KiCad/kicad-footprints/(list of files, cad)

Other CAD files:
Sources/Inductor_SMD/L_Wuerth_WE-TPC-3816.FCStd
Sources/Package_LGA/Infineon_PG-LLGA-5-1.FCStd
Sources/Package_SON/X2SON-4_1x1mm_P0.65mm.fcstd
Sources/Package_TO_SOT_THT/sod-70.fcstd
Sources/Inductor_SMD/L_Coilcraft_LPS5030.FCStd
Sources/Package_TO_SOT_THT/sod-70_P5.08mm.fcstd
