KiCad/kicad-footprints/(threads)

Thread 14 (2017-11-08):

Who is working on what?

poeschlr, 2017-11-08:
I think we should definitely coordinate our effort to avoid doing work twice.

The next thing i will do is look over the JST scripts to move these connectors over here. (Yes i know i did not create most of them but i want to do one complete repo at a time.)
Before that i will transfer the unchanged contents of the Resistors_THT, Capacitors_THT and Diodes_THT repos.

@SchrodingersGat, @jkriege2, @Shackmeister, @evanshultz

SchrodingersGat, 2017-11-08:
I would like to transfer across the `Housings_xxx` repos. However, did we ever decide on a better name for these?

poeschlr, 2017-11-08:
If i remember correctly this came up on the forum. (But i think only as a side node [here](https://forum.kicad.info/t/non-devs-what-do-you-think-of-the-app-names/5147/40?u=rene_poschl))

So i think we never discussed the naming for these libs. (Time to sacrifice a chicken again.)

What about `IC-Package_xxx`

Shackmeister, 2017-11-08:
Ill be working on updating the 3D scripts (mainly naming)
@poeschlr could it make sense to add the height, pin band and pinthickness as parameters in your 2 lead script? this way the yaml could loaded directly in CQ (with some mods to the script) = easier to maintain

poeschlr, 2017-11-08:
Yes this idea came to my mind as well. (But too late.)
If nobody else does it i would do it once all footprints have been transferred. (I would then also rework my connector generators. I would not be mad if someone else does it before i find time for it.)

evanshultz, 2017-11-08:
The discussion on the terms "housing" versus "package" was, I believe, in the old IR-DirectFET repo. But that has been replaced and the porting changed the terms so that's fine.

poeschlr, 2017-11-09:
I decided i will create a generic jst footprint generator. (after the third script where i copied basically the same stuff from my master script.)
So this script will then also have yaml files that define the part dimensions. (I might make it easy for me and make separate scripts for tht and smd versions.)

terjeio, 2017-11-09:
I am currently working on the pin sockets scripts for the legacy footprints, are the ones here script generated with an updated or a new script? If so should I stop my work on and concentrate on the 3D models?

FYI: the legacy script outputs a lot of overlapping and duplicate lines, my updated script reduces the total size by around 25% and, I believe, is more KLC3 compliant.  Also, I have added single row SMD sockects to footprints and 3D models.

Shackmeister, 2017-11-09:
The pinsockets here has only been renamed, you should adapt the Naming to your script, otherwise please continue on with you awesome work :)

evanshultz, 2017-11-09:
So... is this thread simply where we announce what we want to do next? Is there more organization to it? Do we have a list of repos that need moved so we can track progress to completion?

SchrodingersGat, 2017-11-09:
https://github.com/KiCad/kicad-footprints/blob/master/TODO.md

poeschlr, 2017-11-10:
I rewrote the generation script for jst smd connectors. (One script generating all of these connectors.)
This script is also capable of generating other similar components. (Example molex picoblade)
So i think all connector footprints with one row of smd pads plus two mounting pads will be produced by this one script. (As long as the body shape is not too complex.)

Some of the connectors had "inner" details on fab (JST GH). My script is not yet capable of including this. Do you guys think it would be worth my time to add that feature are these inner details not a good idea in general?

SchrodingersGat, 2017-11-10:
Depends on the level of detail you're interested in. I wouldn't go overboard but it may be useful for example to show pin orientation. As long as it shows outline and orientation, those are definitely required.

poeschlr, 2017-11-10:
So show a small square representing each pin for top entry types? (Most side entry types have the pins hidden when viewed from the top.)

SchrodingersGat, 2017-11-10:
That sounds reasonable, would you agree?

jkriege2, 2017-11-10:
Just as a note: I will rework the terminal blocks withing the next few weeks
JAN

evanshultz, 2017-11-10:
I'll take crystals, oscillators, and potentiometers. I want to address https://github.com/KiCad/Crystals.pretty/issues/23 and https://github.com/KiCad/Potentiometers.pretty/issues/18 and https://github.com/KiCad/Potentiometers.pretty/pull/23 and https://github.com/KiCad/Potentiometers.pretty/issues/20.

@SchrodingersGat I recall a PR by you for potentiometers where I had a number of comments and didn't merge. I think they were horizontal Alpha parts, but I can't find an open or closed PR. Do you recall or can you find it?

@jkriege2 Are you going to make shrouded pin headers, both with and without latches? The kinds seen in all 3 pics at http://www.oupiin.com/product_iii.html?c1=10&c2=54? These are extremely common interconnects, and seemingly generic, but I don't see them in our library.

terjeio, 2017-11-10:
@evanshultz 3D-models for some shrouded pin headers are [here](https://github.com/KiCad/kicad-packages3D/tree/master/Connectors_IDC.3dshapes), footprints were [here](https://github.com/KiCad/kicad-packages3D/tree/master/Connectors_IDC.3dshapes) but are deleted?

Since I am working on an update for the pin socket headers footprints and 3D models, which are similar, I can easily add them.

jkriege2, 2017-11-10:
@evanshultz @terjeio Go ahead ... I didn't intend to do the shrouded headers ... although I could if required (but will takes some time!). I'm now starting to redo all those old screw terminals!

Best,
JAN

poeschlr, 2017-11-19:
Above i mentioned that i would look into diodes, resistor and capacitor tht. I fear the connector stuff takes a lot longer than i expected. So if somebody else is motivated in transferring these 3 libs i will not be mad at them.

poeschlr, 2017-11-27:
My next lib will be the old connectors_hirose

antoniovazquezblanco, 2017-11-27:
Hello guys, `Converters_DCDC_ACDC.pretty` has not yet been moved. I wonder if you have talked about splitting it or leaving it as is. Also there is a PR that improves considerably the state of the lib (https://github.com/KiCad/Converters_DCDC_ACDC.pretty/pull/27).

As I need a footprint from that repo I was thinking in contributing to the switch by opening a PR.

SchrodingersGat, 2017-11-27:
@antoniovazquezblanco I have now merged that PR. If you want to contribute by pulling those across to this repo, that would be greatly appreciated! :) Thanks!

antoniovazquezblanco, 2017-11-28:
Perfect! About naming:
1. Should I split them in ACDC and DCDC or keep them in the same repo?
2. Connector->Conn, then should I rename Converter to Conv?

poeschlr, 2017-11-28:
If there are converters that can work with both AC and DC on the input side then we should keep all converters in one lib. Otherwise it is ok to split them in my mind.
I don't think shortening the name is a good idea here. (I am not even sure any more why we shortened the name for the Conn libs.)

SchrodingersGat, 2017-11-28:
@poeschlr it is the only shortening we do, I'm not sure either. Should we fix all to `Connector_` now, before v5 gets locked in?

antoniovazquezblanco, 2017-11-28:
Converters it is then. Also I will not split the repo yet as it is not that big and also I don't really know if some of the components accepts both AC and DC as input.

SchrodingersGat, 2017-11-28:
\* `Converter_`, singular :)

poeschlr, 2017-11-29:
Next i will transfere the old Samtec and TE-Connectivity repos.

poeschlr, 2017-12-01:
Does anybody know what the stuff in Connectors_Mini-Universal is?

poeschlr, 2017-12-05:
@evanshultz i remember you wrote something about wanting to rework the crystal libs. Does this also include the oscillator lib or is that lib free to be transferred by someone else?

evanshultz, 2017-12-05:
Go ahead. I wanted to fix the issue at https://github.com/KiCad/kicad-footprints/issues/14#issuecomment-343525789, but crystals are already moved. Any change to the fab layers is pretty easy to update later anyway. (The pots had changes to their names which makes it a pain to import and the update later.)

poeschlr, 2017-12-05:
I created an issue to remind us about that particular remaining problem.
https://github.com/KiCad/kicad-footprints/issues/155

poeschlr, 2017-12-06:
I will take care of the Mini-Universal footprints. (They are TE-Connectivity MATE-N-LOK)

SchrodingersGat, 2017-12-06:
Great work! We're almost done :)

Shackmeister, 2017-12-06:
Has most footprint(families) been renamed to match 3.0?

SchrodingersGat, 2017-12-06:
Yes, most. There may still be some that don't match convention requirements but the majority have been renamed.

poeschlr, 2017-12-07:
Next thing i will look at are the remaining footprints in Connectors.pretty
I already transferred the Tag-Connect stuff and am now looking at HE10 (seems to be a locked IDC header, so i will add it to Connector_IDC)

poeschlr, 2017-12-08:
I fear a lot of the footprints in connectors lib are not worth transferring over to the new repo. The only two that might be worth to transfer are the Samtec QMS and TE Future bus. But both would need major rework and checking against the datasheet.
Other then this only the Connector_IEC_DIN and Potentiometer libs remain to be transferred.

evanshultz, 2017-12-08:
Regarding potentiometers, I haven't finished the argparse interface (which seems of dubious value to me anyway...) but all the pot footprints are being generated so I will upload them.

But first, a few questions:
1. Do we want to divide them up in any way? Perhaps into THT (there are ~100) and SMD (~20).
1. I vote for removing the bottom-side ones and providing hole and non-hole versions (the user can flip to the bottom side if they wish). See https://github.com/KiCad/Potentiometers.pretty/issues/18. Objections?

SchrodingersGat, 2017-12-08:
1. Yes, this makes sense to split them at this stage
1. We should not provide duplicates of footprints which are simply "flipped" to the back layer, if that is what you are asking

evanshultz, 2017-12-09:
1. Great.
2. Yes, that is what I was thinking too.

I'll have to make a few script changes to make the second item happen. Probably Mon I can upload.

evanshultz, 2018-01-29:
@poeschlr
Is there anything to coordinate amongst multiple people? Can this be closed now?

poeschlr, 2018-01-29:
I think the din connectors are still not transferred.

Ratfink, 2018-04-01:
I believe the DIN connectors have now been transferred: https://github.com/KiCad/kicad-footprints/pull/409.

Is there anything left to discuss here, or should this issue be closed?

evanshultz, 2018-04-02:
Close it as far as I'm concerned. I took a close look at the TODO docs in both the symbol and footprint repos. Everything we need should be there now.

Closed 2018-04-02.

Thread 46 (2017-11-16):

Testing and travis ideas

antoniovazquezblanco, 2017-11-16:
I had a look to the kicad library utils repo the last weekend. I have some ideas that I am willing to contribute to but I don't know what you think about them.

1. Testing now requires cloning more than one repo (travis clones both this repo and the utils one). I think this could be avoided by moving the testing code to this repo. The reused code between the different testing benches for PCB, SCH and SCHLIB is minimal, thus being a good option. This would reduce check time. Keeping the test code in the same repo would also make easier point number 2.

2. Using relative paths in scripts would ensure that scripts can be run both localy and in travis environment. Currently some scripts can only be used by travis. My proposal is to include a batch and a shell script that the user can click or execute in a terminal that will test the last modified components (I was thinking on testing the whole lib if in the master branch and the modified components if in another branch or something like that).

3. Testing now requires sudo and there seems to be no obvious reason for that. Sudo makes travis testing significantly slower. Dropping sudo needs would improve check times a lot.

4. I was thinking in including a coverage report. A simple script that would tell in which percentage the whole lib complies with KLC and/or another script that would test how many 3D models are present and how many missing footprints looking at the symbol lib.

Please let me know what you think about the previous ideas and if you would like to see them implemented.

Thank you!

SchrodingersGat, 2017-11-16:
1. I don't want to separate out the scripts that are in kicad-library-utils
   a. There is common code that would have to be duplicated
   a. It's a good central place to store the scripts
   a. I think it would clutter the repo which should be reserved for only library files (as far as possible)

2. If you can come up with a scheme that allows this, that's fine, but I don't want to break our current Travis functionality.

3. I didn't know that. That can be dropped from the .travis.yml file I think

4. This is a good idea, I have toyed with this idea before. It would be great to add this output to the https://kicad.github.io website, too! Green indicator for 100% pass, for e.g.

Shackmeister, 2017-11-16:
+1000 for 4.

antoniovazquezblanco, 2017-11-20:
Discarding 1 and 2. Opening issues where it belongs for 3 and 4.

Closed 2017-11-20.

Thread 72 (2017-11-21):

Polarized THT capacitors do not have a pin 1 mark that is visible after assembly

poeschlr, 2017-11-21:
See discussion in https://github.com/KiCad/kicad-footprints/pull/71
This should be fixed within the generator scripts

Scripts are found in: https://github.com/pointhi/kicad-footprint-generator

Shackmeister, 2018-01-08:
fixed in #230

Closed 2018-01-08.

Thread 73 (2017-11-21):

THT capacitors require rework

SchrodingersGat, 2017-11-21:
See notes here - https://github.com/KiCad/kicad-footprints/pull/71

The scripts need to be reworked to place the polarity indicator on the Silkscreen layer outside the footprint, so that it is visible after component is placed.

SchrodingersGat, 2017-11-21:
Closing this, @poeschlr made the same issue :)

Closed 2017-11-21.

Thread 74 (2017-11-21):

Some of the second references (on fab layer) for resistor THT footprints interfere with other graphical elements on fab

poeschlr, 2017-11-21:
Some oft he references need to either be scaled down or moved a bit.
Preferably done with the original generator scripts.
But can also be done by hand. (Only a few components are affected.)

Script can be found here: https://github.com/pointhi/kicad-footprint-generator

grob6000, 2017-12-04:
Looking at this now. Unfortunately http://kicad-pcb.org/libraries/klc/F5.2/ hasn't really considered the axial vertical THT resistor... Plan will be to change the line representing the bent pin to only reach the circumference of the body, and move the R% into the centre of the body. See what it looks like.

grob6000, 2017-12-04:
Having a bit of trouble - keeping this on pause for the moment.
Does anyone (maybe @pointhi, @poeschlr ?) know what the best practice is for the "Fields" in the footprint properties; i.e. "Doc" and "Keywords"? Seeing some differences between what's currently in the footprints and the output of the script and looks like I'm mucking it all up. :)

Closed 2017-12-04.

Thread 76 (2017-11-21):

Inductor THT: Missing 3d model references, second reference (fab) interferes with fab and some silk lines on top of pads.

poeschlr, 2017-11-21:
This is ideally fixed within the generator scripts directly. (Fixing the inductor references would also fix some of the resistor references because they share the same generator scripts.)
So https://github.com/KiCad/kicad-footprints/issues/74 is related in part to this issue.

Script location: https://github.com/pointhi/kicad-footprint-generator

poeschlr, 2017-12-04:
@Shackmeister did you close the wrong issue? The linked pull request does not touch inductor footprints but resistors.

Shackmeister, 2017-12-04:
Yes I closed the wrong issue, sorry

poeschlr, 2018-08-29:
Fix merged

Closed 2018-08-29.

Thread 78 (2017-11-21):

Diodes THT: Polarity marker on silk not ideal for most footprints and second (fab) reference interferes with other fab graphics

poeschlr, 2017-11-21:
This should be fixed with the generator scripts.

poeschlr, 2017-11-21:
Script location:
https://github.com/pointhi/kicad-footprint-generator

jkriege2, 2017-11-21:
Currently the silkscreen looks like this:
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

How do you want to change them?

Best,
JAN

poeschlr, 2017-11-21:
Examples where it does not look that nice:

Your last screenshot is a perfect example. If the view is obstructed by other devices next to the diode then it becomes very hard to see the intended direction of the diode. (The assumption is that the polarity mark is used to easily check the correct insertion of the diode when everything is assembled.)
Just imagine a high connector very near to one side and a large capacitor on the other. (Over voltage protection circuit for a DC input)

Other examples (of slightly different problems)
D_5W_P5.08mm_Vertical_KathodeUp (Interference between diode symbol and part outline)
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
Even worse if D_DO-201_P5.08mm_Vertical_AnodeUp is placed low down it might be very hard to see the polarity. (or if high components are next to the diode and it is impossible to look from the side.)
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

As for the how:
Depends on the exact footprint in question. In your last screenshot maybe elongate The top line to extend beyond the pad? Or you could add a dot, ...
Anything that is visible from directly above.
For others moving the diode symbol might be a good idea. (Where it interferes with other silkline features or is obstructed by the component it self.)

---

On an unrelated note: Do the pads really need that much annular ring? Especially for footprints with small pitch: (might it be a good idea to set a minimum pad to pad clearance within the scripts similar to what i currently do with the connector footprint rework? Would mean if the pitch gets small the pads are not circles but oval.)
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

jkriege2, 2017-11-22:
Hi @poeschlr ,
yes I agree that the silkscreen is not that good (I made it that way, when writing the scripts about a year back, as I didn't find any better way ... I think we should assemble some attempts and then select the best one. One idea would be to douplicate the K (for cathode), that we have on F.Fab to make the orientation of vertical diodes clear, on the silkscreen... I think the dot would more easily get lost... Maybe also the offset diode symbol as shown in DO-15_P2.54mm ... any other ideas?

About the angualr rings: YES ... can do ... that's the problem of scripting ... such things just slip through ;-)

Best,
JAN

jkriege2, 2017-11-22:
PS: We should also rethink the  aming scheme (if required) and/or maybe add the specific attributes (`_AnopeUp', ...) to the KLC-listing in http://kicad-pcb.org/libraries/klc/F2.1/

Best,
JAN

jkriege2, 2017-11-22:
PPS: I'm happy to do the scripting, when we decide on a variant ;-)

jkriege2, 2017-11-24:
PR with a fix: https://github.com/KiCad/kicad-footprints/pull/106

poeschlr, 2017-11-26:
I consider this fixed by the merged pull request.

Closed 2017-11-26.

Thread 91 (2017-11-23):

Incorrect scaling for THT diode models

SchrodingersGat, 2017-11-23:
Many of the THT diodes have a non-unity scaling for 3D models.

x:y:z must be 1:1:1

SchrodingersGat, 2017-11-23:
This is actually quite wide spread:

* Footprints with incorrect scale - 701
* Footprints with incorrect offset - 339
* Footprints with incorrect rotate - 341

I can change these simply but it will break a lot of 3D models!

jkriege2, 2017-11-23:
Do so ... but we were discussing whether these should be reworked as a hole to improve on the polarity marking on SilkS (see https://github.com/KiCad/kicad-footprints/issues/78 ... maybe you can give your five cents there, so we can move forward) ... When we do that I will also change the scaling (and reexport my 3D models accordingly)

JAN

poeschlr, 2017-11-23:
Wrongly scaled 3d models will not be included in the v5 repo. (Yes i know this will mean we do not have 3d models for some parts when v5 comes out.)

Changing the scaling here would only affect the v5 footprints so i think we can fix the scaling here.

jkriege2, 2017-11-23:
Yes, but it would be good to know WHICH fooprints are affected, otherwise we will never know which models to fix!

So I would vote for doing this in batches: I.e. someone takes a repo, fixes tha scaling and at the same time fixes the 3D models, or removes them!

SchrodingersGat, 2017-11-23:
@jkriege2 yes I think this is a good idea. I'll close my "fix" for this :)

poeschlr, 2017-11-23:
@jkriege2 the models that need fixing are simply the models present in the old kicad-library repo that do not have a counterpart in kicad-packages3d. (Sadly for a lot of them there is no easy fix because they have been designed with wings3d.)

SchrodingersGat, 2017-11-23:
@poeschlr in that case, I will re-open my PR to fix this. It is better to fix the files now and add the models as we go, I think. If there are no existing incorrect models, I think that is fine.

Closed 2017-11-24.

Thread 94 (2017-11-23):

Auto-update of fp-lib-table by KiCad?

evanshultz, 2017-11-23:
@SchrodingersGat
Will KiCad v5 auto-update fp-lib-table? If so, then footprint repo changes can be pushed out to users. Otherwise, they'll be unable to add or remove libraries.

The schematic has the same issue.

Discussed somewhere here and at https://bugs.launchpad.net/kicad/+bug/1705291. Here is the root of the question: If we have two files that capture all current libraries, whether they're manually- or automatically-generated, why shouldn't the GitHub plug-in also update those files so the users always has the latest and greatest. For users who don't want to use the GH libraries, that's fine, but those that do can be kept updated between KiCad releases.

I realize this isn't a core library issue. But if there are reasons this can't be done by the library team, or isn't ready to be done, then of course there's no reason to have KiCad do it. But if all the infrastructure in the library is ready, and it's a good idea, then it needs to be raised to the KiCad dev team.

poeschlr, 2017-11-23:
The github plugin will most likely not work in v5. (can't handle one repo for all footprint libs)

The intended way to get new stuff to users is via the new library download webside or they need to clone the 3 repos.

But here also some manual updating might be needed by the user to get the fp-lib-table updated.

SchrodingersGat, 2017-11-23:
@poeschlr I have reminded them many times and will continue to do so as we approach v5 release! We need to quickly finish the footprints (and symbols) transition :)

stambaughw, 2017-11-24:
I would be opposed to this idea.  We should not be overwriting users
library tables.  I for one would not be very happy is the next time I
ran kicad, my library tables were changed.  I'm fine with providing a
tool to check if there are updates available for the default library tables.

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

evanshultz, 2017-11-24:
Clarification needed: I'm only thinking about users that use the GH libraries. It was written into a paragraph above but could have been missed. A user may self-manage their libraries and that's fine. But if a user chooses to use the GH libraries it only makes sense to me that their lib tables and the libraries themselves are updated without excessive (or any?) effort.

So maybe this won't work with the current library structure for v5. I would think that requiring users to manually get and update the libraries is undesirable for every single user. A tool that could check for new libraries and then update both tables and library files would satisfy my request.

@stambaughw
I meant "automatic" in the sense that the user didn't have to manually do everything. I didn't mean "automatic" in the sense that the user had absolutely no control.

myfreescalewebpage, 2019-03-15:
@evanshultz this is an old issue, is it still valid ? Thanks, Joel

evanshultz, 2019-03-15:
Heck yeah, but I guess it's KiCad dev thing and I didn't seem to be able to communicate well with Wayne on launchpad.

If there is a way to use the official library on-demand, like it was on v4, then it would have been nice to make the library tables also update from GH. But that didn't happen. As it is now, KiCad could be more convenient about a situation where the table and files at the path don't match, but that's also something to report to the devs.

Closing now.

Closed 2019-03-15.

Thread 113 (2017-11-26):

LEDs and color

jkriege2, 2017-11-26:
Hi @evanshultz @poeschlr @SchrodingersGat ...

When I recently moved the LED footprints and 3D mdoels to the new repos, I stumbled upon a small problem: All the THT LED 3D models just have any color (most 2-pins red or green, 3/4/...-pin-version are white). That's mostly fine, but there are 3 problems with that:

1. If you want your 3D model to have the correct color, you have to make new 3D models and matching footpritns ... should we provide a list of such? And if so, how do we denote color in the names (e.g. as modifier `_Red`, `_Green`, ...)?
2. We should have clear/white and maybe grey/black variants at least of the 3mm and 5mm, as they are often used for Phototransistors/-diodes and IR-LEDs ... what do you think? Whould I add them and how should I denote the color in the name (see item 1).

Best,
JAN

SchrodingersGat, 2017-11-26:
You should use the color name as a modifier as you suggest. But which colours?

* Red
* Green
* Blue
* Yellow
* White / Clear
* Black / IR
* ... ?

Also, which is the "default" color (without any modifier suffix)? I would suggest perhaps clear?

poeschlr, 2017-11-26:
For reference, @Shackmeister had an issue in the old repo about LED colors for 3d models:
https://github.com/KiCad/LEDs.pretty/issues/44

SchrodingersGat, 2017-11-26:
Yep I remember @Shackmeister  raising the issue. I'm ok with different colors but not with modelling individual anode and cathodes inside the diode ;)

Shackmeister, 2017-12-04:
@SchrodingersGat SMD led script has now been cleaned for internal parts :P

Thread 117 (2017-11-27):

Nets on wing pads of connectors

Shackmeister, 2017-11-27:
Not sure if this belong here or on the forum, let me know if its inappropriate here.

How are people handling connecting the wing pads on connectors to different nets (typically GND)?
usually I just edit the pads and add the net I want, but this is lost when updating the netlist, which usually makes me forget to change some of the 20ish pads. Unless somebody has a good way, we should maybe consider making a standard padnumber for these. This way the user could use a symbol with or without the wings depending on the nescessity.
Thoughts?

poeschlr, 2017-11-27:
I am currently not understanding what you mean with wing pads. Do you mean the mounting pads like the two larger pads of the picoblade connectors?
These do not need to be connected to a net because they are just for mounting purposes.

Connectors that have shielding connected to such pins need a pad number of course.

Shackmeister, 2017-11-27:
Yes the larger pads, I typically connect them to GND to have a stronger mount. Sometimes I connect them to other nets to void splitting planes, easier routing etc.

poeschlr, 2017-11-27:
Adding these pin(s) would at least double the amount of generic symbols needed. (And it will add a further complication to users. They now need to answer the question: does my connector come with mounting pads? Even if they don't plan on connecting them.)

poeschlr, 2017-11-28:
@SchrodingersGat @jkriege2 @evanshultz care to comment?

evanshultz, 2017-11-28:
**Oops! I forgot to submit this comment earlier! Sorry.**

In the existing (old) KiCad libs I recall seeing they were universally pin 0 (zero).

There are several situations where a net connection to the mounting tabs is important:
- Mounting strength (mentioned above)
- Shielding (mentioned above, though this may require a specific symbol anyway)
- Chassis ground connection to circuits
- HV / ESD protection
- Connection to touchable surfaces for safety during plug/unplug events

Adding symbols with a pin 0 for mounting pads is good, but I agree that the overhead in the quantity of symbols and footprints that would be added is substantial.

Another option might be to have only one set of symbols, all with pin 0, and the pad pin can be left floating if desired. A corresponding footprint would need a numbered pad 0 which would be floating or connected depending on the symbol's connection. So we eliminate any duplication of symbols or footprints and it's up to the user to make the connection or not.

jkriege2, 2017-11-28:
At least for D-Sub connectors there are symbols with a specific PAD-pin (optional, i.e. variant). the same is done for crystals!

jkriege2, 2017-11-28:
I think at least for those symbols where the mounting/shield-pad is very common, there should be a symbol with it (e.g. RJ-xx, USB, D-SUB, ...)

poeschlr, 2017-11-28:
@evanshultz wrote:
> In the existing (old) KiCad libs I recall seeing they were universally pin 0 (zero).

neither the old Molex, JST, Hirose or TE lib have it like you describe here. (All of them have footprints with either smd or pth mounting pads. None of them have the number 0. Only Molex FFC had a number assigned but it used max pin number +1)

>Another option might be to have only one set of symbols, all with pin 0, and the pad pin can be left floating if desired. A corresponding footprint would need a numbered pad 0 which would be floating or connected depending on the symbol's connection. So we eliminate any duplication of symbols or footprints and it's up to the user to make the connection or not.

Not quite. There are a lot of connectors that do not have mounting pins. If the symbols all have the mounting pin in there, the wrong footprints will be suggested by the "by pin count" filter.

@jkriege2 the examples you list are not "only" mounting pins. These are pins intended to be connected because these are shielded connectors that use the mounting pins for connecting the shield to ground.
They of course should have a pin number.

With mounting pins i mean explicitly the two pins at the outside of for example picoblade smd version. These are small metal parts on the side of the connector encased in plastic.

poeschlr, 2017-11-30:
I now have a connector with shielding. This should get a pin number. We currently don't have a symbol for it. I would generate one. But what pin number to give?

I might even vote for "SH" to make it really clear what this pin is. (Similar to the use of "EP")

poeschlr, 2017-12-05:
I added the symbols in https://github.com/KiCad/kicad-symbols/pull/26. There is used SH as the pin number.

Shackmeister, 2018-01-30:
if we now have symbols with SH could we possibly use this for all the mounting pins?
I would really love this to get implemented

poeschlr, 2018-01-30:
Mounting pins are not shields!

poeschlr, 2018-01-30:
The only option i see here is to add another set of generic connector footprints that have a mounting pin. And hope that there is never a connector that has mounting pins and shield that is not connected.

If we go this route at least the single row connectors must specify the pin count in their footprint filters. (Maybe they also should do it now, as the shielded connectors might be suggested for non shielded symbols with pin count +1)

Shackmeister, 2018-01-30:
Hmm thats true, so a seperate symbol with MNT perhaps?
and agree the pincount must be specified in the FP filter

poeschlr, 2018-01-30:
We would also need a suffix in the footprint names for either only the mounting pin or for both mounting pin and shield pin. (or we would need a similar syntax for the pin number as we have for exposed pads.)

poeschlr, 2018-01-30:
I started a poll over at the forum to get the opinion of a wider audience: https://forum.kicad.info/t/official-library-poll-should-mounting-pins-for-connectors-have-a-connection-on-the-schematic/9483

poeschlr, 2018-01-31:
@jkriege2 and @evanshultz i would like your input here before i make my final decision.

---

The forum shows there are some who would like the possibility but also some who think the price to pay is too height. (I count my self to the later.)

I might allow it if all the following conditions are met:

- Only one pin in the symbol (all mounting pins get the same pin number)
- The pin number for the mounting pad is not a number. (Example: MP or MTP)
- The symbols are in a separate lib (Connector_Generic_MountingPin)
- **All footprints** are updated. (If a script exist this has to be done in the script)
- Both symbol and footprint changes are done in a timely manner before the version 5 release.
- The mounting pin footprints get a suffix _MountingPin (Or should we add -1MP after the pin count in the footprint name. This might be more flexible if we ever want to allow multiple mounting pins with differing pin numbers)

I will make my decision within the next few days.

jkriege2, 2018-01-31:
Hmmm ... I don't really see the difference between shield and mounting pins (for any practical purpose) ... I would see it that way:
1. If there are mounting-holes/pads that are connected to some kind of metal-coated housing: I would assign them a specific pin-number that allows to use it as a connection for the shield (all D-SUB use pin-number 0!!! USB are a mix of No. 5, 6, S1, HDMI uses 20 ... so it's a real mess) ... for sure we need to define that in KLC ("shield" does not appear there)
2. If they are for mounting only and no shielding can be expected from them (What would that be? A plastic connector with glued-in/molten-in pins???), I don't see the point of connecting anything to them. They are only there for mechanical stability
3. Are there any packages that have both? If so the pins for shields should follow rule 1 and the rest rule 2

Can you give examples?

Anyways: If we come to any conclusion we need to make sure to add it to the KLC and unify the lib to match to that rule!

poeschlr, 2018-01-31:
For now we are talking explicitly about these kind of pins (your option 2)
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

They only have one purpose: Making a mechanical connection between the connector housing and the pcb. There is no shielding effect from them. There is no electrical contact to anything other than the pin it self.

---

I don't talk about shield pins that have a dual purpose. Yes such pins also make a mechanical connection to the pcb. But from a pure electronic point of view their purpose is to connect the shield. (We already have generic connectors for such shield pins. There is the Connector_Generic_Shielded lib)

---

I am sure there are also connectors that might fall into category 3. If we also want to include symbols that offer different connections for their shield and mounting pins, the number of symbols will really start to explode. For now i would definitely not include them. (We don't even have footprints that would fall into that category right now.)

jkriege2, 2018-02-01:
Hmmm ... I still don't see the real reason for connecting them to GND (or some other signal)? Is the idea that if I solder them onto a ground PLANE (i.e. larger peace of copper), the holding-forces are stronger, because any pull is distributed over a larger interface between PCB and copper???

antoniovazquezblanco, 2018-02-01:
Soldering them to a plane gives much more mechanical resistence. Also, when tightly fitting this kind of connectors in the border of a board, those pads can help stich ground planes eliminating the need to create vias.

Shackmeister, 2018-02-01:
stuff like this can typically be reduced quite alot by connecting the mounting pads to a solid plane.
and as mentioned before it can also be useful to avoid splitting planes
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

poeschlr, 2018-02-01:
I doubt a plane will help here. Copper is too weak to add much support. I think the only thing that will help you are vias inside the mounting pad. Not sure if one can add vias without a net though.

Shackmeister, 2018-02-01:
compared to the strength of the bonding for the pad the plane is definitely stronger.
I just tested a few boards, havent been able to break the pad. Solder or connector breaks before the pad.
but yes via's are also a good thing to add for strength

evanshultz, 2018-02-01:
As I mentioned above, there are various reasons for connectors to have these pins. In my opinion, the option to have a zone flow solidly under the connector's mounting pins is reason enough. These are cases where board design rules would require an unbroken zone, especially around a board edge.

I suggest only 2-character names (SH, MT, etc.). That works with 100mil pin length and 50mil text size.

-1MP or something similar is a good name for the footprints for me. It also allows a nice FPfilter.

Causing ERC errors or design rule violations because of the symbol/footprint design seems poor. I'm not sure of the best pin type, but I do not think we should inherently cause user issues due to the symbol or footprint library's design.

I understand the entire discussion is only about generic connector symbols for these types of footprints. Symbols which are for a specific connector should have the appropriate pins, of course, and should match the pin naming convention for consistency. So if any symbol pin is a shield, it will be `SH`. If any pin is only for mounting, it is `MT`. If it is only for ground, then the pin name is `G`. And so on. (I made up those pin names but something like that should be codified in KLC once this is settled.)

poeschlr, 2018-02-01:
@Shackmeister as promised now my decision.

You can go ahead under the requirements i already listed above.
Regarding pin type i fear our only option is to use passive. (Only alternative NC will result in ERC warnings for people who wish to connect them. That ERC warning can not be turned of for that specific pin alone. Whereas users who do not wish to connect a passive pin have the NC flag to tell ERC that this is on purpose.)

Regarding footprint name: I would go with -1MP.
Pin name should be MP.
I don't think there will be a connector with a ground only pin that is not a shield. So i guess there will always only be either MP or SH pins. We will not prepare the lib for connectors that have both MP and SH pins.

As stated in another issue, i would also vote to add -1SH to footprint names for shielded footprints. (But this is a separate issue.)
This change will only make it into v5 if you get it done for all footprints until the tag for RC1 should be created. (I would prefer if we had a bit of time left. Such that we can fix remaining issues beforehand.)

Shackmeister, 2018-03-10:
@poeschlr should all the affected connectors get -1MP added to their name?

- Molex_PicoBlade_53398-0971_1x09_P1.25mm_Vertical-1MP

- Molex_PicoBlade_53398-0971_1x09-1MP_P1.25mm_Vertical

Shackmeister, 2018-04-04:
As these has been merged Im now closing this issue, thanks for all the work

Closed 2018-04-04.

Thread 130 (2017-11-28):

What about manufacturer specific pin headers and socket strips? (Samtec)

poeschlr, 2017-11-28:
Currently the samtec lib holds some pin header footprints. Should we transfer these specialized footprints over here? (They have slightly different drill sizes: 0.95mm compared to 1mm for the generic footprints)
Samtec creates quite a lot of slightly differing pin headers and socket strips. I am not sure it would be a good idea to include specialized footprints for all of them. (But i am also hesitant to simply "delete" contributions.)

evanshultz, 2017-11-28:
IMO, these are generic enough that we can use a "one size fits all" and eliminate vendor-specific footprints where possible. This should result in the least maintenance issues for librarians while still supporting all components a KiCad user would want to use. I share the guilt from removing someone's hard work from the library, but to me it seems the best way to proceed.

terjeio, 2017-11-30:
I have just remade the script for the pin sockets and when I did the research for them I found that dimensions can vary quite a bit between the vendors. My plan is to dig into this issue in more detail to see which variants is not covered by the existing ones and possibly add them. Bottom entry, guide pegs, different land patterns...

3D models is another issue, varying heigths, turned pins...

How much work should be put into this? I guess it depends on the level of accuracy and coverage the librarians are aiming for.
Also, if I am going to do this I will need some input on when a new footprint should be made. Eg. I have a SMD pin socket on my desk that requires a wider land pattern than the current KiCad version provides.

Thread 133 (2017-11-29):

SIP3_11.6x8.5mm is not compatible to RECOM R-78

mistoll, 2017-11-29:
AFAIK the footprint kicad-footprints/Package_SIP.pretty/SIP3_11.6x8.5mm.kicad_mod is the replacement of Converters_DCDC ... RECOM R-78 footprints.
Both, the original footprints in the Converters_DCDC package and the SIP3_11.6x8.5mm are not compatible with the RECOM R-78 parts.

What's wrong:
The courtyard and silk have the large part upwards, while is should be downwards. The datasheet [R-78Bxx-1.5](https://www.recom-power.com/pdf/Innoline/R-78Bxx-1.5_L.pdf) has a recommended footpring graphik on the last page, with pin 1 marked.

poeschlr, 2017-11-29:
Is this really the replacement for only these converters? @evanshultz i think you looked at the sip lib a while ago.

If so the footprint should be moved anyways. (All other converter footprints will be in the Converter lib added by https://github.com/KiCad/kicad-footprints/pull/127)

evanshultz, 2017-12-05:
Thanks for looping me in. I'll take a look tomorrow.

evanshultz, 2017-12-05:
Neither https://github.com/KiCad/Converters_DCDC_ACDC.pretty nor https://github.com/KiCad/kicad-footprints/tree/master/Converter_DCDC.pretty have a R-78Bxx-1.5 footprint. It would appear to have never existed. The new repo does have 6 RecomR-78 footprints, so I think the proper footprint should be created, if desired.

The SIP-3 is totally unrelated to any Recom parts as far as I can see.

@mistoll Why would you think there was a footprint replacement? It would be welcome if you could make the missing footprint.

@poeschlr I think this case can be closed unless some interesting information develops.

jkriege2, 2017-12-05:
Hi!

the original DCDCs from ReCOM are script-generated: https://github.com/pointhi/kicad-footprint-generator/pull/70

ideally, please modify the script to get a consistent style!

Best,
JAN

mistoll, 2017-12-06:
@evanshultz You are right, there's no R-78Bxx-1.5 footprint.

I referenced that datasheet, because the footprint layout graphik is unambigous there. While in other R-78 datasheets the footprint layout doesn't mark pin 1, thus allowing failures.

If the package SIP3_11.6x8.5mm is unrelated the line
https://github.com/KiCad/kicad-footprints/blob/cf6453685279d9cad03ca35fd590b9d91e7af775/Package_SIP.pretty/SIP3_11.6x8.5mm.kicad_mod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 should be removed/changed.

Sorry, I currently have not enough time to fix those footprints, especially because I have no experience in sciprt generating footprints.

Werni2A, 2020-07-29:
@evanshultz I think there is some kind of misunderstanding. `Package_SIP:SIP3_11.6x8.5mm` is meant for [R-78E-0.5](https://www.recom-power.com/pdf/Innoline/R-78Exx-0.5.pdf) and is therefore unrelated to [R-78B-1.5](https://www.recom-power.com/pdf/Innoline/R-78Bxx-1.5_L.pdf) which requires a different footprint.

However the script generated `Converter_DCDC:Converter_DCDC_RECOM_R-78E-0.5_THT` can replace `Package_SIP:SIP3_11.6x8.5mm` as they are the same footprint. I'm not sure how to check that no symbol in the lib uses this footprint and would break if I remove it. Is there some script to verify this? I tried to search for the footprint in the symbol library which returned no results.

If you want I can create a PR to remove `SIP3_11.6x8.5mm`

Thread 144 (2017-11-30):

Button_Switch_SMD.pretty naming convention not continuous

pointhi, 2017-11-30:
We have some mixture of rotary encoder without a prefix, switches without a ```SW_SPST``` prefix and switches with/without manufactur name

Ratfink, 2018-04-01:
Also: a lot of pushbutton switches are currently prefixed with `SW_SPST`.  Should they be renamed to use an `SW_Push` prefix?

Shackmeister, 2018-04-07:
SW_Push doesn't give the electrical configuration of the switch. A pushbutton could also be SPDT, SPDT etc

Ratfink, 2018-04-07:
Good point.  I think it would be best to put both in the name, which would allow for better footprint filters.  Really, our switch naming needs a lot of improvement and standardization, and it should extend to the symbols as well.

poeschlr, 2018-08-29:
We can think about a scheme that is used for new contributions. But existing symbols and footprints should not be changed in a manner that would break existing projects that use them. (Otherwise we are unable to supply users with bugfix updates of the library.)

poeschlr, 2019-01-16:
We have documented a naming convention for new contributions here: https://github.com/KiCad/kicad-symbols/issues/580

Thread 158 (2017-12-05):

What should we do with the wire pads footprint lib?

poeschlr, 2017-12-05:
The test point lib has been transferred in https://github.com/KiCad/kicad-footprints/pull/52
The question about the wire pads lib has been raised in that pull request already.

SchrodingersGat, 2017-12-05:
I think that wire pads are functionally separate from e.g. test points, so we should add a new library e.g. `WirePad`

poeschlr, 2017-12-05:
I found an old discussion where you suggested the name Connector_Wire. (Would make more sense.)
https://github.com/KiCad/Wire_Pads.pretty/issues/5

I think i will for now use that name for it.

---

In that issue the deprecated lib [Wire Connection Bridges](https://github.com/KiCad/Wire_Connections_Bridges.pretty) is mentioned.
From the discussion i would amuse you meant to give it the name Connector_Jumper? (But under jumper i would understand this: https://i.stack.imgur.com/UsiJ3.jpg not https://circuitmaker.com/forum/posts/216769)
I think in that case `Wire_Bridge` would be better. In addition i don't think we currently have any true wire bridge footprints in our lib.
I guess a better idea would be for users to use vias and unused copper layer(s) to document the connections. (This would allow for doing this without needing to add a symbol to the schematic.)

In any case i think that particular discussion can wait until somebody does indeed contribute such a footprint.

SchrodingersGat, 2017-12-05:
The way I see it, `Connector_` implies that some external "thing" will connect to the PCB. I think it also implies that this "thing" is removable, perhaps?

Jumpers do not fit this category IMO. By Jumpers I mean:

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

evanshultz, 2017-12-05:
To me, "wire pad" means a THT (very rarely a SMD) pad to which a wire is soldered. There is no other discrete component, just the wire.

In my vocabulary, here are the names of the items in the pictures above from top to bottom:
- Testpoint or testpad
- Jumper (this does not have a symbol or footprint since it fits on a header)
- Solder short
- Either a soldered jumper/bridge or a high-current, low-impedance sense resistor
- Either another soldered jumper/bridge or a high-current, low-impedance sense resistor

I agree that wire pads are a separate category and different from any of the pictures above. If I see a library named `WirePad` I would expect to see plated THTs named by either mm or AWG for fitting one or more wires.

myfreescalewebpage, 2019-03-15:
@poeschlr @SchrodingersGat @evanshultz WirePad I have seen Connector_Wire has been created following this issue, do you still need to keep it opened ? Else I suggest the topic should be closed. Joel

evanshultz, 2019-03-15:
I'm fine to close this then. However, I notice at least some (I didn't check all) seem to have converted dimensions because the names are "clean" mm sizes but the actual pad sizes have loads of significant digits.

myfreescalewebpage, 2019-03-15:
Great catch, maybe something we can fix with a PR, I know several footprint have this problem... Some improvements of the travis checks for F5.3 (http://kicad-pcb.org/libraries/klc/F5.3/) should be great to check that:

> All courtyard line elements are placed on a 0.01mm grid

Closed 2019-03-15.

Thread 171 (2017-12-08):

Should THT components include a courtyard area on the bottom?

poeschlr, 2017-12-08:
I think kicad now has a DRC check for courtyard violations.
But our THT footprints don't include courtyard on the bottom. So if one would place something too near on the bottom then this check would not notice it.

Shackmeister, 2017-12-08:
Can you provide some image examples?

evanshultz, 2017-12-08:
What is the problem you would want to catch? I've never ran into issues _only_ with placing parts under a THT component.

There can be issues with SMD parts on the bottom placed too close to THT pads, but the exact requirements depend on if the board uses double-reflow or wave for bottom SMT, if the wave has solder jets, if a selective solder pallet is used, etc. This depends greatly on the manufacturing equipment, process, and operator skills. And the actual constraint to be controlled is bottom THT copper pads to bottom SMD copper pads, anyway. Nothing about courtyard I've seen.

A THT on the bottom under a THT on the top could have lead interference. Is that it? If that's the issue you're thinking about, can KiCad discriminate between a THT part and a SMD part on the bottom (SMD wouldn't have leads poking out the top of the board).

poeschlr, 2018-02-02:
It seems the answer is no.

Closed 2018-02-02.

Thread 178 (2017-12-12):

Lower case "d" in Connector_Pin library

poeschlr, 2017-12-12:
KLC defines that diameters are prefixed with upper case "D".
Fixing this will also require fixing the 3d model names.

This has been discovered in https://github.com/KiCad/kicad-packages3D/pull/165

strombom, 2018-02-01:
Made a pull request for this issue:

Footprints: https://github.com/KiCad/kicad-footprints/pull/337
Packages3D: https://github.com/KiCad/kicad-packages3D/pull/252

I could not find any related files in 3D sources and no references in symbols.

Ratfink, 2018-04-01:
All the relevant PRs have been merged, so I believe this issue has been fixed.

Closed 2018-04-01.

Thread 188 (2017-12-21):

Issues with potentiometer footprints

evanshultz, 2017-12-21:
This will be a living list as the footprints are finished up and merged. Some of them will have the script as the root cause and re-writing or extending the script wasn't in scope for v5.

General:
- Pin number ordering (CW/CCW/etc.) cannot be specified. This prevents [Bourns PRS11S](http://www.bourns.com/docs/Product-Datasheets/PRS11S.pdf) from being built to the datasheet.
- Pinxoffset variable controls body placement as well. (Pins, body, and shaft should be independent.) This prevents  from being generated correctly.

SMD:
- SMD pad sizes are all the same. [ACP CA6 VSMD](http://www.acptechnologies.com/wp-content/uploads/2017/06/01-ACP-CA6.pdf has two different sizes, for example.

poeschlr, 2017-12-23:
About pin ordering: We have some footprints in the LGA lib that already add the suffix ClockwisePinNumbering to it. (No suffix = standard counter clockwise)

SchrodingersGat, 2018-01-06:
@evanshultz how are the potentiometers coming along? This is the major remaining item for this repo and we need to be able to tag a library release very soon...

evanshultz, 2018-01-12:
@SchrodingersGat
They were transferred some time ago. See https://github.com/KiCad/kicad-footprints/pull/190. It seems I forgot to update the TODO doc in that PR.

@poeschlr
Clockwise or counterclockwise doesn't apply to the pin order on footprints. I'll write up a new issue to capture the missing link because the schematic symbol and the pin numbers.

@jkriege2
On a personal note, I feel I owe you all an explanation and an apology. About 5 weeks ago I suddenly started feeling very ill and was diagnosed with a brain tumor. It greatly affected my ability to think and function and I'm sorry that I was unable to contribute during this critical time as KiCad approaches v5.

Fortunately, with faith and a great medical team the tumor is removed and I'm feeling better now. I'll be able to start contributing again while I continue to recover.

I apologize again for disappearing. While I have a good excuse, there are so many GH emails it's clear another hand would have been helpful. If you tag me with a request now I should be able to help!

SchrodingersGat, 2018-01-12:
Ok, I've ticked that off the TODO then. Thanks

evanshultz, 2018-02-06:
@poeschlr @jkriege2
When reviewing https://github.com/KiCad/kicad-footprints/pull/349, I noticed that the script doesn't generate a square pad for pin 1 of any pot footprints:
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

KLC requires this, and some (maybe all?) of the footprints are directional and can only be inserted one way so I don't think this is critical to fix immediately, but we use square pin 1 pads on other THT footprints that are directional too. Unless someone tells me different, I'll add this as an issue.

jkriege2, 2018-02-06:
I think pin1-indicator is only required for polarized devices, like diodes or electrolytic caps. We also don't use them on normal resistors or caps ... for pots they are (IMHO) only necessary, if we go through with the CW/CCW-markings ... and even then maybe another scheme of marking makes more sense?

poeschlr, 2018-02-07:
Marking one of the pins might still be helpful for debugging the pcb.

Thread 191 (2017-12-22):

Missing audio connectors

evanshultz, 2017-12-22:
https://github.com/KiCad/kicad-footprints/blob/master/TODO.md doesn't include (or doesn't include many) various professional audio connectors:
- 1/4" / phono
- XLR
- speakON

Some of these footprints exist in the old library but are outdated. I'll update and expand this collection of audio-specific connectors.

poeschlr, 2017-12-22:
Nice catch

terjeio, 2017-12-27:
@evanshultz I want to make 3D-models for Pro-Signal PSG01550 and PSG01551 RCA/phono sockets, I have footprints for them already but most likely not KLC compliant so needs to be updated. Are these in the list of those you want to add or should I keep them on my todo list?

evanshultz, 2018-01-12:
Go ahead. I'm going to be adding only Neutrik and Amphenol pro audio connectors (XLR, speakON, etc.) to start because they're generated considered "standard" or "reference" and most other brands of connectors are compatible. Thanks for the proposed contribution!

evanshultz, 2018-01-18:
@poeschlr @jkriege2
Question on pin numbers for these audio connectors that don't have pin numbers that are sequential integers starting at 1. Here are some examples (see the PDF drawing):
- http://www.neutrik.com/en/speakon/speakon-chassis-connectors/nl8md-v
- http://www.neutrik.com/en/audio/plugs-and-jacks/1/4-vertical-jacks/nj6fd-v
- http://www.neutrik.com/en/audio/plugs-and-jacks/jacks/combo-a-series/ncj6fa-v

Shall we give them normal audio conventions (and have a corresponding symbol) which I'm used to? That would mean the following pin numbers (in order from the list above):
- 1+, 1-, 2+, 2-, etc.
- T, T+N, R, R+N, etc.
- 1, 2, 3, T, R, S

If we use this pin numbering, where should the symbol be centered? Most of them will not have a pin numbered simply `1`. Do we use the closest pin number to 1? Or center the body geometry?

jkriege2, 2018-01-19:
For the (switching) audio-jacks, there exist generic symbols, e.g.
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
So if possible I would make the footprints compatible to that symbol.

For the XLR- there are also generic symbols XLR3-XLR5, so I would make the compatible to thise, e.g.
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

For the combines XLR+audio-jack, I would define a new symbol that is specialized.

One could think about adding a second variety of the symbols with some kind of postfix like `_StandardStereo` or something and then mention in there as text the names of the standard audio-signals, maybe as pin-labels opposite to the pin-number (is there a global standard for those or is it just everybody does it that way to be compatible? In the first case, we should also name the standard).

For the footprint centering: I think here we should for now stick to the THT:pin1=(0,0), SMD:pkg_cntr=(0,0) rules, but maybe discuss whether we modify them for switches and connectors, e.g. like this:
1. vertical switch/connector: (0,0) marks the connector/switch main axis/fronpanel dril-hole-center ...
2. hor. switch/connector: (0,0) is on the switch/connector-axis and maybe on the proposed PCB-edge

I think that would also work for pots ... or generally for everything that can be operated by hand. We would get problems with the check scripts though and I'm not sure about my rule 2 above!

What do you think?

JAN

evanshultz, 2018-01-19:
XLR uses just pin numbers, and that's fine with me.

But switching jacks have pin numbers that aren't standardized, in my experience, so using intelligent pin numbers seems best to me. It's far easier to check a schematic and PCB if the pin numbers are helpful rather than just numbers. For example, the symbol you showed above uses 1, 2, and 3 for S, R, T (normal audio convention would be T, R, and then S). And the 4-6 for the switched outputs. Using T, T+N, R, etc. is much more obvious and I believe would help KiCad users make sure their design is built right.

Since Neutrik is so well-known (and copied!) for audio connectors I put significant weight on using their naming conventions.

But, it would mean non-number pin numbers. We've talked about this a few times (I recall a discussion regarding switches but can't find it now). I'll rework the audio connector symbols (and footprints, if needed), and add new ones, if this is OK with y'all.

jkriege2, 2018-01-19:
What do T,R,S,T+N,... stand for?
Then why not use 1,2,3,.... for the different rings on an audio jack, starting from the tip, numbering towards the mantling and then using S1, S2, S3, ... for the switches where the number indicates the ring they are connected to ... wouldn't that make sense + it allows for extendability of the system to any such connector.

jkriege2, 2018-01-19:
Also I noticed Neutric using RM and RN contacts .... but I'm not so clear what these names stand for ...

evanshultz, 2018-01-19:
@jkriege2
It sounds like you're looking at a combo XLR + 1/4" connector like NCJ10FI-V? The poles of an XLR are numbered 1, 2, and 3, with well-defined connections (1 = ground, 2 = +, 3 = -). Having switched terminals is commonly called "normalling", and thus the nomenclature of "N" terminals. The poles of a 1/4" stereo are also well-defined but use a different terminology (T = tip, R = ring, S = sleeve).

And XLR connector may use 1-3. A stereo 1/4" may use T, R, and S. But a combo connector, as described above, would naturally use both since the terminals are distinct and the signals to/from the connector are implementation-dependent so they cannot be known. (For example, the XLR and 1/4" may go to different circuits. Or they could be wired together. This is only known by the designer.)

Where did you see RM contacts?

speakON connectors (like NL4MD-V) have two poles for each terminal, which could be grounded or not, and adopt 1+, 1-, 2+, etc. markings. Regardless of the electrical connection, one signal (1-) will be the reference for the other (1+) so they go together. Also, this marking indicates polarity/phase through the device (audio input to audio output) which is also extremely important in an audio system.

If we don't adhere to this well-understood terminology in the audio industry for KiCad's audio connectors, then I believe (with relevant experience) our symbols and footprints will be unintuitive.

jkriege2, 2018-01-19:
I found that there: http://www.neutrik.com/zoolu-website/media/download/2804/Jack+Circuits (lower row)

evanshultz, 2018-01-19:
If the jack is normalling (typically passes through, but is broken when a terminal is plugged in), the nomenclature is *N.

I'm honestly not sure about the "sleeve make" and "ring make" versions, but I suspect they're the opposite of a normalling jack in that plugging in a terminal makes a connection instead of breaking it. This might be used for an effects send/return connector. The nomenclature for those signals is *M while the other terminals are normalling with the common nomenclature.

Does that answer it?

evanshultz, 2018-01-22:
@jkriege2 @poeschlr
### 1. Audio connector pin names
Any other feedback on the above?

I have several questions after making a good number of footprints and thinking about this.

### 2. Footprint names
I think http://kicad-pcb.org/libraries/klc/F3.6/ covers these audio connectors in `Manufacturer Specific Connectors` section (many alternates are copies of a well-known vendor and can be linked back to the original vendor). If I read it right, here are some valid examples of correct footprint names that I'd like feedback on:
- [`Neutrik_XLR-AA_NC3FAAV_Vertical`](http://www.neutrik.com/en/xlr/aa-series/nc3faav)
- [`Neutrik_XLR-AA_NC3MAAH_Horizontal`](http://www.neutrik.com/en/xlr/aa-series/nc3maah)
- [`Neutrik_speakON_NL4MD-V_Vertical`](http://www.neutrik.com/en/speakon/speakon-chassis-connectors/nl4md-v)
- [`Neutrik_XLR-6.3mm_NCJ10FI-V_Vertical_Combo`](http://www.neutrik.com/en/audio/plugs-and-jacks/jacks/combo-i-series/ncj10fi-v)
- [`Neutrik_6.3mm_NMJ6HCD2_Horizontal_Stereo_Switched`](http://www.neutrik.com/en/audio/plugs-and-jacks/m-series/nmj6hcd2) (this is TRS stereo, and `Stereo` would be omitted for a mono TS version)

### 3. Existing footprints
I took a look at the existing footprints in :
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

They all need some work:
- `Jack_Horizontal` has a description in French and no identifying info
- All others but the first one appear to have a PN but no datasheet or manufacturer
- `Neutrik` is misspelled on the first one

Proposed fixes:
- I can correct the spelling when I submit my PR.
- But what about the unidentified connectors? Should we remove them if we can't offer a KiCad user what component they need to fit the footprint?

evanshultz, 2018-01-22:
### 4. Fab vs silk drawings
On a part like [`Neutrik_6.3mm_NMJ6HCD2_Horizontal_Stereo_Switched`](http://www.neutrik.com/en/audio/plugs-and-jacks/m-series/nmj6hcd2), which sits flush against the PCB in some areas but also hars "ears" for mounting above the PCB, how do we indicate this? I think we do fab lines everywhere, and silk in both areas. This lets the user see the connector placement against the PCB and also shows the orientation of the connector by putting the ears in silk. Here is an example:
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

I put fab lines everywhere but only silk around the outer extents. I think it's best if I also add silk where the connector touches the PCB. Any thoughts on that?

poeschlr, 2018-01-23:
Do not loose to much time on unidentified connectors. There is a reason we did not transfer all connectors from the old generic connectors lib.
If they are already in the new lib, please remove them.
About silk: looks good to me as you made it.

poeschlr, 2018-01-23:
About footprint name: I think they are not comparable to the manufacturer specific connectors but more like sub-d or usb connectors. This is called connectors for a specific function. (old name: standardized connector interface but manufacturer specific landing patter)

There the naming convention is:
`[Function]_[Standard]_[Size]-[Type]_[MAN]_[MPN]_[Modifiers]_[Orientation]_[Options]`

Example from your list:
`XLR-AA_Neutrik_NC3FAAV_Vertical`

jkriege2, 2018-01-23:
If the connectors are meant to work with some geneirc symbols (like the jack-symbol-series), we should also take into account whether it is possible to have a name-part that allows to filter them auto (at least to some degree of reliability) with the symbol FPFPilters ... I think the StereoJack_3.5mm-prefix is one way to do that.

evanshultz, 2018-02-05:
@poeschlr
What about `XLR_Neutrik_NC3FAAV_Vertical`? The "AA" part is the series of Neutrik connectors, and that's already encoded in the MPN.

And regarding pin numbers, what are we doing? I propose to use Neutrik PNs where `T` is the tip of a 1/4" jack, `TN` is the normalling tip pin, etc. Some of the XLR jacks have a dedicated ground pin, where we've discussed recently calling `SH` or `MP` on other connectors. Take [NC3FAH](http://www.neutrik.com/en/xlr/a-series/nc3fah), [NC3FAH1](http://www.neutrik.com/en/xlr/a-series/nc3fah1), and [NC3FAH2](http://www.neutrik.com/en/xlr/a-series/nc3fah2). They are all XLRs but with different grounding schemes. The first one just has the 3 XLR pins so they would be pin 1-3, the middle one connects one XLR mounting screw (shield of the cable if the cable is shielded) and chassis to pin 1 but still keeps only 3 pins, and the last one has 4 pins by adding a dedicated ground. What should these pins be named? The first one is easy, but what about the last two? Does the middle keep just pins 1-3 and leave it up to the user to realize that this connector also shorts pin 1 to the XLR mounting screw? And what does the last one name the ground pin? I personally don't think `SH` is the best name for the 3rd connector's ground pin because this isn't guaranteed to be a shield, so perhaps `G`?

evanshultz, 2018-02-05:
Here is an example of a company making largely compatible XLRs to Neutrik: http://www.zgele.com/products/XLR-CANNON-COMBO-CONNECTOR-SERIES.html. This includes the pin number of http://www.zgele.com/product/High-quality-Male-Female-XLR-Connector-with-3-4-5-6-or-7-Pins-factory-xlr3-003b.html, which is `1`, `2`, `3`, and `G` for a connector with a discrete ground pin.

evanshultz, 2018-04-20:
@poeschlr @jkriege2 @Ratfink
I would like to finalize pin names before I push my audio connector footprints. Right now the symbols for these footprints look like:
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

Does anybody have any issues with these pin names?

Any response to my comments on Jan 22 or the footprint name question above?

Ratfink, 2018-04-21:
The pin numbering seems fine to me.  As an aside, is it intentional that the switches in AudioJack3_Ground_Switch appear to be closed when the plug is inserted, but the others are opened when the plug is inserted; or is that an error in the symbol?

As for naming, I agree with Rene that they should follow the "Connectors for Specific Functions" convention.  The way you suggested for following that looks reasonable.

As for your other comments on 2018-01-22, the only thing I have to say is that I strongly suggest fixing the existing footprints in a separate PR from adding new footprints.  The PRs shouldn't conflict at all because of the .pretty format's one-footprint-per-file organization.

pushytoxin, 2018-05-05:
Hi @evanshultz
Do you have the footprint for the mono XLR combo jack? If not, I'm going to start working on it.

evanshultz, 2018-05-05:
@pushytoxin
Yes, I've made footprints for all Neutrik XLR combo connectors. I have an open question about footprint names above and then I will start to upload them. I'll try to get on this early next week.

evanshultz, 2018-05-12:
@pushytoxin
I didn't get this done last week and you must want the footprint now. Which Neutrik PN? I can at least save you some effort by giving my current file to you.

pushytoxin, 2018-05-14:
@evanshultz, that is awfully kind of you. If you have the NCJ5FI-H-0, and you uploaded it to your personal branch, I could check it out. Also, if you have the NMJ6HCD2, I'd compare it with my own as well.
But it's really not urgent, I still have some unrelated bugs with this board.

evanshultz, 2018-05-16:
@pushytoxin
Yep! I've actually got all Neutrik XLR and phono jacks. I changed file extensions to TXT to upload.
[NCJ5FI-H.txt](https://github.com/KiCad/kicad-footprints/files/2011142/NCJ5FI-H.txt)
[NMJ6HCD2.txt](https://github.com/KiCad/kicad-footprints/files/2011145/NMJ6HCD2.txt)

Note that I was only working on fab and silk lines so far. Descriptions and 3D models aren't included. Pin names aren't aligned to the new mating symbols. And there's probably some polish that will be needed to get them merged. But it's a nice start that hopefully can hold you over until I get them done.

evanshultz, 2018-06-18:
Can I get any feedback on a couple of footprints? I'd like to make sure I'm not missing anything big before I move forward with updating all the rest of them and starting a PR.

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

A couple notes:
- These are all drawn in a "normal" orientation with XLR pin 3 at towards the bottom.
- I've drawn silk where the part touches the PCB and also where any elements hang above the PCB.
- Pin naming is as described above.
- Footprint naming is slightly modified from above because the series is in the MPN. (I find it a bit odd that we put the manufacturer name first for QFN, for example, but not here when in both cases the repo name is descriptive enough to make the Function/Standard/Type unhelpful and we could just jump straight into the manufacturer name.)
- Are the description and keywords suitable?
- A new repo, `Connector_XLR` would be added.

http://www.neutrik.com/en/xlr/aa-series/nc3faah
```
(module XLR_Neutrik_NC3FAAH_Horizontal (layer F.Cu) (tedit 5B282C41)
  (descr "3 pole female XLR receptacle, grounding: without ground/shell contact, horizontal PCB mount (http://www.neutrik.com/en/xlr/aa-series/nc3faah)")
  (tags "xlr neutrik")
  (fp_text reference REF** (at 3.81 8) (layer F.SilkS)
    (effects (font (size 1 1) (thickness 0.15)))
  )
  (fp_text value XLR_Neutrik_NC3FAAH_Horizontal (at 3.81 -1.7) (layer F.Fab)
    (effects (font (size 1 1) (thickness 0.15)))
  )
  (fp_text user %R (at 3.81 -3.7) (layer F.Fab)
    (effects (font (size 1 1) (thickness 0.15)))
  )
  (fp_line (start -7.19 6.8) (end 14.81 6.8) (layer F.Fab) (width 0.1))
  (fp_line (start 14.81 -15.4) (end 14.81 -12.7) (layer F.Fab) (width 0.1))
  (fp_line (start -7.19 -15.4) (end 14.81 -15.4) (layer F.Fab) (width 0.1))
  (fp_line (start -7.19 -12.7) (end -7.19 -15.4) (layer F.Fab) (width 0.1))
  (fp_line (start -8.69 -8) (end -8.69 -12.7) (layer F.Fab) (width 0.1))
  (fp_line (start 16.31 -8) (end -8.69 -8) (layer F.Fab) (width 0.1))
  (fp_line (start 16.31 -12.7) (end 16.31 -8) (layer F.Fab) (width 0.1))
  (fp_line (start -8.69 -12.7) (end 16.31 -12.7) (layer F.Fab) (width 0.1))
  (fp_line (start 14.81 6.8) (end 14.81 -8) (layer F.Fab) (width 0.1))
  (fp_line (start -7.19 -8) (end -7.19 6.8) (layer F.Fab) (width 0.1))
  (fp_line (start -8.69 -12.7) (end 16.31 -12.7) (layer Dwgs.User) (width 0.1))
  (fp_line (start 16.43 -12.82) (end 16.43 -7.88) (layer F.SilkS) (width 0.12))
  (fp_line (start -8.81 -12.82) (end -8.81 -7.88) (layer F.SilkS) (width 0.12))
  (fp_line (start -7.31 -7.88) (end -7.31 6.92) (layer F.SilkS) (width 0.12))
  (fp_line (start 14.93 -7.88) (end 14.93 6.92) (layer F.SilkS) (width 0.12))
  (fp_line (start -7.31 -7.88) (end -8.81 -7.88) (layer F.SilkS) (width 0.12))
  (fp_line (start 16.43 -7.88) (end 14.93 -7.88) (layer F.SilkS) (width 0.12))
  (fp_line (start -7.31 -12.82) (end -7.31 -15.52) (layer F.SilkS) (width 0.12))
  (fp_line (start 14.93 -12.82) (end 14.93 -15.52) (layer F.SilkS) (width 0.12))
  (fp_line (start 14.93 -12.82) (end 16.43 -12.82) (layer F.SilkS) (width 0.12))
  (fp_line (start -8.81 -12.82) (end -7.31 -12.82) (layer F.SilkS) (width 0.12))
  (fp_line (start -7.31 -15.52) (end 14.93 -15.52) (layer F.SilkS) (width 0.12))
  (fp_line (start 16.81 -15.9) (end 16.81 7.3) (layer F.CrtYd) (width 0.05))
  (fp_line (start -9.19 -15.9) (end -9.19 7.3) (layer F.CrtYd) (width 0.05))
  (fp_line (start -9.19 7.3) (end 16.81 7.3) (layer F.CrtYd) (width 0.05))
  (fp_line (start -9.19 -15.9) (end 16.81 -15.9) (layer F.CrtYd) (width 0.05))
  (fp_line (start -7.31 6.92) (end 14.93 6.92) (layer F.SilkS) (width 0.12))
  (pad 1 thru_hole circle (at 0 0) (size 3.4 3.4) (drill 1.6) (layers *.Cu *.Mask))
  (pad 2 thru_hole circle (at 7.62 0.635) (size 3.4 3.4) (drill 1.6) (layers *.Cu *.Mask))
  (pad 3 thru_hole circle (at 3.81 4.45) (size 3 3) (drill 1.2) (layers *.Cu *.Mask))
  (pad "" np_thru_hole circle (at 0 -8.89) (size 1.6 1.6) (drill 1.6) (layers *.Cu *.Mask))
  (pad "" np_thru_hole circle (at 7.62 -3.81) (size 1.6 1.6) (drill 1.6) (layers *.Cu *.Mask))
  (model ${KISYS3DMOD}/Connector_XLR.3dshapes/XLR_Neutrik_NC3FAAH_Horizontal.wrl
    (at (xyz 0 0 0))
    (scale (xyz 1 1 1))
    (rotate (xyz 0 0 0))
  )
)
```

http://www.neutrik.com/en/xlr/nc3mbv-sw
```
(module XLR_Neutrik_NC3MBV-SW_Switched_Vertical (layer F.Cu) (tedit 5B282ECC)
  (descr "3 pole male XLR receptacle, switching contacts, grounding: separate ground contact to mating connector shell and front panel, vertical PCB mount (http://www.neutrik.com/en/xlr/nc3mbv-sw)")
  (tags "xlr neutrik")
  (fp_text reference REF** (at 3.81 -13.8) (layer F.SilkS)
    (effects (font (size 1 1) (thickness 0.15)))
  )
  (fp_text value XLR_Neutrik_NC3MBV-SW_Switched_Vertical (at 3.81 1) (layer F.Fab)
    (effects (font (size 1 1) (thickness 0.15)))
  )
  (fp_text user %R (at 3.81 -1) (layer F.Fab)
    (effects (font (size 1 1) (thickness 0.15)))
  )
  (fp_line (start -8.69 2.5) (end -7.19 2.5) (layer F.Fab) (width 0.1))
  (fp_line (start -8.69 -2.5) (end -8.69 2.5) (layer F.Fab) (width 0.1))
  (fp_line (start -7.19 -2.5) (end -8.69 -2.5) (layer F.Fab) (width 0.1))
  (fp_line (start -4.69 12.5) (end -4.69 9.16) (layer F.Fab) (width 0.1))
  (fp_line (start -3.09 -12.492) (end 3.81 -12.492) (layer F.Fab) (width 0.1))
  (fp_line (start 14.81 -5.92) (end 14.81 6.21) (layer F.Fab) (width 0.1))
  (fp_line (start -9.39 15) (end -9.39 -13.2) (layer F.CrtYd) (width 0.05))
  (fp_line (start 17.01 15) (end -9.39 15) (layer F.CrtYd) (width 0.05))
  (fp_line (start 17.01 -13.2) (end 17.01 15) (layer F.CrtYd) (width 0.05))
  (fp_line (start -9.39 -13.2) (end 17.01 -13.2) (layer F.CrtYd) (width 0.05))
  (fp_line (start 0.7 12.5) (end 0.7 14.5) (layer F.Fab) (width 0.1))
  (fp_line (start -0.7 14.5) (end 0.7 14.5) (layer F.Fab) (width 0.1))
  (fp_line (start -0.82 12.62) (end -0.82 14.62) (layer F.SilkS) (width 0.12))
  (fp_line (start -0.82 14.62) (end 0.82 14.62) (layer F.SilkS) (width 0.12))
  (fp_line (start 6.92 12.5) (end 6.92 14.5) (layer F.Fab) (width 0.1))
  (fp_line (start -4.69 12.5) (end 13.71 12.5) (layer F.Fab) (width 0.1))
  (fp_line (start 6.8 12.62) (end 6.8 14.62) (layer F.SilkS) (width 0.12))
  (fp_line (start 0.82 12.62) (end 0.82 14.62) (layer F.SilkS) (width 0.12))
  (fp_line (start -4.81 12.62) (end 13.68 12.62) (layer F.SilkS) (width 0.12))
  (fp_line (start -0.7 12.5) (end -0.7 14.5) (layer F.Fab) (width 0.1))
  (fp_line (start 14.93 -5.97) (end 14.93 6.19) (layer F.SilkS) (width 0.12))
  (fp_line (start 6.8 14.62) (end 8.44 14.62) (layer F.SilkS) (width 0.12))
  (fp_line (start 6.92 14.5) (end 8.32 14.5) (layer F.Fab) (width 0.1))
  (fp_line (start 8.32 12.5) (end 8.32 14.5) (layer F.Fab) (width 0.1))
  (fp_line (start 8.44 12.62) (end 8.44 14.62) (layer F.SilkS) (width 0.12))
  (fp_line (start -7.19 5.93) (end -7.19 2.5) (layer F.Fab) (width 0.1))
  (fp_line (start -7.31 -2.62) (end -7.31 -6.19) (layer F.SilkS) (width 0.12))
  (fp_line (start 3.81 -12.492) (end -6.09 -12.499) (layer F.Fab) (width 0.1))
  (fp_line (start 3.81 -12.62) (end -6.06 -12.62) (layer F.SilkS) (width 0.12))
  (fp_line (start -4.81 12.62) (end -4.81 9.21) (layer F.SilkS) (width 0.12))
  (fp_line (start -7.31 5.95) (end -7.31 2.62) (layer F.SilkS) (width 0.12))
  (fp_line (start -7.31 -2.62) (end -8.81 -2.62) (layer F.SilkS) (width 0.12))
  (fp_line (start -7.31 2.62) (end -8.81 2.62) (layer F.SilkS) (width 0.12))
  (fp_line (start -8.81 2.62) (end -8.81 -2.62) (layer F.SilkS) (width 0.12))
  (fp_line (start -7.19 -2.5) (end -7.19 -6.21) (layer F.Fab) (width 0.1))
  (fp_circle (center 3.81 0) (end 14.81 0) (layer F.Fab) (width 0.1))
  (fp_circle (center -6.09 -9.9) (end -6.09 -11) (layer F.Fab) (width 0.1))
  (fp_circle (center 13.71 9.9) (end 13.71 11) (layer F.Fab) (width 0.1))
  (fp_arc (start 3.81 0) (end 3.81 -11) (angle 90) (layer F.Fab) (width 0.1))
  (fp_arc (start 3.81 0) (end -3.39 8.315) (angle 49.11054795) (layer F.Fab) (width 0.1))
  (fp_arc (start 19.01 5.6) (end 15.57 8.085) (angle 27.5) (layer F.Fab) (width 0.1))
  (fp_arc (start 13.71 9.9) (end 15.57 8.085) (angle 134.4) (layer F.Fab) (width 0.1))
  (fp_arc (start 13.71 9.9) (end 15.657 8) (angle 135.2) (layer F.SilkS) (width 0.12))
  (fp_arc (start 19.01 5.6) (end 15.657 8) (angle 27.3) (layer F.SilkS) (width 0.12))
  (fp_arc (start 3.81 0) (end 3.81 -12.492) (angle 61.7) (layer F.Fab) (width 0.1))
  (fp_arc (start 3.81 0) (end 3.81 -12.62) (angle 61.75) (layer F.SilkS) (width 0.12))
  (fp_arc (start 3.81 0) (end -4.81 9.21) (angle 18.7) (layer F.SilkS) (width 0.12))
  (fp_arc (start -6.09 -9.9) (end -7.95 -8.085) (angle 134.4) (layer F.Fab) (width 0.1))
  (fp_arc (start -11.39 -5.6) (end -7.95 -8.085) (angle 27.5) (layer F.Fab) (width 0.1))
  (fp_arc (start -6.09 -9.9) (end -8.037 -8) (angle 135.2) (layer F.SilkS) (width 0.12))
  (fp_arc (start -11.39 -5.6) (end -8.037 -8) (angle 27.3) (layer F.SilkS) (width 0.12))
  (fp_arc (start 3.81 0) (end -4.69 9.16) (angle 18.8) (layer F.Fab) (width 0.1))
  (pad 1 thru_hole circle (at 0 0) (size 3.4 3.4) (drill 1.6) (layers *.Cu *.Mask))
  (pad 2 thru_hole circle (at 7.62 0) (size 3.4 3.4) (drill 1.6) (layers *.Cu *.Mask))
  (pad G thru_hole circle (at 3.81 8.25) (size 3 3) (drill 1.2) (layers *.Cu *.Mask))
  (pad 3 thru_hole circle (at 3.81 3.81) (size 3.4 3.4) (drill 1.6) (layers *.Cu *.Mask))
  (pad NC thru_hole circle (at -3.175 0.635) (size 1.8 1.8) (drill 1.2) (layers *.Cu *.Mask))
  (pad N thru_hole circle (at -5.08 0) (size 1.8 1.8) (drill 1.2) (layers *.Cu *.Mask))
  (pad NO thru_hole circle (at -6.985 -0.635) (size 1.8 1.8) (drill 1.2) (layers *.Cu *.Mask))
  (model ${KISYS3DMOD}/Connector_XLR.3dshapes/XLR_Neutrik_NC3MBV-SW_Switched_Vertical.wrl
    (at (xyz 0 0 0))
    (scale (xyz 1 1 1))
    (rotate (xyz 0 0 0))
  )
)
```

http://www.neutrik.com/en/audio/plugs-and-jacks/jacks/combo-i-series/ncj10fi-v
```
(module XLR-6.35mm_Neutrik_NCJ10FI-V_Vertical (layer F.Cu) (tedit 5B28310E)
  (descr "3 pole XLR female receptacle with 1/4 inch switching stereo jack and switching ground contact, vertical PCB mount (http://www.neutrik.com/en/audio/plugs-and-jacks/jacks/combo-i-series/ncj10fi-v)")
  (tags "xlr neutrik")
  (fp_text reference REF** (at -6.15 -16.1) (layer F.SilkS)
    (effects (font (size 1 1) (thickness 0.15)))
  )
  (fp_text value XLR-6.35mm_Neutrik_NCJ10FI-V_Vertical (at -6.15 1) (layer F.Fab)
    (effects (font (size 1 1) (thickness 0.15)))
  )
  (fp_text user %R (at -6.15 -1) (layer F.Fab)
    (effects (font (size 1 1) (thickness 0.15)))
  )
  (fp_line (start 6.35 9) (end 4.63 7.28) (layer F.Fab) (width 0.1))
  (fp_line (start -18.65 -9) (end -16.93 -7.28) (layer F.Fab) (width 0.1))
  (fp_line (start -13.65 -14) (end -11.64 -11.79) (layer F.Fab) (width 0.1))
  (fp_line (start -20.15 17) (end -20.15 -15.5) (layer F.CrtYd) (width 0.05))
  (fp_line (start 7.85 17) (end -20.15 17) (layer F.CrtYd) (width 0.05))
  (fp_line (start 7.85 -15.5) (end 7.85 17) (layer F.CrtYd) (width 0.05))
  (fp_line (start -20.15 -15.5) (end 7.85 -15.5) (layer F.CrtYd) (width 0.05))
  (fp_line (start -17.15 15) (end 3.35 15) (layer F.Fab) (width 0.1))
  (fp_line (start -17.15 6.93) (end -17.15 15) (layer F.Fab) (width 0.1))
  (fp_line (start -1.1 15) (end -1.1 16.5) (layer F.Fab) (width 0.1))
  (fp_line (start -3.2 15) (end -3.2 16.5) (layer F.Fab) (width 0.1))
  (fp_line (start -3.2 16.5) (end -1.1 16.5) (layer F.Fab) (width 0.1))
  (fp_line (start -3.32 15.12) (end -3.32 16.62) (layer F.SilkS) (width 0.12))
  (fp_line (start -3.32 16.62) (end -0.98 16.62) (layer F.SilkS) (width 0.12))
  (fp_line (start -0.98 15.12) (end -0.98 16.62) (layer F.SilkS) (width 0.12))
  (fp_line (start -17.27 6.98) (end -17.27 15.12) (layer F.SilkS) (width 0.12))
  (fp_line (start -0.98 15.12) (end 3.38 15.12) (layer F.SilkS) (width 0.12))
  (fp_line (start -17.27 15.12) (end -3.32 15.12) (layer F.SilkS) (width 0.12))
  (fp_line (start -13.49 -14) (end -11.61 -11.94) (layer F.SilkS) (width 0.12))
  (fp_line (start 6.51 9) (end 4.78 7.27) (layer F.SilkS) (width 0.12))
  (fp_line (start -18.81 -9) (end -17.085 -7.26) (layer F.SilkS) (width 0.12))
  (fp_circle (center -16.15 -11.5) (end -16.15 -13) (layer F.Fab) (width 0.1))
  (fp_circle (center -6.15 0) (end 5.55 0) (layer F.Fab) (width 0.1))
  (fp_circle (center 3.85 11.5) (end 3.85 13) (layer F.Fab) (width 0.1))
  (fp_circle (center -6.15 0) (end 6.85 0) (layer F.Fab) (width 0.1))
  (fp_arc (start -6.15 0) (end -17.27 6.98) (angle 65.7) (layer F.SilkS) (width 0.12))
  (fp_arc (start -16.15 -11.5) (end -18.65 -9) (angle 180) (layer F.Fab) (width 0.1))
  (fp_arc (start 3.85 11.5) (end 6.35 9) (angle 143) (layer F.Fab) (width 0.1))
  (fp_arc (start -6.15 0) (end -11.61 -11.94) (angle 148.2) (layer F.SilkS) (width 0.12))
  (fp_arc (start -16.15 -11.5) (end -18.81 -9) (angle 180) (layer F.SilkS) (width 0.12))
  (fp_arc (start 3.85 11.5) (end 6.51 9) (angle 140.6) (layer F.SilkS) (width 0.12))
  (fp_circle (center -6.15 0) (end -17.27 6.98) (layer F.SilkS) (width 0.12))
  (pad 1 thru_hole circle (at 0 0) (size 3 3) (drill 1.2) (layers *.Cu *.Mask))
  (pad 2 thru_hole circle (at -12.3 0) (size 3 3) (drill 1.2) (layers *.Cu *.Mask))
  (pad 3 thru_hole circle (at -6.15 6.05) (size 3 3) (drill 1.2) (layers *.Cu *.Mask))
  (pad G thru_hole circle (at -6.15 10.45) (size 3 3) (drill 1.2) (layers *.Cu *.Mask))
  (pad S thru_hole circle (at -11.95 5.8) (size 3 3) (drill 1.2) (layers *.Cu *.Mask))
  (pad T thru_hole circle (at -11.35 -5.2) (size 3 3) (drill 1.2) (layers *.Cu *.Mask))
  (pad R thru_hole circle (at -0.35 5.8) (size 3 3) (drill 1.2) (layers *.Cu *.Mask))
  (pad TN thru_hole circle (at -9.15 -3) (size 3 3) (drill 1.2) (layers *.Cu *.Mask))
  (pad RN thru_hole circle (at -3.15 3) (size 3 3) (drill 1.2) (layers *.Cu *.Mask))
  (pad SN thru_hole circle (at -9.15 3) (size 3 3) (drill 1.2) (layers *.Cu *.Mask))
  (pad GN thru_hole circle (at -9.25 8.25) (size 3 3) (drill 1.2) (layers *.Cu *.Mask))
  (model ${KISYS3DMOD}/Connector_XLR.3dshapes/XLR-6.35mm_Neutrik_NCJ10FI-V_Vertical.wrl
    (at (xyz 0 0 0))
    (scale (xyz 1 1 1))
    (rotate (xyz 0 0 0))
  )
)
```

evanshultz, 2018-06-26:
These could actually go into the existing `Connector_Audio`. Comment above edited.

Any feedback on these footprints?

evanshultz,
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

Thread 209 (2018-01-03):

Most footprints for packages that have Exposed pads to not conform to KLC with regards to paste layer implementation

poeschlr, 2018-01-03:
Violated KLC rule: http://kicad-pcb.org/libraries/klc/F6.3/

This rule states that there should be one large copper pad (paste layer disabled. Mask enabled unless a specific mask size needs to be achieved.)
Overlayed with smaller pads for paste only. (This pads have no copper enabled and no pin number assigned.)

---

Currently a lot of footprints (nearly all of them) have multiple copper pads that have simply a negative paste clearance or solder paste ratio set.

krtkr, 2018-01-04:
Hey,
I can take a look at Package_QFP library on the issue.

poeschlr, 2018-01-31:
This has been fixed in footprints https://github.com/KiCad/kicad-footprints/pull/285 and https://github.com/KiCad/kicad-footprints/pull/329. (There might still be some small number of footprints remaining but the majority should now conform to the KLC.)

Closed 2018-01-31.

Thread 223 (2018-01-04):

CP_Radial_SMD have fixed chamfer of 1mm

Shackmeister, 2018-01-04:
Hi
since the SMD radial capacitors have wrong models, I wanted to make sure the footprints are up to date before making the new models.
first thing I noticed is all the footprints has the same chamfer (polarity, not pin 1) of 1mm for all sizes.
should it be kept like this or wouldnt a percentage chamfer make more sense?
please pitch in some opinions so I can get started :)

poeschlr, 2018-01-04:
From KLC http://kicad-pcb.org/libraries/klc/F5.2/:

> Bevel should be 1mm or 25% of package size (whichever is smaller)

Shackmeister, 2018-01-04:
Ah I only thought it was for the pin 1 indicators.
Ill add the change it to min(width/4,1.0) for the footprints then. (and change the models accordingly)

poeschlr, 2018-01-05:
I had a closer look.
First of all i can't find the footprints you are referencing. (Are currently not in the lib under that name.)
Secondly: If it is not meant as a pin 1 marker but to represent the package outline then the package dimensions determine the size of the chamfer.

Shackmeister, 2018-01-06:
I guess the chamfers are meant as a pin 1 (polarity) indicator, but the are also a part of the packagedrawing.. Tricky part is the chamfer is not specified in the datasheet, so it would be a matter of checking manufacturer 3D models for the measurement.
we could go with the min(1.0,width/4) and call it worst case scenario, but that's not too accurate

poeschlr, 2018-01-06:
Would be good enough for now. If someone is motivated this can be done at a later date. And for generic footprints it will always be hard to find one   definition that fits all possible parts.

Shackmeister, 2018-01-07:
My plan is to grab all the different radial smd caps I have at work and see if they have a pattern (like 1/4 of the width) otherwise it will be 1mm,w/4 and models make accordingly :)

Thread 224 (2018-01-05):

Questions: Which pin is pin1 on a diode bridge rectifier?

jkriege2, 2018-01-05:
Hi!

I'm currently adding several diode bridges to the symbols, footpritns and 3D models. With the typical SIL-packages, I'm a bit stuck, as I'm not sure which pin to designate pin 1:
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
Could you quickly state your preference?

For now I took the left pin, but currently I tend towards using the pin on the right, marked by the package bevel! This would also prevent us from the situation that pin1 is marked on the silkscreen, but the package has a mark at pin 4 ...

Best,
JAN

SchrodingersGat, 2018-01-05:
Can you provide a datasheet for one of these packages? I assume that these are not simply the "standard" SIP package?

jkriege2, 2018-01-05:
e.g. https://diotec.com/tl_files/diotec/files/pdf/datasheets/b40c700040.pdf

jkriege2, 2018-01-05:
or http://www.vishay.com/docs/88657/kbu6.pdf

pointhi, 2018-01-05:
I would also tend to the body bevel on the right, because the datasheet doesn't specify a pin 1, and it's the visual noticable side where people normally assume pin 1 is located.

jkriege2, 2018-01-05:
OK! I think I'm going to rotate all packages as follows:
[2018-01-05 14_08_30-3d viewer](https://user-images.githubusercontent.com/11967523/34610557-fe1fc16e-f221-11e7-8b67-0c8a8f13d778.png)

SchrodingersGat, 2018-01-05:
Agreed. One of the examples had a longer pin ok the right side also. Definitely should be pin 1

jkriege2, 2018-01-06:
OK, so I tagged the marked pin (package bevel or longer pin) as pin 1, but in the footprint put them on the left to fulfil KLC (pin 1 top-left).

I will add some more of  these and post at some point in the  next week I think!

Closed 2018-01-06.

Thread 228 (2018-01-06):

Connector_IEC_DIN

SchrodingersGat, 2018-01-06:
This legacy library has now been archived but the footprints still need to be transferred across to here..

poeschlr, 2018-01-09:
The generator scripts have not yet been merged. They are also not easily changed to fit new requirements. So i would suggest we move them over as they are right now and document remaining KLC problems in an issue. (One of the problems is the naming of the footprints.)

SchrodingersGat, 2018-01-09:
Are you able to take care of the transfer of these, Rene?

MRQ, 2018-01-10:
Are you referring to this generator script?: https://github.com/pointhi/kicad-footprint-generator/pull/101
You might have seen that I changed the naming. My rule is documented in the [generator script](https://github.com/pointhi/kicad-footprint-generator/pull/101/files#diff-090538bdac423c1b360263be38755ab2R14).

poeschlr, 2018-01-10:
Regarding naming, see http://kicad-pcb.org/libraries/klc/F3.6/ section `Connectors with Standardised Shape`

> Many connectors are provided by multiple manufacturers in an industry standard package or physical layout. These connectors should use the accepted industry naming at the beginning of the footprint name:
`[Standard]-[Pins]_[Series modifier]_[MAN]_[Series]_[MPN]_[Pin layout]_P[Pitch]_[Modifiers]_[Orientation]_[Options]`

In your case it should be at least:
`[Standard]-[Pins]_[Pin layout]_P[Pitch]_[Orientation]` (Pin layout only for connectors that have missing pins)

poeschlr, 2018-08-29:
The footprints in question have been merged.

Closed 2018-08-29.

Thread 235 (2018-01-09):

FSDH321L and FSDL321L are missing an 8LSOP package

antoniovazquezblanco, 2018-01-09:
Datasheet: https://www.fairchildsemi.com/datasheets/FS/FSDH321.pdf

Components FSDH321L and FSDL321L available at the symbols repo (Converter_ACDC) are missing a footprint.

antoniovazquezblanco, 2018-01-09:
If at least we can agree on naming for the footprint here I can add it to the symbol in the current PR. Any suggestions @SchrodingersGat?

poeschlr, 2018-01-09:
Regarding naming see: http://kicad-pcb.org/libraries/klc/F3.4/ (Gull wing)

I think these might be possible as generic footprints so no need for a manufacturer prefix.
I assume they will be part of the SOIC lib and named `LSOP-8_ ...`

antoniovazquezblanco, 2018-01-10:
I guess then it would be `LSOP-8_6.4x9.7mm_P2.54mm`.

Thank you very much @poeschlr.

stephf0716, 2018-01-21:
I am working on the footprint.
@antoniovazquezblanco
Shouldn't name be `LSOP-8_6.4x9.2mm_P2.54mm`?
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

antoniovazquezblanco, 2018-01-22:
@stephf0716 you are right! Sorry! I will fix the footprint filter in the component. Thank you very much for your help ;)

stephf0716, 2018-01-22:
@antoniovazquezblanco I will use `Fairchild_8LSOP`

poeschlr, 2018-01-22:
`Fairchild_LSOP-8` would fit the rest of the library better.

Closed 2018-01-23.

Thread 238 (2018-01-10):

Missing fuse holders

u382903, 2018-01-10:
Looks like good footprints for fuse holders were deleted. They were described as "Fuse_Holders_and_Fuses:Fuseholder5x20_horiz_open_universal_Type-III", type II and I (also other footprints with 5x20 and 5x25 in name were good). Please restore them.

poeschlr, 2018-01-10:
If you can link at least one product to each of them, then we can include them.

u382903, 2018-01-10:
Here you have list of many products that were compatible with these footprints - first 8 for example from link below:
https://www.digikey.com/products/en/circuit-protection/fuseholders/140
or here: https://www.tme.eu/gb/katalog/#id_category=100088&page=1&s_field=niski_prog&s_order=ASC
or this: https://www.tme.eu/gb/details/zhl77/pcb-fuseholders/stelvio-kontek/ptf77/
Type III was universal, it was made from type I and II.
So these footprints were good for 'bare' fuse clips, which are used widely.

stephf0716, 2018-01-20:
Please link to a specific product for each footprint. The first two links are not specific, and the suggested land pattern for the third link you provided does not match any of the three footprints you mentioned.

Here are links to fuse clip datasheets from three manufacturers: [littelfuse](http://www.littelfuse.com/data/en/data_sheets/littelfuse_fuse-clips.pdf), [Keystone](http://keyelco.com/userAssets/file/M65-fuse-mountinglayout.pdf), and [Cooper](http://www.cooperindustries.com/content/dam/public/bussmann/Electrical/Resources/product-datasheets-a/Bus_Ele_DS_2131_1AXXXX_Series.pdf)

The recommended footprints for 5x20mm fuse clips do vary from part to part.

u382903, 2018-01-25:
For Type I this would fit: https://www.digikey.com/product-detail/en/littelfuse-inc/01000056Z/F3784-ND/2498892 (in catalog it's described as series 100)
For Type II: https://www.digikey.com/product-detail/en/littelfuse-inc/01110501Z/F4189-ND/2518598 (in catalog it's described as series 111)
And Type III would fit both of those fuse clips series.
Recommended footprints indeed vary from part to part, but I think there should be footprints for 'bare' fuse clips. It will be laborious process to add most of them, but these footprints will be good for beginning.

poeschlr, 2018-01-31:
I am not opposed to adding them as long as order information for at least one part is added to the description field of the footprints. That way users have a chance to find a part for the footprint. (you can add for example: "Generic footprint for fuse holders similar to: xxxxx, yyyyy, ..."

So could you open a pull request that transfers them over and also adds that stuff to the description field?

evanshultz, 2018-10-03:
I'll take this one.

In my experience 5x20mm and 6.3x32mm (1/4" x 1-1/4", 3AG, AGC) are the common cylindrical fuse sizes. Are there others anyone suggests we also include clips for while I'm at it?

I trolled the internet for the vendors above, vendors I knew and vendors at DigiKey to build up a small sampling of fuse clip info. Based on the parts I found (https://docs.google.com/spreadsheets/d/1OSzm-NI75B3XSdkQu7nbU0WIWMq-NZ3z9Eb7iX6Cmqw/edit?usp=sharing), there isn't broad commonality. I grouped rows in each configuration which are close enough to share a footprint using color. I choose "commonality" to mean <=0.5mm dimensional differences with ~1mm for drill diameter as I've seen both hand-built and mass production boards install the fuse in the clips before insertion to the PCB which means a bit of clip floating in oversized holes can be handled during wave solder.

Building off of http://kicad-pcb.org/libraries/klc/F3.7/, I propose the following footprint naming convention: `Fuseholder_Cylinder-[size x]x[size y]mm_Clip_***_[pin position]_Horizontal`. Open items:
1. `***` needs to capture the pin spacing, drill diameter, and potential body XxY size if we will have multiple footprints. However, that doesn't seem too helpful to the user trying to select a footprint. Maybe we instead make a universal footprint with several sets of overlapping holes so a single footprint can accommodate loads of clips?
1. These fuse clips come in `|` and `-` pin locations so `[pin position]` could be based on absolute position (`PinsVertical`, `PinsHorizontal`, `PinsBoth`) or relative to the fuse body (`PinsInline`/`PinsParallel`/`PinsLength`, `PinsNormal`/`PinsPerpendicular`/`PinsWidth`, `PinsBoth`). Since absolute could change if the footprint is rotated, I favor the latter style. Both seem rather unintuitive to me, though. Any better ideas?
1. Can `_Horizontal` be left off? I don't know any clips that are vertical, but I suppose there could be. Or the information is provides to the user is worthwhile.

For reference, here are the footprints that were lost when transferring footprints from the old library (https://github.com/KiCad/Fuse_Holders_and_Fuses.pretty):
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

feichtinger, 2018-12-28:
Is there any progress on this issue? As far as I can tell the footprints for 'clip-type' fuse holders are still missing.

poeschlr, 2018-12-28:
We laid out the requirements for these to be accepted above. Feel free to create a pull request complying with these requirements.

To be honest after reading the stuff even dug up i am more and more in favor of using part specific footprints here instead of going generic. (I know generic is tempting as it gives the impression of having lots of parts covered with a single footprint. However if the naming convention is already that complex then i have to ask the question if any user will then be able to find their correct footprint. There simply is too much variation between different parts. Especially if we take things like 3d models and part outlines into account as well. These will only add further parameters to be covered by a generic footprint naming scheme.)

evanshultz, 2018-12-28:
I already made a number of them and was waiting on more input to the above questions I raised. I'll push the footprints (but not until next week when I'm back at that computer) and then we can decide it if works or to scrap it.

herostrat, 2019-01-17:
I looked over the footprints and your research and firstly: awesome work.

The problem really is the sheer amount of different vendors and options.
I think that a "generic" version would be beneficial, because as far as I can see, versions and naming changes often and gets extended.

To your questions:
 1. imho a superposition of common spacings is a good idea. Because we have a multitude of very similar footprints, this could enable a short list of generic versions.
 2. because there is no "official" naming convention for this stuff, I think we should just refer them to "type-1" and so on. This makes the naming a lot more comprehensible
 3. I would not include horizontal

I see a lot of SMD fuseholder, but I do not know how common they are.
So I would probably indicate in the name if it is TH or SMD

My reasoning for those arguments is:
If we include generic footprints, the user has to verify that his/her fuse holder falls under this category be comparing the bought ones with the footprint of KiCad.
In many cases (if we can make it right) the actual fuse will fall under the generic category.
If not the user has to modify the footprint and if he/she chooses to upstream it, we can think about extending the portfolio.

Another point I want to make:
On many cases the fuseholders get used for other stuff than just fuses (e.g. geiger tubes) or uncommon fuse sizes that are not sensible to include in a standard library (e.g. in my cheap multimeter they use a 5x10mm fuse).

Because most fuse holders are a single component, we could also add a wings as single footprints, enabling uncommon usecases.
Naming could be just Fuseholder_Universal_Type-X

evanshultz, 2019-01-23:
Sorry. It appears I made new fuse holder footprints and attached those above. I should have made a PR for them but had forgotten with the passage of time.

I agree with your points above, including adding "THT" to generic footprints, and thanks for reading and commenting. I do still favor a more intuitive name than "type x" because then on a BOM it would be more clear what type of fuseholder is being referred to (naturally a KiCad user would be able to easily see the footprint), but if everybody else like the "type x" style that's OK with me.

But then again, I only came up with 3 possible generic footprints. An alternative would be to have several exact footprints and then better specify them so the user could look at any datasheet and see if their desired fuseholder fit in our specific footprints. Does that proposal make sense? In this case, perhaps a naming convention something like `Fuseholder_Cylinder-[size x]x[size y]mm_[Man]_[MPN]_[pin position as described above]_P[pin spacing]x[outside spacing]mm_D[drill]mm_[Horizontal|Vertical]` would work?

Thoughts?

evanshultz, 2019-06-25:
@poeschlr
@herostrat
Any more comments on this? I would like to get the naming straightened out and submit a PR for these footprints, but I'd most prefer to settle the naming here so the PR is clean and discussion stays together.

poeschlr, 2019-06-26:
I like your last proposal more than the generic route to be honest. (As i fear that fuseholders are not standardized enough for investing time into a generic footprint. Especially one that would fulfill our standards of not only having the pads at the correct position but also the correct outlines on fab and silk as well as courtyard.)

evanshultz, 2019-07-18:
I submitted a PR, as you can see above, and pushed a number of footprints if anybody wants to take a look.

But I think there is some more good discussion we can have before merging anything.

---

Regarding the "type" of the fuse, I proposed something with intelligence above but realized the old footprints used "inline" and "lateral" already. Those terms are OK with me, so I adopted them. No reason to use two terms in the footprint name when "type 1" was the same as "inline" and the word "inline" also tells you something useful.

20.5 and 20.6mm are common outermost pin spacing for inline clips. The first link Google returned from querying "5x20mm fuse filetype:pdf" was http://www.farnell.com/datasheets/1504744.pdf, and that shows the metal end terminations are 5mm long on each side. So even having fuse clips 1mm offset from ideal (and maybe even more) should mechanically be OK for many fuse clips (some have a retention mechanism that could create interference) and likely has little to no impact on contact resistance and maximum carry current. So I think a generic footprint would be fine and useful.

The footprint naming I went for is `Fuseholder_Clip-[fuse size x]x[fuse size y]mm_[Man]_[MPN]_[Inline|Lateral|Universal]_[]mm_P[pin outermost spacing]x[pin spacing on clip]mm_D[drill x]x[drill y]mm_[Horizontal|Vertical]`. Please comment if you have some thoughts.

Lastly, it was mentioned above or somewhere else that a single footprint has two clips so the BOM doesn't quite match up with a single ref des. Even more than that, there is a fuse (so three total MPNs for one ref des). However, the ref des will be matched to one schematic symbol and there you want the fuse and it's electrical parameters selected. So the clips need to "ride along" as a mechanical part attached to the fuse (the electrical part) ref des. Same if it's a single box or tube-style fuseholder rather than clips. At least that's the way I've successfully handled it in other ECAD tools.

It would be great to have these footprints merged, so I'm happy to see more comments so all open questions can be answered and we can make some fuse clip footprints available. Thanks!

Thread 266 (2018-01-17):

Footprints with complex pad shapes would benefit from the use of polygon pads.

poeschlr, 2018-01-17:
Polygon pads result in better paste and mask handling then overlapping pads.

The downsides are:
- not compatible with version 4. (But we already have ~~some~~ **many** libs that include rounded rectangles. This already results in invalid libs.)
- ~~currently not handled by stepup which makes checking footprint correctness a lot harder.~~

Edit: Adding list:
- [x] SOT-89s https://github.com/KiCad/kicad-footprints/tree/master/Package_TO_SOT_SMD.pretty
- [x] Texas_X2SON-4_1x1mm_P0.65mm.kicad_mod (https://github.com/KiCad/kicad-footprints/pull/521)
- [x] Infineon MLPQs and PQFNs at https://github.com/KiCad/kicad-footprints/tree/master/Package_DFN_QFN.pretty
- [x] Package_DFN_QFN.pretty: QFNs with odd-shape corner pads (https://github.com/KiCad/kicad-footprints/issues/658; implemented in script)
- [x] Jumper.pretty (Fix: #716)
- [x] RF_Shielding.pretty (open PR at https://github.com/KiCad/kicad-footprints/pull/890)
- [x] Coilcraft LPS4018 (https://github.com/KiCad/kicad-footprints/pull/257)

evanshultz, 2018-03-06:
If for no other reason than I would probably forget if I didn't write it down, here are a few footprints (or footprint families) that would benefit:
- SOT-89 at https://github.com/KiCad/kicad-footprints/tree/master/Package_TO_SOT_SMD.pretty
- https://github.com/KiCad/kicad-footprints/blob/master/Package_SON.pretty/TI_X2SON-4_1x1mm_P0.65mm.kicad_mod (this one also needs the prefix changed from TI_ to Texas_)
- Infineon MLPQs and PQFNs at https://github.com/KiCad/kicad-footprints/tree/master/Package_DFN_QFN.pretty

pointhi, 2018-07-01:
Lets start a list of libraries which use the old system and could profit from polygon pads:

* **Jumper.pretty** Fix: https://github.com/KiCad/kicad-footprints/pull/716
* **RF_Shielding.pretty**
* ... (please add other libraries you know)

evanshultz, 2018-07-02:
List started above.

evanshultz, 2018-09-27:
I've fixed all the outstanding items I could find above and DFN/QFN (that aren't scripted) and TO/SOT at https://github.com/KiCad/kicad-footprints/pull/981. Except for the one Wuerth SMD inductor noted in that PR where I haven't figured out how to make the footprint from FreeCAD. And Rene's PR that is modifying the RF shields.

Is there another footprint or topic that this issue should cover, or can this be closed when the aforementioned two PRs (mine + Wuerth inductor and Rene's) are merged?

evanshultz, 2019-12-12:
All of the list above is done, many of the #981 items have been merged (broken apart into separate PRs) and that includes the inductor.

Closed 2019-12-12.

Thread 283 (2018-01-21):

Invalid libraries when adding

Resaj, 2018-01-21:
I've tried to add all the libraries to my project on Kicad, but some of them are declared invalid by Kicad. These are the libraries:
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

I've seen that TODO.md includes:
- "Audio Jacks" inside "Connectors", renamed as "Connector_Audio" outside "Connectors"
- "Barrel Jacks" inside "Connectors", renamed as "Connector_BarrelJack" outside "Connectors"
- "GS (SolderJumper)" inside "Connectors", renamed as "Jumper" outside "Connectors"
- "OptoDevices" renamed as "OptoDevice"
- "TO_SOT_Packages_THT" renamed as "Package_TO_SOT_THT"

I don't know what the problem is. For more information, my SO is Ubuntu 16.04 LTS and my Kicad version is 4.0.2. And this is my PCB library table, with the paths configuration:
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

poeschlr, 2018-01-21:
This repo is intended for kicad version 5 (or the nightly builds.)

For this reason we allow rounded rectangle and polygon pads.
We will make a compatibility release later on that allows (parts of) this libs to be used in kicad version 4.

In the meantime there is a script that details which footprints are to blame and optionally remove them. More details see:
https://forum.kicad.info/t/how-can-i-install-a-specific-version-of-the-footprint-library/9269/2

Resaj, 2018-01-21:
Thanks for your fast reply! I'll keep it in mind.
If you consider it, you can close the issue.

bobc, 2018-01-23:
> This repo is intended for kicad version 5 (or the nightly builds.)

version 5 _ONLY_

That really needs to be in big letters on the front page. Currently, there is no indication anywhere apart from informal comments that the new repos are v5 _only_ and _not_ backward compatible to v4.

People in the know might realise that "for v5" means incompatible changes, but for the average user there is no reason for them to suspect that the "v5" repos are not backward compatible.

poeschlr, 2018-01-24:
I added notes to the readme files, the github.io download pages and to the repo descriptions.

I also made it more clear on the download page via the changes contained in PR https://github.com/KiCad/kicad-website/pull/264

evanshultz, 2018-02-06:
Can this be closed now?

Resaj, 2018-02-06:
I think yes. @poeschlr ?
I'll update Kicad to V5 when it is available for avoiding these problems.

Closed 2018-02-06.

Thread 290 (2018-01-22):

Fix USB_A_Horizontal.kicad_mod

andrewcharnley, 2018-01-22:
Hi,

USB_A is footprint is obviously borked. I corrected it and have attached to this post (I don't have access to git right now to do a pull).

Cheers, Andrew

[](url)
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
[USB_A_Horizontal.kicad_mod.zip](https://github.com/KiCad/kicad-footprints/files/1651479/USB_A_Horizontal.kicad_mod.zip)

poeschlr, 2018-01-22:
Well you complain about the horizontal footprint and link a datasheet for a vertical part.
The [naming convention for connectors](http://kicad-pcb.org/libraries/klc/F3.6/) has a [detailed image explaining this.](http://kicad-pcb.org/img/klc/connector_orientation.png)

There is no generic vertical usb connector in the current lib. To be honest i am not really sure we should even attempt to include generic footprints here. (I think the current generic symbols should include the manufacturer and part number information in their name.)

andrewcharnley, 2018-01-22:
Yes sorry, I've obviously forgot about a bit of work I did there.

So, USB_Vertical has the original issue (you can see the pins aren't spaced correctly). I've then copied this to make a USB_Horizontal at some point and then I'm complaining about the pins in it.

So USB_Horizontal here is correct as per the USB spec (which defines the layout) and can be used to correct USB_Vertical. It does however link to the incorrect 3dshape.

poeschlr, 2018-01-23:
The spacing might be standardized. But what about drill size, length of the oval mounting pad, height of the part (for 3d model), ...

evanshultz, 2018-01-29:
@andrewcharnley
I feel the questions raised above are closed. Can this be closed? Are you able to submit a PR to improve the libraries?

Ratfink, 2018-04-07:
Definitely the right move.  For our future reference in case this topic comes up again, the USB standards specifically say that there is *not* a standard footprint.  From the USB 2.0 standard (emphasis mine):

### 6.9 PCB Reference Drawings
The drawings in Figure 6-12, Figure 6-13, and Figure 6-14 describe typical receptacle PCB interfaces. **These drawings are included for informational purposes only.**

From the USB 3.1 standard (emphasis mine):

### 5.3.1.2 USB 3.1 Standard-A Reference Footprints
**This specification does not define standard footprints.** Any footprint may be used as long as all mechanical and electrical requirements are met. Example footprints are provided for reference only.

From the USB Type-C 1.3 standard (emphasis mine):

### 3.2.1 Interface Definition
[...]
10. **This specification does not define standard footprints.** [...]

Thread 301 (2018-01-24):

Connector_RJ/RJ12_E Problems

openelectron, 2018-01-24:
I cant seem to find a connector to fit Connector_RJ.pretty/RJ12_E.kicad_mod.

To me it looks like the mount pin holes are too small. Also, the pins seem to be in the wrong orientation as the current part could only be fitted to the opposite side of the board to the silkscreen.

Before I do a PR to fix this does anyone know why this part is this way or know a manufacturer part number for it?.

poeschlr, 2018-01-31:
As this connector does not include a datasheet link and is not named after a manufacturer part number it might be hard to find what part this is intended for. My suggestion would be to remove such generic parts and replace them with parts that include ordering information. (Naming should then follow the rule "Connectors for specific Functions" in the [Connector naming convention section of the KLC](http://kicad-pcb.org/libraries/klc/F3.6/))

In this case `RJ12_E_[Manufacturer]_[part number]`

mickaelv, 2018-03-07:
Hi @openelectron , Did you find a part matching with the RJ12e footprint ?
I think that a wrong footprint too. Not the good orientation and fixing hole are not correct.

openelectron, 2018-03-07:
@mickaelv  I never found a part. I added a new connector in #347, however it still needs some work before it can be merged.

Pwuts, 2019-10-23:
@poeschlr The only RJ12 connector in the library is now the one created in #347, but a connector that looks a lot like RJ12_E can be found [all](https://nl.aliexpress.com/item/32767485682.html) [over](https://nl.aliexpress.com/item/32948988244.html) [AliExpress](https://nl.aliexpress.com/item/32826457723.html). It doesn't seem to have a clear brand or type (every reseller gives their own name as brand name) but it is widely available and can easily be found.

What would be your suggestion for a type name in this case? I have made a footprint to its specifications and would like to send in a pull request but I have no idea what to call it.

Thread 317 (2018-01-29):

Connector_card.pretty/SD_TE_2041021.kicad_mod problems

Resaj, 2018-01-29:
I've just actualyzed my repo downloading the original, but when I execute status command, git tells I have modified the file Connector_card.pretty/SD_TE_2041021.kicad_mod problems, although I haven't touch it.

Screenshot of terminal attached. The important information of the terminal is in English.

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

evanshultz, 2018-01-29:
This footprint got merged just a few hours ago. Could you pull the repo and try again just for sanity?

Also, could you clarify what "actualyzed" means in your post? I'm sorry but I don't follow. I suspect it's just tough to translate the concept you want to communicate into English.

Resaj, 2018-01-29:
Sorry for my limited English. Maybe if I write the commands I used you'll understand the problem.

I have done this process 3 times for actualyzed my local repo and my forked repo, and all times the result has been the same:
git fetch upstream                        // Upstream is the original repo of Kicad/kicad-footprint
git checkout master                     // I want to actualyze the branch master
git merge upstream/master         // Branch master is actualyzed
All is right now, I've done this process many times in several repositories.
But... here comes the problem, when I execute this command:
git status
You can see the result in the last image. The file has changed but anybody didn't modify it.
When I execute "diff" command, terminal shows the warning line about CRLF.

I've tried to delete my local repo and clone again, also I downloaded the conflicting file from my remote repo and from the kicad original repo and substitute it in my local repo, but any of this tries hasn't resolve the problem. Always the result is that the file has changed and the line endings are CRLF. So, I think the file has been commited with bad line endings.

poeschlr, 2018-01-30:
The repo does use the gitattribute text=auto ([see git docu](https://git-scm.com/docs/gitattributes#_checking_out_and_checking_in)) which should take care of line endings. But some versions of git have known problems with that on some operating systems.

In addition we also have a travis check to prevent such files from making it into the repo. ([It did complain but because it is only a warning i missed it.](https://travis-ci.org/KiCad/kicad-footprints/builds/334784326?utm_source=github_status&utm_medium=notification))

Fix committed: https://github.com/KiCad/kicad-footprints/pull/320

evanshultz, 2018-01-30:
@Resaj Fix merged. Please check now.

Resaj, 2018-01-30:
Solved! Thanks! 👍

Closed 2018-01-30.

Thread 323 (2018-01-30):

Connector_Harwin.pretty - pin numbering and silk orientation issues

andrewteasdale, 2018-01-30:
The new _Connector_Harwin.pretty_ library does not include some corrections to pin numbering and silkscreen orientation highlighted in a previously accepted pull request (see https://github.com/KiCad/Connectors_Harwin.pretty/pull/8). For example, _LTek-Male_2x04_P2.00mm_Vertical_ is as follows in the new library:

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

Whereas it should have silkscreen and pin numbering as follows:

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

Pin numbering/orientation for this family can be found on page 7 here https://cdn.harwin.com/pdfs/C005XX_M80_and_M83_Datamate_Series_Connectors.pdf.

The same pin numbering issue is also true for the Gecko connectors, as referenced on page 4 of https://cdn.harwin.com/pdfs/C125XX_G125_Gecko_Connectors.pdf.

Assuming there was no particular reason that these corrections were not included in the new library, I'm more than happy to submit another PR to fix this.

Incidentally, we use the Harwin LTek and M80/Mixtek connectors extensively so I'd be happy to take responsibility for extending the range of Harwin connectors available in this library.

poeschlr, 2018-01-30:
The original pull request that transferred them state they where rebuild from scripts https://github.com/KiCad/kicad-footprints/pull/89

The problem is i can't seem to find the scripts in https://github.com/pointhi/kicad-footprint-generator/tree/master/scripts

I think i found them in olivers repo under https://github.com/SchrodingersGat/kicad-footprint-generator/tree/master/scripts/Harwin

oliver also has a branch called harwin-scripts. Not sure which version represents the current state of the footprints.

@SchrodingersGat could you give us a hint here?

SchrodingersGat, 2018-01-31:
The scripts on my repo should be the latest iteration (although I haven't touched them in a while). Feel free to make use of them (and improve as necessary).

Unfortunately I do not have time to help you guys with this. :)

poeschlr, 2018-01-31:
Is the one in your master branch or the one in the harwin branch more recent?

SchrodingersGat, 2018-01-31:
They appear to be the same (both 2 years old)

andrewteasdale, 2018-01-31:
Thanks - I'll get to work on making the required changes

Thread 334 (2018-02-01):

Cleanup of Package_SOIC and Package_SSOP

jkriege2, 2018-02-01:
We have the two libraries
- https://github.com/KiCad/kicad-footprints/tree/master/Package_SOIC.pretty
- https://github.com/KiCad/kicad-footprints/tree/master/Package_SSOP.pretty
that assemble packages that "look" more or less the same. The only real distinguation is (as far as I can see) that the larger pin-pitches (1.27mm/2.54mm) are mostly in SOIC while the smaller ones are in SSOP (which matches the long-name forms "SOP"/"SO"=small outline package and xSSOP=Shrink Small-Outline Package), or they are distinguished by name ("if there is a second S it goes to SSOP"?), but no real rule. Also we have some "SSO"-packages in SOIC and some in SOPs in SSOP ...

Since this seems to be a real mess, I would like to clean that up. Only I'm not yet clear on how ... Proposals would be:
1. combine them both into "Package_SO_SOP_SSOP" (or something)
2. Find a clear rule, e.g. pin-pitch >=1.27 -> SOIC, pin-pitch <1.27 -> SSOP

What do you all think? @evanshultz @poeschlr

poeschlr, 2018-02-01:
I agree the current splitting is arbitrary and confusing. One question we must ask is: "Do we have time till the v5 release to fix this?"

The name Package_SO_SOP_SSOP is quiet unwieldy. And it does not contain mention of SOIC so it might confuse users.

If we combine them i would go for something like Package_SO, Package_SO_alike, Package_xSOxx, ...
Or maybe Package_GullWing (Might combine too many different footprints)

strombom, 2018-02-01:
When is the v5 release?

Can I do anything to help?

poeschlr, 2018-02-01:
Reviewing submissions by others always helps.

Helping with fixing issues is also a good way to help.

jkriege2, 2018-02-01:
I think I can do that transition this, or next week. Basically it should be simple: We simply combine all footprints into one Directory (I like Package_SO or maybe Package_SOIC_SSOP and run a search&replace on the symbols.

Which name should we choose?

poeschlr, 2018-02-01:
Package_SOIC_SSOP has the benefit of connecting with the past. But long therm Package_SO might be better. For that reason i have a slight preference to Package_SO.

Add the change to the replace.json file. (So both Housing_SOIC and Housing_SSOP should point to the same lib.)
This is not to help your current search and replace but to have that file up to date.

strombom, 2018-02-01:
I made a pull request for the change.
https://github.com/KiCad/kicad-footprints/pull/335
https://github.com/KiCad/kicad-symbols/pull/269

Delete my pull request if you want to do it instead to ensure quality.

jkriege2, 2018-02-01:
Hi!

looks good so far. Four things are still missing (would be great if you could change those too):
1. As I noted in the footprint-PR: you need to update fp-lib-table
1. All the 3D model-pathes need to be corrected too
1. Finally we need the same PRs for the two 3D-model repos: https://github.com/KiCad/kicad-packages3D and https://github.com/KiCad/kicad-packages3D-source (3&4 combined ;-)

Best,
JAN

PS: Thanks for the effort!!!!!

strombom, 2018-02-01:
1. Updated: https://github.com/KiCad/kicad-footprints/pull/335/commits/8252156e2bb5e313670f268863a66833ed298985
2. Updated: https://github.com/KiCad/kicad-footprints/pull/335/commits/6dd463a1dfb9716647d20290250be8aae8c19ad7
3. Updated: https://github.com/KiCad/kicad-packages3D/pull/251

There were no SSOP or SOIC folders in 3D source, I assume they are all script generated?

jkriege2, 2018-02-01:
PRs look good to me ... @poeschlr @evanshultz Could you have a second look, then I (or you) can merge this ...

poeschlr, 2018-02-01:
I can look at it tomorrow. (If it has not been done until then.)

evanshultz, 2018-02-01:
@jkriege2 @poeschlr
Yeah, these look OK to me too but I'll leave them to merge by one of you so I don't cut you off from any reviewing you may want to do:
- https://github.com/KiCad/kicad-symbols/pull/269
- https://github.com/KiCad/kicad-footprints/pull/335
- https://github.com/KiCad/kicad-packages3D/pull/251

jkriege2, 2018-02-02:
@poeschlr I'll wait for you to have a look, then I will merge these this evening ... or you can immediately merge them if you're happy!

OK?
JAN

Shackmeister, 2018-07-05:
@jkriege2 @evanshultz
Is this issue finished?

Ratfink, 2018-07-05:
All the PRs referenced here are merged, and there are no libraries called Package_SOIC or Package_SSOP anymore.  I'm confident enough that this is done that I'll go ahead and close it.

Closed 2018-07-05.

Thread 336 (2018-02-01):

LFCSP-8-1EP_2x3mm_P0.5mm wrong name

jcyrax, 2018-02-01:
I think it should be names LFCSP-8-1EP_3x2mm_P0.5mm, but maybe I don't quite understand.

Are the body dimensions x/y always from orientation with pin 1 in upper left?

This is how it looks now:
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

poeschlr, 2018-02-02:
If this footprint has indeed that name in the current head than it is wrong.

Not only are the body dimensions wrong but the name should also include the size of the exposed pad.

Ratfink, 2018-03-18:
Fixed by #354.

Closed 2018-03-18.

Thread 360 (2018-02-10):

Connectors contain non-metric drill holes

eldarkg, 2018-02-10:
Like
0.65mm
0.81mm
1.016mm
1.99898mm
Should be 0.6 (or 0.7) mm, 0.8mm and 1mm and etc.
Affected libs (not full list):
Connector-IDC
Connector-Wire

poeschlr, 2018-02-10:
The only one that seems fishy is 1.99898
All others might be that way as suggested in the datasheet.

Also 0.65 is totally ok as normally fab houses have drills with differences of 0.05mm (or even finer)

eldarkg, 2018-02-10:
@poeschlr I don't think that such drill holes it is necessary in almost common cases.
This creates more drills in a board (like 1.016, 1.032, 1.042 and etc - shoud be one 1.1) - increase board cost.

My fab houses requires:
0.3, 0.4, 0.5, 0.6, 0.7, 0.8, 0.9, 1.0, 1.1, 1.2, 1.3, 1.4, 1.5, 1.6, 1.7, 1.8, 2.0, 2.1, 2.2, 2.3, 2.4, 2.5, 2.6, 2.7, 2.8, 3.0 and additional from 3.1 to 4.5 with step 0.1, and 0.25, 0.35, 0.85 и 0.95 (mm).
And up to 7-9 different drills in one board.

eldarkg, 2018-02-10:
@poeschlr Why next??? The next should be the same.

Lib Name | FP Name | Pad Size | Drill Size
--- | -------- | ------------ | -----------
Connector_IDC | IDC-Header_2x10_P2.54mm_Vertical | 1.7272 | 1.016
Connector_PinHeader_2.54mm | PinHeader_2x10_P2.54mm_Vertical | 1.7 | 1.0

eldarkg, 2018-02-10:
The KLC should reference to applicable drills set.

poeschlr, 2018-02-10:
Every user can change the footprints as they desire. The official lib will follow the datasheets.
And 0.05mm step between drill sizes is quite standard in most modern fabs. Most fabs will even round to the nearest available drill. (And now think about the pain for guys in the us. Nearly non of our drill sizes fit them.)

eldarkg, 2018-02-10:
@poeschlr I understand you.
Are any other opinions?

poeschlr, 2018-02-10:
from your previous post:
> 1.016, 1.032, 1.042 and etc - shoud be one 1.1

Here i strongly disagree. We can not state that without looking at each part separatly. It might be that the current drill is already a bit large which could mean 1mm might be a better choice. Or 1.05 maybe even 0.95. (Will all depend on the specific part)

eldarkg, 2018-02-10:
@poeschlr I'm exaggerating. But in almost common cases this is true

evanshultz, 2018-02-10:
@eldarkg
If you would be willing to compare datasheets against the footprints then we will perhaps find corrections to be made to the KiCad footprints. Otherwise, this case is speculation and subjective.

Our official library should match the datasheets exactly, unless there are extenuating circumstances. Consider the reverse: the official library deviates from the datasheet (and manufacturer recommendation) and there is a problem. That would obviously not be acceptable.

eldarkg, 2018-02-10:
@evanshultz In accordance [IDC Header datasheet](https://b2b.harting.com/files/download/PRD/PDF_TS/09185XXX324_100154466DRW008A.pdf)
Should be 1mm instead 1.016mm.

eldarkg, 2018-02-10:
@evanshultz In accordance [IDC Header with lock datasheet](https://b2b.harting.com/files/download/PRD/PDF_TS/09185XXX914_100154464DRW023A.pdf) should be 1mm instead 0.91mm.

eldarkg, 2018-02-10:
@evanshultz In accordance [IDC Header with lock horizontal](https://b2b.harting.com/files/download/PRD/PDF_TS/09185XXX903_100154464DRW016A.pdf) datasheet should be 1mm instead 0.81mm.

eldarkg, 2018-02-10:
@evanshultz SolderWirePad_3x_2mmDrill: What datasheet say you to use 1.99898mm for wire pads?!

eldarkg, 2018-02-10:
@evanshultz In accordance [PinHeader 1.27mm](https://www.mouser.com/ds/2/181/M50-353-1100851.pdf) should be 0.6mm instead 0.65mm.

poeschlr, 2018-02-10:
The solder wire says 2mm in the name. I would guess the 1.99898 is some sort of rounding error from back when the file was converted to the new mm based file format.

@Shackmeister i think you made the pin header footprints. Do you remember where you got the drill size from? (There is no datasheet in the description field)

Shackmeister, 2018-02-11:
Pretty sure I used the ones already in the script. Ill check up on it tomorrow, when im at my desk

Thread 363 (2018-02-10):

Resistor metric names

strombom, 2018-02-10:
The 2512 resistor footprint is called R_2512_6332Metric

Shouldn't the metric part be 6432?

poeschlr, 2018-02-10:
The metric names are sometimes hard to determine.
The 2512 is part of the table found in http://kicad-pcb.org/libraries/klc/F3.1/ This table is copied from wikipedia.

strombom, 2018-02-10:
Maybe wikipedia is wrong?

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

poeschlr, 2018-02-10:
I did not question this list but i looked at many other sizes and found there seem to be different conventions used. If you think this one should be 6432 then you can change it. (As other imperial codes with 25 in them use 64 as the metric equivalent, this might really be the case.)

The footprint generator is found in https://github.com/pointhi/kicad-footprint-generator/tree/master/scripts/SMD_chip_package_rlc-etc.
But you will also need to change the table on the website and the 3d models.

strombom, 2018-02-10:
Ok, looking at the script, they are referencing an IPC document that actually say that the metric name is 6332. So I guess it's Digikey, Rohm, Panasonic and Yageo that are wrong, a little bit frustrating :)

KarlZeilhofer, 2020-07-16:
I stumbled on this issue too now.

Farnell finds 9000 parts with 6432 and zero parts with 6332.
It makes more sense, due to the 2:1 apsect ratio.

Please reopen this issue.

Closed 2018-02-21.

Thread 374 (2018-02-15):

Missing footprints for STM32 microcontrollers

Ratfink, 2018-02-15:
Now that https://github.com/KiCad/kicad-symbols/pull/305 and https://github.com/KiCad/kicad-library-utils/pull/212 have been merged, there are quite a few missing footprints needed for the STM32 microcontroller family.  Below is a list of the needed footprints, with links to datasheets that contain package/footprint drawings.  Naming for WLCSP footprints follows the suggestion [here](https://github.com/KiCad/Housings_CSP.pretty/issues/8#issuecomment-325613650), but without the ball pitch because the packages are already uniquely identified without it.

- [x] Package_BGA:LFBGA-100_10x10mm_Layout10x10_P0.8mm: http://www.st.com/st-web-ui/static/active/en/resource/technical/document/datasheet/CD00161566.pdf
- [x] Package_BGA:LFBGA-144_10x10mm_Layout12x12_P0.8mm: http://www.st.com/st-web-ui/static/active/en/resource/technical/document/datasheet/CD00191185.pdf
- [x] Package_BGA:TFBGA-64_5x5mm_Layout8x8_P0.5mm: http://www.st.com/st-web-ui/static/active/en/resource/technical/document/datasheet/CD00251732.pdf
- [x] Package_BGA:TFBGA-100_8x8mm_Layout10x10_P0.8mm: http://www.st.com/st-web-ui/static/active/en/resource/technical/document/datasheet/DM00166116.pdf
- [x] ~~Package_BGA:TFBGA-216_16x16mm_Layout15x15_P0.8mm~~ Package_BGA:TFBGA-216_13x13mm_Layout15x15_P0.8mm http://www.st.com/st-web-ui/static/active/en/resource/technical/document/datasheet/DM00071990.pdf
- [x] Package_BGA:TFBGA-265_14x14mm_Layout17x17_P0.8mm: http://www.st.com/st-web-ui/static/active/en/resource/technical/document/datasheet/DM00387108.pdf
- [x] Package_BGA:UFBGA-64_5x5mm_Layout8x8_P0.5mm: http://www.st.com/st-web-ui/static/active/en/resource/technical/document/datasheet/DM00039193.pdf
- [x] Package_BGA:UFBGA-100_7x7mm_Layout12x12_P0.5mm: http://www.st.com/st-web-ui/static/active/en/resource/technical/document/datasheet/DM00098745.pdf
- [x] Package_BGA:UFBGA-132_7x7mm_Layout12x12_P0.5mm (exists, but should be renamed with Layout): http://www.st.com/st-web-ui/static/active/en/resource/technical/document/datasheet/DM00111457.pdf
- [x] Package_BGA:UFBGA-144_7x7mm_Layout12x12_P0.5mm: http://www.st.com/st-web-ui/static/active/en/resource/technical/document/datasheet/DM00141306.pdf
- [x] Package_BGA:UFBGA-144_10x10mm_Layout12x12_P0.8mm: http://www.st.com/st-web-ui/static/active/en/resource/technical/document/datasheet/DM00213872.pdf
- [x] Package_BGA:UFBGA-169_7x7mm_Layout13x13_P0.5mm: http://www.st.com/st-web-ui/static/active/en/resource/technical/document/datasheet/DM00071990.pdf
- [x] Package_BGA:UFBGA-201_10x10mm_Layout15x15_P0.65mm: http://www.st.com/st-web-ui/static/active/en/resource/technical/document/datasheet/CD00237391.pdf
- [x] Package_DFN_QFN:QFN-28_4x4mm_P0.5mm: http://www.st.com/st-web-ui/static/active/en/resource/technical/document/datasheet/DM00104043.pdf
- [x] Package_DFN_QFN:QFN-48-1EP_7x7mm_P0.5mm_EP5.6x5.6mm: http://www.st.com/st-web-ui/static/active/en/resource/technical/document/datasheet/DM00105814.pdf
- [x] Package_DFN_QFN:QFN-36-1EP_6x6mm_P0.5mm_EP4.1x4.1mm: http://www.st.com/st-web-ui/static/active/en/resource/technical/document/datasheet/CD00210837.pdf
- [x] Package_CSP:ST_WLCSP-25_Die425: http://www.st.com/st-web-ui/static/active/en/resource/technical/document/datasheet/DM00140359.pdf
- [x] Package_CSP:ST_WLCSP-25_Die444: http://www.st.com/st-web-ui/static/active/en/resource/technical/document/datasheet/DM00104043.pdf
- [x] Package_CSP:ST_WLCSP-25_Die457: http://www.st.com/st-web-ui/static/active/en/resource/technical/document/datasheet/DM00206508.pdf
- [x] Package_CSP:ST_WLCSP-36_Die417: http://www.st.com/st-web-ui/static/active/en/resource/technical/document/datasheet/DM00108217.pdf
- [x] Package_CSP:ST_WLCSP-36_Die440: http://www.st.com/st-web-ui/static/active/en/resource/technical/document/datasheet/DM00039193.pdf
- [x] Package_CSP:ST_WLCSP-36_Die445: http://www.st.com/st-web-ui/static/active/en/resource/technical/document/datasheet/DM00105814.pdf
- [x] Package_CSP:ST_WLCSP-36_Die458: http://www.st.com/st-web-ui/static/active/en/resource/technical/document/datasheet/DM00214043.pdf
- [x] Package_CSP:ST_WLCSP-49_Die423: http://www.st.com/st-web-ui/static/active/en/resource/technical/document/datasheet/DM00086815.pdf
- [x] Package_CSP:ST_WLCSP-49_Die431: http://www.st.com/st-web-ui/static/active/en/resource/technical/document/datasheet/DM00115249.pdf
- [x] Package_CSP:ST_WLCSP-49_Die433: http://www.st.com/st-web-ui/static/active/en/resource/technical/document/datasheet/DM00102166.pdf
- [x] Package_CSP:ST_WLCSP-49_Die435: http://www.st.com/st-web-ui/static/active/en/resource/technical/document/datasheet/DM00257211.pdf
- [x] Package_CSP:ST_WLCSP-49_Die438: http://www.st.com/st-web-ui/static/active/en/resource/technical/document/datasheet/DM00092070.pdf
- [x] Package_CSP:ST_WLCSP-49_Die439: http://www.st.com/st-web-ui/static/active/en/resource/technical/document/datasheet/DM00093332.pdf
- [x] Package_CSP:ST_WLCSP-49_Die447: http://www.st.com/st-web-ui/static/active/en/resource/technical/document/datasheet/DM00141133.pdf
- [x] Package_CSP:ST_WLCSP-49_Die448: http://www.st.com/st-web-ui/static/active/en/resource/technical/document/datasheet/DM00098745.pdf
- [x] Package_CSP:ST_WLCSP-63_Die427: http://www.st.com/st-web-ui/static/active/en/resource/technical/document/datasheet/DM00048356.pdf
- [x] Package_CSP:ST_WLCSP-64_Die414: http://www.st.com/st-web-ui/static/active/en/resource/technical/document/datasheet/CD00191185.pdf
- [x] Package_CSP:ST_WLCSP-64_Die427: http://www.st.com/resource/en/datasheet/stm32l152zc.pdf
- [x] Package_CSP:ST_WLCSP-64_Die435: http://www.st.com/st-web-ui/static/active/en/resource/technical/document/datasheet/DM00257211.pdf
- [x] Package_CSP:ST_WLCSP-64_Die436: http://www.st.com/st-web-ui/static/active/en/resource/technical/document/datasheet/DM00034689.pdf
- [x] Package_CSP:ST_WLCSP-64_Die441: http://www.st.com/st-web-ui/static/active/en/resource/technical/document/datasheet/DM00213872.pdf
- [x] Package_CSP:ST_WLCSP-64_Die442: http://www.st.com/st-web-ui/static/active/en/resource/technical/document/datasheet/DM00115237.pdf
- [x] Package_CSP:ST_WLCSP-64_Die462: http://www.st.com/st-web-ui/static/active/en/resource/technical/document/datasheet/DM00340475.pdf
- [x] Package_CSP:ST_WLCSP-66_Die411: http://www.st.com/st-web-ui/static/active/en/resource/technical/document/datasheet/CD00237391.pdf
- [x] Package_CSP:ST_WLCSP-66_Die432: http://www.st.com/st-web-ui/static/active/en/resource/technical/document/datasheet/DM00101621.pdf
- [x] Package_CSP:ST_WLCSP-72_Die415: http://www.st.com/st-web-ui/static/active/en/resource/technical/document/datasheet/DM00108832.pdf
- [x] Package_CSP:ST_WLCSP-81_Die415: http://www.st.com/st-web-ui/static/active/en/resource/technical/document/datasheet/DM00108832.pdf
- [x] Package_CSP:ST_WLCSP-81_Die421: http://www.st.com/st-web-ui/static/active/en/resource/technical/document/datasheet/DM00141306.pdf
- [x] Package_CSP:ST_WLCSP-81_Die463: http://www.st.com/st-web-ui/static/active/en/resource/technical/document/datasheet/DM00282249.pdf
- [x] Package_CSP:ST_WLCSP-90_Die413: http://www.st.com/st-web-ui/static/active/en/resource/technical/document/datasheet/DM00037051.pdf
- [x] Package_CSP:ST_WLCSP-100_Die422: http://www.st.com/st-web-ui/static/active/en/resource/technical/document/datasheet/DM00094064.pdf
- [x] Package_CSP:ST_WLCSP-100_Die446: http://www.st.com/st-web-ui/static/active/en/resource/technical/document/datasheet/DM00118585.pdf
- [x] Package_CSP:ST_WLCSP-100_Die452: http://www.st.com/st-web-ui/static/active/en/resource/technical/document/datasheet/DM00330506.pdf
- [x] Package_CSP:ST_WLCSP-100_Die461: http://www.st.com/st-web-ui/static/active/en/resource/technical/document/datasheet/DM00284211.pdf
- [x] Package_CSP:ST_WLCSP-104_Die437: http://www.st.com/resource/en/datasheet/stm32l152ze.pdf
- [x] Package_CSP:ST_WLCSP-143_Die419: http://www.st.com/st-web-ui/static/active/en/resource/technical/document/datasheet/DM00071990.pdf
- [x] Package_CSP:ST_WLCSP-143_Die449: http://www.st.com/st-web-ui/static/active/en/resource/technical/document/datasheet/DM00166116.pdf
- [x] Package_CSP:ST_WLCSP-144_Die470: http://www.st.com/st-web-ui/static/active/en/resource/technical/document/datasheet/DM00366448.pdf
- [x] Package_CSP:ST_WLCSP-168_Die434: http://www.st.com/st-web-ui/static/active/en/resource/technical/document/datasheet/DM00219980.pdf
- [x] Package_CSP:ST_WLCSP-180_Die451: http://www.st.com/st-web-ui/static/active/en/resource/technical/document/datasheet/DM00273119.pdf

poeschlr, 2018-04-25:
I assume the TFBGA-216_16x16mm_Layout15x15_P0.8mm: should be 13x13mm. If so you can tick it off. otherwise the 16x16mm version is still missing

Ratfink, 2018-04-25:
I just checked all the relevant datasheets, and yes, that is indeed an error.  Thanks for catching it!  I'll make a PR to fix the symbols momentarily.

poeschlr, 2018-04-26:
So looks like we got all of them. Which libs in https://github.com/KiCad/kicad-symbols/issues/520 should now be fixed (if any)?

Ratfink, 2018-04-26:
With this done, all the MCU_ST_STM32* libraries have correct footprint associations.  Thanks for reviewing all of the footprints!

Closed 2018-04-26.

Thread 377 (2018-02-15):

Asymmetric varistor footprints

aimylios, 2018-02-15:
All of the varistor footprints have been converted to be "polarized" (i.e. Pin 1 has a rectangular instead of a circular pad) as part of PR #48 (see commit 2e41670).

I do not understand why this change was made. Although [KLC F7.3](http://kicad-pcb.org/libraries/klc/F7.3/) states that "Through hole components should set the shape of Pin 1 to Rectangular" it also includes an exception: "Non polarized parts (such as THT resistors) should not set the shape of Pin 1 to Rectangular. For these (non polarized) footprints, all pad shapes should be consistent."

Varistors are non-polarized devices, and their package is (usually) fully symmetric. Unless there is a valid reason to have asymmetric footprints I would request to revert commit 2e41670. If the maintainers agree I can also submit a pull request to do this.

Ratfink, 2018-03-05:
I agree, varistors are not polarized devices, so making pin 1 rectangular doesn't make sense.  I'm in favor of reverting the commit in question.

evanshultz, 2018-03-05:
The existing footprints were moved from the old repo to the new one in the PR above, among other things. Changing to a rect pin 1 was not the only thing done in that commit, and the commit should not be reverted (because the commit was NOT only changing pin 1's shape).

@aimylios
Thanks for catching this! You are correct that varistors are not polarized and I'd welcome a new PR that corrects the footprints to have all circular pads. Are you willing to do that?

Ratfink, 2018-03-05:
How do you mean, it wasn't only changing pin 1's shape?  I looked through the diff for commit  2e41670373493a62d1f8f3876b11526354db669e, and I see nothing other than changing "circle" to "rect" for pad 1 of every footprint in Varistor.pretty.  PR #48 as a whole did a lot more than that, but we're only talking about undoing one commit, not the whole PR. 🙂

evanshultz, 2018-03-05:
Oh. Yes. My mistake. I'll blame it on reviewing too many PRs lately.

@Ratfink You want to revert with your newfound powers?

Ratfink, 2018-03-05:
Well, git can't figure out how to revert the commit, so I've done it slightly less automatically and submitted it as #411.

aimylios, 2018-03-05:
Thanks for all of your comments! I didn't expect so much activity after more than two weeks of silence.
And thank you @Ratfink for taking care of this. PR #411 looks good, please merge!

Closed 2018-03-05.

Thread 393 (2018-02-23):

Some THT resistor footprints have wrongly placed fab drawings.

poeschlr, 2018-02-23:
I noticed that some tht resistor footprints have their fab outline on the wrong position.
Some examples:
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

There are also some where the courtyard does not quite fit. (For these it seems that not only the fab outline is placed wrong but also the silk outline.)
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

jkriege2, 2018-02-23:
fix available here: https://github.com/KiCad/kicad-footprints/pull/394

Closed 2018-03-01.

Thread 396 (2018-02-26):

5.0.0-rc1 repository unusable on Linux

calebns, 2018-02-26:
After cloning the fresh repo, the git sees that the file WDFN-8-2x2mm is not staged for commit.
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

It seems that it contains invalid line endings which makes the Linux git to interpret the file as being changed. What suprises me, the git-2.7.4 gets crazy at this point and refuses to either check out anything or to unstage/revert changes to that file.
The following patch fixes the issue by removing 0xD character from line endings, i.e. makes the line endings compatible with the one found in other files.

[0001-test.log](https://github.com/KiCad/kicad-footprints/files/1760029/0001-test.log)

jkriege2, 2018-02-26:
could you please open  a PR for the fix you proposed?

Thanks,
JAN

poeschlr, 2018-02-27:
Fix merged

Closed 2018-02-27.

Thread 417 (2018-03-08):

Add missing footprints for Atmel MCUs

fauxpark, 2018-03-08:
Follows KiCad/kicad-symbols#340.

There are a number of missing QFN footprints for some Atmel MCUs. These should be based on [Atmel Appnote 8826](http://ww1.microchip.com/downloads/en/AppNotes/Atmel-8826-SEEPROM-PCB-Mounting-Guidelines-Surface-Mount-Packages-ApplicationNote.pdf).

- [ ] Package_DFN_QFN:DFN-10-1EP_3x3mm_P0.5mm_EP1.75x2.7mm (1)
- [ ] Package_DFN_QFN:QFN-20-1EP_3x3mm_P0.45mm_EP1.6x1.6mm (4)
- [ ] Package_DFN_QFN:QFN-20-1EP_4x4mm_P0.5mm_EP2.25x2.25mm (9)
- [ ] Package_DFN_QFN:QFN-28-1EP_4x4mm_P0.45mm_EP2.25x2.25mm (2)
- [ ] Package_DFN_QFN:QFN-32-1EP_4x4mm_P0.4mm_EP2.9x2.9mm (1)
- [ ] Package_DFN_QFN:QFN-32-1EP_5x5mm_P0.5mm_EP3.8x3.8mm (13)
- [ ] Package_DFN_QFN:QFN-32-1EP_7x7mm_P0.65mm_EP4.65x4.65mm (2)
- [ ] Package_DFN_QFN:QFN-44-1EP_7x7mm_P0.5mm_EP5.2x5.2mm (13)
- [ ] Package_DFN_QFN:QFN-44-1EP_7x7mm_P0.5mm_EP5.4x5.4mm (2)
- [ ] Package_DFN_QFN:QFN-64-1EP_9x9mm_P0.5mm_EP7.25x7.25mm (22)

evanshultz, 2018-03-26:
Footprint submitted at https://github.com/KiCad/kicad-footprints/pull/434.

Closed 2018-03-26.

Thread 436 (2018-03-17):

How to name footprints missing a single pin?

evanshultz, 2018-03-17:
@poeschlr @jkriege2 @Ratfink @Misca1234
Started from a conversation at https://github.com/KiCad/kicad-symbols/pull/322.

Some parts are missing a pin. In some cases the footprint for the part will be manufacturer-specific. But in other cases it's not, or it doesn't make sense to do that because it would result in multiple footprints which are otherwise identical.

Let me take the common DIP8 package as an example and show some datasheets with a missing pin:
- http://www.onsemi.com/pub/Collateral/NCP1076A-D.PDF: either pin 3 or pin 6
- https://ac-dc.power.com/system/files_force/product-docs/tinyswitch-iii_family_datasheet.pdf: pin 3
- https://www.mouser.com/ds/2/328/lnk520-5820.pdf: pin 6
- http://www.st.com/content/ccc/resource/technical/document/datasheet/cd/d4/93/15/03/e1/40/81/CD00279018.pdf/files/CD00279018.pdf/_jcr_content/translations/en.CD002790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: pin 6
- https://www.infineon.com/dgdl/Infineon-ICE3AR0680VJZ-DS-v02_01-en.pdf?fileId=db3a304341e0aed00141ffe31ad53057 pin 6
- http://www.onsemi.com/pub/Collateral/NCP1216-D.PDF: pin 7
- http://rohmfs.rohm.com/en/products/databook/datasheet/ic/power/isolated_converter/bm2pxx2-e.pdf pin 6
- http://www.onsemi.com/pub/Collateral/NCP1337-D.PDF: pin 7
- https://www.diodes.com/assets/Datasheets/AP3983BCD.pdf: pin 7
- https://www.dialog-semiconductor.com/sites/default/files/iw1818_product_summary.pdf: pin 6
- https://www.diodes.com/assets/Datasheets/AP3983BCD.pdf: pin 7

We would need at least three, and possibly up to six, footprints for the parts above. Three with pin numbers up to 8 but missing pin 3, or 6, or 7, and another three with pin numbers up to 7 and missing the same three pins.

For packages with hidden or deleted pads according to IPC 7351, footprint names would be `DIP-8-7_W7.62mm` or `DIP-7-8_W7.62mm`. We would then need a way to capture the missing pins as there is no way to differentiate which pin is missing.

I see two ways this could be done, using one example:
1.  `DIP-8-7_W7.62mm_N7` where `N7` is the nomenclature for pin 7 being removed
2.  `DIP-8-7-N7_W7.62mm`

Does anyone have a preference? I think they're both equally easy to parse in a footprint filter. I like option 2 better because the pin information stays together, but I could be swayed.

Also, I notice at https://github.com/KiCad/kicad-footprints/tree/master/Package_DIP.pretty there are DIP6 footprints with pin 5 missing. Once this settles, they may not conform and may need to be renamed (and perhaps fixes to the symbol using those footprints).

Ratfink, 2018-03-17:
Option 2 looks like the most reasonable choice to me.  I see a bit of inconsistency with current KLC naming though, I'd think it should be `DIP-7-8-N7-W7.62mm` to minimize the change.

evanshultz, 2018-03-17:
See the sections for hidden pins and deleted pins in IPC 7351 Land Pattern Naming Conventions, as mentioned above. I don't know why Oliver only put one of them in KLC but it's a omission. This is the nomenclature that will account for having the highest pin number be 7 or 8.

Though if the highest pin number is 7 there isn't a pin that can be removed.

Now that I read IPC7351 carefully again it's actually saying `DIP-8_7N_xxxx`, with an underscore and a `N`. It still doesn't specify which pin is missing, and adding `N7` or `N6` in there looks even more ugly. Of course we don't have to strictly follow IPC.

evanshultz, 2018-03-17:
https://github.com/KiCad/kicad-footprints/pull/405 is a footprint where we used a subset of the pin numbers to make it work. In this case we went manufacturer-specific, but it's just another example.

poeschlr, 2018-03-17:
Option 3 looks good enough for me. (I am sure there will be some strange case that we can not represent with it but we can look into that once we are that far.)

Option 2 would also work but it seems to have redundant information and it looks quite strange. (But it would be more compatible with what we currently have.)

Ratfink, 2018-03-17:
You're right, option 3 does contain all the necessary information, and is the most concise.  It may require changing some footprint filters though.  As long as we have a way to find all the symbols that would need updating for the new naming convention, I'd be happy with option 3.

evanshultz, 2018-03-19:
OK. I'm fine with that for a symbol/footprint that uses up to pin number 8 in the example above. I think IPC would actually want to name it `DIP-7-8N_W7.62mm`, but that doesn't catch the exact pin that's missing. Option 3 is more concise and intelligent.

But what do we do for symbols/footprints that skip the missing pin so the highest pin number used in the datasheet is 7? Perhaps we force them to use the convention above, as I believe there's only a few and can be handled on a case-by-case basis? Any better ideas?

evanshultz, 2018-05-31:
See http://www.analog.com/media/en/technical-documentation/data-sheets/3638fa.pdf submitted at https://github.com/KiCad/kicad-symbols/pull/637. There's an example where multiple pins are missing and we didn't settle on a scheme above. Any thoughts?

I don't find the package drawing by itself online (I could have missed it) but the full-pin version is at http://www.analog.com/media/en/package-pcb-resources/package/pkg_pdf/ltc-legacy-msop/05081667_F_MSE16.pdf.

Perhaps in that case we go manufacturer-specific can use `Analog_MSE16-12` or something (since ADI bought LT, or else stick with `Linear_*`)?

Misca1234, 2018-06-10:
By making these stray foot prints manufacture specific (as stated above) there will be no problem by the naming convention.

Another way would be to keep the naming convention and just prefix or suffix to indicate something is different with it.
Like this
DIP_VX-8-7-W7.62mm
DIP-8-7-W7.62mm_VX

Where X can be a leap number for each of the foot prints that have various missing pins

Thread 439 (2018-03-19):

KLC: Silkscreen-to-pad clearance?

evanshultz, 2018-03-19:
https://github.com/KiCad/kicad-footprints/pull/354 fixed a footprint by pushing silk lines farther from the pads.

[KLC F5.1.2](http://kicad-pcb.org/libraries/klc/F5.1/) requires at least 0.2mm clearance. IPC 7351C is [recommending the silk line width](http://www.ocipcdc.org/archive/What_is_New_in_IPC-7351C_03_11_2015.pdf) clearance from pads, which would be a minimum of 0.12mm (KLC allows some deviation but I believe almost all footprints are 0.12mm silk line width).

Should KLC be updated? Move the minimum from 0.2mm to 0.12mm in accordance with IPC 7351C?

Ratfink, 2018-03-19:
The main thing that PR was fixing was the reversed X and Y dimensions in the footprint name.  But you're right, it also moved the silkscreen lines, as they were very close to the pads.  They would have been too close by the rule you're suggesting as well; the current rule just made them need a bit extra clearance.

Here's the discussion from the old kicad-library repository that resulted in this KLC rule in the first place: https://github.com/KiCad/kicad-library/issues/1422

I notice that you mentioned the same thing in the old discussion also, but that was mostly ignored after 0.2 mm was suggested.  I'm certainly not opposed to revising the rule to allow the reduced clearance recommended by IPC, just so long as it's done in a backwards-compatible way.

poeschlr, 2018-03-22:
The current silk-pad clearance did not come from IPC recommendations. We choose 0.2mm as we could then use a "feature" of kicad 4.x to easily check it. (Kicad 4.x and at least older nightlies shows the mask clearance in the opengl canvas of footprint editor as 0.2mm by default.) And because this is compatible with the fab i use.

If we want to update the KLC i would suggest to (for now) add either a range or document that old footprints used 0.2mm.
If we go with the allowed range we could specify some relation between part size and clearance. As for larger parts i think it is possible to have a larger clearance while still having well defined silk without resulting in a much larger covered area.

Thread 444 (2018-03-20):

Footprint not linked with last packages3D version

hildogjr, 2018-03-20:
Recently the packages3D folder has been restructured. The most part of the footprint not load the 3D visualization because of error in the '3D Shape Name' file.

poeschlr, 2018-03-20:
Could you give at least one example?

As far as i know most 3d models in the [packages3d repo](https://github.com/KiCad/kicad-packages3D) should be correct. The old kicad-library repo is not indented to work with the new footprint organization as it is used to keep the kicad 4 legacy state unchanged.

hildogjr, 2018-03-20:
Yes.
I am using the (last) nightly version of KiCad. If I add a 0805 capacitor, the 3D Shape file is `Capacitors_SMD.3dshapes/C_0805.wrl`, but the correct had to be `${KISYS3DMOD}/Capacitor_SMD.3dshapes/C_0805_2012Metric.step`.
The same is happening with resistors.
This started when the 3D package started to be distributed as a `kicad-package` on Ubuntu, separated from `kicad-footprint`.
Do I have to force update some package?

jkriege2, 2018-03-20:
seems like you need to update your footprint lib. The SMD-C/R/L fotprints have been renamed to contain the metric sice too!

hildogjr, 2018-03-20:
I `apt purge kicad`, manually delete the `usr\share\kicad\` (with all libraries) and re-install, but appear the same.
There is some procedure that I miss?

jkriege2, 2018-03-20:
simply clone the GitHub repo to your local computer and use that. Then you should have the correct footprint files.

hildogjr, 2018-03-20:
I did, delete the `\usr\share\kicad\library'`, `modules` and `modules\packges3D`. But the error still.
On my "PCB Library Tables", each one is configured a `${KIGITHUB}/*.pretty`, with the variable `KIGITHUB`as `https://github.com/KiCad`. This is a tip that help?

hildogjr, 2018-03-20:
I try update `fp-lib-table` using [this in Git](https://github.com/KiCad/kicad-library/edit/master/template/fp-lib-table.for-pretty) but, this file are using `Capacitors_SMD.pretty` instead `Capacitor_SMD.pretty` and other  issues.

jkriege2, 2018-03-20:
You can simply clone the three required repositories
- optional for you: https://github.com/kicad/kicad-symbols
- https://github.com/kicad/kicad-footprints
- https://github.com/KiCad/kicad-packages3D

to the locations that the environment variables KICAD_SYMBOL_DIR, KISYSMOD and KISYS3DMOD point to. Then, if your project has a fp-lib-table (and if you updated the symbols a sym-lib-table) you should update those with the ones supplied in GIT. Then it should work with a current nightly build.

Did that help?
JAN

hildogjr, 2018-03-20:
Yes, I did this, had have this message when start Pcbnew:

    [3D File Resolver] No such path; ensure the environment var is defined
    /usr/share/kicad/modules/packages3d/Capacitor_SMD.3dshapes/C_0805_2012Metric.wrl

But now, I found the problem. The default defined folder for `${KISYS3DMOD}` in KiCad is

   /usr/share/kicad/modules/packages3d/

And the correct is

    /usr/share/kicad/modules/packages3D

The why:
1) Linux is case sensitive;
2) I don't know why had the final `/`, but cause a problem when use `${KISYS3DMOD}/...`.

poeschlr, 2018-03-22:
A bit late but here an explanation why you have had problems:

nightlies (for ubuntu at least) already use the correct files (from the version 5 repos) and should put them into the correct place in your file system. But they do not update the fp-lib-table.

This was a conscious decision. KiCad can not know if you have personal libs in the fp-lib-table or if you deleted libs on purpose from it. It is expected that nightly users know how kicad works and follow the mailing list/bug tracker. (Everything you had problems with had been announced there.)

The final / in the path normally should not make problems. (At least not in ubuntu nightlies)

hildogjr, 2018-03-22:
Yes.
Because this, I deleted the `*-li-table` of my $HOME and start KiCad as the first time. So it ask me to create the default table file. This problem was, maybe, residual from last installations that `apt-get` could not update.
The only "issue" really was that the folder here in the Git is `packages3D` and the default configuration on KiCad is `packages3d\`. So, removing `\` and changing to uppercase `D` worked fine.

Closed 2018-03-20.

Thread 449 (2018-03-21):

Why not use IPC footprint names in v5?

mkschreder, 2018-03-21:
I can not understand why kicad has to go against the guidelines for footprint naming convention that have been well defined for years and name all footprints using semi-arbitrary custom names.

What I mean is for example the IPC-7351B standard footprint naming convention for SMT parts: http://cxem.net/comp/files/comp149_Footprint-Naming-Convention_-Surface-Mount-Components.pdf

These nming conventions have standard identifiers for virtually all standard parts along with recommendations for naming custom parts.

So why are we not using them for all new footprints?

mkschreder, 2018-03-21:
For example footprints for qfn would then have following standard convention: https://www.pcb-3d.com/?s=qfn&post_types=models

mkschreder, 2018-03-21:
Here is a very detailed document: https://www.pcb-3d.com/wordpress/wp-content/uploads/ipc-sm-782a_amendment_1_and_2.pdf

I'm going to look into generating all of these automatically. That would be really cool. Imagine just typing an ipc name and getting a footprint without any libraries.

jkriege2, 2018-03-21:
I think there are/were several reasons for choosing the naming scheme:
1. main argument was: our naming scheme is more verbose (e.g. it contains units, it names the numbers that are given (with few exceptions only, many parts are easily human-readable even without looking up, what e.g. "P" stands for ... maybe pitch? or pin?)
1. It's possibly easier for newbies (not electronics experts) to learn/understand
1. It make construction of FPFilters easier (which are an important feature right now in KiCAD)

I'm sure there were more arguments and a discussion can be dug out somewhere ...

Best,
JAN

mkschreder, 2018-03-22:
Jan, I believe IPC allows you to add extra text after the main footprint name without violating the standard. So I don't see why we can not have both. The standard name is just there to allow scripted creation of the whole footprint from just the name data.

I think a better solution however would be to make filters work on documentation files that can contain more information. Alternatively extra footprint fields that describe the footprint. I have done a few initial tests on parsing and generating footprints from ipc names and my current solution for resistors basically parses the size out of the ipc name and then generates several footprints based on density (L M or N) requirements. The input is just a list of IPC footprints as CSV.

I think the ideal scenario would be that all standard footprints would be generated from a single csv file that contains ipc names and possibly minimal extra information about the footprint such as stuff that goes into the doc string. Adding new footprints would then be just a matter of adding a single line to the csv file. We could also offer an ipc footprint creation wizard further down the line that would allow one to generate standard footprints with a graphical interface. But I think the most basic first step would be to have support for generating all ipc footprints just from the IPC string.

poeschlr, 2018-03-22:
There will be no further changes possible before the v5 release (not enough time) The discussion about footprint naming was in the summer you could have chimed in back then.

---

We have the same data in the footprint names as IPC also has. (Formatted a bit differently to make it more human readable. Human readability is one of the core ideologies of kicad.)

---

As we (the maintainers) do not have official access to ipc standards we really can not know if any of the footprints are complaint with a particular density level. So even if a contributor states that a particular footprint complies with some IPC standard we can not check if this is true.

For this reason it would be unwise to give the impression that the lib is complaint to IPC. (We try to align our rules to it as far as we can.)

Ratfink, 2018-05-04:
Closing, because the original question was answered by the library admin and there has been no further discussion for over a month.  If we wish to re-consider this topic for the KiCad 6 development cycle, we can open a new issue then.

Closed 2018-05-04.

Thread 462 (2018-03-31):

KLC: Silk under SMT part bodies

evanshultz, 2018-03-31:
@poeschlr @jkriege2 @Ratfink @Misca1234 @Shackmeister
From  https://github.com/KiCad/kicad-footprints/pull/442.

I think KLC needs a bit of clarification about silk going under pads. Perhaps it can be allowed if the package body does not touch the PCB. If the purpose is to prevent silk affecting coplanarity, this does not apply if the part body does not touch the PCB surface where the silk is.

If we still don't want silk under the body, even if the body doesn't touch the PCB, that's OK. But would you also look at the silk pin 1 mark for BGAs and see if there's a standard style we want to adopt? Please take a look at the IPC doc I linked in the PR above.

Ratfink, 2018-03-31:
I agree that it shouldn't be a problem to have silkscreen under a surface mount device where the body doesn't touch the board.  This could also allow silkscreen lines under gull-wing leads in some footprints.  Frankly, I thought this rule was a bit too strict ever since KLC 1.0.

With regards to BGA ball A1 style, I'd prefer the suggestion of removing the silk lines on both sides at the corner, but I wouldn't object to putting a chamfer under the corner if others prefer.

evanshultz, 2018-03-31:
For ease of reference, here is the IPC doc: http://www.ocipcdc.org/archive/What_is_New_in_IPC-7351C_03_11_2015.pdf#page=17 (pages 17, 19, 22).

I like removing both sides in the pin A1 corner too. If the other librarians agree I'll volunteer to make the changes to those footprints.

And KLC should also be updated for both items: silk can be under a SMT body if the body doesn't touch the PCB surface, and also provide an example of our preferred BGA pin 1 silk mark. @poeschlr how do you want to handle KLC updates? Oliver would usually make the updates himself, sometimes after soliciting feedback for proposed wording. I feel there are quite a number of KLC updates discussed here and there but few updates have been made recently. What method do you prefer to make KLC updates?

poeschlr, 2018-04-02:
I am not really sure i understand the proposed silk marker for bgas. could one of you post a screenshot that shows the newly proposed look?

Ratfink, 2018-04-02:
@poeschlr I'm at the wrong computer right now to make an example footprint, but it would be like this image, except both silkscreen lines would be cut back at the top left corner instead of just the one.

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

poeschlr, 2018-04-02:
Why would this need a KLC change about allowing silk below the part? Or is this a different unrelated topic?

Ratfink, 2018-04-02:
It's a semi-related topic, because another alternative BGA pin-1 mark on page 17 of [this PDF](http://www.ocipcdc.org/archive/What_is_New_in_IPC-7351C_03_11_2015.pdf#page=17) shows a silkscreen line going under the BGA at the corner.  That shouldn't actually cause any problems because the BGA doesn't sit directly on the board.  Making this KLC change would also allow for more solid silkscreen outlines for e.g. DPAK footprints and the switch footprint in #438.

poeschlr, 2018-04-02:
My main concern is that it will require more work by us maintainers. With the previous rule we simply checked for all smt parts if there is silk below the part. Now we need to look at the datasheet and check if the part is touching the surface of the pcb.

I am reluctant to go along with this unless somebody can show a footprint that would really benefit from it. (A screenshot would be best)

We then need an easy to communicate rule. In detail what does "touching" the surface mean in detail. (what is the minimum distance between the body and the pcb.)

evanshultz, 2018-04-02:
KLC says no silk under SMT parts. So if that was allowed, KLC would need to be changed. But I don't think it's incredibly important to do that, just asking since IPC is showing it in 7351C.

However, my original suggestion was to standardize the BGA pin 1 silk mark by cutting back both corners near pin A1. IPC 7351C does recommended cutting back silk so this is still in line with their recommendations. In the current library there are many styles for silk pin 1 mark on BGAs. Currently, KLC does not show a BGA in section [F5.1](http://kicad-pcb.org/libraries/klc/F5.1/) and if we decide what to do then an example could be added.

fauxpark, 2018-04-03:
@Ratfink
> That shouldn't actually cause any problems because the BGA doesn't sit directly on the board.

If the silk follows the fab chamfer then depending on the spacing between the edge of the package and the balls, it may actually intersect or at least get too close to one:
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
(VFBGA-49_5.0x5.0mm_Layout7x7_P0.65mm)

Personally I like the idea of cutting back only the left silk as shown above. It is similar to how the QFN footprints are drawn.

Thread 463 (2018-04-02):

Current sense transformers: Manufacturer-specific or not?

evanshultz, 2018-04-02:
We have a footprint I added at https://github.com/KiCad/kicad-footprints/blob/master/Transformer_SMD.pretty/Transformer_CurrentSense_8.4x7.2mm.kicad_mod. This footprint fits several different parts.

The PR to submit this footprint was at https://github.com/KiCad/Choke_SMD.pretty/pull/7 and https://github.com/KiCad/TO_SOT_Packages_SMD.pretty/pull/30.

I have a couple questions:
1. Is this footprint name correct? There are a number of different vendors which make compatible parts. How is the best way to name a footprint to fit them? Do we make one manufacturer-specific and assume the user can figure it out (footprint filters should guide them)? Do we use a general footprint with dimensions, like this one, to abstract away the specific vendor info?
2. If we use a generalized footprint, how do we include vendor information? Put multiple datasheets and/or MPNs in the description? Does this info go in the symbol (and then, in both places or only symbol) instead of the footprint?

Small transformers like this are notoriously easy to knock off. All the raw materials are available on the market so if one company builds a desirable part then other competitors can do the same. So a generalized approach seems best to me. But better to ask first as I'd like to add https://www.coilcraft.com/pdfs/cst2010.pdf.

FYI, a discussion about related symbols is at https://github.com/KiCad/kicad-library/pull/837.

poeschlr, 2018-04-02:
I would use generic footprints where possible. But include all parameters required for identifying the correct 3d model (Even if different trafos share a common landing pattern their height might be different.)

> If we use a generalized footprint, how do we include vendor information?

In the symbol. (Like we do with all other generic footprints that are used by many different symbols.)

The footprint will still include one reference document. This is intended for sharing the source document for the footprint. (The design specification.) It should help users to find out why a specific footprint looks like it does. (And also us librarians if we ever need to touch the fp again.)

Closed 2018-09-19.

Thread 464 (2018-04-02):

PCB antenna

sdalu, 2018-04-02:
It would be a nice addition if footprints for common PCB antenna could be provided: Bluetooth, Lora, Wifi

Found some Texas Instrument application note for 868MHz/915MHz:
* http://www.ti.com/lit/an/swra416/swra416.pdf
* http://www.ti.com/lit/an/swra227e/swra227e.pdf
* http://www.ti.com/lit/an/swra228c/swra228c.pdf

Ratfink, 2018-04-07:
There already are some 2.4 GHz PCB antennas provided in RF_Antenna.pretty (Texas_SWRA117D_2.4GHz_Left.kicad_mod and Texas_SWRA117D_2.4GHz_Right.kicad_mod).  We would welcome more contributions, of course!

Harvie, 2019-07-23:
Any news on this?

evanshultz, 2019-07-23:
@Harvie
There are too many things for librarians to do to take requests, which is why this was closed.

If you or anyone else wants to contribute an antenna footprint that would be great.

Harvie, 2019-07-23:
What about this? [KiCAD_PCB_Antenna_Lib.zip](https://github.com/KiCad/kicad-footprints/files/3423427/KiCAD_PCB_Antenna_Lib.zip)

Source:
https://forum.kicad.info/t/kicad-pcb-antenna-footprints/4765/12
https://drive.google.com/file/d/0B38qWbX1O5CzR2Q4XzljY1NlcTg/view

evanshultz, 2019-07-23:
If you have antenna footprints you'd like to submit, please create a PR so they can be reviewed. If you have a specific question about an antenna footprint or how to implement it in the library, then an issue would be a good place to discuss the question.

sdalu, 2019-07-23:
In fact it was closed, because I gave up on the idea of any contribution to this project. As instead of trying to build on every contributing effort, it is generally expected too much from wanabe contributors for which kicad is an occasional tool and electronic not their main discipline. Guess it should be put as a warning to avoid wasting time for everyone.

Closed 2018-05-19.

Thread 466 (2018-04-04):

Resistor 2512 footprint dimensions

Palmitoxico, 2018-04-04:
I've previously discussed this problem in the kicad-devel mailing list, but it is more appropriate to post it here.

I've verified that the current footprint for the 2512 SMD resistor (imperial) doesn't follow the recommended IPC dimensions.

I'm reading the IPC-SM-782 standard section 8.1 subsection 5.0 and here is a table for comparison:

Dim(mm) | IPC | Kicad
------------ | ------------- | ----------
Z | 7.4 | 7.5
G | 3.8 | 4.8
X | 3.2 | 3.4

The G dimension is too large. I can barely solder the resistors in my board (I should have checked it before sending the gerbers).

Thanks,
Augusto Fraga Giachero.

sethhillbrand, 2018-04-04:
Just a quick note that it looks like more than just the 2512 are off IPC specs.

Palmitoxico, 2018-04-04:
Yes, I just spoted this after trying to solder the resistors by hand. Not a very pleasant surprise : (

I couldn't find where the scripts for generating the footprints are located in this repository. Any hints?

evanshultz, 2018-04-04:
The SMD chip generator scripts are at https://github.com/pointhi/kicad-footprint-generator/tree/master/scripts/SMD_chip_package_rlc-etc.

poeschlr, 2018-04-04:
The footprints in this repo use the formulas of IPC-7315. (Which is newer then IPC-SM-782)
As far as i can tell the IPC-7315 reduced the pad sizes for all devices.

By the way your measurements are wrong. (or you measured the wrong footprint) The current footprint has G=4.84, Z=7.18, X=3.4

I might have made some mistake for parts where i had the spacing between the contacts given. There i used the maximum spacing instead of using the one where the Root mean square of the different tolerances is used. With the later it would result in G=4.33

sethhillbrand, 2018-04-04:
@poeschlr it looks like the heel/toe/side data were copied from table 3-4 for J-leads instead of table 3-5 larger chips (and used row order rather than labels).

Palmitoxico, 2018-04-04:
@poeschlr I forgot to mention that I measured the handsoldering variant, that's why the Z dimension is higher.

evanshultz, 2018-04-04:
For posterity, IPC 7315 above is really IPC 7351.

Palmitoxico, 2018-04-04:
@evanshultz I was about to post it after spending some time searching for this standard.

By the way, I found the IPC-7351 much more harder to understand than the IPC-SM-782.

evanshultz, 2018-04-04:
@Palmitoxico
Me too!

poeschlr, 2018-04-04:
Hm i don't know how i got 4.33 for Gmin. Now i always get something about 4.53. I seem to be too tired right now. Will look into it again tomorrow.

And yes i  wrote the wrong standard. I even noticed it while researching something but forgot to fix it.
I did not find the mathematical models behind the old standard. So i can't quite tell if that model was easier. (All i found was a document that had a few dimensions for some common landing patterns in it. No mention of how to derive other landing patterns.)

poeschlr, 2018-04-04:
I think i might have fixed it in the script. https://github.com/pointhi/kicad-footprint-generator/pull/119

I will check it again tomorrow before i create the pull request for the resulting footprints.

poeschlr, 2018-04-05:
The fixed footprints are found in PR https://github.com/KiCad/kicad-footprints/pull/469

evanshultz, 2018-06-07:
As I noticed at https://github.com/KiCad/kicad-footprints/pull/639#issuecomment-395523169, I looked at 0603 and this is what I found (using Level B):
- The equations and processes in our scripts appear to be to be correct
- Zmax = 2.42913mm
- Gmin = 0.785029mm
- Zmax and Gmin should be rounded to 0.01mm. I don't see any guidance about how they should be rounded (floor, ceiling, etc.) but I assume floor for "max" calcs and ceiling for "min" calcs.
- Zmax is obvious at 2.43mm.
- For Gmin I chose 0.79mm the "min" in Gmin means minimum so we shouldn't go below (see above).
- Our pads at Gmin=0.78mm are less than the calculation with 6 significant digits above.
- That then would require pads at +/-0.805mm where ours are +/-0.8mm.

Does anybody find anything wrong with my calcs or rounding understanding?

Thread 474 (2018-04-06):

Footprint Naming for Metallized Film Capacitors

Ratfink, 2018-04-06:
[KLC]: http://kicad-pcb.org/libraries/klc/ "KiCad Library Convention"
[G1.1]: http://kicad-pcb.org/libraries/klc/G1.1/ "Only standard characters are used for naming libraries and components"
[G1.2]: http://kicad-pcb.org/libraries/klc/G1.2/ "Each library is limited to 250 items"
[G1.3]: http://kicad-pcb.org/libraries/klc/G1.3/ "Libraries are organized by functionality"
[G1.4]: http://kicad-pcb.org/libraries/klc/G1.4/ "English language should be used throughout libraries"
[G1.5]: http://kicad-pcb.org/libraries/klc/G1.5/ "Plural naming is to be avoided"
[G1.6]: http://kicad-pcb.org/libraries/klc/G1.6/ "Capitalization conventions"
[G1.7]: http://kicad-pcb.org/libraries/klc/G1.7/ "Library files use Unix style line endings"
[G1.8]: http://kicad-pcb.org/libraries/klc/G1.8/ "Components can only contain features supported in latest stable release"
[G1.9]: http://kicad-pcb.org/libraries/klc/G1.9/ "Dimensional units"
[G2.1]: http://kicad-pcb.org/libraries/klc/G2.1/ "Defining generic and atomic parts"
[S1.1]: http://kicad-pcb.org/libraries/klc/S1.1/ "Symbol libraries should be categorized by function"
[S2.1]: http://kicad-pcb.org/libraries/klc/S2.1/ "General symbol naming guidelines"
[S2.2]: http://kicad-pcb.org/libraries/klc/S2.2/ "Non-functional variations in part number should be replaced with wildcard"
[S2.3]: http://kicad-pcb.org/libraries/klc/S2.3/ "Where atomic parts are available in multiple footprint options, a separate symbol must be drawn for each footprint"
[S3.1]: http://kicad-pcb.org/libraries/klc/S3.1/ "Origin is centered on the middle of the symbol"
[S3.2]: http://kicad-pcb.org/libraries/klc/S3.2/ "Text fields should use a common text size of 50mils"
[S3.3]: http://kicad-pcb.org/libraries/klc/S3.3/ "Symbol outline and fill requirements"
[S3.4]: http://kicad-pcb.org/libraries/klc/S3.4/ "Symbols with complex functionality may incorporate simple functional diagrams"
[S3.5]: http://kicad-pcb.org/libraries/klc/S3.5/ "Pin connection points must be placed outside of the symbol"
[S3.6]: http://kicad-pcb.org/libraries/klc/S3.6/ "Pin name position offset"
[S3.7]: http://kicad-pcb.org/libraries/klc/S3.7/ "Pin numbering for exposed pads"
[S3.8]: http://kicad-pcb.org/libraries/klc/S3.8/ "Multi unit symbols"
[S4.1]: http://kicad-pcb.org/libraries/klc/S4.1/ "General pin requirements"
[S4.2]: http://kicad-pcb.org/libraries/klc/S4.2/ "Pins should be grouped by function"
[S4.3]: http://kicad-pcb.org/libraries/klc/S4.3/ "Rules for pin stacking"
[S4.4]: http://kicad-pcb.org/libraries/klc/S4.4/ "Pin electrical type"
[S4.5]: http://kicad-pcb.org/libraries/klc/S4.5/ "Pins not connected on the footprint may be omitted from the symbol"
[S4.6]: http://kicad-pcb.org/libraries/klc/S4.6/ "Hidden pins"
[S4.7]: http://kicad-pcb.org/libraries/klc/S4.7/ "Active low pins should be designated using a bar above the symbol name"
[S5.1]: http://kicad-pcb.org/libraries/klc/S5.1/ "Symbols with a default footprint link to a valid footprint file"
[S5.2]: http://kicad-pcb.org/libraries/klc/S5.2/ "Footprint filters should match all appropriate footprints"
[S6.1]: http://kicad-pcb.org/libraries/klc/S6.1/ "Component Reference Designator (RefDes)"
[S6.2]: http://kicad-pcb.org/libraries/klc/S6.2/ "Component fields must be filled appropriately"
[S6.3]: http://kicad-pcb.org/libraries/klc/S6.3/ "Component metadata is added to symbol (and all aliases)"
[S7.1]: http://kicad-pcb.org/libraries/klc/S7.1/ "Power flag symbols"
[S7.2]: http://kicad-pcb.org/libraries/klc/S7.2/ "Graphical symbols"
[F1.1]: http://kicad-pcb.org/libraries/klc/F1.1/ "Footprint libraries are categorized by function"
[F1.2]: http://kicad-pcb.org/libraries/klc/F1.2/ "Connector footprint libraries"
[F2.1]: http://kicad-pcb.org/libraries/klc/F2.1/ "General footprint naming conventions"
[F2.2]: http://kicad-pcb.org/libraries/klc/F2.2/ "Footprint naming field prefixes"
[F2.3]: http://kicad-pcb.org/libraries/klc/F2.3/ "Manufacturer specific version of generic footprints"
[F2.4]: http://kicad-pcb.org/libraries/klc/F2.4/ "Footprint naming for non-standard pin numbering"
[F2.5]: http://kicad-pcb.org/libraries/klc/F2.5/ "Footprint naming conventions for specific components"
[F3.1]: http://kicad-pcb.org/libraries/klc/F3.1/ "SMD chip package naming conventions"
[F3.2]: http://kicad-pcb.org/libraries/klc/F3.2/ "Resistor naming conventions"
[F3.3]: http://kicad-pcb.org/libraries/klc/F3.3/ "Capacitor naming conventions"
[F3.4]: http://kicad-pcb.org/libraries/klc/F3.4/ "SMD IC package naming conventions"
[F3.5]: http://kicad-pcb.org/libraries/klc/F3.5/ "THT IC package naming conventions"
[F3.6]: http://kicad-pcb.org/libraries/klc/F3.6/ "Connector naming conventions"
[F3.7]: http://kicad-pcb.org/libraries/klc/F3.7/ "Fuse naming conventions"
[F4.1]: http://kicad-pcb.org/libraries/klc/F4.1/ "Datasheet recommendations take priority"
[F4.2]: http://kicad-pcb.org/libraries/klc/F4.2/ "Pin 1 should be located at the top left"
[F4.3]: http://kicad-pcb.org/libraries/klc/F4.3/ "Connected copper elements have the same pad number"
[F4.4]: http://kicad-pcb.org/libraries/klc/F4.4/ "Thermal pads"
[F4.5]: http://kicad-pcb.org/libraries/klc/F4.5/ "Specifying footprint keepout areas"
[F4.6]: http://kicad-pcb.org/libraries/klc/F4.6/ "Local clearance and settings should be set to zero"
[F5.1]: http://kicad-pcb.org/libraries/klc/F5.1/ "Silkscreen layer requirements"
[F5.2]: http://kicad-pcb.org/libraries/klc/F5.2/ "Fabrication layer requirements"
[F5.3]: http://kicad-pcb.org/libraries/klc/F5.3/ "Courtyard layer requirements"
[F6.1]: http://kicad-pcb.org/libraries/klc/F6.1/ "Footprint placement type must be set to surface mount"
[F6.2]: http://kicad-pcb.org/libraries/klc/F6.2/ "Footprint anchor should be placed in the middle of the component body"
[F6.3]: http://kicad-pcb.org/libraries/klc/F6.3/ "Pad requirements for SMD footprints"
[F7.1]: http://kicad-pcb.org/libraries/klc/F7.1/ "Footprint placement type must be set to Through Hole"
[F7.2]: http://kicad-pcb.org/libraries/klc/F7.2/ "Footprint anchor should placed at the location of Pin-1"
[F7.3]: http://kicad-pcb.org/libraries/klc/F7.3/ "Pin 1 should be rectangular, and other pads circular or oval"
[F7.4]: http://kicad-pcb.org/libraries/klc/F7.4/ "Pad requirements for THT footprints"
[F7.5]: http://kicad-pcb.org/libraries/klc/F7.5/ "Minimum annular ring width"
[F7.6]: http://kicad-pcb.org/libraries/klc/F7.6/ "Minimum hole diameter"
[F8.1]: http://kicad-pcb.org/libraries/klc/F8.1/ "Virtual components"
[F9.1]: http://kicad-pcb.org/libraries/klc/F9.1/ "Footprint meta-data is filled in as appropriate"
[F9.2]: http://kicad-pcb.org/libraries/klc/F9.2/ "Footprint properties are as default values unless otherwise required in datasheet"
[F9.3]: http://kicad-pcb.org/libraries/klc/F9.3/ "Footprint 3D model requirements"
[M1.1]: http://kicad-pcb.org/libraries/klc/M1.1/ "Models should be created by contributor"
[M1.2]: http://kicad-pcb.org/libraries/klc/M1.2/ "Manufacturer models should not be duplicated"
[M1.3]: http://kicad-pcb.org/libraries/klc/M1.3/ "Source files for 3D models should be supplied"
[M2.1]: http://kicad-pcb.org/libraries/klc/M2.1/ "Permitted 3D model file types"
[M2.2]: http://kicad-pcb.org/libraries/klc/M2.2/ "Model alignment and scaling"

I found at least one THT capacitor footprint that needs to be added, and I realized that I don't know what to call it.  It's for an [ECWF(L) metallized film capacitor](https://industrial.panasonic.com/cdbs/www-data/pdf/RDI0000/ABD0000C245.pdf), and their shape doesn't seem to match any of the THT capacitor shapes described in [F3.3].  I could fudge it and call them rectangular, but that's not right for mechanical integration.  Then again, our existing capacitor footprints don't seem to be designed for excellent mechanical integration, so maybe that's okay in this case.

@evanshultz @poeschlr @jkriege2 @Shackmeister @Misca1234 Any suggestions on this?

Ratfink, 2018-04-06:
*THT Capacitor* from F3.3 would fit, but there's no specific name for this body style.  That's really what I'm asking about: should we make a new style for these or just pretend they're Rect-style?

I agree that it might make sense to have footprints for these separately from the Rect footprints for the 3D models, but previous discussions (e.g. KiCad/Capacitors_THT.pretty#14) have concluded that our capacitor 3D models don't have to get every detail right because it would make the library too big.  Maybe this body style shouldn't fall under that line of thought, or maybe it should; I'm not sure.

As for naming if we decide to make a new style for these, Dipped sounds okay to me.

evanshultz, 2018-05-04:
I say call them "dipped" so that the 3D model can match the actual component.

If the user picks either footprint but allows both dipped and rect caps in that location, I think we're still good. In other words, I don't see anything that breaks and since these are scripted there isn't much overhead.

poeschlr, 2018-06-06:
We are also missing dipped tantal caps. So we might need to take them into account when we make a final naming convention.

Thread 497 (2018-04-17):

HandSoldering vs HandSolder suffix

poeschlr, 2018-04-17:
Currently the KLC mentions both these options.

We have 204 hand solder(ing) footprints in total.
114 of them use the HandSoldering suffix, which leaves 90 with the HandSolder suffix.

Which of the two should we use?

---

Some of them do not include the pad size modifier in their name.
Example of the later is the recently merged PR https://github.com/KiCad/kicad-footprints/pull/488

Ratfink, 2018-04-17:
If footprint names are case-sensitive (I assume they are, but KLC doesn't say one way or the other.  Then again, because footprint names are filenames, on Windows they might not be.), we actually have three suffixes in use.  By a count I just did from `master`:

Suffix | Count
-----:|-----
`_HandSolder` | 90
`_HandSoldering` | 83
`_Handsoldering` | 32
**Total** | **205**

We should definitely stick with one suffix for these.  `_HandSolder` does win for brevity, so if we want the path of least resistance, I'd suggest just changing everything (including KLC!) to that.  But I agree with Evan's points above about the ambiguity/subjectivity of the whole thing.  Here's a thought: if we list pad sizes explicitly for all these modified footprints, why would we even need a suffix like `_HandSolder` in the name?

Interestingly, of the 88 of these footprints that list pad sizes, all of which use the `_HandSolder` suffix.  We'd only be adding pad sizes to 117 footprints, which is still a lot, but at least it's better than 205.

stambaughw, 2018-04-17:
What about just "Hand"?  When there were "Reflow" and "Wave" variants of
the SMT resistors and capacitors, we didn't use "ReflowSolder" and
"WaveSolder".  For the sake of consistency, we should pick one style.
My preference is just "Hand" as some of our file names are rather
lengthy.  I could live with "HandSolder" as well.  "HandSoldering" isn't
any more descriptive than "HandSolder".

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

poeschlr, 2018-04-17:
Adding the pad size is a requirement with the new naming convention. (And yes i know this will be a lot of work.)

---

The HandSolder (or whatever) suffix is there to give the user a reasoning as to why this particular footprint has a differently sized pad to the default footprint. (This suffix clarification is mainly aimed at beginners i think so it should be easily understandable.)

If footprints with the HandSolder suffix really already have the correct name in other regards, keeping this suffix might generate the least amount of work. So my vote would be for this suffix. (To be fair i am a bit biased as a lot of these footprints are generated by my scripts.)

Thread 500 (2018-04-19):

Molex MiniFit Vertical PTH connectors have incorrect pin positions

Scottapotamas, 2018-04-19:
I'm referring to the Molex 5566 vertical connectors. This issue applies to those with, and without, the mechanical mounting pegs.

These connectors are 4.2mm pitch in both x and y as per the datasheet (and the ones in front of me).

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

The footprints for the 2x01 through to 2x12 vertical all have the correct 4.2mm pitch in the x-axis, but y-axis pitch is incorrectly set to 5.5mm (same as the RA PTH variants of these connectors.)

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

This is pretty visible with the markings on the fab layer, and can be validated by attempting to align a step model against the footprint.

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

poeschlr, 2018-04-19:
These are the datasheets for the parts that are compatible to these footprints:

https://www.molex.com/pdm_docs/sd/039281043_sd.pdf
https://www.molex.com/pdm_docs/sd/039289068_sd.pdf

What datasheet is your screenshot from?

poeschlr, 2018-04-19:
I just checked [all 02x02 parts on the official molex website](https://www.molex.com/molex/products/listview.jsp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) from the 5566 series. Non of them seem to have any other y pitch then 5.5mm. Is it possible you have a knockoff?

Scottapotamas, 2018-04-19:
Its possible families were confused, but when doing the [parametric search on the Molex site ](https://www.molex.com/molex/products/listview.jsp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) starting from the Mini-fit JR page, then defining vertical and 2-rows it points down to these connectors, I'm not finding any that have a rectangular pattern.

https://www.molex.com/pdm_docs/sd/462071004_sd.pdf is the example which I pulled the screencap off.

The reason I tied this to the 5566 family footprints, is the way Mouser/et al reference the series as 5566, but use manf# such as 39-28-1043 which also have the 4.2x4.2 pattern.

poeschlr, 2018-04-19:
Your datasheet is for the molex minifit jr power **(46207)** series.
Which is not in our library. If you are interested you can adapt the [footprint generator script](https://github.com/pointhi/kicad-footprint-generator/blob/master/scripts/Connector/Connector_Molex/conn_molex_mini-fit_Jr_tht_top_dual-row.py) to generate these as well.

As missing footprints are not an issue worth reporting i will close this. (KiCad does not claim that the library contains every conceivable part.)

Closed 2018-04-19.

Thread 525 (2018-04-26):

LGA packages can have different pin layouts. (naming convention)

poeschlr, 2018-04-26:
LGA packages seem to be very flexible with the placement of pins.

I discovered this when i wanted to add my new `LGA-16_3x3mm_P0.5mm` footprint for http://www.st.com/resource/en/datasheet/lis331hh.pdf
There is already a footprint with the same name for http://www.memsic.com/userfiles/files/DataSheets/Magnetic-Sensors-Datasheets/MMC5883MA-RevC.pdf

So my suggestion would be to add a layout specifier similar to what we did with bga footprints.
So something like `_Layout[num pads x rows]x[num pads y rows]`
This would result in the two footprints being named:
- `LGA-16_3x3mm_P0.5mm_Layout4x4`
- `LGA-16_3x3mm_P0.5mm_Layout3x5`

or we make it more clear and use `_Layout[num pads x rows]x[num pads y rows]y`

The pull requests https://github.com/KiCad/kicad-footprints/pull/524 and https://github.com/KiCad/kicad-symbols/pull/546 are affected by this outcome.

After this is done i will also update the old footprints in the lib (plus the symbols that use them)

Ratfink, 2018-04-26:
LGAs seem very non-standard to me, so I wonder if the right approach might be to use manufacturer prefixes.

poeschlr, 2018-04-26:
Well it seems we even found an example for when the same manufacturer uses slightly different footprints. See https://github.com/KiCad/kicad-symbols/pull/545

Ratfink, 2018-04-26:
The problem there is that one package is bigger than the other, so it's not a problem that the current naming can't handle.

poeschlr, 2018-04-27:
Update: i think the layout stuff only makes sense for parts that have pins on all 4 sides. (otherwise the pin count fully specifies the pin layout already)

I just checked the [IPC suggestions](http://ohm.bu.edu/~pbohn/__Engineering_Reference/pcb_layout/pcbmatrix/IPC-7x51%20&%20PCBM%20Land%20Pattern%20Naming%20Convention.pdf)

they suggest to simply include [pin count column]x[pin count row].

---

They also include a pad shape specifier (C = circular pad, R = rectangular, S = square pad) so it seems LGAs at least in theory can have circular and square pads as well.

---

So my updated suggestion would be to use `_Layout[pin x]x[pin y]y` if the pins are arranged similar to a QFN and `_Layout[num colums]x[num rows]` if they are arranged similar to BGA. No suffix for when they are arranged similar to DFN.

For extremely specialized packages we might want to use atomic symbol/footprint connection and naming (both include the part number). At least some pictures on google look like there are LGA packages out there that would be best included that way. (otherwise the naming convention would be extremely complex to include these as well.)

The pin shape can be included as another suffix. I would define rectangular pins as the default and only add a suffix if the leads are circular. (Not sure if we should even include a separate suffix for square leads)

Ratfink, 2018-04-27:
The problem I see with your suggestion is that, for example, the following two footprints could exist:

* `LGA-16_4x4mm_P0.65mm_Layout4x4y`
* `LGA-16_4x4mm_P0.65mm_Layout4x4`

The footprint filter for the latter would match the former.  It would be good to come up with a nomenclature that prevents this.

poeschlr, 2018-04-27:
Argh #$@&%*!
Why is LGA that varied? The qfn like packages don't even have their pins on a single grid most of the time. The array of LGA does not make sense at all for them.

Well enough complaining for today. What do you think about this as a solution?
- `LGA-16_4x4mm_P0.65mm_LayoutBorder4x4y`
- `LGA-16_4x4mm_P0.65mm_LayoutArray4x4` (or grid instead of array)

Or a bit shorter but harder to read (and travis would complain about the footprint filter):
- `LGA-16_4x4mm_P0.65mm_Layout-4x-4y`
- `LGA-16_4x4mm_P0.65mm_Layout4x4`

evanshultz, 2018-04-30:
I like single words and think `Grid` and `Edge` are nice choices.

poeschlr, 2018-05-04:
My LGAs have already been merged. They used the convention LayoutBorder.

So i would in this case codify LayoutBorder and LayoutGrid
Keeping layout to be similar to BGA, border instead of edge. I chose border because, well i can't really remember anymore.

---

To be sure that the "border decision" was not completely wrong,  i just looked up what google says when searching for border vs edge (i am not a native speaker. So i could have been totally wrong here.)
It seems the edge is the outer outline of somthing whereas the border can be defined as the area around the edge. (As the LGA pads are not really on the edge but only near it i think this might be really the better term.

one definition of border from: https://wikidiff.com/edge/border
> A decorative strip around the edge of something.

If you guys really object we can still change it as my footprints are scripted anyways.

Ratfink, 2018-05-04:
I don't object to the word "Border" instead of "Edge".  I can justify either:

* The pads are laid out as a border of the footprint.
* The pads are laid out around the edge of the footprint.

I really only favored "Edge" because it was shorter.

Thread 529 (2018-04-27):

Problem regarding paste and mask only pads. Project clearance interferes with them.

poeschlr, 2018-04-27:
I just noticed that our defined workflow for defining paste and mask areas does not really work as soon as the user sets some clearance in the project.
If a pad has it's clearance set to 0, the project setting is applied.

I asked the developers what the minimum clearance value is. We will need to use this as a workaround.
https://lists.launchpad.net/kicad-developers/msg35609.html

---

At least in kicad 5 it seems the smallest value possible is 1e-06 (0.000001)

poeschlr, 2018-04-27:
The developers confirmed that 1nm (=1e-06 = 0.000001) is the minimum value not changed back to 0.

poeschlr, 2018-04-27:
We should also include this in the KLC and also in the travis check scripts.

poeschlr, 2018-04-28:
I choose 1e-06% for the paste ratio as well (results in 1e-08 in the file)
That way it looks uniform in the GUI.

poeschlr, 2018-05-01:
Detailed explanation https://github.com/KiCad/kicad-footprints/pull/447#issuecomment-385584621

poeschlr, 2018-05-04:
Fix has been committed to the software side: https://github.com/KiCad/kicad-source-mirror/commit/93c7f65d96130c7165d412945668293f571cf2e9

No need to fix anything on the library side.

Closed 2018-05-04.

Thread 540 (2018-04-30):

Missing footprints for MCU Texas

poeschlr, 2018-04-30:
Footprints missing for https://github.com/KiCad/kicad-symbols/pull/560

 - [ ] 'MSP430F1101AIDGV': http://www.ti.com/lit/ds/symlink/msp430f1101a.pdf
Package_SO:TVSOP-20_4.4x5mm_P0.4mm
 - [ ] 'MSP430G2444IDA38': http://www.ti.com/lit/ds/symlink/msp430g2444.pdf
Package_SO:TSSOP-38_6.1x12.5mm_P0.65mm
 - [x] 'MSP430F1101AIRGE': http://www.ti.com/lit/ds/symlink/msp430f1101a.pdf
Package_DFN_QFN:VQFN-24-1EP_4x4mm_P0.5mm_EP2.6x2.6mm
 - [x] 'MSP430G2001IRSA16': http://www.ti.com/lit/ds/symlink/msp430g2001.pdf
Package_DFN_QFN:Texas_S-PVQFN-N16_EP2.7x2.7mm
 - [x] 'MSP430FR5720IRGE': http://www.ti.com/lit/ds/symlink/msp430fr5720.pdf
Package_DFN_QFN:Texas_S-PVQFN-N24_EP2.25x2.25mm
 - [x] 'MSP430F1122IRHB': http://www.ti.com/lit/ds/symlink/msp430f1122.pdf
Package_DFN_QFN:Texas_S-PVQFN-N32_EP3.55x3.55mm
 - [x] 'MSP430F5232IRGZ': http://www.ti.com/lit/ds/symlink/msp430f5232.pdf
Package_DFN_QFN:Texas_S-PVQFN-N48_EP5.2x5.2mm
 - [x] 'MSP430F5217IRGC': http://www.ti.com/lit/ds/symlink/msp430f5217.pdf
Package_DFN_QFN:Texas_S-PVQFN-N64_EP4.4x4.4mm
 - [ ] 'MSP430F2232IYFF': http://www.ti.com/lit/ds/symlink/msp430f2232.pdf
Package_BGA:Texas_RXBGA-49_3.33x3.488mm_Layout7x7_P0.4mm
 - [ ] 'MSP430F5217IYFF': http://www.ti.com/lit/ds/symlink/msp430f5217.pdf
Package_BGA:Texas_RXBGA-64_3.415x3.535mm_Layout8x8_P0.4mm
 - [ ] 'MSP430F5333IZQW': http://www.ti.com/lit/ds/symlink/msp430f5333.pdf
Package_BGA:Texas_MicroStar_Junior_BGA-113_7.0x7.0mm_Layout12x12_P0.5mm

evanshultz, 2018-07-03:
All of the above will be addressed with https://github.com/KiCad/kicad-footprints/pull/718.

Ratfink, 2018-07-14:
The MCU_Texas_MSP430 library now passes the kicad-library-utils S5.1 check without any errors or warnings, so this issue is resolved.

Closed 2018-07-14.

Thread 545 (2018-05-03):

Murata footprints incorrectly named "muRata"

Ratfink, 2018-05-03:
We have a variety of footprints for parts made by [Murata](https://www.murata.com/).  Some include the company's name in the footprint name.  Of these, we have some that capitalize it as `muRata`, and others that capitalize it as `Murata`.  We should reconcile these before the 5.0 freeze begins.

In the company's logo, it's capitalized `muRata`.  However, in ordinary text, they seem to be quite consistent with `Murata`, so I suggest we use the latter.

poeschlr, 2018-05-03:
Acourding to the "about murata" text on the official website the correct writing is "Murata" (muRata is only the logo)

https://www.murata.com/en-us/about?intcid5=com_xxx_xxx_cmn_nv_xxx

Ratfink, 2018-05-04:
The fix for this will involve symbol, footprint, and 3D model changes.  I know for sure it would conflict with https://github.com/KiCad/kicad-packages3D/pull/294, so we should wait for that to be merged before working on this.

Misca1234, 2018-05-06:
The person who undertakes this task should in parallel fix the scripts in
https://github.com/easyw/kicad-3d-models-in-freecad/pull/161
otherwise that person will get some unneeded workload to guess afterwards which footprint was associated with which 3D model.

Not to mentioned if murata footprints is moved from Converter_DCDC.lib to Regulator_Switching.lib as it should with symbol CRE1S0505S3C

Shackmeister, 2018-06-03:
The 3D model fixes has now been fixed

poeschlr, 2018-08-29:
Has this been done? If not we might want to keep this in mind for new contributions. Existing footprints should really only be renamed if there is a danger of confusion (While we are in the stable release cycle)

JacobEFO, 2019-07-09:
I suppose this issue still needs to be resolved.

I'll be making a PR in a jiffy (both here and on 3d-packages).

antoniovazquezblanco, 2019-07-09:
Thank you @JacobEFO !

antoniovazquezblanco, 2019-07-11:
> Existing footprints should really only be renamed if there is a danger of confusion (While we are in the stable release cycle)

AFAIK there should be no problems if a footprint gets renamed during a stable release although this should not be that necessary.

antoniovazquezblanco, 2019-07-11:
@JacobEFO Is there any symbol that will need footprint or fpfilter updating?

Thanks!

JacobEFO, 2019-07-11:
@antoniovazquezblanco  Can you elaborate this? I don't understand what you mean with "footprint or fpfilter updating".

The changed footprints should be here in this PR.

antoniovazquezblanco, 2019-07-11:
Symbols have fields that point to footprints and footprint filters in order to help the user choose the correct footprint. If you change footprint names, those fields should be updated in the symbols. I did not find any PR updating symbols related to this issue. Should there be one?

Thanks!

evanshultz, 2019-07-11:
This one seems a bit touchy to me to do at this point. Can we at least wait for Rene to return so he can weigh in before merging anything?

antoniovazquezblanco, 2019-07-16:
> This one seems a bit touchy to me to do at this point. Can we at least wait for Rene to return so he can weigh in before merging anything?

No hurry in merging in my side.

@JacobEFO here you can find a list of footprints associations and footprint filters that contain the keyworkd "Murata" in any possible capitalization combination. Some of theese require updating:
```
$ cat *.lib | grep F2 | grep -i murata
F2 "Converter_DCDC:Converter_DCDC_Murata_MGJ3" 0 -450 50 H I C CIN
F2 "Converter_DCDC:Converter_DCDC_Murata_NCS1SxxxxSC_THT" 0 -400 50 H I C CNN
F2 "Converter_DCDC:Converter_DCDC_muRata_OKI-78SR_Vertical" 50 -250 50 H I L CIN
F2 "Converter_DCDC:Converter_DCDC_muRata_OKI-78SR_Horizontal" 50 -250 50 H I L CIN
F2 "Filter:Filter_Murata_BNX025" 0 -200 50 H I C CNN
F2 "Converter_DCDC:Converter_DCDC_muRata_CRE1xxxxxxDC_THT" 0 -350 50 H I C CNN
F2 "Converter_DCDC:Converter_DCDC_muRata_CRE1xxxxxx3C_THT" 0 -400 50 H I C CNN
F2 "Converter_DCDC:Converter_DCDC_muRata_CRE1xxxxxxSC_THT" 0 -400 50 H I C CNN
F2 "Converter_DCDC:Converter_DCDC_muRata_NMAxxxxDC_THT" 0 -350 50 H I C CIN
F2 "Converter_DCDC:Converter_DCDC_muRata_NMAxxxxSC_THT" 0 -350 50 H I C CIN
F2 "Converter_DCDC:Converter_DCDC_muRata_NXE2SxxxxMC_THT" 0 -350 50 H I C CNN
```
```
$ cat *.lib | grep "^ " | grep -i murata
 Converter*DCDC*Murata*MGJ3*
 Converter*DCDC*Murata*NCS1SxxxxSC*
 Converter*DCDC*muRata*OKI*78SR*Vertical*
 Converter*DCDC*muRata*OKI*78SR*Horizontal*
 Filter*Murata*BNX025*
 Converter*DCDC*muRata*CRE1xxxxxxDC*
 Converter*DCDC*muRata*CRE1xxxxxx3C*
 Converter*DCDC*muRata*CRE1xxxxxxSC*
 Converter*DCDC*muRata*NMAxxxxDC*
 Converter*DCDC*muRata*NMAxxxxSC*
 Converter*DCDC*muRata*NXE2SxxxxMC*
```

poeschlr, 2019-09-24:
I would have preferred this to be done after v6 started but as there is already work done i will allow it if everything is done in one go. (including symbol side of things)

cp-aquila, 2020-04-30:
I have something else that we could add here: All parts in `Converter_DCDC`  are also prefixed with `Converter_DCDC`. I suspect that is a leftover from a v4->v5 cleanup.
I suggest to drop all the prefixes. Perhaps this can be fixed en passant with this issue.

Closed 2020-09-28.

Thread 568 (2018-05-06):

Package_DFN_QFN.pretty inconsistent

cederom, 2018-05-06:
Hey there, looks like DFN_QFN library is inconsistent, detects as INVALID on open, does not want to save because of:

```
IO_ERROR: PARSE_ERROR: Expecting 'circle, rectangle, oval, or trapezoid' in input/source
'/Users/cederom/(...)/library/kicad/kicad-footprints.git/Package_DFN_QFN.pretty/WQFN-24-1EP_4x4mm_P0.5mm_EP2.7x2.7mm.kicad_mod'
line 31
offset 15
from dsnlexer.cpp : Expecting() : line 369

PARSE_ERROR: Expecting 'circle, rectangle, oval, or trapezoid' in input/source
'/Users/cederom/(...)/library/kicad/kicad-footprints.git/Package_DFN_QFN.pretty/WQFN-24-1EP_4x4mm_P0.5mm_EP2.7x2.7mm_ThermalVias.kicad_mod'
line 40
offset 15
from dsnlexer.cpp : Expecting() : line 369

PARSE_ERROR: Expecting 'circle, rectangle, oval, or trapezoid' in input/source
'/Users/cederom/(...)/library/kicad/kicad-footprints.git/Package_DFN_QFN.pretty/QFN-28_4x4mm_P0.5mm.kicad_mod'
line 50
offset 14
from dsnlexer.cpp : Expecting() : line 369
from kicad_plugin.cpp : Load() : line 327
```

I am using KiCAD 4.0.7 on macOS :-)

poeschlr, 2018-05-06:
This lib is for kicad nightly (will become kicad 5)

This is noted in the readme, the repo description on the kicad website and even in the FAQ over at the forum. There is no other place i can think of to add this information.

cederom, 2018-05-06:
Maybe nightly but "old stable" `kicad-library` repo is marked as `Archived`.. and still there is no KiCAD5 available.. so it looks this is the "current" footprints library right?

How would exaclty transition from KiCAD 4 -> 5 and libraries would look like?

What library should I use for my current projects made with KiCAD4? Work on a separate `pretty` repo?

poeschlr, 2018-05-06:
Read https://forum.kicad.info/t/how-can-i-install-a-specific-version-of-the-footprint-library/9269/

poeschlr, 2018-05-06:
Or read http://kicad-pcb.org/libraries/download/

cederom, 2018-05-06:
Okay, maybe I did not specify my problem exactly enough, sorry..

I know those documents. I know how to download and use both old and new versions of the libraries. All these information is **user centric**. I want to **contribute** to Symbols and Footprints libraries and those information seems to be missing or outdated.

I noticed a problem with `Package_DFN_QFN.pretty` inside https://github.com/KiCad/kicad-footprints that prevents me from adding my own components..

The question is how can I contribute components at this point in time where library transitions take place?

I know I cannot use old `kicad-library` repo because it is `archived`. Should I contribute to `kicad-footprints` or separate `Package_DFN_QFN.pretty` repository that is later every some time compiled into `kicad-footprints`?

One simple sentence in the docs on **where** should I **contribute** my components would be really helpful and save some time to newcomers :-)

Ratfink, 2018-05-07:
The footprint libraries are now all in the single https://github.com/KiCad/kicad-footprints/ repository.  All contributions go there.  The old structure with one repository for each footprint library was unmaintainable, so we don't do that anymore.

All contributions should be made with recent development builds of KiCad 5.  That you are using KiCad 4 is most likely the source of the problem you encountered.

There is no `Package_DFN_QFN.pretty` repository, how would contributions go in a repository that doesn't exist? 🙂

I agree that listing the currently used repositories in the [library contribution guide](http://kicad-pcb.org/libraries/contribute/) would be a good idea.  GitHub makes the archived repositories fairly prominent in the [KiCad organization](https://github.com/KiCad) page, so for lack of explicit documentation about this, I find your confusion understandable.

cederom, 2018-05-07:
Thank you @Ratfink :-)

Yea, lots of `*.pretty` repos is not that really pretty :-)

I also could not find a separate repo for `Package_DFN_QFN.pretty` nor `Package_SO.pretty`, as you have noticed, which are most interesting to me at this point thus my further confusion.. the old libraries are not contributeable.. the new does not work with stable release.. thus my questions..

I am working on a project with deadlines. I have decided to use KiCAD instead of new Eagle which I was previously using with a license..

What are my options?

Create my components with stable KiCAD4 and store them in a separate libraries that could be at later point imported into KiCAD5?

Why libraries are not compatible between KiCAD 4 and 5? That seems like a huge danger to compatibility/portability..? Is this really self-compatibility issue or simply a commit bug of some sort?

Is KiCAD5 stable enough to work in a short term timescale without loosing results and not tripling my work?

I cannot see KiCAD in MacPorts.. and right now I really need to focus on my design.. but I would be glad to help you out with KiCAD5 testing in future.. and I would like to contribute components starting today :-)

Ratfink, 2018-05-07:
> Create my components with stable KiCAD4 and store them in a separate libraries that could be at later point imported into KiCAD5?

Yes, that's what you should probably do, if you plan to stick with the stable release of KiCad.

> Why libraries are not compatible between KiCAD 4 and 5?

KiCad 4 libraries work in KiCad 5, but not the other way around.  KiCad 5 has new features, e.g. custom pad shapes, that aren't present in KiCad 4, which is why some footprints from this library don't work in the old version.  There are also non-breaking differences that just annoy us librarians (the new version writes files with a different but compatible line order, so going back and forth would create a lot of noise in Git).

> Is KiCAD5 stable enough to work in a short term timescale without loosing results and not tripling my work?

I wouldn't count on it for anything critical at this point.  I use it for some of my own projects, but it's still getting a lot of changes and will continue to do so at least until the 5.0.0-rc2 release.

cederom, 2018-05-07:
Thank you @Ratfink now all seems clear to me!! Have a nice day!! :-)

Closed 2018-05-06.

Thread 569 (2018-05-06):

TH Test points with non-plated holes?

thomasonw, 2018-05-06:
I have just noticed the TH Test points mostly use NPTH holes vs. normal plated one.  Example:

TestPoint:  TestPoint_THTPad_1.5x1.5mm_Drill0.7mm

Is this right?  The test points place copper on both sides, but does not connected them.  If indeed it is intended to use NPTH for drilling, why not only have a copper pad on one side?  But more so, I was expected the Through-Hole test points to use plated holes.

Can someone help me understand this?

Ratfink, 2018-05-06:
Seems like a bug to me.  It looks like these appeared in https://github.com/KiCad/Connectors_TestPoints.pretty/pull/2, and there's no explanation of why they're NPTH there.

Closed 2018-05-07.

Thread 590 (2018-05-17):

Module: Arduino mounting holes too small?

matthijskooijman, 2018-05-17:
Some of the Arduino footprints in the Module library have mounting holes. These holes use a 1.78mm drill size, which seems rather small. For example: https://github.com/KiCad/kicad-footprints/blob/bb3185e1b563b7b3890cd754baaa7d6a8ac32410/Module.pretty/Arduino_UNO_R3_WithMountingHoles.kicad_mod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

 Looking at an actual Arduino Uno r3, these have drill holes of around ⌀3mm. Previous (third-party) footprints I've been using also use around 3mm, the [huzza footprint](https://github.com/KiCad/kicad-footprints/blob/master/Module.pretty/Adafruit_HUZZAH_ESP8266_breakout_WithMountingHoles.kicad_mod) has 2.9mm.

@jkriege2, you originally submitted these footprints. Did you intentionally use such small mounting holes?

jkriege2, 2018-05-18:
sounds more like a mistake ... just post a correcting PR!

matthijskooijman, 2018-07-09:
@Ratfink, @Shackmeister, thanks!

Closed 2018-07-08.

Thread 595 (2018-05-22):

Minimum annular ring for "big" pads

evanshultz, 2018-05-22:
@poeschlr @jkriege2 @Ratfink @Shackmeister
We specify the minimum annular ring for vias in KLC, but this doesn't apply for big pads. For example, mounting holes or large pins on components.

See https://github.com/KiCad/kicad-footprints/pull/578 and the part datasheet. For many connectors, only drill hole sizes are given and the annular ring isn't. We currently don't have and standard guidance for contributors.

Using IPC-2221 Level A, and thus being conservative for this type of hole, would require a 0.7mm annular ring width. As this user chose 1mm I think it's fine, but I also think KLC should give a recommendation. Would 1mm be a reasonable minimum annular ring to require for this type of hole?

poeschlr, 2018-05-23:
I took a quick look at IPC-2221 (http://www.sphere.bc.ca/class/downloads/ipc_2221a-pcb%20standards.pdf)

I am a bit confused. Section 9.1.2 (table 9-2) defines the annular rings. The largest one is 0.15mm. (This is the one set in the KLC)
1mm annular ring seems a bit excessive to me. Do you mean 1mm final pad size? If the drill is 0.7mm +2*0.15mm would be 1mm final size.
1mm annular ring would result in 2.7mm pad size for a 0.7mm drill. So if the 0.7mm drill has a pin pitch smaller than 2.7mm + pad to pad clearance, you can not achieve such a large annular ring. (Annular ring is defined as the smallest copper width anywhere around the pad.)

evanshultz, 2018-05-25:
Table 9-2 applies to vias, not pads where a component lead sits, and that is 0.15mm. Since we can't control pad size on a per-layer basis, and IPC says "All lands and annular rings shall be maximized wherever feasible" on page 73, I believe that means we need to use the external unsupported size on all layers. That is noted in KLC as you mentioned and is the minimum annular ring for any padstack.

But I'm talking about pads for a component lead which also need to consider Table 9-1. After re-reading I think it may mean diameter so using the equation on page 73, and assuming Level A, we get 2 * 0.15mm + 0.4mm = 0.7mm over the drill diameter for the minimum pad diameter.

1mm over the drill size, as I mentioned above, is a bit generous but not overly so. We could use 0.7mm over the drill for a "big" pad and it should be OK per IPC. So... use 0.7mm oversize for pads like this in lieu of any specific pad size given from the part vendor?

And, of course, users can shrink or change the pads in their library or on the board if they like.

poeschlr, 2018-05-27:
Could you make a dimensioned sketch of what you exactly mean? I think that would reduce the chances of misunderstandings.

evanshultz, 2018-05-29:
Sure!

The dimensioning tool in KiCad isn't all that pleasant, but here is what I could quickly make that shows the drill and annular ring dimensions (for some reason I cannot edit the text size of dimensions on the right of the measurement location...):
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

The via on the left has a 0.15mm annular ring as the pad diameter is 0.3mm over the drill size. I believe this is all Table 9-2 covers.

The THT hole on the right has a pad diameter 0.7mm over the drill hole. Both Table 9-2 and also Table 9-1 need to be considered. 0.7mm comes from 2 * 0.15mm (minimum annular ring) + 0.4mm (minimum Level A fabrication allowance) as I mentioned above. So going 1mm over the drill size as I originally mentioned would be a bit generous as IPC only says we should go drill diameter + 0.7mm if we want to be conservative (using Level A) and accommodate the largest possible number of PCB suppliers and/or receive the lowest PCB price.

Does that clarify my understanding of the document?

poeschlr, 2018-06-10:
I would not choose level a to be honest. Level b is given as standard and we use the standard (or nominal) dimensions everywhere else.

Remember: too much copper makes soldering harder. It also reduces pad to pad clearances which does reduce the voltage rating of your circuit. It is not simply make copper larger and allow for more alignment tolerances. It is a tradeoff.

---

So for level b we can define the following:
Here L is the maximum lead diameter, a is the drill size given in the pad properties. D is the pad size given in the pad properties. (This would be the absolute minimum. It can be increased all around. There is also the option to make the pads elongated = Oval to get better solder ability for hand soldering. The oval pads would allow to keep the voltage rating high while still making it easier to solder.)

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

---

And furthermore ipc-2221a is superseded by ipc-2221b. Sadly i could not find the later standard anywhere. (Ok i could buy it for ~200€ but that is a bit much to invest in a voluntary position.)

Ratfink, 2018-06-10:
Is your calculation 1+2*0.15+0.25=1.5mm an error, or rounding?  Un-rounded, that should be 1.55mm.

poeschlr, 2018-06-11:
@Ratfink
I guess it is just a typo. (Fixed)

It seems ipc-7351c will do away with the fixed annular ring definition and move over to a definition that depends on the hole diameter.

This document also holds a summary of ipc-7351b recommendations
http://www.ocipcdc.org/archive/What_is_New_in_IPC-7351C_03_11_2015.pdf

evanshultz, 2018-06-18:
I don't have 2221B either.

With mounting holes for large leads which do not have a pad size given, like the connector I linked above, using Level A will give these parts extra strength which is generally what is required. The increase in copper won't be an issue for hand soldering or wave soldering. That is why I suggested Level A and so the arguments for using Level B above don't apply to this stated narrow usage.

In general, Level B is good and I suggest using it by default. But carving out the use of Level A in KLC for mounting pads (especially when no padstack info is provided) seems like a nice allowance to me.

It's not clear to me how 2221B and 7351C (when it's released) will coexist. 7351C is targeted for SMT applications but this section regards THTs. 2221B is quite recent and specifically includes this section for THT pads. I suppose when 7351C is released there will be more information to help guide which standard to use for annular rings.

Thread 608 (2018-05-26):

Missing DirectFET footprints

Ratfink, 2018-05-26:
To fix https://github.com/KiCad/kicad-symbols/issues/520 for Transistor_FET.lib, we need to create several DirectFET footprints.  All DirectFET footprints are outlined in [International Rectifier Application Note AN-1035](https://www.infineon.com/dgdl/an-1035.pdf?fileId=5546d462533600a40153559159020f76).  The missing packages are listed below to track the progress.

- [x] Package_DirectFET:DirectFET_S3C (https://github.com/KiCad/kicad-footprints/pull/1807)
- [x] Package_DirectFET:DirectFET_SA (https://github.com/KiCad/kicad-footprints/pull/1806)
- [x] Package_DirectFET:DirectFET_SB (https://github.com/KiCad/kicad-footprints/pull/1808)
- [x] Package_DirectFET:DirectFET_MC (https://github.com/KiCad/kicad-footprints/pull/1809)
- [x] Package_DirectFET:DirectFET_MD (https://github.com/KiCad/kicad-footprints/pull/1810)
- [x] Package_DirectFET:DirectFET_MF (https://github.com/KiCad/kicad-footprints/pull/1803)
- [x] Package_DirectFET:DirectFET_L6 (https://github.com/KiCad/kicad-footprints/pull/1805)

evanshultz, 2018-05-26:
https://github.com/KiCad/kicad-symbols/pull/297

I intended to make a footprint generator that shares input data with the 3D model generator, but it didn't happen yet.

evanshultz, 2018-09-24:
@Shackmeister
I know somewhere we talked about the location of the script for the DirectFET footprints merged at https://github.com/KiCad/kicad-packages3D/pull/143. You mentioned perhaps the input parameters (YAML file?) could be shared between the footprints and the 3D models. I'm ready to make the footprints now so I wanted to find this conversation.

Alas, I can't find it no matter how hard I look. I also don't find anything in the 3D source or at https://github.com/pointhi/kicad-footprint-generator/tree/master/scripts. Argh! Can you point me to the location of the scripts for these 3D models?

Shackmeister, 2018-09-24:
Hi Evan I made the footprints manually and scripted the 3D models.
https://github.com/easyw/kicad-3d-models-in-freecad/tree/master/cadquery/FCAD_script_generator/Directfet_SMD

evanshultz, 2019-09-11:
All footprints have been merged and the PR noted in the first comment.

Closed 2019-09-13.

Thread 617 (2018-05-29):

Missing SO-DIMM footprints

herostrat, 2018-05-29:
Hello guys,

I wanted to ask if there is a reason why the socket library, and more precisely the SO-DIMMsockets are not planned to migrated to this repo (sockets and te-con is marked as done in the TODO.md)?

evanshultz, 2018-05-29:
It's probably just an oversight.

I don't get any hits for "dimm" or "simm" in the new footprint libraries. Can you point out what footprints didn't get migrated? It would be more helpful if you were clear about exactly what was missing, where it was, and where you looked.

I see some memory socket footprints at https://github.com/KiCad/Sockets.pretty that I don't see in the new libraries.

IC sockets are now at https://github.com/KiCad/kicad-footprints/tree/master/Socket.pretty.

TE footprints which don't fall into another category are at https://github.com/KiCad/kicad-footprints/tree/master/Connector_TE-Connectivity.pretty. There are more TE footprints at https://github.com/KiCad/kicad-footprints/tree/master/Connector_FFC-FPC.pretty, for example.

poeschlr, 2018-05-29:
The footprints in that lib are extremely bad and need extensive rework. But they should still be transferred over. They should probably go into other libs though. (Example the plcc sockets should go into the lcc lib with footprint name prefixed by Socket.)

For reference the original library: https://github.com/KiCad/Sockets.pretty

fauxpark, 2018-05-29:
There is an open PR for one of the SODIMMs at #375 and the PLCC sockets appear to be already migrated over. As for the rest, it was probably a combination of them taking too long/too much effort to fix them up according to KLC in order to migrate them over (when most of the action was happening), and a lot of them could be moved to more specific libraries anyway.

herostrat, 2018-05-30:
Somehow the pull-request https://github.com/KiCad/kicad-footprints/pull/375 did not pop up when I was searching for it.

It is exactly the footprint I was talking about.

It is good to know that it is most likely just an oversight, than I can make pull-requests here in the future for them.

Thanks a lot for the answers!

btply, 2019-07-28:
Still not showing any SODIMM sockets in a fresh install

evanshultz, 2019-07-29:
@btply
One only needs to follow the trail to see that https://github.com/KiCad/kicad-footprints/pull/1187 is still open and I made comments about it which have yet to be implemented. I would think it's best to close the issue only after at least one suitable footprint had been merged, though.

Closed 2018-05-30.

Thread 618 (2018-05-29):

Does the courtyard extend from NPTHs?

evanshultz, 2018-05-29:
See https://github.com/KiCad/kicad-footprints/pull/592.

The courtyard is there to capture the extents of the component and the associated land pattern. This is from IPC 7351 (see page 18 of http://www.ipc.org/committee/drafts/1-13_d_7251WD1.pdf). That makes me think the courtyard clearance should be measured from the outer extents of NPTH.

`Display_7Segment:AD-121F2` is a footprint where a mounting pin is not inside the courtyard, but maybe this is an accident or an old footprint so I want to confirm.
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

Ratfink, 2018-05-30:
I can't imagine any good reason to not include NPTH holes in the courtyard.  I can certainly imagine some bad things that could happen if they aren't included in the courtyard though.  I'd say any footprint with this situation should get a larger courtyard.  In the case of the AD-121F2 you posted a screenshot of, a contoured courtyard would probably be best.

poeschlr, 2018-05-30:
Yes NPTHs should be included in the courtyard area.
(Especially as in most cases there will be something inside this NPTH hole that is part of the component body.)

Ratfink, 2018-07-06:
[KLC]: http://kicad-pcb.org/libraries/klc/ "KiCad Library Convention"
[G1.1]: http://kicad-pcb.org/libraries/klc/G1.1/ "Only standard characters are used for naming libraries and components"
[G1.2]: http://kicad-pcb.org/libraries/klc/G1.2/ "Each library is limited to 250 items"
[G1.3]: http://kicad-pcb.org/libraries/klc/G1.3/ "Libraries are organized by functionality"
[G1.4]: http://kicad-pcb.org/libraries/klc/G1.4/ "English language should be used throughout libraries"
[G1.5]: http://kicad-pcb.org/libraries/klc/G1.5/ "Plural naming is to be avoided"
[G1.6]: http://kicad-pcb.org/libraries/klc/G1.6/ "Capitalization conventions"
[G1.7]: http://kicad-pcb.org/libraries/klc/G1.7/ "Library files use Unix style line endings"
[G1.8]: http://kicad-pcb.org/libraries/klc/G1.8/ "Components can only contain features supported in latest stable release"
[G1.9]: http://kicad-pcb.org/libraries/klc/G1.9/ "Dimensional units"
[G2.1]: http://kicad-pcb.org/libraries/klc/G2.1/ "Defining generic and atomic parts"
[S1.1]: http://kicad-pcb.org/libraries/klc/S1.1/ "Symbol libraries should be categorized by function"
[S2.1]: http://kicad-pcb.org/libraries/klc/S2.1/ "General symbol naming guidelines"
[S2.2]: http://kicad-pcb.org/libraries/klc/S2.2/ "Non-functional variations in part number should be replaced with wildcard"
[S2.3]: http://kicad-pcb.org/libraries/klc/S2.3/ "Where atomic parts are available in multiple footprint options, a separate symbol must be drawn for each footprint"
[S3.1]: http://kicad-pcb.org/libraries/klc/S3.1/ "Origin is centered on the middle of the symbol"
[S3.2]: http://kicad-pcb.org/libraries/klc/S3.2/ "Text fields should use a common text size of 50mils"
[S3.3]: http://kicad-pcb.org/libraries/klc/S3.3/ "Symbol outline and fill requirements"
[S3.4]: http://kicad-pcb.org/libraries/klc/S3.4/ "Symbols with complex functionality may incorporate simple functional diagrams"
[S3.5]: http://kicad-pcb.org/libraries/klc/S3.5/ "Pin connection points must be placed outside of the symbol"
[S3.6]: http://kicad-pcb.org/libraries/klc/S3.6/ "Pin name position offset"
[S3.7]: http://kicad-pcb.org/libraries/klc/S3.7/ "Pin numbering for exposed pads"
[S3.8]: http://kicad-pcb.org/libraries/klc/S3.8/ "Multi unit symbols"
[S4.1]: http://kicad-pcb.org/libraries/klc/S4.1/ "General pin requirements"
[S4.2]: http://kicad-pcb.org/libraries/klc/S4.2/ "Pins should be grouped by function"
[S4.3]: http://kicad-pcb.org/libraries/klc/S4.3/ "Rules for pin stacking"
[S4.4]: http://kicad-pcb.org/libraries/klc/S4.4/ "Pin electrical type"
[S4.5]: http://kicad-pcb.org/libraries/klc/S4.5/ "Pins not connected on the footprint may be omitted from the symbol"
[S4.6]: http://kicad-pcb.org/libraries/klc/S4.6/ "Hidden pins"
[S4.7]: http://kicad-pcb.org/libraries/klc/S4.7/ "Active low pins should be designated using a bar above the symbol name"
[S5.1]: http://kicad-pcb.org/libraries/klc/S5.1/ "Symbols with a default footprint link to a valid footprint file"
[S5.2]: http://kicad-pcb.org/libraries/klc/S5.2/ "Footprint filters should match all appropriate footprints"
[S6.1]: http://kicad-pcb.org/libraries/klc/S6.1/ "Component Reference Designator (RefDes)"
[S6.2]: http://kicad-pcb.org/libraries/klc/S6.2/ "Component fields must be filled appropriately"
[S6.3]: http://kicad-pcb.org/libraries/klc/S6.3/ "Component metadata is added to symbol (and all aliases)"
[S7.1]: http://kicad-pcb.org/libraries/klc/S7.1/ "Power flag symbols"
[S7.2]: http://kicad-pcb.org/libraries/klc/S7.2/ "Graphical symbols"
[F1.1]: http://kicad-pcb.org/libraries/klc/F1.1/ "Footprint libraries are categorized by function"
[F1.2]: http://kicad-pcb.org/libraries/klc/F1.2/ "Connector footprint libraries"
[F2.1]: http://kicad-pcb.org/libraries/klc/F2.1/ "General footprint naming conventions"
[F2.2]: http://kicad-pcb.org/libraries/klc/F2.2/ "Footprint naming field prefixes"
[F2.3]: http://kicad-pcb.org/libraries/klc/F2.3/ "Manufacturer specific version of generic footprints"
[F2.4]: http://kicad-pcb.org/libraries/klc/F2.4/ "Footprint naming for non-standard pin numbering"
[F2.5]: http://kicad-pcb.org/libraries/klc/F2.5/ "Footprint naming conventions for specific components"
[F3.1]: http://kicad-pcb.org/libraries/klc/F3.1/ "SMD chip package naming conventions"
[F3.2]: http://kicad-pcb.org/libraries/klc/F3.2/ "Resistor naming conventions"
[F3.3]: http://kicad-pcb.org/libraries/klc/F3.3/ "Capacitor naming conventions"
[F3.4]: http://kicad-pcb.org/libraries/klc/F3.4/ "SMD IC package naming conventions"
[F3.5]: http://kicad-pcb.org/libraries/klc/F3.5/ "THT IC package naming conventions"
[F3.6]: http://kicad-pcb.org/libraries/klc/F3.6/ "Connector naming conventions"
[F3.7]: http://kicad-pcb.org/libraries/klc/F3.7/ "Fuse naming conventions"
[F4.1]: http://kicad-pcb.org/libraries/klc/F4.1/ "Datasheet recommendations take priority"
[F4.2]: http://kicad-pcb.org/libraries/klc/F4.2/ "Pin 1 should be located at the top left"
[F4.3]: http://kicad-pcb.org/libraries/klc/F4.3/ "Connected copper elements have the same pad number"
[F4.4]: http://kicad-pcb.org/libraries/klc/F4.4/ "Thermal pads"
[F4.5]: http://kicad-pcb.org/libraries/klc/F4.5/ "Specifying footprint keepout areas"
[F4.6]: http://kicad-pcb.org/libraries/klc/F4.6/ "Local clearance and settings should be set to zero"
[F5.1]: http://kicad-pcb.org/libraries/klc/F5.1/ "Silkscreen layer requirements"
[F5.2]: http://kicad-pcb.org/libraries/klc/F5.2/ "Fabrication layer requirements"
[F5.3]: http://kicad-pcb.org/libraries/klc/F5.3/ "Courtyard layer requirements"
[F6.1]: http://kicad-pcb.org/libraries/klc/F6.1/ "Footprint placement type must be set to surface mount"
[F6.2]: http://kicad-pcb.org/libraries/klc/F6.2/ "Footprint anchor should be placed in the middle of the component body"
[F6.3]: http://kicad-pcb.org/libraries/klc/F6.3/ "Pad requirements for SMD footprints"
[F7.1]: http://kicad-pcb.org/libraries/klc/F7.1/ "Footprint placement type must be set to Through Hole"
[F7.2]: http://kicad-pcb.org/libraries/klc/F7.2/ "Footprint anchor should placed at the location of Pin-1"
[F7.3]: http://kicad-pcb.org/libraries/klc/F7.3/ "Pin 1 should be rectangular, and other pads circular or oval"
[F7.4]: http://kicad-pcb.org/libraries/klc/F7.4/ "Pad requirements for THT footprints"
[F7.5]: http://kicad-pcb.org/libraries/klc/F7.5/ "Minimum annular ring width"
[F7.6]: http://kicad-pcb.org/libraries/klc/F7.6/ "Minimum hole diameter"
[F8.1]: http://kicad-pcb.org/libraries/klc/F8.1/ "Virtual components"
[F9.1]: http://kicad-pcb.org/libraries/klc/F9.1/ "Footprint meta-data is filled in as appropriate"
[F9.2]: http://kicad-pcb.org/libraries/klc/F9.2/ "Footprint properties are as default values unless otherwise required in datasheet"
[F9.3]: http://kicad-pcb.org/libraries/klc/F9.3/ "Footprint 3D model requirements"
[M1.1]: http://kicad-pcb.org/libraries/klc/M1.1/ "Models should be created by contributor"
[M1.2]: http://kicad-pcb.org/libraries/klc/M1.2/ "Manufacturer models should not be duplicated"
[M1.3]: http://kicad-pcb.org/libraries/klc/M1.3/ "Source files for 3D models should be supplied"
[M2.1]: http://kicad-pcb.org/libraries/klc/M2.1/ "Permitted 3D model file types"
[M2.2]: http://kicad-pcb.org/libraries/klc/M2.2/ "Model alignment and scaling"

Looking closely at [F5.3], I believe it already says this in the first paragraph:

> The component courtyard is defined as the smallest rectangular area that provides a minimum electrical and mechanical clearance around the combined component body and land pattern boundaries. It is allowed to create a contoured courtyard area using a polygon instead of a simple rectangle. (IPC-7351C)

NPTHs are part of the land pattern, so they need a mechanical clearance.  Being that there isn't any KLC change needed here, I'll close this issue.

Closed 2018-07-06.

Thread 631 (2018-06-05):

Missing SSOP-18 footprint

acolomb, 2018-06-05:
Looking for a matching footprint for a Toshiba 62083A 8-channel DMOS transistor array, I noticed that there is no SSOP-18 footprint in the library.

The SSOP-20 footprint at https://github.com/KiCad/kicad-footprints/blob/master/Package_SO.pretty/SSOP-20_4.4x6.5mm_P0.65mm.kicad_mod comes very close judging by the outline, but has two extra pins.

I kindly ask that whoever generated the fantastic SSOP footprints and matching 3D models, please extend the series by this SSOP-18 variant.

A description of the geometry can be found in Toshiba's data sheet, page 9 top half:
https://toshiba.semicon-storage.com/info/docget.jsp?did=29893

Thank you very much in advance!

poeschlr, 2018-06-05:
The footprints are hand made. (By some contributor. Probably years ago.)

We sadly can not take requests for making footprints (or symbols).
The only reason to accept such a request would be if the footprint was in one of the old libraries but got removed by mistake. Or at least if a symbol that would use that footprint is already in the library.

---

Creating footprints/symbols is a vital skill for every electronics designer. If you want to contribute both the footprint and symbol for this part you are welcome to do so. Just make sure you follow the library convention: http://kicad-pcb.org/libraries/klc/

acolomb, 2018-06-05:
I have already adapted the SSOP-20 footprint for my own use. Just not sure about the 3D model stuff, what would I use to edit that?

Please reopen this issue, I will file a pull request to contribute my footprint file. That will fix it properly.

acolomb, 2018-06-08:
Pending PR review at https://github.com/KiCad/kicad-footprints/pull/632

Closed 2018-06-05.

Thread 655 (2018-06-12):

Silkscreen for small footprints eg. 0805, 0603

dawid-solitech, 2018-06-12:
In previous version of footprints library, components like resistors 0805, 0603 have got silkscreen outline. Now in the latest version there is no silkscreen. Why do you often change names, apperance on a pcb? I can't find any EDA where is no silkscreen for these components.

Ratfink, 2018-06-12:
This change occurred in https://github.com/KiCad/kicad-footprints/pull/469, when we fixed the dimensions of these footprints.  The script that generates them (located [here](https://github.com/pointhi/kicad-footprint-generator/tree/master/scripts/SMD_chip_package_rlc-etc)) is overly conservative with silkscreen.  I pointed this out, but merge them anyway because automated assembly would benefit from the correct pad sizes, and removing the silkscreen would only hurt manual assembly, which represents a small fraction of boards produced.  A patch to the script that adds silkscreen back to these footprints would be welcome!

poeschlr, 2018-06-12:
I will look into that. I fear it will need to violate KLC though.

poeschlr, 2018-06-13:
The 0805 size is a bit of a trouble maker. The tolerance range for the lead to lead clearance is extremely large. (First i thought IPC is just very conservative with their size definitions. But i looked at some random resistors on farnell. After just a few i had resistors within the full range of the IPC tolerance definition.)

poeschlr, 2018-06-13:
Fix for this is included in https://github.com/KiCad/kicad-footprints/pull/653

poeschlr, 2018-06-17:
fix has been merged

Closed 2018-06-17.

Thread 658 (2018-06-13):

RFC: Rounded rectangle pads

poeschlr, 2018-06-13:
As IPC suggests to use rounded rectangle pads i looked into what type of footprints are viable to convert.
In future we might also want to codify it in the KLC.

One good example are the two terminal smd footprints (resistor, capacitor, ...) For these it helps with allowing more footprints to have silk screen in addition to the original benefits of having rounded rectangle pads.

Other easily convertible footprints are the scripted smd connector footprints.

I hit a roadblock however with the qfn footprints. Especially with the ones that would require the corner pads to be chamfered. As these chamfered pads are in reality polygon pads it means that they can not have  rounded corners. (at least not with the current implementation of custom pads.) Now the question arises what to do with the remaining pads. Does it make sense to round them of anyways?

Another example where i am unsure are the exposed pads. I would assume they should be rounded as well. (But then again i am unsure as the paste stencil which is the main reason for rounding them is managed by separate pads anyways.)

evanshultz, 2018-06-18:
You must be talking about the unreleased IPC 7351C, right?

I assume the QFN with chamfered pads you're talking about is like `QFN-28_4x4mm_P0.5mm`, right?
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

In this case the benefits of rounded corners on all other pads would seem to be worthwhile to me and we should go ahead and do that. It will look a little odd, but get us as close to optimal as we can for the time being.

Has anyone reported this limitation to the devs? I don't see an issue when searching at https://bugs.launchpad.net/kicad. If not, I can report it.

From https://www.pcblibraries.com/Forum/rounded-rectangle-radius-is-different-in-altium_topic1581.html it appears the center thermal pad should have rounded corners. Also see the 3rd post at https://www.pcblibraries.com/Forum/rounded-rectangle-pad-shape_topic1462.html for some semi-official recommendations on radius parameters.

poeschlr, 2018-06-18:
Ok then we agree here. In future we will update the KLC to request rounded rectangle instead of normal rectangle pads.
With the size parameters as suggested by IPC (25% and max radius 0.25mm)

poeschlr, 2018-06-18:
I don't think there is as of yet a bug report for that. So we could request it for version 6.

evanshultz, 2018-06-18:
Submitted at https://bugs.launchpad.net/kicad/+bug/1777516.

Closed 2018-08-29.

Thread 660 (2018-06-14):

Current 0402 footprint is wrong!

jcyrax, 2018-06-14:
After https://github.com/KiCad/kicad-footprints/pull/642 new 0402 is obviously wrong with spacing of 0.08mm between pads. I found that there is error in size definition file in https://github.com/pointhi/kicad-footprint-generator/blob/master/scripts/SMD_chip_package_rlc-etc/size_definitions/size_default_chip_devices_smaller_0603.yaml terminator_spacing_min: 0.1 is wrong, there needs to be 0.4mm, if you look in linked document.
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
Obviously mistake copying values and T value used instead of S. It looks like its been like this for some time now, just recent changes made it obvious.

poeschlr, 2018-06-14:
fix is part of https://github.com/KiCad/kicad-footprints/pull/653

poeschlr, 2018-06-14:
and this pr https://github.com/KiCad/kicad-footprints/pull/656 fixes it for the v4 backport

evanshultz, 2018-06-16:
@jcyrax
Both PRs above are merged. Can you please confirm this issue is fixed?

jcyrax, 2018-06-18:
Can confirm, this is fixed now.

Closed 2018-06-18.

Thread 661 (2018-06-16):

SOT-363_SC-70-6

Misca1234, 2018-06-16:
Foot print
Package_TO_SOT_SMD:SOT-363_SC-70-6

pin 1,3,4 and 6 are larger in the data sheet for both

https://assets.nexperia.com/documents/data-sheet/BC846BPN.pdf
https://assets.nexperia.com/documents/data-sheet/BAV756S_BAW56_SER.pdf

https://assets.nexperia.com/documents/outline-drawing/SOT363.pdf

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

Should we remake the foot print

poeschlr, 2018-06-16:
I noticed that nxp uses SC-88 as the name for these packages not SC-70.

---

Using IPC-7351b calculation on the first nxp datasheet i would get the following parameters for the pads:

position y = 0.8375mm, pad size x = 1.275mm,  y = 0.4mm

Misca1234, 2018-06-16:
> I noticed that nxp uses SC-88 as the name for these packages not SC-70.

Yes, but I guess people have reused the foot print because it is so similar, I have not search for which original component the foot print was made for, the foot print does not have a data sheet link

Misca1234, 2018-06-16:
In either case we should add "SOT-363_SC-88-6"

Take
https://assets.nexperia.com/documents/data-sheet/BAV756S_BAW56_SER.pdf
and BAW56W, it "wants" SOT-363_SC-70-6, which is 3 pins

evanshultz, 2018-06-27:
I would not pick a single vendor's document for our reference footprint. See https://github.com/KiCad/TO_SOT_Packages_SMD.pretty/pull/26.

IPC is the way to go, but unfortunately IPC-SM-782 doesn't have reference dimensions for SOT363 and the superseding 7351 doesn't have package drawings. I found a doc (I think it was in Japanese) that had tons of JEDEC outlines, but naturally I didn't save it and I can't find it now.

Once we have industry-standard reference drawings for a package, I favor splitting up the footprints instead of doing combo ones. After v5 is released and we've settled down, of course.

poeschlr, 2018-08-29:
Even if we finally add specialized footprints we should keep the combo ones for backwards compatibility till v6 development is started.

Thread 668 (2018-06-18):

Missing 3D model for Crystal.pretty/Crystal_SMD_3225-4Pin_3.2x2.5mm.kicad_mod ?

sheffieldnick, 2018-06-18:
This footprint references:
`(model ${KISYS3DMOD}/Crystal.3dshapes/Crystal_SMD_3225-4Pin_3.2x2.5mm.wrl`

but that file doesn't exist in kicad-packages3D (github master).

In 4.x releases I was using ${KISYS3DMOD}/Crystals.3dshapes/Crystal_SMD_SeikoEpson_TSX3225-4pin_3.2x2.5mm.wrl but I can't find an equivalent in the 5.x repository?

Thanks

poeschlr, 2018-06-18:
Some of the old 3d models where of too low of a quality to be included in kicad 5.

The deciding point was if a model has a step model and is scaled and positioned such that the scaling in the footprint can be set to 1 and offset/rotation to 0.

---

The models for seiko epson parts are designed in the old wings way not in the new freecad way.
So they are scaled wrong and there is no way of getting a valid step model for them. (They need to be recreated in a proper MCAD tool.)

Some of the other crystal models could be easily transferred as they exist as a freecad file. (meaning they simply need to be re exported using kicad-stepup)

poeschlr, 2018-08-29:
Pointer to this issue made in the package 3d repo

Closed 2018-08-29.

Thread 672 (2018-06-19):

MPT Phoenix Terminal block generates assert on 3d viewer

FabianInostroza, 2018-06-19:
When viewing the following footprints
TerminalBlock_Phoenix_MPT-0,5-2-2.54_1x02_P2.54mm_Horizontal.kicad_mod
TerminalBlock_Phoenix_MPT-0,5-3-2.54_1x03_P2.54mm_Horizontal.kicad_mod

in the 3d viewer there are some asserts that fail.
The reason is that these footprints contain NPTH with zero size

poeschlr, 2018-06-19:
The script for these is build kind of wrong. (uses size 0 do indicate NPTH instead of using the drill size for that.)

poeschlr, 2018-06-19:
I discovered another problem with the script. It adds pin numbers to NPTH drills.

FabianInostroza, 2018-07-05:
Seems you already fixed this, thanks @poeschlr

Closed 2018-07-05.

Thread 678 (2018-06-20):

I think my advice for EP sizes was wrong

poeschlr, 2018-06-20:
As you guys might know, i advised using either IPC standards or at least the maximum tolerance for the ep size.
Most datasheets that give a suggested footprint select the nominal size as the size for the pad on the pcb.
I asked over at the forum for advice: https://forum.kicad.info/t/size-of-exposed-pads/11209

A user there found this [TI document](http://www.ti.com/lit/an/slua271a/slua271a.pdf) that explicitly states that the ep size should be the same size as the "slug" (Which i would interpret as "use the nominal size") Sadly that document does not give a reasoning behind this statement. (The user suggested that it could have to do with improving self alignment.)

---

So i guess my interpretation of the IPC standard in this regard was wrong. (Meaning some of the later added footprints with exposed pads might not be ideal. I doubt they will be so wrong as to merit immediate response but i think in future we can go back to using nominal sizes for the EP.)

poeschlr, 2018-06-26:
Yes i am convinced that IPC-7351 only applies to the lead pads.
The only thing mentioned about exposed pads is that for qfn the clearance between it and the other pads should be at least 0.2mm and that to achieve that it is advisable to reduce the heel fillet.

poeschlr, 2018-06-26:
[Microchip seems to suggest EP sizes all over the place.](http://ww1.microchip.com/downloads/en/PackagingSpec/00000049BQ.pdf) (Sometimes the maximum slug size, but also the minimum and also values in between including nominal.) So i would guess it is not that critical.

poeschlr, 2018-06-26:
Yes i would say so. (There will of course be exceptions if there is a good reason given.)

evanshultz, 2018-06-28:
Just one general question: I have seen bridging between metal elements on a package and traces running under the package. Rivets on snap caps, exposed slugs, formed metal "wings", etc. Is using the nominal value the best choice since we only have an unattributed TI doc saying to do it and other docs giving different guidance?

I got a response from TI and they said basically that this doc is intended to be general and is only pointing out to maintain clearance to other pads. The datasheet supersedes this doc.

I'm fine with using the nominal value, but I just wish we had a more authoritative source of info on this...

poeschlr, 2018-06-28:
Using nominal size is only the advice for exposed pads for parts similar to qfn.

Everything else needs to be examined separately. (And as i hinted above even for qfn there will be exceptions. So if a datasheet suggests a different value and the footprint is specialized enough then this datasheet trumps that. For generic footprints one should then look at suggestions by different manufacturers to get a good conclusion. To be honest really good footprints would also require knowledge of the manufacturing process. But that is something users need to do for them selfes as we can not know how our stuff is used.)

evanshultz, 2018-06-29:
After thinking about this, here are a few pathological questions that might come up. Both of these are driven by thinking about how and why Microchip has such huge ranges for some of their parts. This could happen if there are two different packages (or package vendors) used for some parts so the min and max range are actually roughly the nominal sizes that could be seen on the actual parts but instead of being a tolerance range where any value between min and max can happen, there are only two groupings within that large range.
1. What if nominal slug size isn't given?
-- Use the max size? This would account for the question I pondered above.
-- Calculate nominal from min and max? (Assume min and max values are given.) This would not.
2. What if the max is notably bigger than nominal? (Assume nominal and max are given.) If max is, say, 20% bigger than nominal should the max be used? Otherwise we could have a notably overhanging slug.

evanshultz, 2018-06-29:
In general, when the new footprints with nominal sizes are added, should the older footprints be removed? It shouldn't hurt to keep them, but it will inflate our library a bit with unused footprints. And with your script, it's so easy to make new footprints that re-generating any ones we need later is probably better than having footprints built to no standard rotting in the repo.

poeschlr, 2018-06-29:
I thought i removed them in all of my PRs if i forgot to do it in some of them then it is a mistake

Thread 694 (2018-06-25):

Library for LEM LV 25-P

evanshultz, 2018-06-25:
At https://github.com/KiCad/kicad-footprints/pull/620#issuecomment-399798831 I said:

> One other question: Should we have a new library called `Sensor_Voltage` since `LEM_LV25-P` is voltage transducer and not for current measurement? Not in this PR, but as I was looking at this it seems like the correct way to go.

Isn't that correct?

Datasheet: https://www.lem.com/sites/default/files/products_datasheets/lv_25-p.pdf

poeschlr, 2018-06-25:
Well the first thing that i can read in the datasheet is that this is indeed a voltage transducer. So yes it should be in the lib named Sensor_Voltage. (Adding libs is allowed even after the v5 release.)

evanshultz, 2018-06-26:
Right, but then `Sensor_Voltage` would include only one footprint. OK?

Relatedly, we have this library for symbols and it contains only the matching symbol. Just FYI.

poeschlr, 2018-06-26:
I would guess there will come more in future.

evanshultz, 2018-07-01:
Symbol and footprint PRs made and linked above. Closing this now.

Closed 2018-07-01.

Thread 696 (2018-06-25):

PCB fabrication tolerance question

jcyrax, 2018-06-25:
I noticed that footprint generation scripts formulas use F (printed board fabrication tolerances) value of 0.1mm. This is same as IPC-7351B and even previous version from ~2005.

Page 15 in IPC-7351B says that you can set this to 0 if manufacturer has accounted for this by "swelling" features.

Should it be set to 0?

poeschlr, 2018-06-25:
I think we should be a bit conservative here. As we do not know what our users will do with the footprints. So i personally vote for 0.1mm.

Closed 2018-07-17.

Thread 711 (2018-06-28):

0805 rounded rectangle pad change

stambaughw, 2018-06-28:
The recent change to rounded rectangular pads for the SMT caps and resistors made the gap between the pads on the 0805 footprints less than the 0603 footprint.  I check a bunch of datasheets and other resources and in none of them can I find where the recommended gap between pads of the 0805 footprint is less than the 0603 footprint.  The attached image shows an 0603, 0805, and 1206 resistor (left) and capacitor (right) footprints for comparison purposes.  If this is correct, would someone please attach the document that was used to generate these footprints so I can understand why this occurs.
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

poeschlr, 2018-06-28:
I looked into it a bit more. It is even easier to understand than what i wrote above.
For both 0805 and 0603 the terminal to terminal distance is listed in IPC-SM-782. (As written in my previous response i checked these against 20 random resistors and capacitors available from farnell.)

Smin is 0.55 fro 0805 and 0.7 for 0603. If we ignore PCB manufacturing tolerances the pad to pad clearance (Gmin) calculates directly from Smin. (In IPC-7351B the heel fillet is given as 0 meaning Gmin will be the same as Smin.)

If we respect manufacturing tolerances (0.1 fabrication tolerance and 0.05 placement as suggested in IPC-7351B) we get the exact result as the current footprints have.

stambaughw, 2018-06-28:
On 6/28/2018 12:26 PM, Rene Pöschl wrote:
> I already answered to this over on the mailing list
> <https://lists.launchpad.net/kicad-lib-committers/msg00549.html>.
I guess I should subscribe to the library committers mailing list before
I post a message to it ;)

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

Thanks for the info.  I found some manufactures who indeed have poor
enough tolerances that Smin (IPC-SM-782 Figure 2) is 0.55mm.  The worst
one I found was 0.6mm (Stackpole Electronics).  The resistor
manufacturers is use are around 1.0mm (at least the ones I use) so I may
have to create my own SMT footprints.  I don't know if it's wise to have
that much extra pad when reflow soldering.

Sorry about the noise.

Cheers,

Wayne

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

evanshultz, 2018-06-28:
But it is a good point. This has come up a few times because it seems unintuitive. Would it be best to have a few 0805 options in the official lib: one covering all 0805s and one for parts with a tighter dimensional tolerance?

stambaughw, 2018-06-28:
This is probably true for most of the small SMT resistor and capacitor
footprints.  In my case, I primarily use Panasonic and Vishay resistors
for which Smin is 1.06mm and 1.08mm respectively.  This is almost double
the 0.55mm specified in ipc-sm-782b.  Getting the footprint correct for
small SMT devices like an 0805 resistor is important to prevent
manufacturing defects such as tombstoning and billboarding during
reflow.  My fear is users who are not aware of the potential
manufacturing issues will blindly use these footprints because some ipc
standard said so.  Having pads that are too large can cause just as many
problems as pads that are too small.

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

poeschlr, 2018-06-29:
I now also checked the 0603. The average over the selected examples is remarkably close to the IPC-SM-785 values.

stambaughw, 2018-06-29:
Thank you Rene for taking a closer look at this.

Wayne

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

evanshultz, 2018-06-29:
Minor note: Typo of "Length" twice in the first column of each sheet.

poeschlr, 2018-06-30:
For 0805 i created a pull request to get the footprint nearer to real parts. See: https://github.com/KiCad/kicad-footprints/pull/712

poeschlr, 2018-06-30:
I fixed the typos. If i find time while i am in london i will add a few more parts to my research. Maybe i can find some clear clusters that allow us to make a few more targeted footprints. But until then the best option will be the average that i used right now.

evanshultz, 2018-09-19:
Closing since this is resolved. For reference, here are the current 0603, 0805, and 1206:
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

Closed 2018-09-19.

Thread 741 (2018-07-10):

SO-DIMM

herostrat, 2018-07-10:
Hey guys,

before I start working on a PR for the connector, extending https://github.com/KiCad/kicad-footprints/pull/375, I have a few questions:

The name: it seems that a number of different sockets have the same dimensions.
TE and Amphenol are the only producers I can find at the usual market places.

Here the naming schema for DDR2 SO DIMM and DDR1 SO DIMM are given for TE:
http://www.te.com/commerce/DocumentDelivery/DDEController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

So I think we have this groupings for SMT:
 - Standart (Boss, RightAngle - RightSide)
   - 1473005
   - 1717254
   - 1473149
 - Reverse (Boss, RightAngle - LeftSide)
   - 1473150
   - 1565918
 - Bossless (Bossless, RightAngle - RightSide)
   - 1-1473005

Does anybody have a idea for a sensible naming schema for us?

I think the CtrYd should also not extend over the whole area between the arms.
Two reasons: One can place components under the pcb in the socket and the size of the pcb in the socket is not standardized. Therefore I would like to just outline the socket and not expand over the wole area.
The CtrYd and silk for the arms should be the size as they are in the bobc PR in order to account for the different versions imho.

poeschlr, 2018-08-27:
Sorry for the late answer. (I totally missed this issue)

I doubt we will be able to come up with a naming scheme that will work for all possible parts. We can try what you suggest above and see where it takes us.

Regarding courtyard: I agree that we can not know how large the module is that is inserted into this socket. That part of the area would need to be included in a separate (virtual) footprint that is under the responsibility of the user. Maybe place a text on the comments layer to remind the user that there will be something in this area.

herostrat, 2018-12-11:
I decided to use a non generic naming scheme after reviewing (a lot) of different sockets.
The difference in the different versions is mostly the position of the mounting pads under the wings.

If one wants to use a different version of the available sockets it is easy to modify the submitted one in https://github.com/KiCad/kicad-footprints/pull/1158 so that it fits you need.

Closed 2018-12-11.

Thread 764 (2018-07-20):

TO-220 footprint pitch is wrong?

evanshultz, 2018-07-20:
@poeschlr
At https://github.com/KiCad/kicad-footprints/pull/574 you updated the TO-220 footprint names with staggered pins to the new convention. I have concerns if the naming was done right. Or perhaps I'm confused.

Let's take `TO-220-4_P5.08x2.54mm_StaggerEven_Lead5.84mm_TabDown`:
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

`P5.08x2.54mm` is, I believe, the distance from pins 1-3 horizontally and then from pins 1-2 vertically. The first dimension is correct, but the second should then be 3.8mm instead of 2.54mm.

The `Lead5.84mm` is the distance vertically from the bottom of the body to the farthest lead, I think. That is 2.05mm + 3.8mm which is nearly 5.84mm.

Many of the footprints deviate in only one dimension and a few match all 3 of the assertions above, so I think this is correct. I read the conversation linked from the PR above but it's not clear to me exactly what is being proposed so I want to check. http://kicad-pcb.org/libraries/klc/F3.5/ contains some information, but it doesn't say the `P<x>x<y>` section is required with staggered leads and `Lead<distance>mm` isn't shown at all. And the fact that the footprint naming is inconsistent made me want to be sure.

I'm going to add a footprint, and the script was never updated for this new convention, so if someone can confirm the above (updating KLC would be nice!) I can address this.

poeschlr, 2018-07-20:
The lead distance is always from body to pin 1. (No matter if it is the farthest or nearest. See note in the picture of the KLC rule you linked.)

It is possible that the pitch measurement is indeed wrong. (I calculated the measurements by hand when i renamed the parts.)

---

It seems the simplifications made by oliver form my original naming convention did mess that up a bit. (My original intent is documented here: https://github.com/KiCad/kicad-library/issues/1447#issuecomment-323785988)

evanshultz, 2018-07-20:
Thanks for the info! So KLC could use an update and/or clarification?

Fixed footprints and a missing one needed for https://github.com/KiCad/kicad-symbols/pull/765 submitted at https://github.com/KiCad/kicad-footprints/pull/765.

jkriege2, 2018-07-21:
Hmmm ... I'm not very happy with the x-pitch ... because we measure it differently depending on whether the pins are staggered, or not ... which does not make too much sense (I think). Therefore I would propose:
- measure x-pitch always as the distance between the pad-centers of neightboring pin-pairs (on the package)
- the staggeredEven/Odd as a MODIFIER then tells whether there is a y-pitch between the pins and if so, how they are staggered. If the pins are staggered, add the y-pitch,  otherwise the x-pitch is enough.

Best,
JAN

evanshultz, 2018-07-21:
@poeschlr
See above. I believe I copied the scheme used in the existing footprints, so please advise. Even your original proposal doesn't cover every field used when you re-named these footprints.

poeschlr, 2018-07-22:
Ok i looked at your PR and i fear i did not follow my own rules when i originally renamed the footprints. It seems i indeed used the pin furthest from the body not pin 1 as the reference. (My bad. So my advice above is totally wrong and you had it right the first time. Sorry about the confusion.)

I do not have any strong feelings either way.
We would either need to update the KLC. Which we need to do anyways. Or we need to make massive changes to the footprint names. I kind of tend towards the former as this will create fewer problems for us when we want to get the changes into 5.0.1.
(If we keep the naming convention as stable as possible it will be possible to continuously roll out library releases and still call it a stable release cycle.)

Thread 769 (2018-07-22):

QFN with pull back "leads". Naming convention?

poeschlr, 2018-07-22:
At least one qfn footprint is designed for pull back leads (leads that to not come out to the body edge as one would normally expect for such packages)
This means that the footprint does not allow for a toe fillet and is therefore incompatible with normal types of qfn footprints.

The question is how should we indicate that for the users.

The one footprint i found so far is: QFN-44-1EP_9x9mm_P0.65mm_EP7.5x7.5mm with datasheet https://www.parallax.com/sites/default/files/downloads/P8X32A-Propeller-Datasheet-v1.4.0_0.pdf (page 35)

Ratfink, 2018-07-22:
According to [this IPC land pattern naming convention document](http://ohm.bu.edu/~pbohn/__Engineering_Reference/pcb_layout/pcbmatrix/IPC-7x51%20&%20PCBM%20Land%20Pattern%20Naming%20Convention.pdf), IPC calls these "Pull-back Quad Flat No-lead", or PQFN for short.  We could do the same.

It's worth pointing out as well that many (most?) of our LGA footprints are actually in this category.

evanshultz, 2018-07-23:
Hmmm... a quick search online shows that some vendors have varying meanings for "PQFN" that often expose some or all of the leads to the package edge:
- https://www.infineon.com/dgdl/an-1136.pdf?fileId=5546d462533600a401535599f0ef10c7
- https://www.nxp.com/docs/en/application-note/AN2467.pdf
- https://www.fairchildsemi.co.jp/Assets/zSystem/documents/collateral/onlineSeminars/Board-Level-Evaluation-of-Power-Quad-Flat-No-Lead-(PQFN)-Packages-PPT.pdf
- https://www.fairchildsemi.com/technical-articles/Board-Level-Evaluation-of-Power-Quad-Flat-No-Lead-PQFN-Packages.pdf
- https://www.fairchildsemi.com/application-notes/AN/AN-4187.pdf
- http://www.onsemi.com/pub/Collateral/TND6224-D.PDF
- http://www.irf.com/product-info/fact_sheet/mosfets-pqfn.pdf
- https://cdn.macom.com/applicationnotes/S2083.pdf

Some of them are vendor-specific, so they'd still be OK, but some are more general packages which would get confusing. Sigh.

poeschlr, 2018-07-23:
How about we add a suffix _PullBackLeads or something similar? This would allow us to keep the manufacturer prefix (in that case QFN) but still communicate this fact to the user. (This can be in addition to using PQFN)

---

Regarding LGA: Yes i know that they are not really LGAs. But it seems the common usage of LGA has changed to include such packages. (My guess is that they are produced in the same manner as the original LGA packages. This is why the sales guys of packaging companies chose to use LGA as the name for them. That name then makes its way into the user documentation ie datasheet.)

---

I also found another name for QFN/DFN: MLF (micro lead frame) This is for example used in atmel documentations (but they list the alias qfn as well. So we should definitely be ok with using qfn here)

evanshultz, 2018-07-23:
I'm fine with that suffix, but even better if it can be shorter (like `_PullBack`).

MLF is a technology from Amkor. See https://amkor.com/packaging/leadframe/microleadframe/. Vendors choose this package but could call it anything they want.

evanshultz, 2018-09-19:
Seems we decided what to do and have committed some footprints using this terminology already.

Closed 2018-09-19.

Thread 784 (2018-07-24):

Pad position resolution

therman89, 2018-07-24:
The new footprint libraries use a resolution of 0.0005mm, which is not
supported by pcbnew's grid list, nor does it make sense. It makes
distancing very difficult. Please update footprint libraries, so that
they use a resolution, that actually makes sense. E.g. 0.05mm, as in
previous versions.
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

poeschlr, 2018-07-24:
PCB_New does not rely on the grid to create traces. (The trace snaps to the center anyways.) So this should not matter at all.

The reason for these positions is that some footprints are created in accordance with IPC which specifies a rounding resolution of 0.05mm for the spacing between pads (Dimension S) which means the position of the pad will then be on 0.05/4 = 0.0125mm grid.

Closed 2018-08-29.

Thread 796 (2018-07-29):

SW_MEC_5GTH9 incorrect pad spacing

c-born, 2018-07-29:
SW_MEC_5GTH9 pad spacing should be  400 x 300mil  (10.16 x 7.62mm) as per the spec sheet, current footprint in the Buttons library is 450 x 300mil.

I should have paid more attention when the pads didn't fit the 3D model pins (which are correct), but it was my first attempt at using KiCad and I scaled the model! Switches don't fit the holes in my PCB now, a good lesson!
Local fix was easy enough, I'm starting to like the tool-set. I'm not up to pushing a library fix as yet though.

Edit: Added data sheet
[MEC_5G.pdf](https://github.com/KiCad/kicad-footprints/files/2239588/MEC_5G.pdf)

Closed 2018-09-05.

Thread 816 (2018-08-09):

Missing PinHeader & PinSocket Horizontal SMD footprint

herostrat, 2018-08-09:
I just saw that there are no script generated footprints for them.

See for example:
https://eu.mouser.com/datasheet/2/181/M20-792R-1273521.pdf

Is it ok to add them and can somebody with knowledge in the scripting help me out?

evanshultz, 2018-08-09:
There are single-row male headers in the lib already:
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

But that's not exactly what you're looking for. We don't take requests here so I'll close this item after a couple days.

Our footprint scripts are at https://github.com/pointhi/kicad-footprint-generator, and we usually get the footprints merged before the script, so if you grab some related script and then work with it you can submit footprints and get help. Being able to write scripts to generate footprints is a powerful tool so it would be great to add your contributions to the repository. There are lots of Python tutorials and information online so start by running an existing script and then figuring out how it works; you'll quickly be able to modify it to fit your needs! :)

herostrat, 2018-08-10:
This issue was not meant to be a feature request.

I wanted to make sure that it is ok to implement it, before I do the work.
It could be a good first starting point to make myself familiar with the footprint scripts.

Would it be ok for you @evanshultz to look over this again https://github.com/KiCad/kicad-footprints/pull/616 and merge it if its ok for you, because I forgot to use branches at this time which means I cannot add additional PRs with an up to date repo

poeschlr, 2018-08-16:
You can still open new pull requests even if your local master branch is tied up somewhere else.

I assume your local repo has this repo (the official kicad repo) added as a separate remote. I call this remote upstream. If you named it differently in your setup simply replace upstream with whatever name you chose.
To get a new branch that follows the Head of the master branch simply use the following commands:
```
git fetch upstream
git checkout upstream/master
git checkout -b new_branch_name
git push --set-upstream origin new_branch_name
```

If you have not yet added the offical repo as a separate remote location run the following command:
`git remote add upstream git@github.com:KiCad/kicad-footprints.git` (or `git remote add upstream https://github.com/KiCad/kicad-footprints.git` if you prefer to use https instead of ssh.)

Closed 2019-01-23.

Thread 851 (2018-08-20):

QFN with pullback leads

evanshultz, 2018-08-20:
@poeschlr
How to generate the TQFN-24 footprint for AS1115 at https://ams.com/documents/20143/36005/AS1115_DS000206_1-00.pdf/3d3e6d35-b184-1329-adf9-2d769eb2404f (page 24)? The current QFN generator doesn't seem to support pullback leads, so should I use the LGA generator?

So far I have the following in `qfn-other.yaml` using the QFN generator, but the script fails (besides not supporting pullback leads) and I haven't looked into it yet. If it's better to start with the LGA generator then I'll just move there instead of pursuing this further.
```
TQFN-24-1EP_4x4mm_Pitch0.5mm_EP52.8x2.8mm_ThermalVias:
  device_type: 'TQFN'
  #manufacturer: 'man'
  #part_number: 'mpn'
  size_source: 'https://ams.com/documents/20143/36005/AS1115_DS000206_1-00.pdf/3d3e6d35-b184-1329-adf9-2d769eb2404f'
  ipc_class: 'qfn_pull_back'
  #ipc_density: 'least' #overwrite global value for this device.
  # custom_name_format:
  #body_size_x_min: 9.9
  body_size_x: 4.0
  #body_size_x_max: 10.1
  #body_size_y_min: 9.9
  body_size_y: 4.0
  #body_size_y_max: 10.1
  lead_width_min: 0.18
  lead_width_max: 0.35
  lead_len_min: 0.3
  lead_len_max: 0.4

  EP_size_x_min: 2.7
  EP_size_x: 2.8
  EP_size_x_max: 2.9
  EP_size_y_min: 2.7
  EP_size_y: 2.8
  EP_size_y_max: 2.9
  # EP_paste_coverage: 0.65
  EP_num_paste_pads: [2, 2]
  #heel_reduction: 0.1 #for relatively large EP pads (increase clearance)

  thermal_vias:
    count: [3, 3]
    drill: 0.3
    # min_annular_ring: 0.15
    paste_via_clearance: 0.1
    # EP_num_paste_pads: [2, 2]
    #paste_between_vias: 1
    #paste_rings_outside: 1
    EP_paste_coverage: 0.65
    #grid: [1, 1]
    # bottom_pad_size:
    # paste_avoid_via: False

  pitch: 0.5
  num_pins_x: 6
  num_pins_y: 6
  #chamfer_edge_pins: 0.25
  #pin_count_grid:
  #pad_length_addition: 0.5
  #suffix: '_Pad{pad_x:.2f}x{pad_y:.2f}mm_HandSolder'
  #include_suffix_in_3dpath: 'False'
```

poeschlr, 2018-08-20:
The problem is with the avoid paste over via stuff. If you set paste_avoid_via to false the footprint is generated. The pull back setting works. you can even include a `lead_to_edge` parameter if the "lead" is not directly on the edge.

The generated footprint will look like this if you set paste_avoid_via to False:
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

poeschlr, 2018-08-20:
This would be the parameter set:

``` yaml
TQFN-24-1EP_4x4mm_Pitch0.5mm_EP52.8x2.8mm_ThermalVias:
  device_type: 'TQFN'
  #manufacturer: 'man'
  #part_number: 'mpn'
  size_source: 'https://ams.com/documents/20143/36005/AS1115_DS000206_1-00.pdf/3d3e6d35-b184-1329-adf9-2d769eb2404f'
  ipc_class: 'qfn_pull_back'
  #ipc_density: 'least' #overwrite global value for this device.
  # custom_name_format:
  #body_size_x_min: 9.9
  body_size_x: 4.0
  #body_size_x_max: 10.1
  #body_size_y_min: 9.9
  body_size_y: 4.0
  #body_size_y_max: 10.1
  lead_to_edge:
    minimum: 0
    maximum: 0.15
  lead_width_min: 0.18
  lead_width_max: 0.35
  lead_len_min: 0.3
  lead_len_max: 0.4

  EP_size_x_min: 2.7
  EP_size_x: 2.8
  EP_size_x_max: 2.9
  EP_size_y_min: 2.7
  EP_size_y: 2.8
  EP_size_y_max: 2.9
  # EP_paste_coverage: 0.65
  EP_num_paste_pads: [2, 2]
  #heel_reduction: 0.1 #for relatively large EP pads (increase clearance)

  thermal_vias:
    count: [3, 3]
    drill: 0.3
    # min_annular_ring: 0.15
    paste_via_clearance: 0.1
    # EP_num_paste_pads: [2, 2]
    #paste_between_vias: 1
    #paste_rings_outside: 1
    EP_paste_coverage: 0.65
    #grid: [1, 1]
    # bottom_pad_size:
    paste_avoid_via: False

  pitch: 0.5
  num_pins_x: 6
  num_pins_y: 6
  #chamfer_edge_pins: 0.25
  #pin_count_grid:
  #pad_length_addition: 0.5
  #suffix: '_Pad{pad_x:.2f}x{pad_y:.2f}mm_HandSolder'
  #include_suffix_in_3dpath: 'False'

```

poeschlr, 2018-08-20:
I should also add that i used the generator as it is in my pull request https://github.com/pointhi/kicad-footprint-generator/pull/149

I think i added some functionality to it and made some bug fixes. So check out my branch if you want to generate your footprint.

poeschlr, 2018-08-20:
I have now implemented support for the way this part is dimensioned in the datasheet. (Commit https://github.com/pointhi/kicad-footprint-generator/pull/149/commits/3dfa62dc5b100055fc1800884677b61a23acb247 includes this feature) The new parameter set would be:

```yaml
TQFN-24-1EP_4x4mm_Pitch0.5mm_EP52.8x2.8mm_ThermalVias:
  device_type: 'TQFN'
  #manufacturer: 'man'
  #part_number: 'mpn'
  size_source: 'https://ams.com/documents/20143/36005/AS1115_DS000206_1-00.pdf/3d3e6d35-b184-1329-adf9-2d769eb2404f'
  ipc_class: 'qfn_pull_back'
  #ipc_density: 'least' #overwrite global value for this device.
  # custom_name_format:
  #body_size_x_min: 9.9
  body_size_x: 4.0
  #body_size_x_max: 10.1
  #body_size_y_min: 9.9
  body_size_y: 4.0
  #body_size_y_max: 10.1
  lead_to_edge:
    minimum: 0
    maximum: 0.15
  lead_width_min: 0.18
  lead_width_max: 0.35
  body_to_inside_lead_edge:
    minimum: 0.3
    maximum: 0.4

  EP_size_x_min: 2.7
  EP_size_x: 2.8
  EP_size_x_max: 2.9
  EP_size_y_min: 2.7
  EP_size_y: 2.8
  EP_size_y_max: 2.9
  # EP_paste_coverage: 0.65
  EP_num_paste_pads: [2, 2]
  #heel_reduction: 0.1 #for relatively large EP pads (increase clearance)

  thermal_vias:
    count: [3, 3]
    drill: 0.3
    # min_annular_ring: 0.15
    paste_via_clearance: 0.1
    # EP_num_paste_pads: [2, 2]
    #paste_between_vias: 1
    #paste_rings_outside: 1
    EP_paste_coverage: 0.65
    #grid: [1, 1]
    # bottom_pad_size:
    paste_avoid_via: False

  pitch: 0.5
  num_pins_x: 6
  num_pins_y: 6
  #chamfer_edge_pins: 0.25
  #pin_count_grid:
  #pad_length_addition: 0.5
  #suffix: '_Pad{pad_x:.2f}x{pad_y:.2f}mm_HandSolder'
  #include_suffix_in_3dpath: 'False'
```

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

evanshultz, 2018-08-21:
Thanks! PR submitted at https://github.com/KiCad/kicad-footprints/pull/853.

Closed 2018-08-21.

Thread 857 (2018-08-23):

Automatic Footprint Libraries?

sarf2k4, 2018-08-23:
Hi,

I am still new in using kicad, been using kicad v4 for months with slow paced learning speed. Just when I wanted to find a Jumper solder bridge, stumbled across kicad v5. I successfully installed kicad v5, I noticed that the wizard is only for 3d models, not for footprints anymore as for kicad v4 previously.

I checked the global libraries, there seems to be just the same with previous kicad v4, but browsing to the directory manually using windows explorer, there are additions related/packaged alongside with kicad v5. I am sure that there are more than 5 new footprints/packages included since kicad v4.

My question is, is there a tool that will append a folder of library/packages automatically without the need of adding every single package over and over again?

evanshultz, 2018-08-23:
Questions about how to use KiCad can be posted at https://forum.kicad.info/, and there is a section for scripts which may be able to help in Pcbnew once the Python API is happy again. This repo is specifically to cover only the official KiCad footprint library.

As I understand it you want to place every footprint (or symbol) in a library onto a PCB (or schematic canvas) automatically instead of dropping them down manually. This is not built-in AFAIK.

poeschlr, 2018-08-24:
The wizard is no longer necessary as the github plugin is no longer supported for the official library.

For managing local libs use the library manager.
More details here: https://forum.kicad.info/t/how-can-i-install-a-specific-version-of-the-footprint-library/9269

Closed 2018-08-23.

Thread 864 (2018-08-25):

why arduino footprints is mirror-like in the module.pretty.

shizi599, 2018-08-25:

bobc, 2018-09-30:
It's true, the footprints are mirrored.

An arduino looks like this \:

https://store-cdn.arduino.cc/usa/catalog/product/cache/1/image/520x330/604a3538c15e081937dbfbd20aa60aad/a/0/a000066_featured_4.jpg

The footprint looks like this \:

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

It is quite obviously mirrored about the X axis. I guess the idea is that if you are creating a shield, you would flip the arduino footprint so that the connectors are on the bottom of the shield.

The KiCad footprints are weird and no one else does it like this, personally I use my own versions.

jkriege2, 2018-09-30:
When I designed these footprint the decision for this "mirroring" was done consciuously: The idea is to see the Arduino as a component like all other components. Then the component should reside on top of the PCB (that's how we make the KiCAD library and if you want it on the bootom ... you just flip, as with all other components/footprints). Therefore it appears "mirrored", because you would have pinheaders on the PCB that you plug the Arduino into.

If you want to create a Shield, the Arduino is usually on the bottom. In that case you can use the footprint+flip, or youcreate a shield template, which simply contains the connectors on the bottom in the right positions

bobc, 2018-09-30:
I assumed it was deliberate.
> The idea is to see the Arduino as a component like all other components

The problem is literally no one actually does that. People design a shield which has the same orientation as the Arduino. If you flip the footprint, the silkscreen is then on the wrong side.

Was omitting the SPI connector deliberate too?

It's a shame, because the official KiCad Arduino footprints are basically useless. I really don't understand why we have to do it a different way to everyone else, based on one person's whim.

herostrat, 2018-10-01:
If you want to design a shield, why would you not use the arduino templates?

I think the argumentation makes sense:
Footprint is something you want to attach to your PCB. Because the arduino uno comes with female pinheader you have to do it that way

Templates give you the ability to design your own shield which attach to the arduino.

Those are different usecases.
And I really do not think that they are useless. Even if you would have to mirror them.

herostrat, 2019-01-17:
Is this issue settled?

I think important steps and notes from this things are:
 - Verify the differences and usecases of "footprints" vs "templates", define rules with the maintainers
 - Update the documentation accordingly
 - Recheck if all templates and footprints are correctly designed in such a manner
 - Monitor and push the template functionality

I will create a new issue that tracks these points, as I am currently working on templates myself.

---

@shizi599 do you have anything to add or do you disagree with my previous assessment?
If not, feel welcome to close this issue :)

Thread 904 (2018-09-01):

Bourns_PTV09A-1 questions

robkam, 2018-09-01:
I'm beginning to draw some potentiometer footprints, while following the KLC and looked at the [Bourns_PTV09A-1](https://github.com/KiCad/kicad-footprints/blob/master/Potentiometer_THT.pretty/Potentiometer_Bourns_PTV09A-1_Single_Vertical.kicad_mod) as an example, there are some aspects I don't understand.

Aren't pins 1 & 3 mirrored to what's on the data sheet?
KLC F4.2 - Pin 1 should be located at the top left? I suppose it's as close as it can be.
On one of the sides there's no clearance between F.CrtYd and F.Silk?

Also in general, wouldn't plated through be better for the mounting hole, e.g. less chance of pads coming loose during repairs?

evanshultz, 2018-09-03:
Since you reference the datasheet, it would be helpful to link to it. https://www.bourns.com/docs/Product-Datasheets/PTV09.pdf

Pin numbering:
Yes, but it doesn't matter. What matters is know the relationship between rotating the shaft and the wiper position. This is undefined in KLC now but I wrote up https://github.com/KiCad/kicad-symbols/issues/165 to capture the need to figure this out.

Pin 1 position:
The pot footprint generator script missed this requirement and I recall it being mentioned in a PR or issue I can't find now.

Silk/courtyard clearance:
This doesn't matter and isn't specified anywhere in KLC.

Plated mounting holes:
Yes, I agree they should be plated. They're not really mounting holes if they're unplated.

robkam, 2018-09-03:
Thanks.

Closed 2018-09-03.

Thread 932 (2018-09-10):

DF12C(3.0)-50DS-0.5V(81)

jneiva08, 2018-09-10:
Hi,

I'm making footprint for [DF12C(3.0)-50DS-0.5V(81)](https://www.hirose.com/product/en/download_file/key_name/DF12C%283.0%29%2D50DS%2D0.5V%2881%29/category/Drawing%20(2D)/doc_file_id/38626/),  the strange thing is it didn't mention mention how should numbering the pad's (or i can't see it).
Can you give me your opinion?

thanks

evanshultz, 2018-09-10:
I don't see it either, including looking at the DF12 catalog page from Hirose's website. So weird. I can't recall not seeing pin 1 called out or showing the pin 1 mark in the plastic of the part.

It appears all the conductors are evenly spaced from the component center, though, so the numbering could be similar to the existing Hirose BM24 headers. (That being said, those two footprints aren't really consistent even amongst themselves...)

Perhaps in this case the user selects the numbering scheme. I personally like having rows of even and odd, for what that's worth.

jneiva08, 2018-09-12:
@evanshultz
I did make all connectors of DF12C by script.
But if i give its original mame ex. DF12C(3.0)-50DS-0.5V(81) the kicad don't recognize because of "(" ")"
Can you advise the best option for the name?

Full name: Hirose_DF12_DF12C(3.0)-50DS-0.5V(81)_2x50_P0.50mm_Vertical.kicad_mod

Thanks

evanshultz, 2018-09-12:
I found https://www.hirose.com/product/en/products/part_no_conf/series_id/23/:
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

This character limitation is driven by KiCad itself and shown at http://kicad-pcb.org/libraries/klc/G1.1/. Parentheses are not allowed in footprint names even if you didn't run into this problem.

So, what to do?
1. I don't think readability is harmed if the first set of parentheses are removed, since there's a letter on one side and a hyphen after to separate the numbers.
2. And you can leave off the `(81)` at the end since that's the part packaging which we don't include in KiCad symbol or footprint names.

That would result in `DF12C3.0-50DS-0.5V`. Are you good with that? Do you feel that is clear enough?

jneiva08, 2018-09-12:
It makes sense.
I will modify the script to change the name and remove 80 because is discontinued. Then will open an PR

Thanks for the help.

Closed 2018-09-12.

Thread 955 (2018-09-18):

How to name top-side slug footprints?

evanshultz, 2018-09-18:
@poeschlr @jkriege2 @Ratfink @Misca1234 @antoniovazquezblanco
See https://github.com/KiCad/kicad-footprints/pull/947.

Check out the package from http://www.ti.com/lit/ds/symlink/tpa3126d2.pdf:
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

At https://github.com/KiCad/kicad-footprints/tree/master/Package_SO.pretty we have 4 slug up parts. two are manufacturer-specific footprint names and don't capture this. The other two include "EP" in the footprint name which doesn't quite seem right to me as the package has a slug but the footprint doesn't have an exposed pad. I think we should do better.

Do you guys have ideas on footprint naming if there's a top-side slug?

I suggest `HTSSOP-32_6.1x11.0mm_P0.65mm_SlugUp3.71x3.81mm` and just add the nominal slug size after `SlugUp` and omit the common `-1EP` which we can use only if the slug is on the bottom. Alternatively, we could do something like `EPUp3.71x3.81mm` or something by adding `Up` but that doesn't seem as clear to me.

LJJS, 2018-09-18:
My suggestion would be `HTSSOP-32-1EP_6.1x11.0mm_P0.65mm_EPUp3.71x3.81mm`.
The `-1EP` at the beginning is helpful to identify that the footprint has an exposed pad, and at the end of the name its defined which kind of EP is used.

Misca1234, 2018-09-19:
What does the 1 in '1EP' stands for ?

Another suggestion could be 'TopEP'

poeschlr, 2018-09-20:
I would name the footprints as if there is no EP and add a suffix. (After all the footprint does not come with an exposed pad)
The only reason for the suffix is such that we can have a separate 3d model for them. There is no difference on the footprint side to a package without such a pad. So add a suffix like `TopThermalPad[size x]x[size y]mm` (I know it is long but TopEP or TopPad might be confusing to users. It is also not really the same as the SlugUp thing we use elsewhere. That is for parts that are normally intended to be soldered to the pcb but are mounted the wrong way round. The slug is another name for the large "lead" of TO packages.)

DanSGiesbrecht, 2018-09-29:
@poeschlr @evanshultz @Misca1234 @Ratfink , revisiting this discussion with the hopes of finishing @LJJS 's PR's:
- https://github.com/KiCad/kicad-symbols/pull/889
- https://github.com/KiCad/kicad-footprints/pull/947

Personally, my thinking is that if a mechanical engineer is evaluating heatsink/case requirements, they won't rely on the KiCad-provided 3D model anyways, and would instead reference the datasheet for top-side exposed thermal pad dimensions. So, I would be content if the part didn't use a unique footprint.

That being said, I see the validity in creating a separate, unique 3D model. It does provide a reminder that there is an exposed area on the top of the part that needs to be taken into account.

I agree with a different name than "SlugUp" if that one's already being used.

Possible candidates that I can think of:
- TopThermalPad (as suggested by @poeschlr )
- TopHeatsink
- ThermalPkg

Maybe once we decide on a name here, I can open a KLC issue to clearly outline the use of "SlugUp" vs this use-case. Let me know what you all think!

evanshultz, 2018-10-01:
IMHO the options above are quite long. I suggested `SlugUp` for brevity but I understand having a small exposed thermal pad versus a top slug could differentiate an otherwise identical package.

Perhaps `TopPad[X dim]x[Y dim]mm`? It ties with the shortest suggestion above and don't imply a slug.

If you want to bring the mechanical engineer into it, and suggest they'll use different models, then I think we do need a unique footprint. How else will the mechanical engineer know a pair of SSOP-24 packages don't use the same model? By having a unique footprint we can embed that info into the design. And the footprint is associated with one and only one 3D model anyway.

Updating KLC would be good. It seems we've gotten rather lazy lately and let that doc being to rot.

DanSGiesbrecht, 2018-10-01:
I agree that shortness of the name is valuable. @poeschlr , you mentioned that `TopPad` or `TopEP` could be confusing, but if it's correctly documented in the KLC, I see no direct issue with that name.

antoniovazquezblanco, 2019-07-02:
This seems to have stalled. There are PRs depending on this. What would be the final veredict?

evanshultz, 2019-07-15:
I personally like `TopEP` and dimensions. I don't know why it would be confusing to anybody if they can already grapple with `EP` in the footprints names already, but if that's true then `TopPad` as I mentioned above.

Slugs are not only for TO-type packages. See every use of the "slug" at https://www.analog.com/media/en/training-seminars/tutorials/MT-093.pdf and https://www.st.com/content/ccc/resource/technical/document/technical_note/group0/89/b8/8f/9b/ed/7b/41/56/DM00454055/files/DM00454055.pdf/jcr:content/translations/en.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. It can mean the big TO lead, but that's not the exclusive use of the term.

evanshultz, 2019-07-22:
@poeschlr
Can you please weigh in again? I would like to think we're almost finished with this.

I want to submit a footprint for http://www.ti.com/lit/ds/symlink/tpa3251.pdf, and there are other PRs dependent on this as Antonio mentioned above.

evanshultz, 2019-08-07:
@poeschlr ? Or anyone else? I would like to close this issue.

poeschlr, 2019-08-08:
First of all i do not quite get why names should be short. The 256 character limitation is long gone so why should we use shorthand here. I personally prefer human readable without need to check any outside source. (Otherwise we could just use the IPC naming convention.)

TopEP does not work in my opinion as it is not an exposed pad (exposed pad is a strange name anyways but well the industry chose this term.) Similarly with TopPad (pad describes something that is meant to be interfaced with. In the context of pcb design something that is soldered.)

To be honest from the suggestions made so far i would use TopHeatsink as it is the only thing that describes the function of that thing without additional knowledge requirements. And a metal thing on the top of a package can only have the purpose of being a heatsink. (It is not ideal but no other suggestion is quite as clear and i personally do not have a better alternative either.)

evanshultz, 2019-08-30:
If I have two valid choices and one is shorter, I'm inclined to use the shorter one. Nothing about shorthand, only choosing a shorter word or adopting abbreviations already in use in the library.

I need to clarify, so let me step through the above:
- You note the word "pad" indicates something to be interfaced with, such as the exposed copper on a PCB which solders to a pad.
- Footprints have pads while packages don't. So using "pad" (or a variant like EP) is referring to the footprint and not the package.
- But the word "pad" is very commonly used in the industry for exposed metal on a package, such as "thermal pad". That is also an interface which is soldered, but in this case there is a pad on the board and a pad on the package. I believe this is what you're saying above.
- `TopEP` or `TopPad` indicates a pad but this type of package doesn't have a pad for the central thermal interface on the top of the package, it has some kind of lead.
- As the footprint and 3D model are related it may be reasonable to include either footprint-specific or package-specific info in the footprint name.
- `TopHeatsink` doesn't describe the package. Nor the footprint. And the heatsink itself, which is optional, wouldn't be included in the footprint or 3D model.

I can't reconcile that suggestion. Maybe I misunderstood.

If the name of the footprint should include the footprint uniqueness and the 3D model uniqueness, then any of them seem to work because it would differentiate from a footprint/model without any metal on the top of the package.

While the package doesn't have a pad as I understand you defined it above, the industry uses the term term "pad" for a large non-outer lead. And "EP" is already uses to indicate a footprint with a large non-outer pad in the library so there's already a common understanding of the term in the library. And the footprint and 3D model need to be a unique combination. So I simply can't see why "TopEP" isn't reasonable. It builds on the terms used in the library, sticks with terms already used in the industry, meets the requirements for uniquely-defining a footprint:model combination, and is brief. That seems like a workable suggestion, though I'm open to something else that meets all the requirements (which I may have misunderstood or missed). On the contrary, "TopHeatsink" fails on many of those counts.

evanshultz, 2019-09-25:
@poeschlr
Ping!

cpresser, 2019-10-12:
How about a `_ThermallyEnhanced` suffix?
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

chschlue, 2019-10-12:
I think _ThermallyEnhanced is misleading, HTSSOP is always thermally enhanced, just usually by having a bottom EP.

Two questions:
1. Top EP footprints are vanilla TSSOP, bottom EP ones are HTSSOP. Should these be called TSSOP or HTSSOP then? JEDEC MO-153 says HTSSOP has a thermal pad on the bottom while TI also calls these here HTSSOP, so following TI's naming would mean having loads of duplicate TSSOP footprints.
2. Should top EPs be present in symbols? If yes, how?

evanshultz, 2019-11-06:
Agreed. A lot of package types are 'thermally enhanced', and that isn't specific enough IMO.

1. The footprints for all are unique if we're to have unique 3D models. I don't think we can stick with a vendor's naming since it's specific to only one vendor. Does JEDEC have a package specification with a thermal pad on the top (I don't recall seeing one)?
2. I don't think so. If it attaches to a heatsink then the heatsink might have a pin on the schematic.

@poeschlr ?

chschlue, 2019-11-07:
1. I don't think so. The current lib is already quite messy when it comes to FPs with bottom EPs, so how about naming all standard packages without any exposed pad as usual, the ones with bottom EPs H<package>-1EP (as it is mostly the case currently) and regarding all the ones with top EPs as vendor specific until a standard comes up?
2. So they are completely ignored symbol- and footprint-wise if I understand you correctly? While this is an easy way to avoid FP filtering issues and such, I think it would be nice to be able to reflect that the top slug is connected to something via the heatsink in schematics somehow.

evanshultz, 2019-11-07:
1. I didn't even look at the TI datasheet, but it references JEDEC MO-153. I only see bottom-pad packages mentioned in that doc, though. From the footprint perspective, I'm fine with either nomenclature. Adding the leading `H` does clearly indicate they're 'thermally enhanced' which might be nice for filtering. As long as we have some way to differentiate standard, bottom pad, and top pad versions I'm good so we can have unique 3D models. And I still feel `_TopEP` works well.
2. That's my thought. I've added a heatsink symbol near the device that needs it and the heatsink symbol has the pin(s) required. I've also seen that in other schematics. If the top thermal pad has a pin it would get an electrical connection; is there a reason that net needs to be in the netlist?

chschlue, 2019-11-07:
1. MO-153 isn't really explicit about the thermal pad necessarily being on the bottom as far as I can see, it's just indicated by a bottom view showing a non-dashed pad. I assume that standardizing top EPs at least wasn't on anybody's mind there.
2. I guess you're right.

evanshultz, 2020-09-14:
@chschlue
It's been a while and this is blocking at least one symbol PR. You're also in a different position now. Do you mind revisiting this conversation and seeing if there can be a decision to move forward?

chschlue, 2020-09-14:
I favor `_TopEPXxY` for brevity.

Tangent: we should push for better 3D model association options for v7. It's a pity we have to add redundant footprints again.

Closed 2020-09-22.

Thread 973 (2018-09-26):

ErrType(19) - Pad near Pad issue with Resistor_SMD:R_Array_Convex_4x0402

leoheck, 2018-09-26:
I am using `Resistor_SMD:R_Array_Convex_4x0402` and I always receive this `Pad near Pad` issue on PCBNew

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

I tried to reduce the track width to fix it. But nothing has happened. Now, it is 0.05 mm (1.97 mil) and I still have the Pad near Pad issue.

Any idea on how to fix it?

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

Shackmeister, 2018-09-26:
That is a matter of board/DRC setup.
Since its pad to pad and not track to pad, the tracks has nothing to do with it

evanshultz, 2018-09-26:
This repo is for discussing the libraries. One good place to post "using KiCad" questions is on the forum: https://forum.kicad.info/.

The constraint being violated is pad-pad spacing, so of course changing the track parameters won't help. This is controlled by the Clearance parameter in the Design Rules.

leoheck, 2018-09-26:
Thanks @evanshultz

Closed 2018-09-26.

Thread 1000 (2018-10-08):

Thermally-enhanced SO-8 footprint design (PowerPAK SO-8, LFPAK56, PQFN 5x6, etc.)

evanshultz, 2018-10-08:
See https://github.com/KiCad/kicad-symbols/pull/924#issuecomment-427667192 which surfaced a good question about footprint naming. I hadn't looked into it closely until this valid question made me do some Googling and then propose the below.

https://www.nxp.com/docs/en/product-selector-guide/75017590.pdf mentions many variations of a thermally-enhanced SOIC-8 package. There is no standard package which may be the reason for the proliferation of similar packages. NXP has come up with a single footprint that allows broad compatibility with package from many vendors.

http://www.onsemi.com/pub/Collateral/AND9137-D.PDF takes the above work and slightly modifies the stencil openings to give less voiding after reflow soldering.

Making a footprint combining the above seems like a nice addition to our library since we have several symbols that could use the footprint.

However, we already have a few footprints available and so this is my proposal to clean things up:
1. Remove `Package_SO:Vishay_PowerPAK_SO-8`.
1. Any Vishay symbols using that footprint use the other PowerPAK footprint. If the final, optional item below is done that symbol update could be done here too.
1. Add the new universal footprint. I don't have a good footprint name for it; any suggestions?
1. Any non-Vishay symbols using the PowerPAK footprints get updated to use the new universal footprint.
1. [Optional] Add a `Vishay_` prefix to the existing PowerPAK footprints. Since PowerPAK is a Vishay-specific name (both docs above show that and I don't find that term in other vendors' datasheets) it's already a manufacturer-specific name without adding "Vishay", but KLC indicates using the vendor name so this would do that. This would require a further footprint and footprint filter update to Vishay symbols.

At the PR mentioned above I gave instructions to move ahead. We won't be losing anything and I'll do any clean up required if the above is accepted or we come up with a different path. I'll also create the new footprint and do any symbol linking required.

evanshultz, 2018-10-22:
Anybody read this and support it?

herostrat, 2018-12-11:
I really like the idea and the PDF on onsemi was a very interesting read.

I guess because every vendor seems to use a different name the problem would be to find the correct one if one adds a new symbol for a project.

Alias would be nice, but are not supported until v6 afaik, so for overview and versatility I think the naming you propose is ok.

We could open another issue that has the goal to correct the lack of alias or at least track it.

flaviut, 2019-08-12:
Has anyone created the AND9137 footprint? If not, I'd be happy to contribute it.

Thread 1003 (2018-10-09):

Relay Sanyou SRD Form C - swapped pins

LubosD, 2018-10-09:
Hi,

the schematic symbol for the Sanyou SRD Form C relay has pins 1 and 3 indicated as connected in off state. The footprint, however, has pins 1 and 4 connected.

The footprint is correct.

So either the drawing for the schematic symbol needs to be changed or the pins 3 and 4 must be swapped there.

See the pictures:
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

LubosD, 2018-10-09:
Here: http://www.sanyourelay.ca/public/products/pdf/SRD.pdf
And there's a Chinese compatible clone here: https://voron.ua/files/pdf/relay/JQC-3F(T73).pdf

Both have the same wiring diagram.

I have the Chinese clone in front of me and pin 1 is connected to the right pin (when viewed from the top - like in the footprint screenshot) in off state.

poeschlr, 2018-10-09:
Your observation is correct. I would suggest to change the symbol as the footprint now has the pads numbered in counter clockwise direction. (The numbering scheme would be strange if we would change the pad numbers instead of the symbol.)

evanshultz, 2018-10-12:
@LubosD
Will you be submitting a PR to fix this? I don't want to leave an error in the library now that you've caught it.

Soldering-Stan, 2019-02-12:
Hi I've just encountered this problem too :-(  Unfortunately the board has come back from the fab house and I've had to remove a component and solder it elsewhere to fix the problem.
I downloaded the latest version of the library and found it still contains the bug.
It looks as if LubosD has not noticed your offer of a fix.
What's a PR and can I submit one if it will help get the footprint corrected ?

S

LubosD, 2019-02-12:
I wanted to submit a PR, but then I updated KiCad and pins suddenly seemed to be OK, which left me unsure if the bug is fixed or not or if I messed something in my install.

Soldering-Stan, 2019-02-13:
Maybe you were lucky :-)
I cloned this repo and md5 checksummed kicad-footprints/Relay_THT.pretty/Relay_SPDT_SANYOU_SRD_Series_Form_C.kicad_mod
and also the installed Relay_SPDT_SANYOU_SRD_Series_Form_C.kicad_mod and got 2b49a2c945763bc859f3b4d67337a0b4.  I also had an old library and got a different checksum.  When I did a diff on the old and new libraries, it does appear that pins 3 and four have been swapped.
47,48c47,48
<   (pad 4 thru_hole circle (at 14.15 6.05 90) (size 3 3) (drill 1.3) (layers *.Cu *.Mask))
<   (pad 3 thru_hole circle (at 14.2 -6 90) (size 3 3) (drill 1.3) (layers *.Cu *.Mask))
---
>   (pad 3 thru_hole circle (at 14.15 6.05 90) (size 3 3) (drill 1.3) (layers *.Cu *.Mask))
>   (pad 4 thru_hole circle (at 14.2 -6 90) (size 3 3) (drill 1.3) (layers *.Cu *.Mask))
(that's Old, New above).
I'll do some more digging and see if I can work out which library is correct.  It's all a bit confusing - I tried swapping the files and editing footprints in the application but they both looked wrong.  It's as if the footprints are cached and I'm picking up the wrong version.
Cetainly the footprint I used is wrong.  I just don't know if it's the footprint from this version of the library or from the previous version.

Soldering-Stan, 2019-02-13:
Hmm - something got confused - I didn't type that in like that - and I used no formatting characters :-)

poeschlr, 2019-02-13:
githubs formating is strange sometimes. I think i fixed it for you.)

Soldering-Stan, 2019-02-13:
Thanks :-)

poeschlr, 2019-02-13:
Oh and by the way footprints are cached in the pcb file. So if you change something in the lib (like updating it) you will only see the changes after telling kicad to update the footprints already placed. (This is on purpose to allow you to share your project or look at old archived pcbs without danger to the file no matter how much the library evolved in the meantime)

And you could still have the version 4 library if you updated to version 5 without taking care of it: https://forum.kicad.info/t/i-had-kicad-4-installed-previosly-now-i-updated-to-v5-now-i-have-some-problems-with-the-library-setup/11932

poeschlr, 2019-02-13:
I just checked this again. The issue still exists. So you might not really have a problem with the cache or the library setup.

I will open a pull request with the fix shortly.

Soldering-Stan, 2019-02-13:
Many thanks.  I'm an end user of Kicad and haven't dug into the inner workings so wasn't sure where the problem was.  I was going to create a couple of projects to try both versions of the library but you have saved me that - thanks :-)

poeschlr, 2019-02-13:
Fix is found in https://github.com/KiCad/kicad-symbols/pull/1527

Soldering-Stan, 2019-02-14:
Many thanks.  I'm an end user of Kicad and haven't dug into the inner workings so wasn't sure where the problem was.  I was going to create a couple of projects to try both versions of the library but you have saved me that - thanks :-)

I have checked the symbols page and commented.  It does look correct now.
The relays I have are made by SONGLE in case somebody is searching for a footprint for a SONGLE relay.

Closed 2019-02-14.

Thread 1009 (2018-10-10):

PCB edge connector footprint datasheets

evanshultz, 2018-10-10:
As noted at https://github.com/KiCad/kicad-footprints/pull/996#issuecomment-428649751, none of our footprints have a datasheet attributing their design to a standard. That needs to be added and any dimensional changes to adhere to that standard made.

herostrat, 2018-12-11:
In addition to this I think it would be worthwhile to define how edge connector should be defined or if there are rules regarding them.

If you look into the PCIexpress one:
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

Imho the silkscreen is wrong on the button side and should be the same as in the others because it should not produce a silkscreen on the cuts on the final pcb
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

Also, is there a reason the pads are not rounded in that case?

I plan on doing the m.2 board connectors.
Before I start I wanted to define how they should be done.

herostrat, 2018-12-11:
I agree, the edge cuts should be defined properly in the footprint.
But isn't this not possible until probably v6? I thought 5.1 would not include this option.

Otherwise I also think making templates for standard boardsizes is also very useful and sufficient for most cases (https://bugs.launchpad.net/kicad/+bug/1808011)

dlharmon, 2018-12-13:
Here's what I've been using since the 4.x days, seems to work fine with 4.05:

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

These are generated with this:
https://github.com/dlharmon/footgen/blob/master/examples/pcie.py

[pciex1fingers.zip](https://github.com/KiCad/kicad-footprints/files/2677846/pciex1fingers.zip)

poeschlr, 2018-12-13:
It is possible to define edge cuts. It however requires a bit of blasphemy (in other words a text editor)

In v4 it was even worse as opening a footprint with edge cuts lines meant they where automatically moved to the silk layer. Now they should at least stay on the edge cuts layer. (Maybe we can get the devs to allow a better workaround for 5.1 than using a text editor. Just help me out on this bug report: https://bugs.launchpad.net/kicad/+bug/1251393)

Thread 1012 (2018-10-11):

audio jack symbols use letters; footprints use digits

ppelleti, 2018-10-11:
The footprints in `Connector_Audio.pretty` have numeric pin numbers, while the corresponding library symbols have alphabetic pin numbers.  This means they don't work together.

I first noticed this when I filed #979, but it also recently came up [on the forum](https://forum.kicad.info/t/connector-audio-stereojack-3-5mm-odd-pin-numbering/13038).

evanshultz, 2018-10-11:
Thanks for bringing this up.

You are correct in the forum that using letters was most consistent across all manufacturers, provides some intelligence about the pin's use, and also differentiates between the connector pins that go to different jacks (the jacks connected to the cable and inserted into the connector) with combo connectors.

See https://github.com/KiCad/kicad-footprints/issues/191. I have made, I think, new footprints that will match the symbols and will also update any existing ones when I push them. I've been (slowly) gathering feedback and consensus before submitting that PR. It was a mistake to leave this hanging in the v5 libraries and cause this user issue. Apparently I should prioritize getting the footprints wrapped up.

Closed 2018-12-03.

Thread 1020 (2018-10-16):

Right angle LED PTH footprints are backwards. Probably the SMT ones also.

cb88, 2018-10-16:
The cathode and anode are swapped on all the right angle LEDs relative to standard off the shelf LEDs.

Just open up any datasheet for a right angle through hole LED on digikey and you'll see with the LED facing you pin 1 (cathode) is on the right and 2 on the left. But all the footprints have this backwards.

This isn't as big a deal if you are using manually inserted right angle LED holder but if you buy a premade right angle LED.. it won't work.

The non right angle LED's look fine though.

evanshultz, 2018-10-16:
Thanks for reporting this potential issue.

Could you please provide at least one link to a datasheet? The parts you reference might not be the one I find. Do you find any datasheets where our footprints do work?

Then please confirm the footprints you refer to. Do you mean any one with `Horizontal` in the footprint name? For example `LED_D1.8mm_W1.8mm_H2.4mm_Horizontal_O1.27mm_Z8.2mm`, `LED_D3.0mm_Horizontal_O3.81mm_Z2.0mm`, and `LED_Rectangular_W5.0mm_H2.0mm_Horizontal_O3.81mm_Z5.0mm`?
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

cb88, 2018-10-18:
I'll provide at least 2 examples of each below (only these 2 of this type have any digikey stock anyway):
https://www.digikey.com/product-detail/en/vishay-semiconductor-opto-division/TLPR5600/TLPR5600-ND/4074661
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

https://www.digikey.com/product-detail/en/sunled/XSMG92D/1497-1359-ND/6615740
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

2nd Type:
https://www.digikey.com/product-detail/en/visual-communications-company-vcc/5300H5/L20015-ND/59969
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

https://www.digikey.com/product-detail/en/lumex-opto-components-inc/SSF-LXH104ID/67-1039-ND/270837
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

Not sure if type 3 exists? there are several similar designs but they all have board locks and varying pin arrangements.

jkriege2, 2018-10-20:
The footprints mentioned by @evanshultz are not meant for the types of LEDs you mentioned above. If you look at the 3D models this gets clear for case 3:
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

Maybe the closest to LEDs like your first two are side-emitters like this (there's only this one and some special ones in the Opto-Lib):
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
This footprint is for LEDs like this one http://cdn-reichelt.de/documents/datenblatt/A500/LED15MMGE_LED15MMGN%23KIN.pdf

For the horizontal LEDs in a plastic holder (cyour case 3; there are whole series of these e.g. from Mentor), there are no footprints at the moment ... if you have thime, you could add them? They would also be a good candidate for scripted footprints!

cb88, 2018-10-20:
Hand bent LEDs are irrelevant, you can orient them however you like... however the footprints are useless for the vast majority of available LEDs. From what I have seem 99% of available LEDs follow what I have said however if there are some that are in use that go the other way, perhaps the footprints should come in in either orientation, perhaps with a footprint name like LED_A1K2 LED_A2K1 etc... so it;s easy to tell. This really only matters for LEDs  that are at some angle or offset from the pins.

jkriege2, 2018-10-20:
Hand-bent might be irrelevant to you, but maybe not for others ... but that's not the point. The footprints are not MEANT for your case 3-LEDS ... footprints for these are simply missing! Even if they were oriented the other way, the silkscreen and F.Fab would not match your LEDs (also the pad to LED-distance might no correspond to the LEDs in datasheet case 3. Also the 3D model does not match you LEDs (e.g. because the black plastic is missing)

Therefore NAW/ADDITIONAL footprints & 3D models are required for the bent LEDs as in case 3. The same is true for the non-standard LED-packages in case 1&2. Fo all these mnufacturer-specific footprints would be best (the situation is comparable to e.g. all the screw terminals that we have in the lib, as they might differ slightly between manufacturers).

Would you be willing/able to contribute such footprints/3D models?

jkriege2, 2018-10-20:
PS: Most of the LED footprints are currently not manufacturer-specific, ... but they are also designed for the standard-LED-forms that are available from most manufacturers (3mm, 5mm, ...) If you have a look at the SMD LEDs, there are (in addition to the standard package 0805, 1205, ..., some PLCCs, ...) several manufacturer-specific footprints for LEDs with non-standard/manufacturer-specific shapes

jkriege2, 2018-10-20:
BTW: I tried to find some prebent LEDs (without the plastic), that would match the footprints we currently have ... but didn't find any that had a datasheet (only two from chinese shops without specifications&dimensions) ... are you aware of any?

evanshultz, 2018-10-23:
@cb88
As @jkriege2 said, we don't have footprints for the parts to which you're referring. The best solution would be to add footprints for them and then I think all will be well. Since it seems like you're interested in these parts, are you up for adding the footprints?

evanshultz, 2019-04-09:
@cb88
I gather the issue is that footprints don't exist for the parts you want to use. If correct footprints were submitted, then all would be well.

Can this be closed?

Thread 1024 (2018-10-16):

PowerPAK

jneiva08, 2018-10-16:
The PowerPAK package is exclusive to Vishay.

When search PowerPAK in footprint editor get this results:

* PowerPAK_SO-8_Dual
* PowerPAK_SO-8_Single
* Vishay_PowerPAK_SO-8

It appear Vishay_PowerPAK_SO-8 is the same of PowerPAK_SO-8_Single.
Should be removed one of single?

evanshultz, 2018-10-16:
With any apologies needed, I'm closing this. I already filed a similar issue with a proposal to resolve at https://github.com/KiCad/kicad-footprints/issues/1000. No response, yet, though. :(

Closed 2018-10-16.

Thread 1026 (2018-10-17):

Please make smaller KiCad-Logo2 footprints!

ElectricRCAircraftGuy, 2018-10-17:
For really small boards, 6mm tall KiCad logos are still way too big! Currently the smallest "Designed with KiCad" logo is 6mm tall: KiCad-Logo2_6mm_SilkScreen.kicad_mod.

Please make 5, 4, and 3mm tall versions as well. Given the simplicity of the logo, these versions would still be easily readable, yet not too big for tiny boards that are only 1" x 1" or so. Thanks!

evanshultz, 2018-10-17:
Great idea. Please submit a PR to this repo.

evanshultz, 2018-10-17:
KiCad includes an image importer.

I do not know the origin of the logos used, but @SchrodingersGat may. Since they're being scaled so much a logo from the KiCad website may suffice. Please provide attribution of the image source in the PR when you submit it, unless somebody else chimes in with an answer first.

ElectricRCAircraftGuy, 2018-10-17:
`git log --diff-filter=A -- KiCad-Logo2_6mm_SilkScreen.kicad_mod` reveals the commit number and author. Here's the commit #: cf680ed33f6dcd0f8dc9180501ca4c08470fab68. https://github.com/search?q=cf680ed33f6dcd0f8dc9180501ca4c08470fab68&type=Commits. @SchrodingersGat appears to be the one who committed it, but I don't know if he made it or not.

ElectricRCAircraftGuy, 2018-10-17:
Here's the PR: https://github.com/KiCad/kicad-footprints/pull/50

diegoherranz, 2018-10-26:
Actually because the footprint repos were merged into a single one some time ago, the original commit for it was on the Symbols.pretty repo:

https://github.com/KiCad/Symbols.pretty/commit/71f14541191605f13fa68c5ea9db9434b092aeb9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

There's a SVG link there.

herostrat, 2018-12-17:
https://github.com/KiCad/Symbols.pretty/commit/8f0c7423e40a22e9ffcae8913042583b99deaa16

codemonkeyrawks, 2019-01-02:
If we can I would like to see a 1mm logo, 2mm logo, 3mm logo, 4mm logo, 5mm logo being narrow. The board's I work with are typically 20mm at most and would look great if such logo could be added.

pointhi, 2019-01-04:
Please note the logo should be readable after manufacturing too :)

evanshultz, 2019-01-05:
Again, I believe the information is above to create new logos at other sizes. Then you may submit them to the library.

pointhi, 2019-01-07:
The "Designed with KiCad" was written inside PcbNew, exported as svg, added below the graphic and then imported as bitmap.

The easiest way to scale them down would be to write a script which applies a transformation matrix to every point of the polygon.

codemonkeyrawks, 2019-01-07:
@pointhi : can do. I will make a merge request when I am ready to have them be pushed in. I don't mind doing my own work as it's something I need to know how to do later on.

Thanks!

codemonkeyrawks, 2019-01-10:
@pointhi : thanks for the help: I have successfully updated a pull request here: https://github.com/KiCad/kicad-footprints/pull/1287. I am not sure yet if I will make a 4mm logo however 5 mm looks ok to use.

myfreescalewebpage, 2019-03-18:
@codemonkeyrawks I have just seen this issues, seems to be fixed with https://github.com/KiCad/kicad-footprints/pull/1287 and https://github.com/KiCad/kicad-footprints/pull/1312, right ? In this case I suggest we can close this issue. Joel

ElectricRCAircraftGuy, 2019-03-18:
I'm on my phone not a PC right now but it looks like that merge does not add 4 or 3 mm logos, does it? If it does not, then this issue is still open.

codemonkeyrawks, 2019-03-18:
@myfreescalewebpage : @ElectricRCAircraftGuy : I only created logo's that use: 5mm, 6mm, 8mm, 12mm, 20mm, 30mm, 40mm: (https://github.com/KiCad/kicad-footprints/tree/master/Symbol.pretty). As @pointhi suggested that anything real small may be more non-readable.

I did not fix: 4mm or 3mm logos in the accepted patch however 5mm is there.

ElectricRCAircraftGuy, 2019-03-18:
Thanks.
> As @pointhi suggested that anything real small may be more non-readable.
This issue is still open then, as there are tons of tiny boards people could really use the 4mm and 3mm logos on. Many boards are < 25x25mm in size, and the 3mm and 4mm logos would be perfect.

ElectricRCAircraftGuy, 2019-03-18:
@codemonkeyrawks , if you're willing to make the logos in 4mm and 3mm sizes too I'd be very appreciative, and so would many others. As far as readability is concerned, based on my experience with boards, **I have zero doubt that the main "KiCad" part would be very legible.** The readability of the "Designed With" part of the logo is certainly in question, but perhaps you could enlargen those words on the 4mm and 3mm logos to maximize readability of those 2 words.

myfreescalewebpage, 2019-03-18:
@ElectricRCAircraftGuy I have read above that 3 and 4mm logos will be very small to be readable and I agree with this. I suggest you should submit a PR with theses logos to check.

I'm not sure of the interest for logos on <25x25mm boards (where do you add the components if you put the logo ?)

Joel

ElectricRCAircraftGuy, 2019-03-19:
> I have read above that 3 and 4mm logos will be very small to be readable and I agree with this

Labels and other silkscreen text on PCBs is regularly as small as 32 mil, or 0.8mm. See JLCPCB's capabilities, for instance, here:

> Min. Character Height | ≥32mil | Characters height less than 32mil will be unidentifiable.

I have personally printed characters as small as 0.7mm and had the boards manufactured through JLCPCB, and the text was still readable.

I really can't understand where you are coming from. To claim that text that is 3mm tall is too small to read is rather mind-boggling to me, considering I have boards with readable text that is 0.7mm tall. Unless you are suggesting that all text on a PCB be constrained to 3mm tall or larger, I think that 3mm and 4mm logos are not only perfectly readable, but extremely easy to read.

To further explain: font size 8.5 point on a PC is approximately 3mm tall. (8.5 point font x [~0.35mm/point](http://www.unitarium.com/font) = 2.975mm)

I'm really not understanding how you think 3mm is too small, or what evidence your argument is standing on. Small print at the bottom of banking documents is frequently as small as 5 or 6 point font, and again, any PCB designer regularly uses fonts down to 1mm or so.

codemonkeyrawks, 2019-03-19:
@ElectricRCAircraftGuy : I personally never said I was opposed to smaller logo changes nor am I a full member of KiCad - I  only help out where I can while I can. There is a great tutorial you can look at if your even wanting to try and tackle this. (https://www.youtube.com/watch?v=vaCVh2SAZY4) - PCB Series for KiCad.

I will try and look to see if I can create both 3mm and 4mm logo sets and will submit a PR request soon (this may take time - at least 3 weeks or so) depending on resizing and fixing up. I have Boise Code Camp this week first I must get some code up on.

myfreescalewebpage, 2019-03-19:
@ElectricRCAircraftGuy don't be so aggressive please, I'm just a member of Kicad who has review let says about 300 or 350 pull requests in the past 4 months, so I'm not a major contributor ;-)

My initial intention was to check if this issue is still valid because we have an important backlog and I regularly try to check at open issues to get news, and ask if closing is possible when they are terminated.

The last messages before my message above is the 10th of January and the pull request of @codemonkeyrawks has been merged in January too, so the issue start to be a little bit old without any news. You should simply respond as many other people do, "the original question is still open I would like to keep the issue opened", and if you explain the last status of the issue, what is missing or should be improved, with a simple comment and ideally a screenshot, it's a must to have.

Cheers,
Joel

codemonkeyrawks, 2019-07-01:
@electricRCaircraftguy sorry for no merge on the smaller logos yet. I have been busy with other things at the moment to really get onto fixing this item. I will submit a merge soon you just might have to wait some time for now.

codemonkeyrawks, 2020-09-28:
@ElectricRCAircraftGuy can you remind me again here what we discussed on what might need to change still. I have some time now I might be able to submit the changes as appropriate here.

Thank you.

myfreescalewebpage, 2020-09-28:
@diegoherranz all the messages above are just some unuseful comments, just refer to the first one of this thread: https://github.com/KiCad/kicad-footprints/issues/1026#issue-370925806

codemonkeyrawks, 2020-09-28:
I found looking thought the comments what was discussed and created (https://github.com/KiCad/kicad-footprints/issues/2499) for such issue. I don't see any point in keeping an old bug open if we addressed this PR.

myfreescalewebpage, 2020-09-28:
Why opening a new issue for something which is already discussed ? This just break the history of the exchange. Closing the new issue. If you want to submit a PR, link it with this issue please.

ElectricRCAircraftGuy, 2020-09-28:
> @ElectricRCAircraftGuy can you remind me again here what we discussed on what might need to change still. I have some time now I might be able to submit the changes as appropriate here.

Thanks, @codemonkeyrawks, I just checked the footprints in the repo again to be sure (https://github.com/KiCad/kicad-footprints/tree/master/Symbol.pretty), and the smallest "KiCad-Logo2" footprints are 5mm:

1. KiCad-Logo2_5mm_Copper.kicad_mod
1. KiCad-Logo2_5mm_SilkScreen.kicad_mod

In this ticket I am still requesting 4mm and 3mm versions of that logo. See [my first post](https://github.com/KiCad/kicad-footprints/issues/1026#issue-370925806), and the title of this ticket itself: "Please make smaller KiCad-Logo2 footprints! (5, 4, 3mm tall)". I'd like to leave this issue open until 4mm and 3mm versions are created at a bare minimum (update: 2mm too). _However, I think 2mm versions should be created too_, so I'm going to amend the title to state that.

We should probably also make it standard practice to make logos down to 2mm height in general, and we should make a more simple logo which doesn't have multi-sized font in it, to go down to 1mm height, but both of these ideas should be new issues.

And sorry I haven't had time to contribute these logos myself. I'd like to get back to contributing to KiCad when able.

ElectricRCAircraftGuy, 2020-09-28:
@myfreescalewebpage, I think we should, as a general practice, include the .svg files in the PR, as part of the library package, whenever we create logos or footprints with them too. Ex: this svg file should be committed, as well as all other image files we use to produce KiCad footprints: http://www2.futureware.at/~nickoe/kicad_logo_for_patch_monochrome.svg. How would you suggest we do this?

Sample options:

1. For a KiCad footprint called `KiCad-Logo2_5mm_Copper.kicad_mod`, include the svg file as `KiCad-Logo2_5mm_Copper.svg`. Or, if a single svg covers many footprint files (I'm not sure on the mecanics of how to make a footprint from an svg yet), call it simply `KiCad-Logo2.svg`.
1. Make a new folder right at the repo root (https://github.com/KiCad/kicad-footprints) called `0_Graphics`. The 0 is just to force it to the top of the list to make it stand out. Inside this folder, you duplicate the folder structure of the footprints the graphic corresponds to. So, You'd put it here: `0_Graphics/Symbol.pretty/KiCad-Logo2.svg`.

I'm a fan of option 1 above to keep everything together in one place. We really need the graphics included whenever a footprint is made from them.

myfreescalewebpage, 2020-09-29:
Option 1 is my favorite too and you can submit like that if you make the new footprints. Do you have the original svg file to make the small footprint required ?

Thread 1045 (2018-10-23):

Fiducial inclusion in .POS file

thomasonw, 2018-10-23:
After  migrating to KiCAD v5, the board houses have been noting that Fiducials are not included in the .POS file.  I am able to point them to the .RPT file for the details, but is there a reason why they are not included in the .POS file as well?

I have noted that by manually editing the footprints and selecting 'Surface Mount' vs. 'Virtual' as the Placement Type will force the including of Fiducials in the .POS file.  Should be the default in the fiducial footprints?

(Perhaps also related --  [https://github.com/KiCad/kicad-symbols/pull/653](https://github.com/KiCad/kicad-symbols/pull/653) )

evanshultz, 2018-10-23:
So the behavior changed between v4 and v5? If so, that may not be a library issue. (A library change may be the solution, but perhaps not the source of the issue.)

I suggest you post at https://forum.kicad.info/ and/or https://launchpad.net/kicad for "how to" and possible bugs. This repo is only about the library, and we don't know your issue involves the library.

thomasonw, 2018-10-23:
Actually, I do not know.  I skipped over v4

I do know V3 (2013-07-07) did indeed include added fiducials in the .POS files.

thomasonw, 2018-10-23:
@evanshultz  -- OK, comment back from launchpad:  _"I believe this is a library issue these are made as virtual footprints, but should be SMD if they should show up in the pos file."_

[https://bugs.launchpad.net/kicad/+bug/1799601](https://bugs.launchpad.net/kicad/+bug/1799601)

antoniovazquezblanco, 2018-11-22:
I made it work by editing every fiducial to be locked (in order to be able to update my board without them dissapearing) and surface mount (to make them available at the pos file) in my PCB.

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

evanshultz, 2018-11-22:
OK. So you didn't find another solution but to change their type to SM.

antoniovazquezblanco, 2018-11-22:
Yes, that is it.

antoniovazquezblanco, 2018-11-22:
Should we change this in the library?

evanshultz, 2018-11-22:
Yes, otherwise users will run into this issue again and again. I created https://github.com/KiCad/kicad-footprints/pull/1104 and would like to see it merged for 5.0.2.

Closed 2018-11-29.

Thread 1064 (2018-11-02):

Raspberry Pi Footprint

jneiva08, 2018-11-02:
Where can find raspberry pi / shield footprint?
If don't exist in witch library should be made?

evanshultz, 2018-11-02:
I think you're looking for https://github.com/KiCad/kicad-templates. These templates should be installed with KiCad by default and available when creating a new project from a template.

If that's not what you wanted please let me know.

jneiva08, 2018-11-03:
not quite.
The idea was to have footprint where can easily can change F.Fab to Edge.Cut to be easy make a shield or simply have idea the size.
Since kicad do not support Edge.Cut on footprints.

I have done the following footprint:
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

Where should be placed?

evanshultz, 2018-11-05:
So you want to make a shield or hat for a Raspberry Pi Zero and this is to capture the board outline so you can add the circuitry for your shield/hat? I feel like I'm not understanding you so sorry that I'm slow.

myfreescalewebpage, 2018-12-04:
@evanshultz : @jneiva08 wants to have a symbol + footprint to easily create RPi HATs. Meaning with the PCB dimensions included in the footprint itself to avoid future issues when creating the board.

I have exactly the same need on Mini-PCIe I have pull requested few days ago : https://github.com/KiCad/kicad-footprints/pull/1124.

I have created the Edge.Cuts lines with a text editor, not with the footprint editor, so when inserting the symbol in my schematic, then going to PCB editor, I get the correct dimensions of the board immediately and there is no possible mistake since the footprint is validated. That's really help.

There is no KLC about this subject (Edge.Cuts in the footprint) and it would be nice to unlock it in the footprint editor. To be discussed but probably all developers working with Arduino, RPi etc etc will be happy with that !

Cheers,
Joel

evanshultz, 2018-12-04:
I'm still not sure why a template won't work. As I mentioned above, I feel like I'm just not getting something and it's probably my issue. But I still am not sure where a template is falling short. Here is the interface for selecting a RPi Hat which does include a base schematic, board with outline, and circuitry pushed from the schematic. On top of this base, more parts can be added to the schematic to make all different kinds of Hats:
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

You will need to contact the devs about allowing Edge.Cuts layer on footprints. They are available at https://bugs.launchpad.net/kicad. There was discussion a while ago about it so perhaps you will have momentum on your side?

Module.pretty is for footprints of purchased modules. I understand this request to be for a canvas on which a project can be designed.

poeschlr, 2018-12-04:
Edge cuts in footprints are partially allowed in version 5 already (they are no longer moved to the silk layer when opening a board)

The edge cuts layer will always stay partly unsupported to communicate the fact that this is a dangerous layer to be used in footprints. (It will be grayed out but one will be able to move drawings to it using the properties menu.)

More details see:
https://bugs.launchpad.net/kicad/+bug/1251393

myfreescalewebpage, 2018-12-04:
> Edge cuts in footprints are partially allowed in version 5 already (they are no longer moved to the silk layer when opening a footprint.)

No, it is still modified on opening.

poeschlr, 2018-12-04:
Not in current nightly. But don't open the properties dialog for such an element. It will crash the footprint editor.

evanshultz, 2019-01-21:
@jneiva08
I may be rather daft, but could you please help to elaborate on my questions at https://github.com/KiCad/kicad-footprints/issues/1064#issuecomment-444156117. I may be missing something but I'm not sure I understand and therefore could help to answer your question.

bobc, 2019-06-15:
> Module.pretty is for footprints of purchased modules.

The Raspbery Pi Zero is a module which can be purchased.

myfreescalewebpage, 2019-06-17:
There is a work in progress about this subject on the symbols, issue is at https://github.com/KiCad/kicad-symbols/issues/1772. Several PR has been submitted by @jstjst and I expect that he will be able to provide footprints too, but of course anyone can help on the subject!
Joel

jstjst, 2019-06-20:
I hope I will be able to get the remaining symbols pushed in near future. If someone would like to help with the footprints, I would appreciate it, so feel free.
Jonas

jstjst, 2019-12-22:
I (finally) started to work on the footprints. See issue #2016

Thread 1067 (2018-11-05):

Wrong SMD footprint for MeanWell IRM-02-XX

omogenot, 2018-11-05:
Hi,

There is a mistake in the footprint ACDC-Conv_SMMeanWell-IRM-02-XX. Looking at the data sheet (and the physical unit), there are only 2 x 7 pins (numbered up to 24) whereas the footprint in the library has 2 x 8 numbered up to 26.

evanshultz, 2018-11-05:
Thanks for posting this potential issue.

Including the datasheet and a screenshot would be helpful so someone can quickly verify.

The datasheet (https://www.meanwell.com/Upload/PDF/IRM-02/IRM-02-SPEC.PDF) shows:
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

Here is the footprint:
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

Yep, sure looks seriously messed up to me. And the IRM-03 SMD version appears to be equally hosed.

For completeness, here is the schematic symbol for the SMD version:
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

Fortunately, the schematic symbols looks good.

So it looks like pin 1 wasn't put in the right place, and the direction of pin increment was wrong, and the skipped pins were wrong, which all lead to only pin 13 being in the right place (and that just accidentally worked out). So this converter is totally unusable now. How very sad.

In addition to fixing the pin numbering, the fab and silk lines will need to be modified to correctly note pin 1's location.

It does not appear that these footprints are scripted, so I suppose they were handmade. Are you willing to submit fixed footprints?

Note: How did https://github.com/KiCad/kicad-footprints/issues/749 and https://github.com/KiCad/kicad-footprints/pull/750 get reviewed and merged but this serious bug remained??

omogenot, 2018-11-05:
Hi.
We're not looking for who made a mistake, I am the only one never making any :-) Don't worry.
I made the foot print mod, are you interested in it?

[ACDC-Conv_SMMeanWell-IRM-02-XX.kicad_mod.zip](https://github.com/KiCad/kicad-footprints/files/2550320/ACDC-Conv_SMMeanWell-IRM-02-XX.kicad_mod.zip)

antoniovazquezblanco, 2018-11-06:
Thanks, as soon as @evanshultz posts a PR I will take a look and merge it. Thanks!

evanshultz, 2018-11-06:
@antoniovazquezblanco
I was assigning myself to the issue and didn't realize I was on the hook to make the PR. :) Hang on and I'll submit it in a few minutes.

@omogenot
Thanks again for bringing up this issue and clarifying the datasheet's view.

evanshultz, 2018-11-07:
The fix is merged. Thanks again for reporting this issue!

Closed 2018-11-07.

Thread 1070 (2018-11-06):

Capacitor footprint names

evanshultz, 2018-11-06:
http://kicad-pcb.org/libraries/klc/F3.3/ specifies something different than the existing footprints names for both our THT and SMD caps.

THT:
THT caps don't have height in the footprint name even though height is known (the 3D model has a height) so our footprints are really missing information right now. Putting the footprint selection in CvPcb for a generic part like this means the user doesn't have to choose the height until the schematic is finished. It is a bit of a burden, but otherwise aren't we making decisions (picking capacitor height) on behalf of the user which is worse? I think height and pitch should be required attributes for radial caps. Perhaps in trying to combine the different body styles this section of KLC isn't clear enough and it should be separated by body style?

SMD:
The footprints include the X and Y dimensions at the PCB (most often these are the same) and optionally the height. Our existing footprints use the cylindrical body diameter and height. Since these packages are normally named like our existing footprints and lead pitch doesn't vary much or at all, I think a KLC update is best. Also, KLC doesn't consider these caps can be nonpolar. Perhaps something like `C[P]_Elec_[Manufacturer]_[Diameter]x[Height]_[X]x[y]_[Modifiers]_[Options]` with `Manufacturer`, `X`, `Y`, `Modifiers`, and `Options` being optional?

Relevant PRs:
- https://github.com/KiCad/kicad-footprints/pull/1019
- https://github.com/KiCad/kicad-footprints/pull/1030
- https://github.com/KiCad/kicad-footprints/pull/1032

seppestas, 2019-08-28:
I also find it pretty disturbing the library and KLC do not match on this. The KLC can also be seen as a form of documentation for the library, meaning right now the documentation does not match what is there, potentially causing a lot of confusion and mistakes.

IMHO it is better to have no documentation / KLC than having incorrect documentation.

poeschlr, 2019-08-28:
I would not use [diameter]x[height] as this could be confused with our normal [x]x[y] syntax. The proper fix would be to use D[diameter]mm_H[height]mm.

We could document the old style in the KLC. But with a note that no new contributions are allowed to be made using it and that it will be declared obsolete with v6 (could be a "can not release v6 till fixed" thing).

Might however be best to have a separate section that handles such known violations as i suspect there will be more.

--

Yes the KLC would ideally document how everything is right now. But in reallity it defines how new contributions must look like. (Some legacy stuff simply was forgotten to fix. The electrolytic caps seem to be such a legacy thingy.)

lorem-ipsum, 2019-10-11:
I wanted to add some more SMD caps to the library (from (Panasonic)[https://industrial.panasonic.com/cdbs/www-data/pdf/RDE0000/ABA0000C1181.pdf]), but stumbled into this issue along the way. Mainly I am not sure whether/how manufacturers should be added.

Current case are slight differences in the lead shapes of Nichicon and Panasonic, e.g. for 6.3x5.8 packages. I could add the manufacturer name in these cases, but I think it would be more consistent to have them on every footprint (similar to the `Capacitor_Tantalum_SMD` library). If all have them it might be better to have them towards the end, so that they are still sorted by size first.

I also realised that the definition list in the footprint generator are often based on the pad sizes of the manufacturers instead of IPC calculations. I would be up to update that list and change the generator to produce "correct" names to update all existing CP_Elecs for v6.

poeschlr, 2019-10-11:
The tantal case code was left in for legacy reasons. In reality the EIA code fully specifies the capacitor.

poeschlr, 2019-10-11:
Here therefore my suggestion
`C[P]_Elec_[Manufacturer]_[part number]_D[Diameter]mm_H[Height]mm_[Modifiers]_[Options]`

Manufacturer and part number belong together and are both optional (there to have a way to represent strange highly specialized manufacturer specific parts.)

lorem-ipsum, 2019-10-11:
This sounds good, but could generate issues as the lead sizes are not captured at all (they rarely are) and the size of the ground pad is not captured. Might be that this is not an issue.

I will try to find definitions for all existing footprints, update them in the generator with tolerances and see if any issues show up.

evanshultz, 2019-10-11:
> I also realised that the definition list in the footprint generator are often based on the pad sizes of the manufacturers instead of IPC calculations.

I re-wrote the generator to support IPC rules but left the existing footprints alone if all pad info is provided instead of lead info. The non-polarized footprints use IPC rules.

@poeschlr
Does you proposal for footprint name above take into account SMD and THT parts? SMD e-caps are not usually named this way. I have found the diameter and base X being common, sometimes also including the base Y dimension as well.

lorem-ipsum, 2019-10-11:
> I re-wrote the generator to support IPC rules but left the existing footprints alone if all pad info is provided instead of lead info. The non-polarized footprints use IPC rules.
I've seen that and used it for those I wanted to add. I am currently motivated to change the existing ones to the new generator as well to have a consistent base for the future. But I just found out that for some manufacturers it is difficult to specify the dimensions correctly as they only state maxima in some dimensions (e.g. outside lead length for [these](https://www.vishay.com/docs/28395/150crz.pdf)). Not quite sure how to handle this correctly.

poeschlr, 2019-10-12:
If the base size is needed as well then maybe (not sure if diameter should be before the bounding box size or after it)
`C[P]_Elec_[Manufacturer]_[part number]_[size x]x[size y]x[Height]mm_D[Diameter]mm_[Modifiers]_[Options]`

or (not really KLC compliant)
`C[P]_Elec_[Manufacturer]_[part number]_[size x]x[size y]mm_D[Diameter]mm_H[Height]mm_[Modifiers]_[Options]`

lorem-ipsum, 2019-10-14:
> The base size and diameter are typically the same size so i wonder if this is not redundant information.

This is not true. It depends on the manufacturer, e.g. Panasonic usually has slightly larger bases ([example](https://industrial.panasonic.com/cdbs/www-data/pdf/RDE0000/ABA0000C718.pdf)).

In general I would be in favour of using manufacturer specific namings, as they have slight differences in lead dimensions. While this is not always the case it is sometimes. Having manufacturer specific naming for everything would make it consistent for all (using the package/size code as `part number`). Otherwise there will be one "standard" footprint for one size which was the first to show up and all others will be manufacturer specific. The only alternative I see is to use the maximum dimensions and hoping that they do not contradict anywhere.

I also think there should be a consistent naming (as `Modifier`) for vibration-proof mounts. Currently there are already some (e.g. `CP_Elec_18x17.5` from [150 CRZ of Vishay](https://www.vishay.com/docs/28395/150crz.pdf)). I am not quite sure how to name them. There are two variants I encountered so far. The dominant variant are supportive terminals next to the standard leads. The second are two extra pads on the side (both show up in the 150 CRZ series, the first in the Panasonic series linked above). For the former some manufacturers use one large rectangle (e.g. Vishay), while others use smaller pads for the supports (e.g. Panasonic). I was thinking of something like `_SupportiveTerminals` and `_SideTerminals` as suffix.

poeschlr, 2019-10-14:
Well i would say we provide generic footprints that fit most applications and let the user handle creating footprints for their specific part if they have higher standards. Similar to how we do it for the normal chip packages (0805 for example is made to fit even the worst tolerances. This is why the clearance between the pads is surprisingly small for it)

Otherwise we will end up with way more than 10000 footprints just for electrolytics and i guess an order of magnitude more for standard passives.

lorem-ipsum, 2019-10-15:
Ok. I will just add more components and see how it is going. Currently I think one can get rid of the base size as the maximum value seems to be the same most of the time, just the nominal value and tolerances fluctuate a bit.

Another question (maybe not so much about the naming): Currently the manufacturer and series are included in the description of the cap. Should we stick to it?

antoniovazquezblanco, 2019-10-15:
Hello @lorem-ipsum

Beware of https://github.com/pointhi/kicad-footprint-generator/pull/396

I was trying to regenerate all the caps under the new name standard but you seem to be doing a more thorough job. Please, feel free to use my changes or request changes in that PR as I am willing to implement them ;)

Thanks!

poeschlr, 2019-10-15:
All dimensions in the footprint name should be nominal sizes. Sometimes manufacturers do not give nominal (especially for the height) so one is forced to use maximum.

Thread 1087 (2018-11-13):

TerminalBlock_Phoenix without mounting pad names

tolot27, 2018-11-13:
According to [KLC F2.1](http://kicad-pcb.org/libraries/klc/F2.1), connectors with mounting pads should be named `[count]MP`. The mounting pad of many connectors in `TerminalBlock_Phoenix.pretty`, especially, the PTSM SMD series, are not named at all.

The link in the `README.md` to https://github.com/pointhi/kicad-footprint-generator/scripts/TerminalBlock_Phoenix is also outdated.

antoniovazquezblanco, 2018-11-14:
Naming scheme has probably changed since the addition of that components. It would be awesome if you could submit a PR that fixes this.

Thank you very much @tolot27

tolot27, 2018-11-23:
Maybe, someone can comment on the linked issue. I'd like to continue

tolot27, 2018-11-30:
I'm about to create a PR but first I have to verify one thing. Currently, only connector symbols with one mounting pin such as `Conn_01x05_MountingPin` are available. The Phoenic-Conntact PTSM SMD series has two mounting pins.

If I use the `Conn_01x05_MountingPin` with a fixed connector (TerminalBlock with both mounting pads named `MP`) I get no warning after update of netplan. Then the two mounting pins are connected, which is not necessary.

Shall I create connector symbols with two mounting pins first?

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

tolot27, 2018-12-01:
Why do we need symbols with mounting pads at all? For ground pads it is obvious to me, but not for mounting pads.

Shackmeister, 2018-12-01:
See discussion here https://github.com/KiCad/kicad-footprints/is

tolot27, 2018-12-02:
Maybe, check scripts could be improved somehow to test for mounting pads. However, that would require a specification for validation.

tolot27, 2018-12-02:
What I still do not understand is that according to [KLC F2.1](http://kicad-pcb.org/libraries/klc/F2.1) the naming of mounting pads should be `[count]MP`. But most if not all connectors changed with #422 do not have numbered mounting pads. Are there any footprints with numbered mounting pads or is the KLC outdated?

tolot27, 2018-12-05:
Ah, sorry, I mixed things up. I thought the name of the pads should be prefixed with a unique number. Now I understand that the package name was meant.

Closed 2018-12-05.

Thread 1088 (2018-11-16):

Stencil configuration

jneiva08, 2018-11-16:
On RF_Module:ublox_SAM-M8Q, in the pads for stencil have Copper:F.CU and F.Past selected.
In Texas_VQFN-RHL-20 have pads for stencil are Cooper:None and F.Paste selected.

Witch are correct?

evanshultz, 2018-11-16:
The uBlox one is wrong. Paste pads should not have copper turned on.

In reality it won't matter here since the paste pads are totally inside the copper pads (and I think that should always be the case), but it's still against our paradigm. The check scripts are weak in helping to catch paste pads and so it's unfortunately easy to miss this during a review.

jneiva08, 2018-11-16:
I'm doing a new footprint for ublox 4G modem.
I never remember how need to make F.Paste, and was comparing the footprints and found it.
Later I will fix it.

jneiva08, 2018-11-16:
Have changed in the following PR [#1093](https://github.com/KiCad/kicad-footprints/pull/1093)

evanshultz, 2018-11-16:
That PR is merged. Thanks again! If this issue is answered, please close it.

jneiva08, 2018-11-16:
thanks

Closed 2018-11-16.

Thread 1095 (2018-11-18):

KLC vague on dimensions to use w.r.t tolerances

johnbeard, 2018-11-18:
The KLC documentations is vague on which dimensions to use. As I understand it, the implicit rules are:

* F.Fab: the shape is the *nominal* body outline of the part from the datasheet
* F.SilkS: The silk is just outside the *nominal* shape (so outset from the F.Fab by half the line width plus, presumably, "a bit"). The "bit" is also not well-defined, if the pads are not the outermost elements.
* F.CrtYard: 0.25mm (or more for certain types) from the outermost of the pads or body.

This could cause issues when a part has wide tolerances of the body. For example, imagine a (THT, so no pads outside the body) part that is 10x10mm +/- 1mm. If you draw the silk just outside the nominal, and a courtyard 10.5mm wide, if you get a part that is in-spec at 10.9x10.9mm, you will find it not only covers the silk but also spills out of the courtyard and might not fit when assembled.

I think the KLC should spell out in detail which dimensions one should use for each of Fab, Silk and CrtYd layers, and whether or not to account for tolerances specified in the datasheet.

evanshultz, 2018-11-19:
You are correct that KLC could use some improvement here. Some of these have been discussed already but I'm too lazy to dig up the relevant conversations.

The only comment to make is that the standard offset of silk lines from fab lines used in most of the librarian-developed (or -inspired) scripts use 0.11mm. This means the edges of the fab and silk lines touch. KLC specifies that silk should not be under SMT parts (and your comments about excessive tolerance may also have an issue with that) and 0.11mm offset is the minimum value that meets this rule.

Do you have a part in mind with dimensions and tolerance as described above, or are you only hypothetically postulating issues and pointing out good areas where KLC can be improved?

johnbeard, 2018-11-20:
A little bit of both.

I was looking at several parts like this:

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

The case only as a maximum size defined, and the position of that case WRT pin 1 is defined only in terms of maximum and minimum offsets from pin 1. Thus, in the x-axis only:

* The case edge on the left:
** Leftmost is position is as far left as possible: -2.62mm
** Rightmost is position is as far left as possible: -1.92mm
* On the right:
** Rightmost: when the case is at maximum and as far right as possible: -1.92 + 21.87 = 19.95mm
** Leftmost: not defined, as the case dimension doesn't have a specified "nominal" or "minimum" size, but in theory it would be -2.62 + case_x_min.

There is no explicit "nominal" for the position of the case, but you could average max and min and synthesise one. In this case, you get the left edge at -2.27. So the courtyard is at -2.27 - 0.25 = 2.52, and the silk line is centred on -2.27 - 0.11 = -2.38. If the case were at the leftmost position (-2.62), it's outside the defined courtyard by 0.1mm and covering the silk completely.

If you place two of these side-by-side courtyard-to-courtyard, and one was offset left and one right, you *could* get an overlap of 0.2mm of the physical parts. So the courtyard has failed its job, as you really wanted *at least* 0.5mm space, you got -0.2mm and you can't even get the parts into the PCB.

The KLC doesn't say the silk for THT *must* be visible (as you can reasonably put silk under a part), but IMO, an *outline* like this should be. Otherwise when assembling, it would look like something is wrongly placed.

Using the synthetic average placement size and the given case size max sizes for the Fab layer seems fine to me, it's a plausible graphic representation of the part.

To ensure this:

* Fab box from -2.27 to -2.27 to  21.87 = 19.60
* Silk from -2.62 - 0.11 = -2.73 to -1.92 + 21.87 + 0.11 = 20.06
* Courtyard from -2.62 - 0.25 = -2.87 to -1.92 + 21.87 + 0.25 = 20.20

But you would certainly get "empty" spaces inside the silk and courtyard when assembled, but you are guaranteed that the part will never cover the outline silk or go into the 0.25mm courtyard DMZ.

evanshultz, 2018-11-20:
I see. Thanks for the info.

Yeah, this drawing is under-constrained compared with most drawing I can recall. In this case, since MAX is the parameter they specify, I'd also be inclined to go generous and try and accommodate all possible individual parts that could be placed on a PCB. I'm not sure if there's any other way to do it, and with the official KiCad library being generalized I think having unused space on a board is vastly preferable to parts crashing.

IMO, this is a unique case and it may not be worth documenting in detail. The first few paragraphs at http://kicad-pcb.org/libraries/klc/ try to catch weird cases that only human intervention on a case-by-case basis can handle, and adding endless clauses for rare cases clutters up KLC for 99% of the common cases.

That all being said, you bring up many good points about valuable updates to KLC. I've added a few notes to my list of KLC updates which I'll include in a PR once I wrap up a couple other things. When the time comes I'll look into this more but I don't have any specific to contribute now. If you want to add or edit the existing KLC, certainly you're welcome. We can discuss more here or you can go right to a PR.

johnbeard, 2018-11-20:
I understand the KLC can't exhaustively go through corner cases.

I was thinking perhaps adding some fairly general guidelines, based on desired outcome. E.g.

* Fab layer outline are generally based on the nominal body size.
    * in this case there is no specified nominal, but a synthetic one from the average will do.
* Silk outlines should be visible for any variation of the part geometry that is within specified limits.
    * Perhaps a note of the de facto 0.11mm outset thing, even just as a note, rather than a rule?
* Courtyard outlines should maintain the relevant clearance (usually 0.25mm) regardless of part variation.

johnbeard, 2018-11-21:
I've made a provisional PR at kicad-website, but I am totally fine with having it closed and addressed differently if that's preferred.

https://github.com/KiCad/kicad-website/pull/355

poeschlr, 2018-12-04:
The requirement for nominal dimensions comes from industry standards. The reason for this is that maximum tolerances are normally never really reached (very low probability)
It is also hard to determine what maximum means. Especially for long chains of dependent dimensions.

johnbeard, 2018-12-12:
@poeschlr I'm OK with it being nominal dimensions, too, as long as it's documented. I suppose the risk of collision is pretty low for normal population density anyway.

Whatever is used, I'd still like to see these norms spelled out in the KLC for each of Fab, Silk and Courtyard.

poeschlr, 2018-12-12:
Just to be clear: If only max is given then we can only use max. But if we have the choice then nominal should be used.

johnbeard, 2018-12-13:
@poeschlr, so, in the "normal" case:

* Fab is lines centred on nominal
* Silk is nominal, outset by a small amount - so that silk and fab lines just touch. This is generally therefore 0.11mm.
* Courtyard is nominal, outset by 0.25mm (or more for certain parts)

"Nominal" means that first of:

* The nominal size if given in the datasheet (eg 42mm +0.2mm - 0.3mm --> 42mm)
* Else the average if just the max and min are given (40mm to 41mm --> 40.5mm)
* Else the max if that's all there is

poeschlr, 2018-12-13:
About right. For silk we really do not have strict rules other than the must be outside the nominal part and have a clearance to pads (0.2mm for large parts. line with for smaller ones.)

The courtyard has a nominal clearance depending on device class. For most devices it is 0.25mm. (Details see KLC)
Ideally you would make a "temporary" polygon around the body outline and every pad with that clearance applied. Then union all these "temporary" polygons to get the correct outline. It is allowed to simplify this. Even down to having a single rectangle that only takes the bounding rectangle of the footprint as its basis. (The more detailed the courtyard is the fewer false positives will occur in the DRC check. The tradeoff is the increased work required to design and check it. In addition the calculation effort for DRC will also increase with very complex courtyard outlines.)

Thread 1102 (2018-11-21):

Push Button 12 mm has very thin holes

leoheck, 2018-11-21:
My 12mm push button can't fit on top of  `Button_Switch_THT:SW_PUSH-12mm` footprint.

The holes should be increased a litle bit.
It can be increased at least with the holes size used in `Button_Switch_THT:SW_PUSH_6mm`.
Which means changing the hole diameter from `0.8128` to `1.1`.

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

poeschlr, 2018-12-04:
You are right the hole sizes are too small. The datasheet linked to this footprint would require a hole size of 1.3mm. Right now it has 0.8128.

It looks awfully like the pad sizes and hole sizes have been convered from imperial measurements. So this fp might have been unchanged in the lib for quite some time. I would assume it is that way since before v4.

leoheck, 2018-12-04:
I discovered that one day after to place my PCBs order. I just replaced the small push button with the bigger one then I placed the order. I didn't have time to verify it at that time.

Its ok, the workaround should not be complicated.

I will be glad to see this fixed on the next library update.

leoheck, 2018-12-30:
@poeschlr do you know if there is any way to verify the whole footprint library looking for issues like this?

crazyquark, 2019-06-28:
I was hit by this too(sadly discovered after making the PCB).

leoheck, 2019-06-28:
OMG, does this still have problems?

Who responds for this repo? Should we fix it and send a PR? How it works to
accelerate the bug fixes?

On Fri, Jun 28, 2019, 7:04 AM Cristian Sandu <notifications@github.com>
wrote:

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

evanshultz, 2019-06-28:
@leoheck
How would you verify the library for this kind of issue? The datasheet, and in some cases the physical part, are required. Do you have a proposal for how this could be automated?

Unfortunately, some parts of the library are crufty and this was a bad footprint. Or perhaps it worked for somebody but not for your switch. It's not well-specified.

New contributions are more rigorously reviewed and checked but reviewing and updating all old parts is done slowly if at all. It's sad when we find problems like this, but it's great you had the initiative to mention it here. Following up with a PR is the best way to make it happen. This is a community library with a few volunteer librarians and your support for new contributions and fixes are very important. Someone has to make a personal investment in time actually make the fix, not just mention it, to get the fix in the library.

@crazyquark
Thanks for making the PR to correct this. Sorry about the bad boards. :(

leoheck, 2019-06-29:
@evanshultz thanks for answering.

I was not talking about automation, I was impressed that it wasn't fixed since ` Nov 21, 2018` when I reported it. I agree we don't have a way to check things like this automatically without human intervention. But it was an issue report. The fix is easy, and a bigger hole, in this case, is better than a small hole.

But, it is ok lets move on and @crazyquark thank you too for the PR.

> Following up with a PR is the best way to make it happen.

Cool, next time, I will make the PR and the issue report at the same time, so we can work together.

evanshultz, 2019-06-30:
Merged https://github.com/KiCad/kicad-footprints/pull/1667.

Closed 2019-06-30.

Thread 1103 (2018-11-22):

Naming convention of the valve foot prints

Misca1234, 2018-11-22:
I am scripting the valve foot prints, the ambition is to replace the existing foot prints with new ones

My intention is to fix the foot prints then the 3D models and then update the symbols

But I want some consensus about the names of the foot prints
Valve_Magnoval_B9D-9_D30.00mm_P17.45mm_A36_RP.kicad_mod

where
Valve is the function
Magnoval_B9D is the "serie"
9 is the number of pins
D30.00mm says it is 30 mm
P17.45mm defines the diameter of the circle where the pins are placed
A36 Says that the angle between the pins is 36 degree
RP points to round pins (there is oval pins as well)

The foot print will always assume that there will be possible to place the tube directly onto the pcb or via  socket and in those cases where the tube have a spigot, it will be mounted in a socket.

The sockets I have currently chosen are
Magnoval_B9D
Noval_B9A
Miniature_B7G
Loctal_B9G
Loctal_B8G
Decar_B10G
Octal_K8A

Or should we just name them as
Valve_Magnoval_B9D_RP.kicad_mod

https://en.wikipedia.org/wiki/Tube_socket

They , kinda look like this now

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

Misca1234, 2018-11-23:
If no one objects I will name them like this

Foot prints
Valve_ZZZZZZZ-XX-YYYYY

3D models of sockets
Valve_Socket_ZZZZZZZ-XX-YYYYY_AAAA

3D model of tubes
Valve_Tube_ZZZZZZZ-XX

ZZ is an arbitary string such as  'Magnoval' or 'BELTRON_VTPCX_9'
XX will be real identifier used in the foot print filter, such as 'K9A, 'M10G'

AAAA will be a string like this "D13.00mm_TTT'
Where D13.00 describe the diameter of the circle on which the holes are placed
TTT Can be 'Pin', 'Ear' 'Pigs'
to distinguish the type of pin, like these
http://belton.co.kr/inc/downfile.php?seq=58&file=pdf

So the standard B9G will be named
FP:    Valve_Loctal-B9G-D21.00mm_Pin.kicad_mod
3D model of socket:    Valve_Socket_Loctal-B9G-D21.00mm_Pin.kicad_mod
3D model of tube:    Valve_Tube_Loctal-B9G-D21.00mm_Pin.kicad_mod

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

Misca1234, 2018-11-25:
Closing, see push
https://github.com/KiCad/kicad-footprints/pull/1111

Misca1234, 2018-11-25:
Closing, see push
https://github.com/KiCad/kicad-footprints/pull/1111

evanshultz, 2018-11-26:
I like the simplified naming scheme since, if the manufacturer and tube type define the pin layout, other information is superfluous.

Three things to note:
1. I believe you should put underscores between sections, so `BELTRON_VTPCX_9` should be `BELTRON-VTPCX-9`.
1. The footprint filter should probably start with `Valve` for best matching.
1. Why would the footprint and (valve) model not have the same name? They match and the valve could be soldered directly to the PCB. Adding `_Socket` to the end could indicate the socket's 3D model and would also match all the preceding footprint filter so picking socket or not-socket in CvPcb is easier.

Misca1234, 2018-11-26:
The XX uniquely identify the foot print (and therefore the socket), that is, in the foot print name
Valve_Loctal-B9G-D21.00mm_Pin.kicad_mod

Valve_Loctal D21.00mm_Pin is really not needed, so the foot print filter will be `*B9G*` or `Valve*B9G*`
The diameter is needed to distinguish different sockets form each other unless the manufacture series identify it.

> Why would the footprint and (valve) model not have the same name? They match and the valve could be soldered directly to the PCB.

> Why would the footprint and (valve) model not have the same name?

The valve is only extra candy, the "important" thing is the socket

I was thinking of this but I do not believe that anyone will solder vacuum tubes directly to the PCB because they break down more often than, say a transistor, however the foot prints I made is for sockets that is 1:1 to the valve or soldering the tube directly to the pcb.
Currently the The 3D models is jsut to show more graphics, it is only the belton one that is a "true" socket

Currently the end is pin or tap to distinguish between
http://www.belton.co.kr/upload/photo/photo_1476681172.JPG
http://www.belton.co.kr/upload/photo/photo_1476085686.JPG

and even perhaps 'ear' for
https://i.ebayimg.com/images/g/TWIAAOSwygJXggyN/s-l300.jpg

Misca1234, 2018-11-26:
Btw
When point have meged my foot print script I will update it with some extra fetures so we can make sockets like this

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

Misca1234, 2018-11-29:
Let try this, Belton do one socket of the B9A type, it's name is VT9-PT
http://www.belton.co.kr/inc/downfile.php?seq=58&file=pdf

If we name the naked foot print to
Valve_Noval-B9A_BELTON-VT9-PT.kicad_mod

The foot print with 3D models
Valve_Noval-B9A_BELTON-VT9-PT_Socket.kicad_mod

The 3D model of the tube can be named
Valve_Tube_Noval-B9A-D11.89mm_Pin

Then the FP filter can be
Valve_Noval-B9A*
Which catch both the "naked" foot print and those with 3D models but not the 3D model of the tube

evanshultz, 2018-11-30:
I think we should settle on "tube" vs "valve". You're using both terms above but the official library now has a library named Valve. So the usage of "tube" above is not intentional, right?

I'm a bit confused by the above and I think it may just be typos. Let me re-write it and please let me know if the below is correct.

If we name the naked foot print to
Valve_Noval-B9A`(_BELTON-VT9-PT)`.kicad_mod

The foot print with `(3D models) socket`
Valve_Noval-B9A_Belton-VT9-PT_Socket.kicad_mod

The 3D model of the socket can be named
Valve`(_Tube)`_`Belton`-B9A_Socket.wrl

The 3D model of the tube can be named
Valve`(_Tube)`_Noval-B9A.wrl

Then the FP filter can be
Valve`*`Noval`*`B9A*

A few things I think about reading through this:
1. The combined 3D model of the socket and the valve is not above. I assume there should be one so th user can see that. It will be a single model name like the second item above, right?
1. Would a nice naming format be `Valve_<valve manufacturer>_<valve MPN>_Socket_<socket manufacturer>_<socket MPN>`. This is essentially moving the work `Socket` up so it's like a divider between the valve info and socket info.
1. We want a generic valve symbol that doesn't care about the socket. A footprint in 5.1 can support multiple 3D models all together, so the same valve footprint could be reused and combined with various sockets (each socket + valve combination would need a unique footprint). That would require the valve Z offset to not be zero which, if we go that route, requires a KLC adjustment.
1. The official library is not going to capture every single socket. If the bare tube is provided, at least that's a starting point for users. If there are a few socket options for each valve then we probably have good coverage and hopefully more PRs fill in the gaps later. How do you decide what sockets to include?

Misca1234, 2018-11-30:
> I assume there should be one so th user can see that. It will be a single model name like the second item above, right?

The idea was to combine two different 3D models, not make one 3D model that includes both a socket and a valve.

> Valve_<valve manufacturer>_<valve MPN>_Socket_<socket manufacturer>_<socket MPN>.

I think that would be a bad idea

> The 3D model of the socket can be named
> Valve(_Tube)_Belton-B9A_Socket.wrl

A specific socket, such as Noval-B9A is not for a specific tube, many tubes fits that socket.

> The official library is not going to capture every single socket.
> How do you decide what sockets to include?

It is a mix of the existing ones, what is said on https://en.wikipedia.org/wiki/Tube_socket about which ones that are still in use and I tries to get some feedback from the users at https://www.radiomuseum.org

It is difficult to find any manufactures of the ordinary valve socket, such as
https://www.conrad.com/ce/en/product/130552/Vacuum-Tube-Valve-Holder-Base-Magnoval-Fitting-type-details-PCB-Description-Ceramic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

Belton is essential the only one I found. When I asked http://audionote.co.uk they said that the manufacture of the socket they sold was no longer producing them. I have not got a response from https://www.conrad.com/ce/ yet, who makes the socket they sell.

I think it would be enough to name the sockets as
Valve_<valve MPN>_<valve manufacturer>_Socket.kicad_mod
Valve_<valve MPN>_<valve manufacturer>_<valve MPN>_Socket.wrl/.step
an example
Valve_Noval-B9A_Belton-VT9-PT-C_Socket.kicad_mod
These foot prints will have a dummy 3D model of a tube on top of them

and the symbol
<valve MPN>

There is really no point to have specific 3D models of a specific tube, no one solder them directly to the PCB

Misca1234, 2018-12-01:
After been corresponding on radiomuseum wit ha guy
https://www.radiomuseum.org/forum/seeking_help_with_foot_prints_in_kicad.html?thread_id=500265

It essential boils down to this.

1. Having footprint's for soldering tubes directly to PCB is near pointless due to the heat that the valve produce, it will affect the pcb to much and sucks to replace.

2. Having PCB sockets is a somewhat bad idea due to heat produced by the valves and the force needed to insert the tubes into the sockets (breaking copper lines on the PCB etc.), the guy in the thread already encountered this problem during the 1960's.

3. There is really no standard around the sockets anyway, so the designer of the PCB is left to use sockets that is highly manufacture specific and might be available over a longer time.

4. Overall recommendation is to use panel mount sockets and then connect the valve via wires to an ordinary contact to the PCB.

5. It is way more important to have the symbols in order and then leave the decision up to the designer on how to connect the valve (from the panel socket) to the PCB.

I will make some manufacture specific foot prints just so KiCad have some and then spend time on the symbols. The issue of how to name the foot prints etc. is a minor issue because it will never "take off".

Closed 2018-12-27.

Thread 1105 (2018-11-23):

outer pads of SMD resistor arrays are not placed correctly

tolot27, 2018-11-23:
If you look at #973,
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
as well as [cra04p.pdf](http://www.vishay.com/docs/31048/cra04p.pdf), you can see that the outer pads are not placed correctly.

tolot27, 2018-11-23:
I cannot create a PR until I know what happened there: https://github.com/pointhi/kicad-footprint-generator/issues/220#issuecomment-441329659

evanshultz, 2018-11-24:
I'm not sure why the linked question above, about Phoenix terminal blocks, has any relevance here...

Also, a misunderstanding of the design rules does not mean the pad placement is wrong...

There's no enough information above to chase down a potential issue. If the footprint above is not meant for the CRA04P part, then it may not match. Perhaps the 3D model is wrong? Here is what would be helpful: To what footprint(s) are you referring? It appears to be one of the `R_Array_Convex_4x` ones (though not the 1206 version) but there's no way for anyone but you to know. And none of those footprints reference the CRA04P datasheet.

tolot27, 2018-11-25:
> Also, a misunderstanding of the design rules does not mean the pad placement is wrong...
So I misunderstood something?

Sorry for the inconvenience. Likely, it was to late to create the ticket because it does not fulfill my own requirements.

I have used the Resistor_SMD:R_Array_Convex_4x0402 footprint which referes to [mnr_g.pdf](http://rohmfs.rohm.com/en/products/databook/datasheet/passive/resistor/chip_resistor_network/mnr_g.pdf) and not cra04.pdf. I'll check further, what is wrong.

evanshultz, 2018-11-26:
The footprint looks like it's correct for MNR04 to me, so the 3D model may not be built to the same document.

Here are a few from our current library (convex 4x0402, convex 2x0402, convex 4x0603, concave 4x0402):
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

Thanks for digging up any more information.

Looking online, it appears that there are actual a number of different packages for "0402", isolated, quad, convex, resistor arrays. Perhaps our footprints names should be more specific since not all parts that would seem to fit a `R_Array_Convex_4x0402` footprint are actually compatible.

poeschlr, 2018-12-05:
You are correct about the fact that we do not yet have a script for these type of parts.

Thread 1113 (2018-11-26):

Footprint 12BH611-GR: wrong pins

frarees, 2018-11-26:
I used 12BH611-GR as a footprint for a Device/Battery.

12BH611-GR, from a top view, having the snap on the right side:

- Pin 1 is used for the negative side (upper)
- Pin 2 is used for the positive side (lower)

But in order to work with Device/Battery, it should be:

- Pin 1: positive side (lower)
- Pin 2: negative side (upper)

I went ahead and changed it in my local copy, and verified that everything worked the way it should after swapping the pin numbers.

evanshultz, 2018-11-26:
Thanks for reporting this potential issue. I see this is your first post here, and I'm sorry it's because of a problem but thanks for taking the time to let us know!

The datasheet is always helpful so we can all understand the problem. I found https://www.mouser.com/datasheet/2/209/EPD-200766-1274481.pdf and it shows this:
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

Here is the footprint in our current library:
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

Both have the snap on the left side and the pinout matches with negative on the top.

Also note that pin 1 is negative.

And here the schematic symbol that would go with this footprint you mentioned above (Device:Battery_Cell is the same pinout):
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

Pin 1 is positive. So that's the issue. The pin numbers of the pins on this footprint need to be swapped.

I checked all other footprints with a "+" marked in them (I didn't check unmarked ones) and pin 1 is positive elsewhere, so this is the only broken footprint I found.

Sorry that you ran into this issue but thanks again for reporting it. Are you willing to make a PR to fix this?

frarees, 2018-11-26:
Hey @evanshultz, thanks for reaching out. Really appreciate your time and your response.

I will send a PR later today including the pin swapping.

Closed 2018-11-27.

Thread 1120 (2018-11-29):

Fiducial questions

antoniovazquezblanco, 2018-11-29:
Some of those fiducials in the lib are really massive. Should they still exist? What are they used for? Do they conform to any standard?

Could you please explain to me why there are fiducials in bottom layers with silk refdes in the top ones? Shouldn't bottom layers use mirrored top layer fiducials? Why do those exist?

poeschlr, 2018-12-04:
These might simply be there for legacy reasons. I would suspect that they where unchanged in the lib for a very long time. So if you have the time to update them to better standards go ahead.

As far as i am aware it is kind of untypical in todays environment to include them at all. At least on the user side. The fabs might add them outside of the board area. (They will however use their own tools and specialized "footprints" for this.)

herostrat, 2018-12-11:
I just want to chime in on the use of fiducials:
I am currently in the process of getting a board of mine fitted in a fab.

Most fabs I spoke to and that sent me their guidelines prefer and often demand fiducials.

Also look into projects like: https://github.com/openpnp/openpnp
Optical recognition and recalibration is an important step and fiducials are used.

herostrat, 2018-12-11:
Yeah no problem, would love to help out.
I was a quite busy the last months with my masters so my contributions were not as much as I hoped.
Currently there is a bit of downtime to help out.

One important addition for me was already added from someone else (https://github.com/KiCad/kicad-symbols/pull/1131). With it you don't need to fix the footprint in order to get a correct POS file as you all correctly found out in https://github.com/KiCad/kicad-footprints/issues/1045.

I will accumulate the data and see what makes sense (and what I am allowed to publish for reference)

herostrat, 2018-12-17:
I just called two fabs.

The unanimous assertion is that for nearly all cases they prefer and want round fiducials in the dimension of which I wrote/the forum post produced.

Silkscreen marks are not recommended at all and should not be used.

There are a view cases in which the soldermask opening can and should be different (in most cases quadratic) if otherwise the orientation of the board is not discernible because of symmetry.

I do not think bottom layer fiducials are needed at all.

---

I propose to delete _all_ fiducials except:

 - Fiducial_0.5mm_Dia_1mm_Outer
 - Fiducial_0.75mm_Dia_1.5mm_Outer
 - Fiducial_1mm_Dia_2mm_Outer

I do not know how you guys handle backwards compatibility?
No symbol has an atomic footprint to any fiducials associated to it.

If it is ok for, I will create a PR removing the other fiducials.

evanshultz, 2018-12-17:
@herostrat
This is great research! Thanks for pulling this all together.

Note that Figure 3-13 of IPC-SM-782 shows some other fiducial styles and their sizes. I've never seen it used and am OK removing them, though.

I've typically used a 1mm fiducial everywhere but have been asked by some CMs to use a 1.5mm fiducial (and it's referenced in several of the documents/sites above), so I'd also include that pad size.

Also, should we include the 3R mask diameter instead of just 2R? My own experience is that using the smaller size is probably the most common by far, and if it's requested we could add it later.

Lastly, I think the naming could even be simplified a bit. How about this (adding the one I suggested):
- `Fiducial_0.5mm_Mask1mm`
- `Fiducial_0.75mm_Mask1.5mm`
- `Fiducial_1mm_Mask2mm`
- `Fiducial_1.5mm_Mask3mm`

With regards to deleting them, I would think perhaps they get moved to an obsolete folder (it doesn't yet exist for footprints) for 5.1 (unless we decide to push that back to v6). That gives us a chance to get feedback from users that are impacted and tweak our process.

poeschlr, 2018-12-17:
moving them to obsolete might indeed be the best option. This allows users who want them to easily get them (getting them from git might be a bit too much for some of our userbase)

herostrat, 2018-12-18:
I like the idea of also including the 3R variants. I personally prefer them if there is enough space.

That would give us:
 - Fiducial_0.5mm_Mask1mm
 - Fiducial_0.5mm_Mask1.5mm
 - Fiducial_0.75mm_Mask1.5mm
 - Fiducial_0.75mm_Mask2.25mm
 - Fiducial_1mm_Mask2mm
 - Fiducial_1mm_Mask3mm
 - Fiducial_1.5mm_Mask3mm
 - Fiducial_1.5mm_Mask4.5mm

The description would be something like this:
Circular Fiducial, %f bare copper, %f soldermask opening; (additional note)

With additional note beeing for:
 - Fiducial_0.5mm_Mask1mm: Level C
 - Fiducial_0.75mm_Mask1.5mm: Level B
 - Fiducial_1mm_Mask2mm: Level A
 - Fiducial_1mm_Mask3mm: Recommended

herostrat, 2018-12-18:
The updated fiducials are now merged.

Thanks for the fast responses!

antoniovazquezblanco, 2018-12-19:
Thank you!

Closed 2018-12-18.

Thread 1131 (2018-12-03):

Capacitor_THT: C_Rect_* have wrong descriptions

antoniovazquezblanco, 2018-12-03:
Example:
https://github.com/KiCad/kicad-footprints/blob/ccb39e2c536404e47239b91ad5bd3abc4e689980/Capacitor_THT.pretty/C_Rect_L7.5mm_W6.5mm_P5.00mm.kicad_mod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

Radial should not be in the description.

I think those are scripted. I believe it is a good idea to also include that in the description.

evanshultz, 2018-12-03:
Yes, they are scripted. See https://github.com/pointhi/kicad-footprint-generator/blob/master/scripts/tools/footprint_scripts_resistorlike.py and https://github.com/pointhi/kicad-footprint-generator/blob/master/scripts/Capacitors_THT/make_Capacitors_THT.py.

I made a few changes to the script at https://github.com/pointhi/kicad-footprint-generator/pull/200, but it didn't affect these footprints. It was clear the script isn't very flexible so more clauses could be added to write out the descriptions better for various part types.

Perhaps related, I submitted the footprints at https://github.com/KiCad/kicad-footprints/pull/1019 and noted that KLC specifies a different format (including height) which are current library does not capture (even though height is known and fixed). Perhaps some renaming was in order anyway??

Thread 1141 (2018-12-05):

Manufacturer-specific connectors with double series name

evanshultz, 2018-12-05:
Pulled from https://github.com/pointhi/kicad-footprint-generator/pull/224#issuecomment-442506843, which was spawned from https://github.com/KiCad/kicad-footprints/pull/1107.

@SchrodingersGat @poeschlr
Some footprints fall into the "Manufacturer Specific Connectors" section of http://kicad-pcb.org/libraries/klc/F3.6/, I believe, where `Series` comes before `MPN`. Neither field is optional. This can result in text for `Series` and the same text again in `MPN`; this looks weird, especially if the the two pieces of text follow each other, but follows convention. I wonder if we should do something different.

None of the connectors in the Harwin repo have a datasheet or appear to be relatively modern so they don't make a good example, but let's look at the JST repo where I know many of them are recent. They have doubled text to follow KLC:
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

That does look a bit bizarre and does not add clarity to me.

This convention, however, works well for Molex (https://github.com/KiCad/kicad-footprints/tree/master/Connector_Molex.pretty) where you have Series names like "CLIK-Mate" and "Micro-Fit_3.0" which are quite distinct from the MPN.

The Samtec repo (https://github.com/KiCad/kicad-footprints/tree/master/Connector_Samtec.pretty) doesn't double text in the scripted LSTM footprint names and I think it's clear.

Should KLC state that the Series field is required only if it is not a substring of the MPN? This would require updating a number of footprint file names if we change existing ones, but we could start a new precedent (perhaps updating all for v6?) to avoid doubled text. I agree that removing one "M20" looks better and doesn't lose anything, but since we're noticing this inconsistency now let's sort it out.

evanshultz, 2018-12-27:
@poeschlr @SchrodingersGat (and anybody else @Misca1234 @antoniovazquezblanco @DanSGiesbrecht @myfreescalewebpage )
Thoughts on the above?

If we decide to do any renaming, should that wait until after 5.1? Wait for 6?

What about renaming if the MPN above is in error? For example, ACH headers should start with "BM" but our library shows "BBM". See http://www.jst-mfg.com/product/pdf/eng/eACH.pdf and the screenshot above. Can that be done now or just after 5.1 since it's a bug?

Misca1234, 2018-12-27:
I don't mind it is double, better to stick to convention than create exceptions

poeschlr, 2018-12-27:
Large reorgs might best be left for about half a year before the planned v6 feature freeze.

evanshultz, 2018-12-27:
@poeschlr
Understood. There are two items I'm wondering if they should/could be done soon:
1. Is the series name always given even if it's in the MPN? This varies in the library now, as noted above, but at least if we decide what to do I can make an issue for existing footprints and we have a direction for new contributions. The inconsistency noted above is against the footprint naming in KLC so I'd like you to clarify your preference.
2. Correct the footprints that have an error in the MPN. I noted the ACH series above but there may be others.

poeschlr, 2018-12-27:
Having the series name duplicated helps with grouping similar parts in the same lib (JST is the best example. Remove the first EH, XH, PH and the series grouping is lost.)

So for consistency and for easier KLC i would prefer the series to always be listed even if the mpn includes it.

The alternative is to specify that the series must be included only if the MPN does not start with the series name. (I would accept this way of doing it as well.)

evanshultz, 2018-12-27:
OK. So KLC says always include the series name but you're allowing an alternate to that. Which means the original PR that spawned this line of questioning is OK. And KLC needs an update.

What about the timing of fixing names that truly have an error (wrong MPN) like the ACH series I mentioned above? Now? After 5.1? For 6?

poeschlr, 2018-12-27:
True errors can be fixed right now (They are real bugs)

The only thing we should not do is breaking designs just to get KLC compliance.

evanshultz, 2018-12-30:
JST MPNs fixes pushed.
Script: https://github.com/pointhi/kicad-footprint-generator/pull/256
Footprints: https://github.com/KiCad/kicad-footprints/pull/1238

Since the Harwin M20 series were just merged, would you want to add back the initial M20 even though the part number starts with it? You said you'd accept this above but if you prefer compliance with KLC they haven't been in the library long.

Closed 2019-03-23.

Thread 1153 (2018-12-08):

Some connectors in Connectors_USB not appearing in cvpcb

cryarchy, 2018-12-08:
Kicad V5.0.2

Some of the connectors in the Connectors_USB do not appear in the list of footprints in the rightmost pane of cvpcb when all but the *by library* filter is turned on and the *Connectors_USB* library is selected on the leftmost panel.

herostrat, 2018-12-12:
Hey cryarchy,

I can not recreate this problem on my installation.

Although I think this is more an issue with the kicad source and not the library (and should be reported here: https://bugs.launchpad.net/kicad/+filebug) you could post some screenshots of your problem so we can see if I can help you.

Firstly, let's see the image of your librarybrowser of the usb connectors:
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

Then a image of this:
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

Please make sure to include the buttons on the top (menubar).

cryarchy, 2019-01-17:
Here is what I have:
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

myfreescalewebpage, 2019-01-17:
And ?

herostrat, 2019-01-17:
Could you point me what footprints can not be seen?

I cannot see where the problem is :)

myfreescalewebpage, 2019-01-17:
Me too.

myfreescalewebpage, 2019-01-17:
Seems you want to assign a footprint, isn't it ? Are you doing this to generate your netlist ? Are you creating a new symbol ? If you can share more contextual information it's good to understand your issue.

cryarchy, 2019-01-18:
> Could you point me what footprints can not be seen?
>
> I cannot see where the problem is :)

Your list has 24 entries while mine has only 13. About 11 footprints are missing. Is this to be expected?

herostrat, 2019-01-18:
> Your list has 24 entries while mine has only 13. About 11 footprints are missing. Is this to be expected?

Aha ok, this is the problem.
The library that comes with a version of KiCad is a tagged version of the footprint, symbol and 3d model repos.
That means they do _not_ get updated after this for this specific KiCad version.
This has to do with compatibility and stability.

If you want to use the streamingedge version of those repos you have to download them and among other things, change the path to the libraries in KiCad to them.

Rene has *very good* and in depth tutorials written for advanced library management.

You can find them in the official forum (where further questions regarding this problem are more appropriate)
https://forum.kicad.info/

This FAQ will answer a lot of your questions:
https://forum.kicad.info/c/faq

Specifically those threads are what you are looking for:
https://forum.kicad.info/t/library-management-in-kicad-version-5/14636
https://forum.kicad.info/t/how-can-i-install-a-specific-version-of-the-footprint-library/9269

For assigning footprints (although I do not know if you had a problem there)
https://forum.kicad.info/t/how-can-i-assign-a-footprint-to-a-symbol/

cryarchy, 2019-01-18:
@myfreescalewebpage Since it is obvious that this is to be expected, I guess this is no longer an issue and can be closed. @herostrat Thank you. You've been of great help. I'll check out those resources.

Thread 1160 (2018-12-11):

review day

herostrat, 2018-12-11:
Hey guys,

the current amount of new contributors and additions seem to be overwhelming for the current teamsize, and this is not meant as critique.

Because I am pretty new to KiCad myself I try to help out if time allows and did first review with basic KLC checking.
The highest hurdle (for me at least) was that I did not want bother you guys too much and was not sure I am informed enough to contribute.

I saw (and helped out) in a very interesting project from KDE:
https://phabricator.kde.org/project/view/290/

I love the idea for KiCad as well.
A review day in which newcomer are given tasks, get to know the workflow of the project with guidelines (git, kicad, freecad for dimensions) and hopefully get confident enough to contribute in the future themselves or in future review days.

Thinking about my own experience (and reading e.g. https://github.com/KiCad/kicad-symbols/issues/1217) let me to think:
 - people have a hard time finding out where and how to help
 - many people do not know that there is a official repository anyone can help and contribute and do their own thing
 - because the KLC and workflow is imho learning by doing, asking questions and getting answer in a timely manner is important
 - upstreaming stuff can get frustrating because often there is no reaction at all

(Guided) triaging could help out quite a bit in all of those points imho.
And I think even guys like me that are really not "fluent" in the KLC and overall alignment of the project could help out newcomers that are eager to help.

Workflow could be something like this:
 - compile workpackages consiting of 2 or 3 footprints/symbols
 - each contributor can pick one and work through a prepared list of tasks with links how to do them (e.g. check dimensions in freecad, compare with datasheet, check for obvious errors like spelling)
 - after that he can report in the IRC/workpackage-list that he/she thinks it is good to review from a maintainer
 - the review day team can attach a label to the PR and/or merge the footprint

Please let me know what you think about this idea.
I would love to organize this if it does not produce more work for the KiCad team.

poeschlr, 2018-12-12:
In general a good idea.
My tutorial for footprint checking could be useful here: https://forum.kicad.info/t/how-to-check-footprint-correctness/9279

The largest part of the work is not necessarily checking if a contribution is ok. But documenting the findings in a way that allows the contributor to fix problems. For a lot of contributions it already helps if somebody tells the contributor what travis already found. (It seems a lot of contributors do not check travis output)

aewallin, 2018-12-14:
Improving the travis-scripts would be good. This is fast and direct feedback - the more things that can be checked and caught automatically the better.
Are there instructions for how to use travis on your own fork?

poeschlr, 2018-12-14:
You can run the same scripts locally.

You can also read up the github documentation about setting up travis.

aewallin, 2018-12-17:
> The lack of response is very discouraging when trying to contribute symbol/footprints. By the time there is a response that contribution has gone cold/contributor might have lost interest.

some rules/guidelines how/when review will be done would be good. even if it takes a long time it would be good if the contributor gets some feedback that the work is moving (slowly) forward according to a work-flow in N stages - or similar.

> Before a contributor submits footprints/symbols they ought to be made aware that they should first run the scripts at [KiCad utilities](https://github.com/KiCad/kicad-library-utils) locally.

This could be simpler:
- a "KLC" button in the symbol or footprint editor, that runs the scripts on the part that is open in the editor and reports errors.
- if simple instructions are available for configuring travis on your own fork of kicad-footprints and kicad-symbols, and travis is willing to handle the workload, then running travis on your own fork is a good alternative also I think.

In other news, I'm running into merge-conflicts for symbols - is there any plans for how to resolve this? Are symbols moving to one-file-per-symbol, like footprints, anytime soon?

herostrat, 2018-12-17:
@poeschlr Yes, your guides and tutorials are a huge for the workpackage.
I am currently writing a draft of it and I hope to be able to post it here until the weekend.

@robkam I know how you feel. If you look at the open PR you see most of the maintainers also wait for a review and answers to questions in issues and reports...
It is just that everyone is doing it in there freetime with no compensation and the number of people willing to put time and effort into review of the library is to low compared to the number of people pushing new content.

That's the reason I want to make it easier or probably more comprehensive to review others work and get more people to participate actively in the library (even if it is just me, it will be beneficial to have set dates and workpackages in order to help more consistent)

@aewallin I really like the idea to add a "check for KLC" button. I however do not know how easy or hard that would be to implement.
I guess that would be a good wishlist candidate for the bugtracker at launchpad.

antoniovazquezblanco, 2018-12-17:
> @aewallin I really like the idea to add a "check for KLC" button. I however do not know how easy or hard that would be to implement.
> I guess that would be a good wishlist candidate for the bugtracker at launchpad.

I have asked for that a while ago. I even played a little bit with KiCad code to see if I was able to implement it. Seems like yes but many of the DRC/ERC windows are going to be rewritten soon. I need to ask who is in charge of that and ask to see the code to adapt my feature to that.

https://bugs.launchpad.net/kicad/+bug/1803585

robkam, 2018-12-17:
Running the scripts or Travis same thing. It's already as easy as opening a terminal and entering a simple command line.

Submitted as bug [Submitting to libraries is not immediate enough ](https://bugs.launchpad.net/kicad/+bug/1808803)

Perhaps the problem is library maintenance needs more delegation. The work the librarians do is meticulous and careful, not everyone has the patience for it.

robkam, 2018-12-17:
> Submitted as bug Submitting to libraries is not immediate enough

Closed as invalid.

herostrat, 2018-12-17:
I mean what was the goal of that report?
It has no improvement proposal and just says something everyone knows?

The only way the submitted stuff gets audited, reviewed and merged faster is if more there are more reliable people start and continue to make reliable reviews, which is what I hope to achieve.

Since KiCad and the library more is work done in free-time from volunteers they project can not just say "you three guys now work on the library full-time".

If you are willing to help stay tuned for the guide that should help out newcomers, that I try to compile here.

Closed 2019-04-21.

Thread 1163 (2018-12-13):

CRLF vs. LF: MountingHole_2mm and MountingHole_2.1mm

aewallin, 2018-12-13:
1438595d3987a6df81d4de376d6bed3544c83672 seems to cause errors for me:

$ git diff
warning: CRLF will be replaced by LF in MountingHole.pretty/MountingHole_2.1mm.kicad_mod.
The file will have its original line endings in your working directory.
warning: CRLF will be replaced by LF in MountingHole.pretty/MountingHole_2mm.kicad_mod.
The file will have its original line endings in your working directory.

I'm not sure what is going on. I'm on Ubuntu 16.04LTS.

fauxpark, 2018-12-13:
Looks like Travis picked up on the CRLFs: https://travis-ci.org/KiCad/kicad-footprints/builds/426012316
But it only produces a warning, not an error, so you get a green tick mark on the commit. Considering the use of the word "must" as opposed to "should" both in the check scripts and [the KLC itself](http://kicad-pcb.org/libraries/klc/G1.7/) maybe it should be an error.

poeschlr, 2018-12-13:
the autocrlf thing sadly does not help if users add stuff directly via the browser instead of going through git. When using a proper git client it should work as intended.

aewallin, 2018-12-14:
Is this something I can/should fix in my local repo?
It now prevents me from "checkout my_old_branch" before committting or stashing the CRLF modifications??

aewallin, 2018-12-14:
Thanks, resolved now.
I had to delete the offending files before I could do a "pull upstream master"

Closed 2018-12-14.

Thread 1165 (2018-12-14):

Closed solder jumpers give DRC errors

matthijskooijman, 2018-12-14:
The current closed solder jumper footprints contain a custom-shaped pad, that includes the bridge to another pad. This approach gives pad-near-pad errors for the overlapping pads, and pad-near-track for the tracks connected to the pads (at least for the track connected to the pad *without* bridge, since that touches the pad *with* bridge).

e.g.:

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

Here pad 1 has the bridge attached.

This issue was previously mentioned [here on the list](https://lists.launchpad.net/kicad-developers/msg36445.html) and
[here on github](https://github.com/KiCad/kicad-footprints/pull/716#issuecomment-404928947).

A possible solution seems to be to remove the bridge from the pad, and instead use a graphic polygon on the copper layer. That will at least fix the DRC errors, and I *think* it should result in the same gerbers. I risk is that in the future, DRC might be adapted to include graphic polygons in its reasoning, perhaps.

The workaround suggested by the list post above is to use an open schematic symbol and footprint and connect these manually. This is of course less elegant, but also means that both sides of the solder jumper become the same net, so it is then easy to accidentally connect something to the wrong side of the jumper, without DRC noticing, which seems like a signifcant problem.

evanshultz, 2018-12-17:
Thanks for surfacing this issue!

I'm not one of the developers, but I would think any object on a copper layer should be considered by the DRC engine. Everything on a copper layer should be part of all copper-to-whatever DRC checks.

Adding connection on the copper layer manually is a hack. Most ECAD tools of which I'm aware have progressed beyond this by now. Not having connectivity match between the circuit board and the IPC-356 netlist is a pain. It does not matter how this is annotated on the fab drawing or other documentation, you will get questions or continuity check failures which are bogus. And it will keep coming up even with the same PCB vendors. Multiple vendors. It never ends. This is why some ECAD tools have specific net shorting features that can capture this connectivity and place it in the IPC-356 netlist for the board house to do continuity checks again. (Though even then you can still have annoying issues with PCB vendors.) The moral is that somehow the netlist and PCB should match in connectivity. If KiCad is limited at this time and doesn't allow nice net shorting, then what is the best interim solution? Maybe this is it. I don't personally think it's a bad way to go until KiCad adds a reasonable net shorting solution.

I would suggest checking the Gerbers before making this proposal instead of leaving it open. This is obviously crucial. I made a simple project and have attached it here. For ease of review, below you will find screenshots of the schematic, board in KiCad, board DRC errors, and the resulting Gerber:
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

In addition, I find that I'm unable to start routing from the shorted pad on the bridged jumpers in our library as they are now (and routing to it is wonky as well, apparently because the routing engine knows they're different nets?). That seems like a pretty significant problem. Did you see that also?

Lastly, the footprint filters for the jumper symbols are broken. They are `Jumper*` while all the footprints are `SolderJumper_...`. Sigh.

evanshultz, 2018-12-17:
Please let me know if this is capturing the issue you noticed and if there are some other caveats to consider.

matthijskooijman, 2018-12-17:
Agreed that capturing the internal connection would be the best solution. However, care should be taken to not see this as a normal wire connection, which would create a single net that connects through the jumper, but instead know that these two nets are connected inside the jumper.

Looking at your example, I believe that does show the issue. I'm a bit surprised, though, that it shows only one DRC error rather than a bunch of them. No time right now to investigate, unfortunately.

evanshultz, 2018-12-17:
Showing shorts in the IPC-356 netlist is what I've used to indicate that separate nets are shorted together, and it seems to work well both for engineers and the PCB suppliers. At least in my experience. (I've also annotated every net short on the fab drawing for clarity.) Here is an excerpt from Allegro:
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

To get this piece, however, someone would need to develop the feature. And to do that, we would need a consistent way to note an intentional short in the design (so the DRC engine knows it's OK and for the IPC-356 netlist to extract the net short info from). Since this is location-dependent, this would need to be done inside the board editor. While this is a good user suggestion, I've not found this communicate fully with PCB suppliers and there's a notable chunk of work outlined above to get it properly implemented.

Perhaps the number of DRC errors are related to the trace thickness, spacing constraints, etc.?

sethhillbrand, 2019-02-15:
Hi Folks.  The pad-near-pad errors can be resolved if you use polygons to jumper the pads.  As noted elsewhere, the full fix will require a file format change in v6.  But for v5.1, it would be good if the standard libraries did not include known DRC errors.

evanshultz, 2019-02-22:
@matthijskooijman
Did you submit a PR for this? I see a commit above but no PR to the KiCad footprint repo.

sethhillbrand, 2019-02-25:
Here is a pull request for this item  https://github.com/KiCad/kicad-footprints/pull/1437

evanshultz, 2019-03-11:
Closing since the PR to address this issue was merged.

Closed 2019-03-11.

Thread 1195 (2018-12-19):

How t oname variant on existing SC-59

Misca1234, 2018-12-19:
There exist a foot print SC-59

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

However the component AH1806
https://www.diodes.com/assets/Datasheets/AH1806.pdf

Says it support SC-59

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

But it is numbered in a different way.

Should I create a new foot print, if so, how to name it so others foot print filter SC*59* wont catch it, that is, like "DIODES_SC-59" ?

poeschlr, 2018-12-19:
I would suggest we add some form of suffix to make it obvious that the footprint is for some alternative pad numbering scheme.

evanshultz, 2018-12-19:
https://github.com/KiCad/kicad-footprints/tree/master/Package_TO_SOT_SMD.pretty shows a couple possible options:
1. Add a `_Reverse` suffix since the pin numbering is reversed.
1. Add a `_TabPin2` suffix (it's perhaps not really a tab, but it's similar to SOT-223 in this regard).

I think KiCad pinout does not have to match the vendors. For example, you can find similar variations in SOT-23 transistors from different vendors. That being said, with a transistor symbol you don't exactly need the pin numbers but for AH1806 the pin numbers are more important.

I'm not finding this clause in KLC v3 on the website, but KLC v2 section 7.6 says `Footprints should not be duplicated to match a different pin ordering. This is to be handled in the symbol libraries.`. See https://github.com/KiCad/kicad-library/wiki/Kicad-Library-Convention. Maybe that's invalid now? It that clause is still relevant, it would mean change pin numbers on the symbol for this part so it matches the existing SC-59 footprint. That is bound to be weird when compared with the datasheet, though, so perhaps this clause was intentionally removed in KLC v3.

Misca1234, 2018-12-19:
But wont the symbols which have a FP = "SC*59*" hit these ?

evanshultz, 2018-12-19:
The symbol for AH1806 in SC-59 package would call out the new footprint, right? And because the new footprint would have a unique name it would not affect the default footprint for any other SC-59 symbol already in the lib.

But you're talking about the footprint filter. Even if it matches it's going to be obvious there's something special about a footprint that has `_Reverse` at the end. The AH1806 footprint filter could even be `SC*59*Reverse*` so ensure it only allows the proper footprint.

Misca1234, 2018-12-20:
No, I meant already existing (cant find one actually) or further symbols that use the "original" SC-59 foot print, if those set their foot print filter to "`SC*59*`" wont they hit SC_59_Reverese ?

poeschlr, 2018-12-20:
The footprint filters can never be made such that they do not filter false positives. There is a reason why we require the footprint field to be filled out in most cases. If users ignore the pre filled footprint field then it is up to them to know if the footprint fits their need.

Misca1234, 2018-12-21:
then it will be
SC-59_Reverse

Closed 2018-12-27.

Thread 1211 (2018-12-24):

Two sided keepout area

herostrat, 2018-12-24:
Hey guys,

I am currently designing PCB edge footprints for m.2.

I have two questions:
 - how do we handle two keepout areas for to different sizes? I found https://github.com/KiCad/kicad-library/issues/1443
 - Is there a way to make the hatched line automatically?

On a sidenote:
 - are graphical polygons without a total fill planned? This would be my first idea to look for different filling options.

evanshultz, 2018-12-25:
I have two answers (for what it's worth):
- There is no way to differentiate them clearly, so if the areas don't touch the text can relatively easily differentiate them. If they do overlay, then you have to be creative (maybe crosshatch in opposite ways?).
- No "manual" way, but see https://github.com/pointhi/kicad-footprint-generator/pull/242 for scripted footprints. This isn't merged yet and may have a ways to go? I'd done it by hand with copying and using the Move Exact feature but it was moderately painful.

I don't know about polygons. Perhaps check the dev mailing list. v6 is supposed to have a major revamp of constraints (design rules) and keepouts are one of the many, many constraints that are needed.

Misca1234, 2018-12-26:
FYI
Beside the polygon, there is one for circle as well for scripted foot prints (not merged yet)
https://github.com/pointhi/kicad-footprint-generator/pull/243

herostrat, 2019-01-15:
Thanks for the help.

I will make a wishlist issue on launchpad to add a front and back keepout area option in the layers.
As long as this is not implemented the workarounds are named, although I do not think they are very elegant

Closed 2019-01-15.

Thread 1231 (2018-12-29):

QFN-44-1EP_9x9mm_P0.65mm_EP7.5x7.5mm datasheet with insuficient data

poeschlr, 2018-12-29:
The datasheet of this footprint has some missing dimensions and definitely missing tolerance information. The only thing well dimensioned is the suggested footprint. However that footprint should then definitely be marked as a manufacturer specific one. At the least the suffix PullBack must be added.

This would require changing the footprint assignment of P8X32A-M44

evanshultz, 2019-01-02:
I find the following to be missing:
- Package body tolerance (on the 9mm dimension), but this could be accepted as a nominal dimension
- Lead width (and tolerance or just in min/max)
- Tolerance of the 0.1mm lead-to-package-edge dimension

Is there more that we would need? I'll contact Parallax once we settle on what we need.

poeschlr, 2019-01-02:
the lead width is the thing that is mainly missing. (but also the tolerance for the pull back as i hightly doubt this to be a reference messurement.)

Body sizes are quite often given with 0 tolerance.

Thread 1243 (2018-12-30):

sub d footprints use pin number 0 for shield (or mounting) connection

poeschlr, 2018-12-30:
This should be fixed to SH or MP

poeschlr, 2018-12-30:
The symbols specifically designed for sub-d connectors however also use pin number 0.
This means this can wait till the next major release.

hildogjr, 2018-12-30:
Just for clarification:
symbols are using `SH` pin, but footprint using `0` pin for shield.
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

poeschlr, 2018-12-30:
@hildogjr this is only true for the generic symbols. The specialized symbols for sub d connectors use 0. Meaning use these symbols and everything should be ok for now.

poeschlr, 2018-12-30:
For reference the screenshot of the current db9 connector symbol
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

poeschlr, 2018-12-30:
The library is called Connector (It holds every connector symbol that does not fit into Connector_Generic)

Is it possible that your local lib is from sometime before the v5 release? (a late nightly perhaps)

poeschlr, 2018-12-30:
Updating kicad does not update your library tables. Meaning if you had nighlies before the v5 release then you will have a library table older than v5. (The lib was only declared stable after rc2 of version 5)

hildogjr, 2019-01-06:
Thx
I replaced my definitions by
https://raw.githubusercontent.com/KiCad/kicad-symbols/master/sym-lib-table
and works fine.
(Yes, even with `apt purge kicad*` and deleting `~\.kicad\`, this configuration was kept).

tijuca, 2019-01-10:
Basically Offtopic ...
> (Yes, even with `apt purge kicad*` and deleting `~\.kicad\`, this configuration was kept).

This is the expected and wanted behavior of apt or respective tools. And if some package is touching anything directly in the users home folder while apt or dpkg is running this is a serious issue.

Thread 1245 (2018-12-31):

MountingHole library should be renamed Mechanical

myfreescalewebpage, 2018-12-31:
Following the addition of #1041 I would suggest that the MountingHole library should be renamed Mechanical. This is more consistent with the symbol library which is already named Mechanical (in which enclosure, heatsink, holes and din rail adapter are available).

Any objections ?

Cheers,
Joel

poeschlr, 2018-12-31:
It is to be expected that we will have more footprints for these parts compared to symbols. It makes therefore a lot of sense to have a mechanical symbol lib that collects symbols for many very different mechanical parts. On the footprint side i would however prefer these to be split up.

myfreescalewebpage, 2018-12-31:
Thanks @poeschlr
So moving DIN rail in a new library, alone ?
Joel

poeschlr, 2018-12-31:
Maybe something like `MountingEquipment` could be generic enough to include different specialized parts intended to mount the pcb to something.

evanshultz, 2019-01-02:
Agree that `MountingHole` stays but this footprint doesn't fit.

What footprints are we likely to add? `MountingEquipment` is pretty broad so we could start there and see what other contributions come up. (I'm not in love with the name but don't have a betters suggestion right now.) If we get a lot more footprints and split up a library that's a lot of churn later on but we also don't want to start out with overly-specific libraries. `MountingRails` would be an option if we were likely to add more rail adapters. `MountingAdapters` would be even more generic to include rails and other stuff. Personally, I wouldn't predict a huge amount of contributions here and support Rene's suggestion unless we can come up with a more elegant name.

myfreescalewebpage, 2019-01-02:
@evanshultz totally agree with you, we cannot say what will be proposed in the future, so let's go with `MountingEquipment`.

I will make the modification for this DIN rail part soon.

Joel

myfreescalewebpage, 2019-01-02:
Done.

myfreescalewebpage, 2019-01-03:
@poeschlr you have merged the footprint but not the 3D package. See above referenced PR. Probably we need also to close this issue once it is done ;)

Cheers,
Joel

Closed 2019-01-03.

Thread 1250 (2019-01-02):

Allow PCB to have unrouted netlist actions

codemonkeyrawks, 2019-01-02:
I would like to see in KiCad the option to allow unrouted PCB parts like holes in boards to not be removed each time I have to update the netlist actions in schematic view to PCB export.

evanshultz, 2019-01-02:
This repo is to be used to discuss the libraries, not the tool itself.

You will find https://forum.kicad.info/ to be a good resource for discussing KiCad and how it works, and
https://launchpad.net/kicad is the place to go with requests or bugs.

For this specific item, you can lock the footprints so they don't get ripped up, though there are still caveats with the locking approach. Updating the netlist is more smooth in the 5.1 nightlies, BTW.

I'm closing this now but please continue to chase down this issue and come back soon with topics involving the official libraries!

poeschlr, 2019-01-02:
I feel nice right now so i give you a tldr of what to do.

Option 1: Include everything in the schematic. We have a mechanical symbol lib for a reason.
Option 2: Lock the footprint you have added from within pcb_new. This will prevent it from being removed (but also lock its position)

Closed 2019-01-02.

Thread 1264 (2019-01-05):

Zero orientation of oszillator lib is wrong

poeschlr, 2019-01-05:
The script creating oscillator footprints creates them in the wrong orientation.

evanshultz, 2019-01-06:
https://github.com/KiCad/kicad-footprints/issues/155

poeschlr, 2019-01-06:
The issue you linked is about polarity markers not about the zero orientation. Are you sure this is a duplicate? (I think the other issue might have already been resolved.)

evanshultz, 2019-01-06:
The zero orientation was mentioned in the post from the old repo that resulted in #155. Since these will surely be scripted, perhaps one issue is better than multiple? I'll clearly add this to the old issue but if you want to reopen this issue or do something else please go ahead. Sorry if I was too hasty.

Closed 2019-01-06.

Thread 1302 (2019-01-14):

About handsoldering version of footprints

gmsotavio, 2019-01-14:
KiCad library usually have both the standard and the hand-soldering version of some footprints. I have been following the datasheet for the stardard footprint. But I do not know how much I need extrapolate the dimensions of the pads to be considered a hand-soldering version. Is there some rule or convention that main KiCad librarians use to a footprint be eligible as hand-soldering?

evanshultz, 2019-01-15:
Good question.

There isn't any particular method or rationale that I've seen. If you have some thoughts please go ahead and share them.

My only suggestion is that enlarging pads for hand soldering is likely to happen for small parts where a fine tip iron would be used. The tip of the irons I'm familiar with are <1mm (0.5mm or less is common for me) so enlarging by 1-1.5mm seems reasonable. I'm comfortable soldering on "regular" pads for 0402 and 0.5mm pitch, though, so we should get the opinion of other folks too.

herostrat, 2019-01-17:
You can find additional information and discussions about the handsoldering versions here:
https://github.com/KiCad/kicad-footprints/issues/497

poeschlr, 2019-01-22:
My definition for handsolder footprints is a slight increase of the pad size towards the outside (the toe fillet for most devices)
The amount of toe increase depends a bit on device type. One needs a lot less for things like smd resistors when compared to a qfn for example. (If it is even possible to have a handsolderable version of the later.)

myfreescalewebpage, 2019-01-26:
@gmsotavio do the previous responses answers your question ?

Thanks
Joel

gmsotavio, 2019-02-09:
@myfreescalewebpage Yes. Thanks folks, for all answers. @evanshultz provided a good suggestions.

Closed 2019-02-09.

Thread 1307 (2019-01-17):

Templates vs Footprints

herostrat, 2019-01-17:
I think in issue https://github.com/KiCad/kicad-footprints/issues/864 the problem stems from a misunderstanding of the use cases of templates and footprints.

In my understanding:
 - Footprints are used to add components and modules to a PCB. If the component is a PCB itself, it can be seen as a daughterboard mounted to the mainboard that is the project PCB

 - templates are used if something gets mounted to the module, in other words if the projects PCB acts as a daughterboard and gets mounted to the motherboard that is the templates outline.

To avoid confusion:
A arduino footprint would be mounted on the PCB, e.g. this arduino nano breakout board https://store.qkits.com/arduino-nano-breakout-board.html

A arduino template would be a shield, e.g. the https://store.arduino.cc/arduino-ethernet-shield-2

Is my understanding correct?
Is there a official definition of this?
Should we add this definition to the KLC and the docs to avoid confusion?

----

In order to track progress, here are working points I plan to update:

 - [ ] Verify the differences and usecases of "footprints" vs "templates", define rules with the maintainers
 - [ ] Update the documentation accordingly
 - [ ] Recheck if all templates and footprints are correctly designed in such a manner
 - [ ] Monitor and push the template functionality
   - Folder for templates
     https://bugs.launchpad.net/kicad/+bug/1808011
   -

herostrat, 2019-01-17:
Ok interesting.
Thats unfortunate, because that means that the confusion remains - at least I think it is not clear what is meant for what.

----

I do not understand what you mean with block?
You mean something like a blueprint?

calebreister, 2019-01-17:
As a first-time contributor working on [#1304](https://github.com/KiCad/kicad-footprints/pull/1304), I can confirm that the particular use cases can be confusing. Perhaps it would be a good idea to add a section on templates to the KLC.

poeschlr, 2019-01-17:
There simply is no clear cut rule as to what should be a template and what should be a footprint. (For things that can be a template)

The main problem might simply be that we use templates in a way they where never really intended to be used. This is because there is no way to define a block (or blueprint) in kicad which would in most cases be the better option. So we use templates as such.

herostrat, 2019-01-18:
Ok that is at least a bit more understandable.

As it stands now, templates are completely useless.

Is there any discussion as to what should templates, blueprints and module footprints do where you can point me at?
I understand that the current solution is a workaround, but imho without rules we get suboptimal results where users use all tools wrong, each with his/her own understanding and therefore wrong usage.

---

I found this issue which seems to be the wishlist item for blocks/blueprints:
https://bugs.launchpad.net/kicad/+bug/1797683

---

Until this gets (if ever :D) implemented, we should make the best of what we have and include clear rules into the KLC.

---

Proposal (that seems the most logical to me, so please leave feedback):

 - Templates:
   1. pcbs with standardized dimensions (m.2 cards, pcie cards, euroboard, IEC60297, ...)
   2. pcbs for shields of common modules (raspberrypi shield, arduino shield, ...), because they also have a specific size

 - Footprints:
   1. Everything that gets mounted to the pcb one is designing (DCDC modules, arduinos, ...). The design has in mind the way those modules have to be mounted, e.g. the arduino uno has to be mounted upside-down, because the pinheader are already soldered on delivery

 - Blueprints/Blocks:
   This has to be defined and specified in KiCad imho, although the librarians should have a say in this too. It could well be that this could replace and extend the templates. Afaik there is no detailed specification of this as of yet. I think a hack without discussion as it seems in the launchpad thread does not add anything useful...

evanshultz, 2019-01-19:
I wouldn't say templates are completely useless. There are several includes with KiCad and they are useful IMO.

At http://docs.kicad-pcb.org/stable/en/kicad.html#_project_templates, you will find the only mention of templates in the documentation. I quote:
```
Using a project template facilitates setting up a new project with predefined settings. Templates may contain pre-defined board outlines, connector positions, schematic elements, design rules, etc. Complete schematics and/or PCBs used as seed files for the new project may even be included.
```

Notably, the documentation is stale all around and may not reflect the actual capabilities and real-world use of KiCad. But... for what it's worth there you go.

It seems to me that if the project being designed in KiCad is a "motherboard", which will use some module, then a footprint for the module is the right choice. But if the project being designed _is_ the module, so you want a canvas on which to design circuitry, then a template is what you want. There are valid reasons for having, for example, a M.2 2280 with B key in both a footprint and a template.

Here are my thoughts on the three issues/PRs noted above:
- https://github.com/KiCad/kicad-footprints/issues/864: A decision needs to be made to mirror or not as a rule for all templates.
- https://github.com/KiCad/kicad-footprints/pull/1124: Cards are templates and sockets are footprints.
- https://github.com/KiCad/kicad-footprints/issues/1064: I am still not clear why a template is not suitable, but it's certainly possible I'm a bonehead.

myfreescalewebpage, 2019-02-13:
Just read the whole topic and want to react about my PR #1124 because I clearly understand the difference between the template and the footprint but in my position, I'm designing a mini pcie card, currently I use the full card but I will be happy to optimise my layout to get it in a mini card format.

I will be able to change the footprint easily to change the card format, while it is absolutely not possible with templates, I will need to restart the design from scratch if I use them...

My position is that Edge.Cuts to define some "card footprints" **which are normalized** in the lib is very convenient.

Some M.2 footprints have been proposed (opened PR at this time) and will have the same issue.

Cheers,
Joel

herostrat, 2019-07-06:
I thought about this topic and the general idea of templates/blueprints a bit.
To find out what a better way of handling things is I created a forum post:
https://forum.kicad.info/t/rfc-kicad-blueprints/17926

Please feel free to add you comments and ideas.
I need the input of devs and librarians to develop a solid concept.

evanshultz, 2019-07-10:
I'm not sure what exactly you're looking for. The forum post has some good ideas and Bob being Bob. As usual. But also (I think) correctly pointing out the goal should be to add what KiCad users want first. Seth shares the blueprint for a nice addition that, based on historical precedent, won't arrive in a stable release for quite a while now. Since your forum post is entirely about what you would like, I gather you're looking towards the future?

Should this nice and valuable wishlist be at odds with the current KiCad release? While documentation is sparse, I understand the current meaning of template, as defined by the templates included with KiCad 5.1.2, to be a "vanilla" schematic and board combination with a board outline defined and some minimal circuitry added as a starting point from which a project can be built. An inherently incomplete building block meant to bootstrap a user getting started with whatever they want to make.

Is there another possible meaning? That's all I can make out of the existing templates.

So another question is: what does the official library define "footprint" and "template" to mean? While the meaning can shift, it would be nice if the existing templates are valuable to some KiCad users. And if so, would more templates add additional value? Without a definition it's hard to accept contributions to this repo.

It frustrates me why this conversation keeps coming up and never goes anywhere. An executive decision seems sorely overdue and Rene's responses above don't make any progressing toward closing this question. Somebody is always going to be unhappy but that need not paralyze any decision-making even in the face of a potential vocal minority, if there is one. A higher power can decide what a footprint and template are right now, and then when KiCad grows even more cool features the official library can evolve to suit. (Naturally, there are lots of clever and dedicated folks using KiCad and they are certainly free to do whatever they would like with their own library.) I would like the official library to define these terms and then we can accept more contributions and make KiCad users happy.

Sorry for the snarkiness.

@stambaughw
Perhaps you can share what templates are meant for as of KiCad 5.1.2? Then the templates in the official library can represent that use case (if they don't already) and new templates fitting that use case, if contributed, can be added. Thanks!

herostrat, 2019-07-10:
The forum post was created to find out what others want/need from templates/blueprints and look if it is possible to create it. I was not aware of the spec and the goal for it to land in v6 (I think because of the choice of vocabulary for the elements).
I also wanted to see if it is possible to create or finance the development of such a feature if enough people are interested.

I share your frustration, I basically ask again and restart the topic because examples like https://github.com/KiCad/kicad-footprints/pull/1668 seem to be outside the current use of the footprint modules.
I don't want to push a decision or decide anything myself, but I think it's important to mark and define what is used for what and where to make a PR for it.
There are a lot of module PR and I don't think they become less in the future.

evanshultz, 2019-07-10:
Completely agree. Knowing the intended use for templates seems, to me, like the first place to start. If the system can then be "abused" and allow other possibilities, so much the better as long as it's helpful to KiCad users.

As the volunteers reviewing and merging contributions, the librarians need to be on the same page with what should be in the official library. So I'll keep pushing because I also see templates, as I understand them to be, growing.

And seeing the concepts you and other folks proposed and what will hopefully be coming in v6 makes me even more excited for future KiCad!

Thread 1308 (2019-01-17):

add Mini-Circuits footprints without GND-zone/vias

aewallin, 2019-01-17:
As discussed in #1133 it was agreed to add "plain" versions of the Mini-Circuits footprints that do not contain GND-zones or GND-vias.

Here is an attempt to list the footprints that are merged, but do not have corresponding "plain" (non GND-zone, non GND-via) footprint in the library.

- [x] BK377 PL-005 #1126 UPDATE: plain footprint PR is #1314
- [x] GP731 PL-176 #1136, plain footprint PR is #1315
- [x] GP1212 PL-176 #1258 (same as GP731 but different height), plain PR is in #1315
- [x] HF1139 PL-230 #1134, plain footprint PR is #1317
- [x] MMM168 PL-225 #1150, plain footprint PR is #1318
- [x] QQQ130 PL-236 #1135, plain footprint PR is #1323
- [x] TT1224 PL-258 #1128, plain footprint PR is #1324
- [x] YY161 PL-049 #1137, plain footprint PR is #1327
- [x] CK605 PL-012 in #1151, plain footprint PR is #1328
- [x] TTT167 PL-079 in #1133, plain footprint PR is #1329
- [x] HZ1198 PL-247 in #1132, plain footprint PR is #1330

Creating these footprints is straightforward: copy the existing footprint, re-name without "LandPattern" and code, then remove all THT/SMD pads that are GND-zone, i.e. not part of the package pads proper.

herostrat, 2019-01-18:
Just to understand, do you plan to do the work yourself or is this a "need help" type of issue?

aewallin, 2019-01-18:
These are not at the top of my to-do list - I may tick them off slowly one by one but don't hold your breath ;)
Please do feel free to work on this!

aewallin, 2019-01-18:
I think these suggested new "plain" footprints create a bit of an issue with the footprint-filters in the merged symbols.
The plan above is to have two symbols
- mini-circuits_<Case>_LandPattern<PL-Code> with gnd-zones/vias
- mini-circuits_<Case>  the "plain" footprint, no gnd-zones/vias

But in work that is now merged the fp-filter is set to "mini-circuits*<PL-Code>*", so it will *not* match the plain footprint!?

poeschlr, 2019-01-18:
the footprint filter for the symbol might best mention the case code.
The default footprint should of course use the full footprint name including the land pattern.

aewallin, 2019-01-24:
these now merged. closing this.

Closed 2019-01-24.

Thread 1320 (2019-01-21):

Mean Well IRM-03 wrong footprints, maybe more due to docs

EngiBob, 2019-01-21:
Hi,

The main problem is IRMs docs show things from different bottom view angles/rotations.

If you pull up the Kicad footprint  Converter_ACDC_MeanWell_IRM-03-xx_THT it exactly mirrors the docs at https://www.meanwell.com/Upload/PDF/IRM-03/IRM-03-SPEC.PDF

If you look at an actual picture of the IRM-03 series you can see the mechanical drawings are actually upside down on the document (not all models are upside down, some are rotated around the y axis not z axis):

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

I just did a project using 3 modules, IRM-03, IRM-10, and IRM-15 class.  There is no 15 in Kicad so I did my own with the help of product pictures (it is upside down too), IRM-10 is OK it looks like, and I'm doing IRM-03 right now...  I've done two other projects with modules I can't remember at the moment and one of them I even  swapped my output +/- and fried a test board due to the docs all being different.  Where I can send the ones I've done for possible inclusion?

EngiBob, 2019-01-21:
Also an error in the spacing, has 7.18 instead of 7.78.

EngiBob, 2019-01-21:
I redid the library version of IRM-03, except for the position of the triangle for neutral.  I also added the holes (for ventilation?).

https://gist.github.com/EngiBob/ddb95417a3fb4fbaaf60a70efe0b4cd3

EngiBob, 2019-02-19:
They soldered up my board without any issues, got them back today and the footprint works great.

antoniovazquezblanco, 2019-02-19:
@EngiBob Could you please send a pull request to fix the issues in the official lib? It would be of great value to us.

evanshultz, 2019-02-19:
@EngiBob
Sorry to hear about your troubles and that there were due to errors in our library.

Since there's a lot going on above let me work through all the MeanWell IRM series we have now.
- IRM-02: Both THT and SMD symbols and footprints look OK to me. Note the THT symbol uses the pinout AC/N, AC/L, -V, +V, and MeanWell doesn't give pin numbers for THT packages.
- IRM-03: SMD looks OK in both symbol and footprint. The THT footprint is flipped but we have no THT symbol.
- IRM-05: No symbol in the library (and only THT package) so unable to verify pinout. Pin placement matches datasheet.
- IRM-10: No symbol in the library (and only THT package) so unable to verify pinout. Pin placement matches datasheet.
- IRM-20: The pinout here is AC/L, AC/N, -V, +V; annoying different than above. But the symbol and footprint match and pin placement matches datasheet.

Since this report is specifically about IRM-03, and the official library has no symbol, unfortunately it seems the symbol creation didn't involve validating the footprint.

Proposed changes:
1. Flip IRM-03 THT footprint.
1. Add IRM-03, IRM-05, and IRM-10 THT symbols to avoid the need for external symbols which could cause problems for KiCad users. Match the existing footprint pinouts to avoid anything already in the library getting changed.

Other notes:
- Many wrong symbol pin names ("-Vout" instead of "-V", for example). Could be fixed now.
- SMD footprints are missing a silk pin 1 mark. Could be fixed now.
- Footprint filters don't capture THT vs SMD footprints. Could be fixed now.
- It's annoying that the pinout isn't consistent for the THT parts, but that's not something we will do now since it would break schematics.

evanshultz, 2019-02-26:
@EngiBob
Thanks for this report. I've submitted 2 PRs, shown above, that will fix this issue. If you'd like to verify my fixes are correct that would be welcome. Thank you.

Closed 2019-03-21.

Thread 1322 (2019-01-22):

Switch is the function not Button.

robkam, 2019-01-22:
Button_Switch_*.pretty should be renamed Switch_Button_*.pretty, see KLC F1.1 - Footprint libraries are categorized by function.

fauxpark, 2019-01-22:
I think the name is meant to be interpreted like "Button/Switch", but slashes are illegal characters in folder names, so an underscore is used instead.

fauxpark, 2019-01-22:
Let me put it another way. The libraries are for "Buttons & Switches" (or "Switches & Buttons" if you prefer). Neither take precedence over the other.

robkam, 2019-01-22:
That's wrong, as it's mainly switches. What about "button cells"?

fauxpark, 2019-01-22:
If you mean these:
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

Then they would go in `Battery.pretty` (well, mainly the holders/receptacles for them, batteries themselves are not generally part of a PCB design AFAIK)

evanshultz, 2019-01-22:
@robkam
So you're interpreting the word "button" to mean the thing the user touches to activate a switch? So the red and black plastic things in the picture below?
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

And the word "switch" is the electronic part that has a schematic symbol representation?

I think I understand what you're saying, but I want to be sure I do first.

robkam, 2019-01-22:
Yes that's right. Switch is the primary electronic function. The sub-function might be button, DIP, slide, toggle, etc.

(Rotary switches are at Rotary_Encoder.pretty).

evanshultz, 2019-01-22:
It's reasonable then to call the library just `Switch.pretty` and that makes sense to me. The switch is the electronic part.

However, that would mean breaking all schematics which use a symbol in this library, with the belief that the recovery system isn't robust, but even if the symbols are recovered from a re-named library it will still be a hassle for users that build schematics with this library. And it's just not worth it.

robkam, 2019-01-22:
It's not named as per the KLC and will have to be fixed sooner or later. The longer it's left the more broken designs there will be to fix when it does get changed.

poeschlr, 2019-01-22:
To me a switch is a device that keeps its state whereas a button is something that returns to a zero state. (But this might be because in german we have taster and schalter and these are definitely not interchangable.)

Even if we decide this to be change we can only do it with version 6. (Only major releases are allowed to bring design breaking changes.)

robkam, 2019-01-23:
That makes sense. After looking at the  German Farnell element14 page for "taster" vs. the English one for "pushbutton switches". In English `Button_Switch` would be better described as e.g. `Switch_Momentary`.

But e.g. DIP slide switches are never buttons, except that's the library they are in.

Until version 6 any new switch footprints can go in `Switch.pretty`.

poeschlr, 2019-01-23:
Splitting the lib now (for only new footprints) will only result in adding further confusion.

---

From the oxford dictonary:
- Button: A small device on a piece of electrical or electronic equipment which is pressed to operate it.
- Switch: A device for making and breaking the connection in an electric circuit.

Wikipedia definition for push-button:
A push-button (also spelled pushbutton) **or simply button** is a simple switch mechanism for controlling some aspect of a machine or a process.

From these i would gather that we are not completely wrong. Meaning i see no particular reason why we should rush this now. We can discuss this once v6 development is opened.

Thread 1343 (2019-01-26):

Several script-generated DFN footprints - Silkscreen pin 1 mark incorecct

JacobEFO, 2019-01-26:
I discovered a minor issue within the kicad-footprint-generator that resulted in incorrect pin1 markings, on several DFN footprints currently found in the library.
Refer to the issue at: https://github.com/pointhi/kicad-footprint-generator/issues/278

The new footprints found at kicad-footprint-generator have slightly different dimensions on solder pads. I have a branch (https://github.com/JacobEFO/kicad-footprints/tree/DFNfootprints) ready for merge that updates the silkscreen (and reduces pad size slightly as per the script and datasheet dimensions).
If interested I can open the request.

evanshultz, 2019-01-28:
The old pads were built per the datasheet. Scripted footprints are newer and use IPC calculations to derive pads based on the package drawing; this may or may not match the datasheet footprint.

For scripted footprints, they SHOULD NOT be changed. IPC-compliant footprints are the way to go in a general-purpose library like ours. Mismatches between the datasheet and our footprints are ignored.

If you are bringing up a different issue please elaborate.

JacobEFO, 2019-01-28:
This issue is closely related to the silkscreen issue discussed on https://github.com/pointhi/kicad-footprint-generator/issues/278
Which was totally a mistake on my behalf.

However the current footprints are not IPC compliant (which the script generated DFN packages are). Maybe it's worth updating the footprints with the script generated ones (IPC compliant), the ones I linked to.

poeschlr, 2019-01-28:
The main work for getting further footprints generated is finding the datasheets. A tip on that: search the lib which symbols point to the footprints. This is mostly because a lot of footprints do not have a datasheet assigned. Searching for datasheets by footprint is not really a possibility so the best option is to search by component (symbol)

Another tip is to find the original pull request that added a component. (This is not as trivial as you need to follow the trail of renamings through the git history.)

If you are overly motivated then you can even check if the symbols who are assigned a particular footprint really fit that footprint. (I discovered that especially EP sizes are not always correct for symbols meaning you might need to add additional footprints.)

Thread 1346 (2019-01-27):

RF_Module: Issues in HOPERF_RFM9XW_THT

gmsotavio, 2019-01-27:
During my inspection I've found the following problems:

- Pin 1 is circular (Should be squared instead);
- Holes drill size is 0.762mm (Should be 0.8 mm, as per datasheet);
- F.SilkS thickness is 0.1mm (The current recommended value is 0.12 mm, as per KLC);
- F.Fab thickness is 0.12mm (The current recommended value is 0.1 mm, as per KLC);
- F.CrtYd is 0.33 mm away from body edge of the footprint (The current recommended value is 0.25 mm, as per KLC);
- Missing pin 1 indication at F.SilkS layer
- Outdated manufacturer datasheet link (broken)
Current: http://www.hoperf.com/upload/rf/RFM95_96_97_98W.pdf
Updated: https://www.hoperf.com/data/upload/portal/20181127/5bfcbea20e9ef.pdf
- Holes groups are 12.8mm away from each other (The correct value is 13.6mm).
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

The correct distance information is missing in the RFM9X series datasheet. I found the correct distance in the datasheet from a similar product of the same manufacturer; RFM69HCW (https://www.hoperf.com/data/upload/portal/20181127/5bfcb8284d838.pdf).
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

which looks like correct
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

I've provided the due corrections and I intend to open a PR.

Otavio Augusto

Closed 2019-04-22.

Thread 1396 (2019-02-07):

DSUB Footprint for DE-15 Right Angle Through Hole Connector does not match any extant parts

maxtherabbit, 2019-02-07:
The pin row spacing specified in DSUB-15-HD_Female_Horizontal_P2.29x1.98mm_EdgePinOffset8.35mm_Housed_MountingHolesOffset10.89mm.kicad_mod is not commensurate with any such connectors in production. This is the connector commonly used for VGA.

Please see drawing here for an example of correct dimensions: https://www.amphenol-icc.com/media/wysiwyg/files/drawing/c-cd-0012.pdf

As a workaround I have been using the footprint provided on SnapEDA for TE Connectivity part number: 1-1734530-1

jacobtohahn, 2020-08-21:
I've noticed this too. I'd like to add that the problem also exists on the male parts. It makes it very annoying to use any actual connectors out there.
Here's another datasheet for the most popular DB9 on Digikey: http://www.assmann-wsw.com/fileadmin/datasheets/ASS_4888_CO.pdf
Thanks for providing a workaround.

Thread 1408 (2019-02-12):

Should modules include the header?

evanshultz, 2019-02-12:
See https://github.com/KiCad/kicad-footprints/pull/1066#issuecomment-462539470 and later comments.

The Modules repo currently has footprints showing the outline and other important features of the module (such as mounting holes). In addition, they all include the header to which the module is mounted.

Should the header location be captured in the module footprint but not the header itself?

Joining them means the module footprint must be different for a SMD header vs a THT header, for example. In addition, the header is not a unique item on the BOM even though the module and the header are purchased separately and have unique part numbers (and ref des). It seems to me the mounting header and the module should not be joined together.

The trouble is in placing the two parts so they align. The module footprint would need a target to know where to place pin 1 of the separate header footprint. Right now in Pcbnew if the grid is "correct" or you are grabbing by a pin, or you can use the Move Exactly command, it may all work out nicely. But there's not, as far as I know, an easy way to grab a part by any desired element (or filter out undesired elements) composing the footprint to easily align multiple footprints. It would be a great addition and I think I recall something about this on the KiCad roadmap.  (I use Allegro and it has a powerful "pick by" feature.)

So having the header and module outline together may be the easiest way to ensure users don't make a mistake with the current capabilities on KiCad. Especially as we will hopefully have filters and more tools in v6 to make this better it may be worthwhile to revisit this so I marked it as a 6.0.0 milestone. If there is reason and agreement to split up the module outline and header, and it will work nicely for KiCad users, we can target a future KiCad release.

poeschlr, 2019-02-13:
To be honest, if a module is to be mounted on a header than i would guess a template might be the better choice.

As this is planned for v6 we might be lucky and get something similar to eagles design blocks. (A kind of hierarchical block that allows adding a pre defined pcb side to it. This would be ideal for things like these.

evanshultz, 2019-02-14:
Maybe I've misunderstood or not written the above clearly. I thought the Module repo captured footprints that were for a module (PCBA) that would go onto the PCB being designed in KiCad.

Some examples:
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

So the board being designed in KiCad would hold/contain one of the above modules, and it would be helpful to have a footprint that shows the outline of the module. The module would be one part of the BOM for the product being designed in KiCad.

The header or other items to support the module would also be parts of the BOM for the product in KiCad, and thus all should be individual components with their own ref des.

Sorry if that was overboard. But I don't see how a template would work since a template defines the product to be designed in KiCad, including the board outline. If the footprints in the Module library had Edge.Cuts, like templates, they would punch a hole in the main board being designed in KiCad and that's not what is desired. At least how I understand it. But am I not getting it?

herostrat, 2019-02-14:
I think this plays in the same ballpark as my issue https://github.com/KiCad/kicad-footprints/issues/1307 (at least if I am not mistaken)

Imho a concrete definition for what a module in footprints and a template should be made, otherwise it is a complete clutter of different understandings and therefore implementations.

diegoherranz, 2019-02-14:
@poeschlr said:
> To be honest, if a module is to be mounted on a header than i would guess a template might be the better choice.

Not sure. I think that if the module becomes a component of your PCB design, a footprint is the right way to go. I can't see how that would work with a template? Maybe I'm missing something.

@herostrat said:
> I think this plays in the same ballpark as my issue #1307 (at least if I am not mistaken)

Yes, and I think that we both think the same. See my attempt to explain the difference between footprints and templates for modules on https://github.com/KiCad/kicad-footprints/pull/1066#issuecomment-435628391. I think it's pretty much the same that you say.

Thanks!

poeschlr, 2019-02-14:
With a single footprint you only get a single entry in the pos file. So if the part in reality needs two connectors placed then you will not be able to use a single footprint for it if you plan to use automatic assembly. The only option offered by kicad that allows having multiple footprints (and therefore multiple pos file entries) imported at the same time is by using templates.

diegoherranz, 2019-02-14:
I don't think we've ever mentioned two connectors, or at least I haven't.
I was referring to 1 connector plus the module.

herostrat, 2019-02-14:
Modules footprints, i.e. for arduino boards, have often times multiple headers.

As we do not just have to include one style (pcie, m.2, etc.) all possibilities have to be thought through.

diegoherranz, 2019-02-14:
> Modules footprints, i.e. for arduino boards, have often times multiple headers.
That's true. Yes, that makes it a bit worse :)
OK, we'll have to think it through.

evanshultz, 2019-02-14:
Good discussion.

There are two methods, right?
1. Add a bunch of parts to the schematic and then they need to be "assembled" on the board. The "assembly" step is weak in KiCad right now and I tried to capture that above.
2. A single schematic and PCB part that captures multiple individual orderable parts. Here placement on the PCB is easy but we don't have any way to show that there are multiple BOM items included.

What exactly is a templates vs a footprint and the other related topics are also important to figure out.

Thread 1420 (2019-02-19):

Are pin 1 markings always necessary?

evanshultz, 2019-02-19:
@KiCad/librarians
KLC is clear about pin 1 marking at http://kicad-pcb.org/libraries/klc/F4.2/ and http://kicad-pcb.org/libraries/klc/F7.2/ and http://kicad-pcb.org/libraries/klc/F7.3/.

One example is given in F7.3 where a unique pin 1 pad shape is not needed if the part is non-polarized (the example is a THT resistor footprint). But the other two sections mentioned above would seem to require pin 1 markings on all footprints.

I think there are already known cases where this doesn't make sense. Two examples are audio jacks, as the schematic symbols have already been changed to pin names instead of pin numbers (so footprints need to use pin names as well), and external cards (CF, SIM, etc.) where pin names allow easier mapping between many vendors in case their pin numbering isn't aligned but there are standardized/required signals.

Here are two open PRs which are intertwined with this issue:
- https://github.com/KiCad/kicad-symbols/pull/592
- https://github.com/KiCad/kicad-footprints/pull/598
- https://github.com/KiCad/kicad-footprints/pull/1145
- https://github.com/KiCad/kicad-footprints/pull/1416

Am I right that KLC does not currently seem to allow a lack of pin 1 when we've already decided to allow it colloquially? If so, how should this be captured in KLC?

I have advocated for pin T to be marked on audio jack footprints. However, I do not think a pin mark is always necessary because some footprints have a unique shape which, in combination with the silk and fab layers, indicates proper insertion. Having one unique pad shape or marking any pin in silk/fab does not add clarity. Please see the cases linked above for some screenshots of footprints where I believe it is not necessary to mark any pin to indicate insertion orientation.

If y'all agree I can add some proposed text below to integrate into KLC. Feel free to do the same if you like.

robkam, 2019-02-19:
#1388 is another PR where this is an issue (pots with a pin 1)

robkam, 2019-02-19:
KLC F7.3 has "**Exception:**
Non polarized parts (such as THT resistors) should not set the shape of Pin 1 to Rectangular. For these (non polarized) footprints, all pad shapes should be consistent."

evanshultz, 2019-02-19:
> KLC F7.3 has "**Exception:**
> Non polarized parts (such as THT resistors) should not set the shape of Pin 1 to Rectangular. For these (non polarized) footprints, all pad shapes should be consistent."

I explicitly noted this above.

poeschlr, 2019-02-20:
The pin 1 mark is called polarity mark in the standards. So yes resistors do not need one (Which is how we have the lib right now)

I would however still use a polarity marking for parts like audio connectors. I don't see it as a pin 1 mark for correctly inserting he part but as a help while debugging for such devices. (The same is true for displays as an example.)
This means we should simply document for non numbered pads which one gets the polarity mark. (this includes audio connectors, But also relays which IEC pin naming, ...)
A pin that is always present in a class of devices would be an ideal candidate for being the "pin 1" (My guess would be that it is the "GND" pin for audio connectors. But it could also be some other pin.)

evanshultz, 2019-02-20:
I understand the point of a polarity (or pin 1) mark for many parts. DIPs, SOICs, e caps, etc. All makes sense. QFNs, not only have two possible orientations but four. So the part needs to be installed properly and if there's a problem someone needs to verify assembly and identify two or more pins for troubleshooting. No question there.

But for audio jacks I don't think any kind of fab, silk, or pad shape is needed. And XLRs, for example, have a pin 1 as part of the connector! Google for images which contain the color green with search strings like "pcb xlr" and "pcb audio jack" and "pcb phono" and "pcb neutrik"; if your results are similar to mine you won't see a single PCB with any kind of unique pad shape or change to the silk outline of the part. Putting pin numbers/names in silk is sometimes done for audio connectors but that's not captured in KLC.

I tried this same searching for gain potentiometers as mentioned by Rob above. I do sometimes see unique pad shapes in the images I find but I never saw anything in silk.

A common mode choke is another example where the part may fit into the PCB in two orientations but it doesn't matter as the windings are equivalent. Seeing the outline of the part in silk is adequate to know how to place it on the board and having any unique pad shape does not help. And forcing one particular orientation in production slows things down versus allowing either permissible orientation to be used.

The above types of parts, and there are surely many others, have a unique geometry so insertion is obvious. And with regards to debugging, can you give an example? Audio connectors and pots may have one naive pinout/usage which is common, but the implementation can and does vary. The ECAD system needs to have some way to match up the symbol and footprint but I believe for many parts it's not helpful to try and communicate this in fab, silk, or pad shape as a strict reading of KLC would require. Maybe you have some good counter examples?

That all being said, the overarching point I'm try to make is that requiring all of this stuff in KLC doesn't make sense for every footprint type. At least not to me. Agree? Am I wrong?

diegoherranz, 2019-02-20:
> I would however still use a polarity marking for parts like audio connectors. [ ... ] This means we should simply document for non numbered pads which one gets the polarity mark.

I'm not so sure about that one. I think that us defining which pin gets the polarity mark can be harmful.
An example:

- Someone gets a board to assemble. They didn't design it, they don't know which software/library was used, hence, there is zero chance that they check the KLC.
- They see an audio connector with a pin with a special marking. They assume that means pin 1.
- What we defined as pin 1 is different from whatever the manufacturer defined as pin 1.
- It gets assembled wrong (this is unlikely for audio connectors because it's difficult to place them on a wrong orientation but I guess it might happen on a rare case or at least raise questions from the assembler).
- Even if it gets assembled right, someone debugging the board will think that that is pin 1 when it isn't, because the manufacturer defined it somewhere else.

Because of all that, I think that if we have a marking, it has to be pin 1 or it can do more harm than good.

Having said that, even when the orientation is clear because of the shape of the part, e.g. potentiometer, I think that having the pin 1 marking is useful for debugging as @poeschlr says (it allows you very quickly to see which pin is pin 1 when probing, scoping, etc.) and it doesn't hurt having it (I would be in favour of keeping it).

Maybe we can change the exceptions on F7.3 http://kicad-pcb.org/libraries/klc/ to something like:

- Non-polarized parts, that is, parts in which the population orientation doesn't matter (such as THT resistors) should not set the shape of Pin 1 to Rectangular. For these (non-polarized) footprints, all pad shapes should be consistent.
- It the part doesn't use numbers for the pin names, and therefore there isn't a pin 1, no pin should be set to rectangular shape.

evanshultz, 2019-02-20:
Works for me, as long as F4.2 and F7.2 have a similar exception.

poeschlr, 2019-02-21:
I don't really agree with the debugging argument. First of all the "pin 1" mark does not need to be of the same shape or form as for numbered components.
Secondly debugging means you have the schematic as a reference. Not the datasheet. (Ok the datasheet will be used as a source for information to check the schematic and to check if the pin order of footpirnts is at fault for the problem encountered.)

This means to me that yes a polarity mark can still be used with these parts. (And makes sense. Especially the differentiating pad shape helps if you need to fit your measurement probe on the backside. Makes it a lot easier to identify which pin is what.)

Thread 1434 (2019-02-25):

Rename Packages_SO:SOIJ-8_5.3x5.3mm_P1.27mm to Packages_SO:SOIC-8W_5.3x5.3mm_P1.27mm

Icenowy, 2019-02-25:
The SOIJ-8 name is not a common name for this package. By searching on google with this keyword, only materials from Microchip can be found.

However, this package is popular for 25 SPI NOR Flash, and many manufacturers do not use the SOIJ name, they just declare it as a wide version of SOIC/SOP or mention the 208mil size.

See the following:
https://www.winbond.com/resource-files/w25q128fv%20rev.l%2008242015.pdf
http://www.gigadevice.com/datasheet/gd25q127c/
https://www.micron.com/~/media/documents/products/data-sheet/nor-flash/serial-nor/m25p/m25p80.pdf
http://www.xinyahong.com/upLoad/product/month_1411/201411201249025495.pdf (This is EN25Q64)

So I suggest to rename it to follow the scheme of other wide SOICs, rather than using a vendor-specific name.

poeschlr, 2019-02-25:
SOIJ is typically a package with J lead instead of gull wing. (leads bend inwards instead of outwards) Are you sure about the renaming? (Disclaimer: I did not check the current footprint as i do not have kicad access right now. A screenshot of the current footprint would have made this a lot easier.)

evanshultz, 2019-02-25:
Here is the footprint mentioned above:
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

The doc referenced by this footprints is an older version of
http://ww1.microchip.com/downloads/en/PackagingSpec/00000049BQ.pdf. However, I don't find this package type called "SOIJ" in that doc.

This footprint is used by the following symbols (just searching in Eeschema):
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

I agree that it would be best to change the footprint name and it's not a substantial amount of work so it could be done right away if the other librarians agree.

Icenowy, 2019-02-26:
Datasheet with the SOIJ name remaining can be easily acquired via Google.

e.g. http://ww1.microchip.com/downloads/en/PackagingSpec/00049AU.pdf

This document says "8-Lead Plastic Small Outline (SM) – Medium, 5.28 mm Body [SOIJ]", and it has no J lead mentioned.

BTW I have already used the SOIJ-8 footprint on my sample board, and it successfully get SMTed with W25Q128JVSSIQ.

poeschlr, 2019-02-26:
In that case go ahead.

evanshultz, 2019-02-26:
@Icenowy
You can see that your link is the older version of my link. And in the newer version the term "SOIJ" has been removed. This is confirming your suggestion and we are agreeing.

Would you like to submit a PR to rename the footprint? We will also need a PR to fix all symbols currently using this footprint.

Icenowy, 2019-02-27:
Could I just rename the file? Should I keep a compatible copy of the package?

evanshultz, 2019-02-27:
When the footprint is renamed, symbols using the footprint need to then use the updated footprint name. We don't need to have a SOIJ copy of the footprint because, as you said, it's a poor description.

If the symbols are a problem, how about we fix it together? If you submit a PR to rename the footprint, I'll submit a PR to update the symbols? Does that sound OK? Or are you prepared to submit both PRs?

antoniovazquezblanco, 2019-07-18:
I am interested in this discussion.

Up to date Microchip has a specification for a SOIJ package in their website:
https://www.microchip.com/quality/packaging-specifications
https://www.microchip.com/quality/packaging-specifications?packageFamily=SOIJ
http://ww1.microchip.com/downloads/en/DeviceDoc/8L_SOIJ_Medium_5_28_SM_C04-056C.pdf

Should this footprint be really renamed?

evanshultz, 2020-09-18:
@chschlue
This will unlock a footprint PR and a symbol PR. IMO, perhaps Microchip uses SOIJ but I think we can use our standard SOIC footprint if it matches the package drawing. So are you OK removing the SOIJ footprint for v6 and then updating the affected symbols to use an existing SOIC footprint?

chschlue, 2020-09-18:
Yes

Closed 2020-09-29.

Thread 1445 (2019-02-27):

Varistor hole diameters too small

martinjaeger, 2019-02-27:
I built a PCB using the footprint `Varistor:RV_Disc_D12mm_W4.3mm_P7.5mm` and realized that the hole diameter was too small. It seems like all varistors in the library have a hole diameter matching exactly the wire diameter, which is too small.

Some examples and datasheets:

Epcos StandarD series ([datasheet](https://en.tdk.eu/inf/70/db/var/SIOV_Leaded_StandarD.pdf), page 14):
- D7mm_P5mm: Wire diameter d = 0.6 mm
- D9mm_P5mm: Wire diameter d = 0.6 mm
- D12mm_P7.5mm: Wire diameter d = 0.8 mm
- D15.5mm_P7.5mm: Wire diameter d = 0.8 mm
- D21.5mm_P10mm: Wire diameter d = 1.0 mm

Bourns MOV-07DxxxK series ([datasheet](https://www.bourns.com/docs/product-datasheets/mov07d.pdf), page 2):
- D9mm_P5mm: Wire diameter d = 0.6 mm

Bourns MOV-10DxxxK series ([datasheet](https://www.bourns.com/docs/Product-Datasheets/MOV10D.pdf), page 2):
- D12mm_P7.5mm: Wire diameter d = 0.8 mm

Bourns MOV-14DxxxK series ([datasheet](https://www.bourns.com/docs/product-datasheets/mov14d.pdf), page 2):
- D15.5mm_P7.5mm: Wire diameter d = 0.8 mm

In addition to that, naming of the parts from manufacturers seems different from KiCad. Manufacturers seem to have nominal diameters of 5, 7, 10, 14 and 20, whereas KiCad uses the maximum diameter in the footprint name.

I suggest to increase the hole diameter to wire diameter + 0.1 mm for all parts.

If you agree, I can implement the changes and send a PR.

What do you think about renaming the Varistor footprints based on their **nominal** diameter instead of actual max diameter?

martinjaeger, 2019-02-27:
Just checked the hole diameter of capacitors. It's wire diameter + 0.2 mm, so that might make sense also for Varistors.

evanshultz, 2019-02-27:
Thank you for reporting what you've found using the KiCad library. Sorry you had problems.

To address your suggestion, drill holes should be 0.2mm over the lead size according to KLC (from IPC-2221).

I don't see any datasheets in the varistor footprints, so who knows why they have this drill size. The varistors do mention "SIOV", so perhaps the TDK datasheet was inspiration. Footprints were originally added at https://github.com/KiCad/Varistors.pretty/pull/1, and moved to the new lib at https://github.com/KiCad/kicad-footprints/pull/48. They mostly seem to exist the same in the current library. I see 33 with 0.6mm drill, 43 with 0.8mm drill, and 22 with 1mm drill. I checked a few and it appears 7/9mm use 0.6mm drills, 12/15.5 use 0.8mm drills, and 21.5mm uses 1mm drills.

If we were starting over, I'd support the following:
1. Picking a cross-section of part sizes and using nominal dimensions.
1. Drill 0.2mm over lead diameter, with circular pads (at least) 0.55mm bigger than the drill.

However, we have to worry about breaking all existing designs which use these footprints if they are renamed. And we can't do that. Too painful to KiCad users for little to no benefit. However, that only affects the body size and not the drill size.

Looking at Digikey, for THT disc varistors, there are several diameters which have <=100 parts and then a few with >1000 parts. So that's a pretty clear division about which body sizes are common. And I find that 5, 7, 10, 14, and 20mm are common. And the corresponding common lead diameters are 0.6, 0.6, 0.8, 0.8, and 1mm, respectively. Lead pitch is 5, 5, 7.5, 7.5, and 10mm (with 7.5mm popping up sometimes), respectively. Body thickness varies but seems to allow footprints of 5, 6, 7, 8, 9, 10, and 12mm (using 6-12 in even numbers is probably fine). Lead stagger varies much more, or isn't even given, but I have seen ~2.5mm less than the body thickness and a fixed 3.5mm regardless of body size is common. I think this matches nicely with what you found, in that our drill sizes are too small and the body sizes aren't the common sizes.

Other doc links:
- http://www.vishay.com/docs/29081/vdrs.pdf
- https://media.digikey.com/pdf/Data%20Sheets/United%20Chemi-Con%20PDFs/G_Series.PDF
- https://www.seielect.com/catalog/sei-rv.pdf
- https://us.schurter.com/bundles/snceschurter/epim/_ProdPool_/newDS/en/typ_AVTT.pdf
- https://industrial.panasonic.com/cdbs/www-data/pdf/AWA0000/AWA0000C1.pdf
- https://www.littelfuse.com/~/media/electronics/datasheets/varistors/littelfuse_varistor_za_datasheet.pdf.pdf
- https://www.littelfuse.com/~/media/electronics/datasheets/varistors/littelfuse_varistor_la_datasheet.pdf.pdf
- https://media.digikey.com/pdf/Data%20Sheets/AVX%20PDFs/VE,%20VF%20Type%20(P%20Series).pdf

So... here is what I think we can do right now:
1. Enlarge all drills by 0.2mm.
1. Add more footprints using the nominal body diameter and some number of thicknesses. This is essentially changing just the "D" part of the existing footprints (with the same, more, or less thicknesses) since I believe the lead pitch is already correct.

Does that sound good to you? Do you other proposals how to proceed?

When KiCad v6 release is approaching, if the librarian team agrees, we could remove the old (current as of today) footprints. We will have to see how things go at that time.

Lastly, varistor footprints could be easily scripted. And they should be because it will be so much quicker to maintain them, we can see where the raw part data comes from, and this is a body shape that may grow in the future so the time investment to make the script is worthwhile. I don't see a script at https://github.com/pointhi/kicad-footprint-generator/tree/master/scripts so I believe they are all hand-made now.

martinjaeger, 2019-02-27:
Thanks for the quick feedback. I agree that we should not break compatibility with current library, so we can add the footprints with new naming and still correct the hole diameters of the footprints with old names.

I saw that @antoniovazquezblanco recently [added auto generated 3D models for Varistors](https://github.com/KiCad/kicad-packages3D/tree/master/Varistor.3dshapes), so maybe he knows if there is a script for the footprints aswell?

If there is really no script existing yet, I can try to build one.

Suggestion for naming (example): RV_Disc_D10mm_P7.5mm_T4.3mm

- D is the **nominal** diameter
- P is the pitch and is the second parameter instead of third to improve sorting of similar types.
- T is the thickness, as in the datasheets. The previously used W denotes the width, which is the "maximum" D. So using W here would be confusing.

If we change the names in the footprints, we should make a copy of the 3D models with the new names, correct?

evanshultz, 2019-02-27:
Actually, Stefen added the 3D model script at https://github.com/easyw/kicad-3d-models-in-freecad/pull/226. The PR you mentioned was a small addition to the library.

I think @poeschlr should contribute to the naming. He came up with most of the footprint naming before so it should fit in his vision.

Why do names in the footprints need to be changed? I'm not sure what your last sentence is talking about. We can change the drill holes in existing footprints but no existing footprint names need to be changed.

martinjaeger, 2019-02-28:
I was referring to point 2 of your message above:

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

Did not mean to change existing footprints, but add new (copied) footprints with new names. But the new names in the footprints should match with names of the 3D models, or not?

evanshultz, 2019-02-28:
OK. Got it. The 3D model name and footprint name should match. We can make new 3D models easily by script so that's no problem.

Thread 1449 (2019-03-01):

*BUG* Wrong Footprint Diode SMD

filewalker1, 2019-03-01:
Hello!

i found a problem with the Diode Footprint:
simple Diode library symbol has the anode labeld with pin 1, but footprint diode_smd:D_sma has anode labeld pin 2.
I am not quite sure if this is a problem with the footprint library or the schematic symbol library...

evanshultz, 2019-03-01:
Except for in the `pspice` and `Simulation_SPICE` libraries, which are only to be used for circuit simulation, all other diode symbols and all diode footprints should have the cathode as pin 1. The simulation diode is backwards because of the standard SPICE diode model's pin order.

I believe that's what has bitten you. Let's take a look.

Here is the symbol that I think you refer to:
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

You can see there are warnings about this diode in the schematic symbol chooser.

And here is the footprint:
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

You should a `Device:D*` symbol or any symbol in the `Diode` library for a diode that is for PCB design (and not simulation).

I'll leave this open for a couple days in case I've misunderstood.

filewalker1, 2019-03-06:
@evanshultz
Thank you for your reply! you are absolutely right. I did not know there was a pspice simulation lib in there. i pressed "a" to add a Symbol an Diode was in the last-used list and i did saw the pspice hint. Sry for my false Bug Report!

Closed 2019-03-06.

Thread 1450 (2019-03-01):

QFN16 3x3 for NCN4555

jneiva08, 2019-03-01:
Hi,

In the [datasheet](https://www.onsemi.com/pub/Collateral/NCN4555-D.PDF) of NCN4555 says QFN16 3x3 P0.5.

The QFN-16 3x3 P0.5 EP1.75x175 don't exist. the more approximate in the repository is WQFN-16-1EP_3x3mm_P0.5mm_EP1.75x1.75mm.

The QFN-16 should be created or can use WQFN-16?

evanshultz, 2019-03-01:
We aren't requiring this, not that I've seen anyway, but we would prefer if you create a footprint with the correct type.

This is because the WQFN and QFN likely have different heights and so the matching 3D model can reflect the actual package. Also, it avoid any confusion because the footprint in KiCad matches the package name from the datasheet.

Because the scripts easily allow making QFN footprints and 3D models it's easy to make a new footprint and so other contributors have already been doing this - making a QFN footprint even if an otherwise-identical WQFN footprint exists.

jneiva08, 2019-03-04:
Symbol: https://github.com/KiCad/kicad-symbols/pull/1601
Script: https://github.com/pointhi/kicad-footprint-generator/pull/306
Footprint: https://github.com/KiCad/kicad-footprints/pull/1458

myfreescalewebpage, 2019-03-04:
Thanks @jneiva08 for the contribution, closing the issue now.

myfreescalewebpage, 2019-03-04:
@evanshultz just realized you have assigned yourself, sorry for closing this at your place :) Anyway your answer is very nice because I have several PR in which people ask why we don't use existing approximative footprints, so now I will be able to link with this issue.

Closed 2019-03-04.

Thread 1452 (2019-03-01):

Footprint Dual P-Mosfet DMP2160UFDB - How to commit

pboe, 2019-03-01:
Hi,
i would like to contribute a footprint for Diodes Package U-DFN2020-6(Type B)
used by e.g. https://www.diodes.com/assets/Datasheets/ds31643.pdf

Do you prefer the generic way naming it like:
DFN-6-2EP_2x2mm_P0.65mm_EP1x0.6mm
and leave the exposed pads unnamed

or more specific with name like
U-DFN2020-6(Type B)
and assign pin numbers 3 & 6 to the EPs
and contribute it with the corresponding symbols of the 4 dual p-Channel Mosfets from Diodes?

evanshultz, 2019-03-01:
It looks like many, many companies use a largely-compatible package under a variety of names. See:
- https://www.infineon.com/dgdl/irlhs6376pbf.pdf?fileId=5546d462533600a401535663bef425af
- https://www.onsemi.com/pub/Collateral/FDMA2002NZ-D.pdf
- https://assets.nexperia.com/documents/data-sheet/PMDPB56XNEA.pdf
- http://www.mccsemi.com/up_pdf/MCMNP517(DFN2020-6U)-A.pdf
- http://aosmd.com/res/data_sheets/AON2810.pdf

 `DFN2020-6` or some similar variant is common, but so is just a riff on `DFN-6...`. Some call it `MicroFET...` and Infineon, for reasons that don't make sense to me since the package has two rows of pins, calls it a `PQFN`.

So let's go generic. But because the dimensions can vary we have a choice to make. As our scripted generator doesn't support this type of package, if we don't try a "one size fits all" approach we could end up with a lot of similar footprints that could support all packages. (Unique packages are best, but for this general library let's go generic for handmade footprints.) How about `DFN-6-2EP_2x2mm_P0.65mm_EP1.0x0.7mm`?

pboe, 2019-03-02:
OK let's go the generic way.

> DFN-6-2EP_2x2mm_P0.65mm_EP1.0x0.7mm
0.7mm for the EP seems to be more generic, i'll extend the size of the EPs.

How to deal with the EPs? Assign pin number 7 & 8 and what's the best way to connect them? Just connect them on the pcb? This will probably result in erc errors, or make a symbol with the pin 7 and 8? Is there any way to hide those 2 pins  in the symbol view and connect them internaly?

evanshultz, 2019-03-04:
There are two ways:
1. Assign the same pin number to the pads on the PCB. They will automatically connect.
1. Stack two pins with different numbers in the symbol and use unique footprint pin numbers.

Both ways work, but the former is simpler. So... if all of the parts using this footprint use the same EP connection (the few I checked all do) then we can use that method. Does that make sense and sound OK to you?

pboe, 2019-03-05:
Sounds very good for me. Started a pull request yesterday.

evanshultz, 2019-04-01:
Thanks. Will close this then.

BTW, I just noted that the On Semi datasheet above references JEDEC MO-229. The others have no industry-standard package reference or specifically have a space for one but it is blank (assume it's intentionally a manufacturer-specific package or the datasheet is older than the JEDEC spec).

evanshultz, 2019-09-26:
To close an open issue here... the ON Semi datasheet mentions JEDEC MO-229 but MO-229 does not shown any packages with two EPs and the table mentioning the VCCC variation does in fact only show a single EP dimension. So ON Semi has made an error somewhere.

Closed 2019-04-01.

Thread 1463 (2019-03-05):

Missing TI DGN (S-PDSO-G8) or HVSSOP

rs-development, 2019-03-05:
I just created a new Symbol for the TPS7A16 Regulator but could not find the matching footprint.

[http://www.ti.com/lit/ds/symlink/tps7a16.pdf](http://www.ti.com/lit/ds/symlink/tps7a16.pdf)

http://www.ti.com/lit/ml/mpds046e/mpds046e.pdf

Is the footprint existing somewhere or should i create it?

evanshultz, 2019-03-05:
There are a few footprints in Package_SO that could work. The body size and lead pitch are common, and we are given a range of thermal pad sizes in the datasheet (1.34-1.6x1.66-1.92mm).

To show footprints having a thermal pad and matching the pitch and body dimensions and an EP less than 2mm in he X direction, we can enter the following in the footprint editor: `8-1EP_3x3mm*P0.65mm_EP1`. I am using a recent nightly and see this:
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

I would be inclined to go with `MSOP-8-1EP_3x3mm_P0.65mm_EP1.73x1.85mm` since it's a new, scripted footprint and has nearly correct thermal pad dimensions. That should work fine if you want to use an existing footprint in your own designs.

However, it would be best to make a unique footprint just for this part so the thermal pad size matches the datasheet. I would like to see this done if you're submitting the symbol. With the footprint script it's quite easy to make a new footprint so I would create a new one if you want to submit this symbol, and its footprint, to the library.

Thanks!

rs-development, 2019-03-05:
Thanks for that 👍

I will make the PR, if the part is used in our design.

rs-development, 2019-03-05:
Can you recommend the dimensions for the creation of the footprint. I can not find a manufacturer recommendation?

Pad Width in the middle from min and max?
Pad length is not well defined in datasheeet

Should the pad extent outside of the width of the package? From KLC i would guess it should not.

evanshultz, 2019-03-05:
An EP the maximum of the package's thermal pad should work. You can overwrite the EP size in the script if it uses the mean value.

Let's just keep the EP under the part body as the VSON handily wins with regards to thermals. I don't see much point in going crazy to add copper to the SSOP footprint if choosing the SON package will be dramatically better.

It looks like pad length is 0.4-0.7mm from page 31 of the datasheet. Are we talking about the same thing?

rs-development, 2019-03-05:
I was talking about Pins 1 to 8, i think the EP is quite clear.

I got confused with size restrictions of EP and normal pads. Are there any guidelines in the KLC regarding standard pad sizes?

evanshultz, 2019-03-05:
Our script handles this for you. Enter the package info and it will spit out the footprint. Are you using the script?

rs-development, 2019-03-05:
With script you refer to the wizard? The wizard seems to use pad values not component dimensions

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

evanshultz, 2019-03-06:
No, that thing is crap. I'm talking about https://github.com/pointhi/kicad-footprint-generator/tree/master/scripts/Packages/Package_Gullwing__QFP_SOIC_SO.

Thread 1482 (2019-03-16):

Mini-Circuits TT1224 Index

f6fvy, 2019-03-16:
The Mini-Circuits TT1224 footprint silk indicates pin 1, but the physical index (small printed circle) is located near pin 6 (check https://ww2.minicircuits.com/case_style/TT1224.pdf).

So, currently, you can't position correctly the device without referring to this datasheet.

Wouldn't it be useful to add a small circle near pin 6 on the silk layer to prevent any orientation mistake ?

aewallin, 2019-03-21:
KLC F.5.1.3 doesn't much recommend silkscreen under a mounted SMD component:
http://www.kicad-pcb.org/libraries/klc/

but I agree mini-circuits uses a confusing marking-scheme here - with ClockwisePinNumbering for added fun...
an additional circle on the F.Fab layer would probably be OK wrt. KLC, but do people look or print out the f.fab or just silk?

FWIW footprint development was at #1128

Thread 1487 (2019-03-19):

Request for SMD 2.54mm Pin headers in Horizontal config

gcormier, 2019-03-19:
The library is full of every other type it would seem, minus the horizontal SMD configuration.

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

Trying to get python scripting going has been failure for me. Would anyone consider churning out a bunch of these?

TSM-106-01-T-SH
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

evanshultz, 2019-03-21:
We don't take requests as a rule since that would overwhelm everybody and since our footprint tools are freely-available, but we can help you with scripting. Submit a PR or issue at https://github.com/pointhi/kicad-footprint-generator, tag me if you like, and we'll see what we can do to get you going. It's fun (a nerdy kind of fun) once you're over the hump!

I'm not sure if this is generic and making them manufacturer-specific was wrong, but did you see:
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

gcormier, 2019-03-21:
Will do!

Closed 2019-09-30.

Thread 1497 (2019-03-25):

Keystone 2468 screw holes are backwards

ianrrees, 2019-03-25:
The footprint has two mounting holes, currently they are in the wrong position.  They are oriented as for mounting the battery pack on the back side of the board, where the rest of the footprint puts the battery pack on the front side.  See http://www.keyelco.com/product-pdf.cfm?p=1033

evanshultz, 2019-03-25:
Thanks for taking time to report this.

Datasheet:
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

Footprint:
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

It looks OK to me, but you have to rotate and orient things correctly since the footprint has the `+` pin at the top left. Can you please clarify?

ianrrees, 2019-03-25:
Basically, the Y (or X) coordinates of the two mounting holes need to be swapped with each other.

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

evanshultz, 2019-03-25:
Oh. I got it. I didn't catch that this was about the mounting holes. Sorry.

Are you willing to submit a PR to fix this issue?

ianrrees, 2019-03-25:
I'll make one based on the web client shortly, but didn't do that initially because the last time I've made PRs to KiCad repos, they seem to have gotten caught in a morass of editing and commentary that left me feeling like it was a waste of effort.

Closed 2019-03-25.

Thread 1506 (2019-03-27):

issue with TQFP-32_7x7mm_P0.8mm footprint

tomeks1972, 2019-03-27:
I noticed that there is an issue with TQFP-32_7x7mm_P0.8mm footprint, which is used for ATMEGA328P-AU.  Pad 13 has its solder border set to wide than surounding pads 12 and 14. I am not able to lead any path from it.
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

tomeks1972, 2019-03-28:
I see that this isssue is in my project only. I don't know why. The original footprint is ok. I was trying to replace the footprint, no results. Finally I deleted my pcb and started from scratch. I close this issue, since it is not a fotprint library issue.

Closed 2019-03-28.

Thread 1518 (2019-04-01):

Incorrect footprint Molex micro-fit 43650-XX15

anymouse404, 2019-04-01:
Affected footprints are Molex_Micro-Fit_3.0_43650-??15_1x04_P3.00mm_Vertical where ?? is two-digit number of pins.
Two mechanical mounting holes in the corners have size 1.0 mm instead of 1.27 as recommended in datasheet.
Link to device datasheet is https://www.molex.com/pdm_docs/sd/436500415_sd.pdf
Attached is screenshot of datasheet combined with screenshot of footprint editor showing drill size.
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

Kicad version details are following:

Application: kicad
Version: 5.1.0-060a0da~80~ubuntu18.10.1, release build
Libraries:
    wxWidgets 3.0.4
    libcurl/7.61.0 OpenSSL/1.1.1 zlib/1.2.11 libidn2/2.0.5 libpsl/0.20.2 (+libidn2/2.0.4) nghttp2/1.32.1 librtmp/2.3
Platform: Linux 4.18.0-16-generic x86_64, 64 bit, Little endian, wxGTK
Build Info:
    wxWidgets: 3.0.4 (wchar_t,wx containers,compatible with 2.8) GTK+ 3.24
    Boost: 1.67.0
    OpenCASCADE Community Edition: 6.9.1
    Curl: 7.61.0
    Compiler: GCC 8.2.0 with C++ ABI 1013

evanshultz, 2019-04-01:
Confirmed. Thanks for reporting this and sorry for the error in our library.

None of these are using generic scripts, so I checked all Micro-Fit 3.0 scripts. Issues found:
- https://github.com/pointhi/kicad-footprint-generator/blob/master/scripts/Connector/Connector_Molex/conn_molex_micro-fit-3.0_tht_top_single_row.py, with the error reported above on line 55. Also, line 54 should be 1.02mm and not 1mm (small, but not to the doc.
- https://github.com/pointhi/kicad-footprint-generator/blob/master/scripts/Connector/Connector_Molex/conn_molex_micro-fit-3.0_tht_top_dual_row.py, lines 54 and 55 should be 1.02mm (see https://www.molex.com/pdm_docs/sd/430450212_sd.pdf)

Good scripts (at least with regards to pin and peg drill hole diameters):
- https://github.com/pointhi/kicad-footprint-generator/blob/master/scripts/Connector/Connector_Molex/conn_molex_micro-fit-3.0_tht_side_single_row.py
- https://github.com/pointhi/kicad-footprint-generator/blob/master/scripts/Connector/Connector_Molex/conn_molex_micro-fit-3.0_tht_side_dual_row.py
- https://github.com/pointhi/kicad-footprint-generator/blob/master/scripts/Connector/Connector_Molex/conn_molex_micro-fit-3.0_smd_top_dual_row.py
- https://github.com/pointhi/kicad-footprint-generator/blob/master/scripts/Connector/Connector_Molex/conn_molex_micro-fit-3.0_smd_side_dual_row.py (all SMD)

I'll update the scripts and push corrected footprints tomorrow unless somebody else gets to it.

evanshultz, 2019-04-02:
Thanks again for this report.

Script fix: https://github.com/pointhi/kicad-footprint-generator/pull/334
Footprint fix: https://github.com/KiCad/kicad-footprints/pull/1520

Closed 2019-04-02.

Thread 1526 (2019-04-04):

Crystal_SMD_HC49-SD_HandSoldering wastes too much board space

onitake, 2019-04-04:
The SMD variant of the HC-49 package has pads that are larger than necessary.
This wastes board space and is rarely useful.

If pads that are also compatible with larger packages are required, a different footprint should be created.

According to the data sheet http://cdn-reichelt.de/documents/datenblatt/B400/xxx-HC49-SMD.pdf , the pads should be 2x4.5mm, but they are 2x7.875mm. This is way too much, even for hand soldering. I built boards with this footprint, and 5-6mm pads would be perfectly sufficient.

evanshultz, 2019-04-04:
I think this might be just a case of footprint selection.

https://github.com/KiCad/kicad-footprints/blob/master/Crystal.pretty/Crystal_SMD_HC49-SD.kicad_mod, which references the datasheet you posted, is the standard crystal footprint. It has 4.5x2mm pad spaced 9.5mm apart, exactly like the datasheet.

https://github.com/KiCad/kicad-footprints/blob/master/Crystal.pretty/Crystal_SMD_HC49-SD_HandSoldering.kicad_mod, with a clear `_HandSoldering` suffix, has pads as you described above. The pads are again 4mm apart.

So you must be using the hand soldering footprint when you don't want to. Simply choose the standard footprint and it will have pads exactly as you wanted above. CvPcb may cut off the right side of the footprint name making it easy to confuse the footprints, so just be sure to pick the standard footprint.

I'm going to close this case since it seems like the footprint is fine and correct, but you can re-open if there is more to it that I didn't catch.

onitake, 2019-04-04:
My point was that even for hand soldering, 3mm on each side is wasteful.

I can use the regular footprint, yes, but that one leaves only a narrow space for heating the pad. The data sheet specifies 13mm edge to edge (4.5+4+4.5mm), and that just leaves a tiny 0.5mm space on each side for soldering.

So, both options are somewhat bad.

Is there a specific reason why the pads are so long? Perhaps an unwritten rule that hand-solderable pads need to be 3mm larger than necessary?

evanshultz, 2019-04-04:
It sounds to me like this is subjective. You are hand soldering and the pads are longer than you like. Somebody else, perhaps with a different skill set, different soldering iron tip, different solder, etc. may need longer pads and they created the current _HandSoldering footprint to suit them.

There is no guideline for hand soldering footprints that I've seen. I posted some colloquial thoughts at https://github.com/KiCad/kicad-footprints/issues/1302, and it seems similar to your suggestion in that much smaller pads are still reasonable.

Would you like to submit a few footprints with smaller pads? You could replace _HandSoldering with _Pad5.5x2 or _Pad6x2 depending on the pad size you think would work best. Either of those sound OK to me and I would be comfortable soldering it.

onitake, 2019-04-07:
I can do that, of course. However, I still think the _Handsoldering variant should be changed.

As soon as I have an actual photo that demonstrates this, I'd be happy to share it.
In the meantime, here's a comparison of of both existing footprints to illustrate:

Default variant:
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

_Handsoldering variant:
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

The 3D part was missing in KiCAD, I designed one myself and submitted a PR: https://github.com/KiCad/kicad-packages3D/pull/539

evanshultz, 2019-04-08:
Note to revisit changing the pads closer to v6's release.

antoniovazquezblanco, 2019-04-15:
What is the show stopper that doesn't allow us to target 5.1.2?

Thanks!

Thread 1536 (2019-04-07):

Texas S-PWSON-N10 issue

myfreescalewebpage, 2019-04-07:
Wanted to submit a new symbol, I have just checked if the footprint already exist. It is in the library but has not the right dimensions.

Existing footprint: Package_SON.pretty/Texas_S-PWSON-N10.kicad_mod
Dimensions: 3x3mm
Was added for: http://www.ti.com/lit/ds/symlink/tps63060.pdf

The device I want to submit: http://www.ti.com/lit/ds/symlink/tps54541.pdf
It has the same package name but it is 4x4mm.

Seems Texas package naming is not so clear and will need to pay attention for future submissions.... How is it possible to handle this for my new device ?

Thanks,
Joel

myfreescalewebpage, 2019-04-08:
Proposition: keeping package size and pitch every time ? In this case:
- TPS63060: Texas_S-PWSON-N10_3x3mm_P0.5mm
- TPS54541: Texas_S-PWSON-N10_4x4mm_P0.8mm
Joel

poeschlr, 2019-04-08:
In that case we can consider to completely drop the ti name alltogether as it then no longer realy adds anything (It can still be included in the description and keyword fields meaning a search will bring up the correct package)

We should however ensure that we do not change too many footprint names during a stable release phase. I might need to think about this a bit this weekend.

myfreescalewebpage, 2019-04-08:
According to me keeping Texas is great to explain from where the "S-PWSON-N10" comes from, but I'm not absolutely attached to it.

Also, I was thinking that we have probably several verification to re-check to ensure the symbols are correctly associated to the footprints because this kind of can clearly be forgotten during symbol reviews...

Sure, this is something to think, take the time required.

In my opinion the v6 is the opportunity to do this kind of modifications. People who want a stable release install and use v5.1 and do not follow the github repos. I have already discuss of that with @evanshultz because I think there is several huge enhancements like that to think and it is not possible to handle them just before the v6 release, we have to do it in advance.

evanshultz, 2019-04-09:
As I noted somewhere else, I think about a RF IC, TI told me the three letter name is the one to use. It is most descriptive and informative. You will see that play out again here where the footprint name shown above is the same but the three letter designation is different: DSC vs DPR.

In addition, the Texas_ prefix is valuable if the footprint isn't derived from a standard (like IPC) but instead adheres to the TI footprint given. In that case, we need the manufacturer prefix to indicate it's not a generic footprint but one meeting a specific manufacturer's recommendation.

evanshultz, 2019-04-09:
Found it. https://github.com/KiCad/kicad-footprints/issues/606

myfreescalewebpage, 2019-04-09:
Well done @evanshultz that's clearly the same issue applied to other devices :)

myfreescalewebpage, 2019-04-18:
@poeschlr any news for this subject ? Thanks for your return, Joel

poeschlr, 2019-04-19:
I think in future we simply go with the generic naming instead of using manufacturer specific conventions. (Unless it is a very specialized part.)

myfreescalewebpage, 2019-04-19:
Thanks. For the referenced footprint in my first message, can you give an example of how they should be named ?

myfreescalewebpage, 2019-05-30:
@poeschlr any help for my previous comment here ? Thanks so much, Joel

slowcoder, 2019-09-25:
Just a heads up. The PWSON-N10 footprint still doesn't work for TPS54541.  I found out the hard way.

Thread 1544 (2019-04-11):

Mirrored pinout for Connector:Tag-Connect_TC2030-IDC-NL_2x03_P1.27mm_Vertical

feklee, 2019-04-11:
The pinout for the *footprint* is mirrored, i.e. wrong:

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

See [datasheet][1]:

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

The datasheet is correct. I verified it with a Tag-Connect cable.

```
Application: kicad
Version: (5.1.0)-1, release build
Libraries:
    wxWidgets 3.0.4
    libcurl/7.61.1 OpenSSL/1.1.1 (WinSSL) zlib/1.2.11 brotli/1.0.6 libidn2/2.0.5 libpsl/0.20.2 (+libidn2/2.0.5) nghttp2/1.34.0
Platform: Windows 8 (build 9200), 64-bit edition, 64 bit, Little endian, wxMSW
Build Info:
    wxWidgets: 3.0.4 (wchar_t,wx containers,compatible with 2.8)
    Boost: 1.68.0
    OpenCASCADE Community Edition: 6.9.1
    Curl: 7.61.1
    Compiler: GCC 8.2.0 with C++ ABI 1013

Build settings:
    USE_WX_GRAPHICS_CONTEXT=OFF
    USE_WX_OVERLAY=OFF
    KICAD_SCRIPTING=ON
    KICAD_SCRIPTING_MODULES=ON
    KICAD_SCRIPTING_PYTHON3=OFF
    KICAD_SCRIPTING_WXPYTHON=ON
    KICAD_SCRIPTING_WXPYTHON_PHOENIX=OFF
    KICAD_SCRIPTING_ACTION_MENU=ON
    BUILD_GITHUB_PLUGIN=ON
    KICAD_USE_OCE=ON
    KICAD_USE_OCC=OFF
    KICAD_SPICE=ON

```

[1]: http://www.tag-connect.com/Materials/TC2030-IDC.pdf

feklee, 2019-04-11:
My bad, I had flipped board view enabled and didn't notice it.

Closed 2019-04-11.

Thread 1549 (2019-04-13):

Footprint Misnamed: Jack_3.5mm_Neutrik_NMJ6HCD2_Horizontal

gkeeth, 2019-04-13:
The footprint Connector_Audio/Jack_3.5mm_Neutrik_NMJ6HCD2_Horizontal is misnamed. This is a 1/4" (6.35mm) jack, not a 3.5mm jack.

For reference: https://www.neutrik.com/en/product/nmj6hcd2

I imagine the footprint can simply be renamed, i.e. Jack_6.35mm_Neutrik_NMJ6HCD2_Horizontal.

If any symbols call out this footprint, they'll need to be updated as well. "grep Jack_3.5mm_Neutrik *.lib" doesn't reveal any symbols that specify this footprint, but is there a better way to check?

evanshultz, 2019-04-22:
Thanks for this report.

This is a known issue and my PR at https://github.com/KiCad/kicad-footprints/pull/1145 will fix this problem. Since a fix is already in the works and it's a known issue I'll close this.

Closed 2019-04-22.

Thread 1555 (2019-04-21):

Footprints description contains Device Datasheet

jstjst, 2019-04-21:
I noticed, that many footprint description fields contain the device datasheet and not the footprint datasheets form the manufacturer. This can be seen at manufactor specific footprints and general footprints:
https://github.com/KiCad/kicad-footprints/blob/master/Package_SO.pretty/SOIC-8-1EP_3.9x4.9mm_P1.27mm_EP2.41x3.81mm.kicad_mod
https://github.com/KiCad/kicad-footprints/blob/cf71819ab37168bfad298de859b1bbd00f5a93f6/Package_SON.pretty/Texas_S-PVSON-N10.kicad_mod

This makes it harder to find footprints. I think, if available, the footprint datasheet should be linked and also the manufacturer footprint code added to the Keywords.

Cheers,
Jonas

evanshultz, 2019-04-22:
Hi Jonas,

There is some method to this. If the footprint is generated from a script, like many of the IC and connector footprints are now, the package drawing is the input to the script and the footprint a vendor supplies does not apply to our footprint. So in this case including the package drawing is correct. The first footprint you linked falls into this category and the description clearly shows it's a scripted footprint.

In other cases the footprints were handmade and the vendor footprint should be included. Many odd parts aren't scripted and so there will always be lots of parts in our library which do need the vendor-supplied footprint as a reference. In those cases, the documentation linked should show the footprint.

That all being said, I'm sure there are plenty of footprints that need some corrections and could be improved for all users by updating the description link.

jstjst, 2019-04-23:
I'm not sure if I understand you correct:

You stated, that the right document is link for the first footprint? The first footprint is not vendor specific, it is a commonly used footprint, so no vendor footprint code is given. But it has a device datasheet with a footprint drawing linked: https://www.analog.com/media/en/technical-documentation/data-sheets/ada4898-1_4898-2.pdf
But I think it would be possible and easy to find the drawing if we only link the footprint drawing: https://www.analog.com/media/en/package-pcb-resources/package/pkg_pdf/soic_edrd/rd_8_1.pdf

For the second footprint, there is the wrong document linked?

evanshultz, 2019-04-23:
OK. Let's look specifically at the two you showed above instead of generalizing.

For the first footprint, we can see that it's scripted and so only a package drawing is needed. That package drawing is on page 17 (the link to page 29 is wrong) and it even indicates compliance with JEDEC MS-012. The script then should use JEDEC MS-012 dimensions and mention this industry-standard package in the description. However, since the JEDEC docs require registration to get them directly from JEDEC we chose datasheets that shows compliance but were freely-accessible. Just linking to the package drawing and not a datasheet would be my preference as well, but the package drawing is the same either way so we'll consider both acceptable. There is no recommended footprint in this datasheet.

For the second one, we now know the three-letter code from TI is the best differentiator for naming footprints. See https://github.com/KiCad/kicad-footprints/issues/1536. So this footprint really would be best named as `Texas_DRC` or something like that. However, updating the footprint names requires updating symbols and nobody has put in the effort to do that. Yet. Nonetheless, if just a package drawing could be found that would be nice as well. And while it seems the documentation is OK (I didn't verify it against the footprint myself) I agree that the package name `DRC` or `DRC0010J` should be in the description and/or keywords.

Does that help to clarify things?

jstjst, 2019-04-23:
Yes, good explanation

Closed 2019-04-30.

Thread 1556 (2019-04-22):

SO vs SOIC

evanshultz, 2019-04-22:
We have a number of footprints which are prefixed with 'SO':
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

I mentioned one that I don't believe is needed at at https://github.com/KiCad/kicad-footprints/pull/1333#issuecomment-485519199.

https://github.com/KiCad/kicad-footprints/blob/master/Package_SO.pretty/SO-20_12.8x7.5mm_P1.27mm.kicad_mod seems like it could easily be SOIC and fit in well with the other footprints.

But what about the others? That leaves just 4, 5, and 6 pin footprints starting with 'SO'. Do we have any guidelines about how, when, or if to drop the 'IC'? Should they all be 'SOIC' since the vast majority of P1.27 and P2.54 footprints are this way?

myfreescalewebpage, 2019-04-22:
@evanshultz my personal position is that the footprint associated to a symbol should follow the content of the datasheet. This prevent future questions.

calebreister, 2019-04-22:
It is worth noting that the SO and SOIC footprints are not always identical, and the definition may very based on the manufacturer. For example, the [LT1118](https://www.analog.com/media/en/technical-documentation/data-sheets/1118fd.pdf) comes in an "SO-8" package. However, if you look at the bottom of the datasheet, you will find that the package dimensions are 3.9x4.9mm, which matches SOIC-8 in the KiCad library. Although both packages have the same pitch, SO-8 has a larger outline (5.3x6.2mm).

Note: the LT1118 is not in the official KiCad library (*yet*). I'm using it in a project, and plan to contribute it when I get the chance to make sure it is fully KLC-compliant.

myfreescalewebpage, 2019-04-23:
Good example from @calebreister !

evanshultz, 2019-04-23:
The nomenclature used by a specific manufacturer should not matter. What if another company reversed the terms in their documentation? What does that mean to us?

Thanks to Rene, we have a nice gullwing footprint generator that uses IPC rules and DOES NOT rely on what any individual vendor says for industry-standard package types. So I think internal consistency is the important thing to consider.

To close the loop, LT's "SO-8" package is fully compatible with [JEDEC MS-012](https://www.jedec.org/taxonomy/term/2343), which uses only "Small Outline" in the document body but falls under the "SOIC" category on their website. IPC-7351B also does the same thing:
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

So... I think using SOIC for a generic footprint is the right way to go.

myfreescalewebpage, 2019-04-24:
Hummm but how to know if "SO" package for a specific device of a specific manufacturer can fit the SOIC definition ?

evanshultz, 2019-04-24:
Body size and lead pitch are part of the footprint name.

myfreescalewebpage, 2019-04-24:
Sure.

Thread 1559 (2019-04-26):

Using git hooks to run tests before committing

5N44P, 2019-04-26:
Hi guys!
I'm relatively new to git, and today i've learned the existance of the git hooks, letting you run a script before committing.

It would be intresting to run the KLC helper script for footprints [(check_kicad_mod.py)](https://github.com/KiCad/kicad-library-utils/blob/master/pcb/check_kicad_mod.py) before making a commit (on the local branch, before pushing to the contributor's remote fork, before opening the PR), aborting the commit if some error is given by the script. In case of known warnings that can be ignored, it seems that `--no-verify` can be used to skip the git hooks checks.

+ What are your thoughts on this? Have i just discovered the wheel?
+ Has anyone implemented a pre-commit hook for this and can help me implement it on my client?
+ Is it just a bad idea?

The same could probably apply to the sch symbols and the 3D models, but i really don't know since i've never contributed anything there.

poeschlr, 2019-04-27:
Not really a topic where we have any experience. If you want to know this in general then stack-exchange or a similar software development forum might be the best place to ask for support.

I don't think we have any check scripts for 3d models right now. I am not even sure what we could reliably check without considerable development effort.

cpresser, 2019-08-23:
Indeed, it would be nice to have the output of the helper-scripts before commiting. But I agree with @poeschlr, there are to many false positives.
It seems like you already figured on how to run the scripts manually in your local tree.

The contribution guidelines (http://kicad-pcb.org/libraries/contribute/) already cover this.
Do you think it would be a improvement to add a new point between 5 and 6?
> 5a: (optional) use the helper-scripts to check your new changes for common problems. Be aware that the script-output is just a helper. You need to check each reported violation manually.

chschlue, 2019-08-23:
This is nice, but is it worth the effort?
I would image people regularly forgetting to update their local scripts and then missing errors after the commit thinking they already checked for themselves, only complicating things.
PRs can always be (and are usually?) squash merged, so spamming commits until a PR passes the tests doesn't hurt much.
Just my two cents.

Thread 1582 (2019-05-07):

TSOT-23-6 - 3D model wrong link

DecadoPL, 2019-05-07:
PCB library for footprint TSOT-23-6 doesn't display 3D model due to wrong link.

It is:
${KISYS3DMOD}/Package_TO_SOT_SMD.3dshapes/TSOT-23-6.wrl
But should be(according to file names):
${KISYS3DMOD}/Package_TO_SOT_SMD.3dshapes/TSOT-23-6MK06A.wrl

I'm new(1 week) KiCad user and don't want to change it by myself in repo.  Would be nice if You could fix it.

evanshultz, 2019-05-07:
Thanks for taking the time to notice this and report it.

The issue is actually the 3D model name being wrong. This is a standard package so the MK06A suffix does not need to be included. (I guess it came from a datasheet like https://www.adrirobot.it/datasheet/integrati/pdf/LM2736Y.pdf?)

I'm closing this PR now and have created a new issue at https://github.com/KiCad/kicad-packages3D/issues/546.

Closed 2019-05-07.

Thread 1583 (2019-05-07):

Potentiometer_Omeg_PC16BU_Vertical wrong pad number

McColson, 2019-05-07:
Hello,

I think the footprint of 'Potentiometer_Omeg_PC16BU_Vertical' has a problem with the pad number.
In fact, the number 1 and 3 are interverted.
The Silkscreen is on the front layer, so the pin 3 should be at the bottom of the picture.
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

evanshultz, 2019-05-07:
I believe this is covered by https://github.com/KiCad/kicad-footprints/issues/188. Please confirm and, if so, close this issue. I would like to see this all resolved for v6, but since it will (may?) be a breaking change it won't happen in the near future.

McColson, 2019-05-08:
Hi,
I'm not totally sure to understand well the #188 but, in the picture here : https://user-images.githubusercontent.com/1936989/35872082-bc1a3ae4-0b1a-11e8-8780-868674a6d77e.png
The ALPS at the left of the omeg footprint is good, the pin numbers are correct (compare to the symbol of a potentiometer in a Kicad's schematic), the omeg isn't. Maybe it's that you call the CW or CCW markings problem ?

evanshultz, 2019-05-08:
To make generic symbols the pin numbers of each individual part aren't considered.

That being said, the pin numbers aren't consistent or namely intuitively in KiCad at this time.

McColson, 2019-05-08:
Ok thanks you for your reply. I close the issue.

Closed 2019-05-08.

Thread 1589 (2019-05-09):

Holes wrong in OMRON relays

hildogjr, 2019-05-09:
I did the pull requests #1587 and #1588 for fix the hole error in the OMROS relays, see datasheet https://omronfs.omron.com/en_US/ecb/products/pdf/en-g5q.pdf

But I am getting a CI error of layer overlap that I don't understand.

evanshultz, 2019-05-09:
Well, you need to look at the footprint:
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

Here is the exact error message:
```
Violating F5.4
    Elements on the graphic layer should not overlap
    F.SilkS graphic elements should not overlap.
     - The following elements do overlap at least one other graphic element on the same layer
     - Line (2.03,-4.83) -> (2.54,-4.83) on layer 'F.SilkS'
     - Line (3.05,-2.29) -> (2.54,-2.29) on layer 'F.SilkS'
```

So a silk line is overlapping something on the same layer. (I'm not familiar with this exact part of the check script but it seems clear so I continued on.)

Looking at the above and checking the given locations, it appears the error is because the top and bottom of the coil are composed of two horizontal lines. Delete one and extend the other so the rectangle indicating the coil just uses four line and all will probably be well.

(Since only the endpoints are in common this error might be a bit aggressive, but if it's only checking for lines in the same orientation where they can be a single line it's relatively valid.)

IMO it's not required to make other updates when correcting a true issue, so I will merge without improving the silk lines. But if you want to tackle that fix I'm happy to merge those improvements too.

The silk outline is offset quite far from the fab outline. You could shrink the offset to 0.11-0.2mm if you like while you're at it. But again, this is not required.

hildogjr, 2019-05-09:
Thanks. Maybe I will deal with other time, because appear that the checking is complain of overlap because the beginning-end of different line at same coordinates.

evanshultz, 2019-05-09:
That's fine. I merged both of the PRs you submitted to fix the hole size issue. Thanks again!

Closed 2019-12-10.

Thread 1654 (2019-06-20):

Connector footprint library organization

evanshultz, 2019-06-20:
There is a bit of a problem with connector libraries: It's sometimes hard to figure out where a particular footprint goes!

Let's take an example of a single connector that is from a vendor with their own library. Does this new footprint go in:
1. `Connector.pretty`
1. `Connector_<vendor>.pretty`
1. `Connector_<function>.pretty`

An argument could probably be made for all three, but the latter two are where I run into the most questions. How to decide? Is there an overall priority where we go with the connector function (HDMI, USB, etc.) if a library exists? So function overrides vendor? Or has this never been discussed before?

This came to my mind when looking at https://github.com/KiCad/kicad-footprints/pull/1636. They are FFC connectors, but they're from Molex.

poeschlr, 2019-06-21:
This is actually clarified in the KLC http://kicad-pcb.org/libraries/klc/F1.2/

My intention when making the original draft (that got converted to this rule by oliver) was the following:

There are two types of connectors. Ones where the mating end is standardized (USB, DSUB, FFC, ...) and ones where it is a manufacturers standard (Phoenix MSTB, JST XH, ...)
The former are organized by the standard (So all USB connectors live in the USB lib.) The later are organized by manufacturer.
Both types of libs can be further split up. (The Phoenix libs are examples of that.)

The Connector lib is there to collect footprints for parts that do not fit anywhere else but there are simply not enough similar parts to merit making one.

evanshultz, 2019-06-21:
Alright. Thank you.

Let me add some more details just for my own providence.

A USB connector can't go into `Connector` but must go into `Connector_USB`. If there are a lot of Molex USB connectors, they may move into `Connector_USB_Molex`. `Connector_USB` would then only contain USB connectors not made by Molex. And `Connector_Molex` would never contain any USB connectors.

And all that means that the PR I referenced went into the correct lib. Yay!

Closed 2019-06-21.

Thread 1663 (2019-06-25):

Connectors with wrong orientation in footprint name

evanshultz, 2019-06-25:
There are a number of connector footprints with the wrong orientation because of a typo in the scripts. This issue is to track them so for v6 the old ones can be removed and new, corrected ones can be added.

- [x] Hirose DF63 (remove `_Horizontal`)
- [ ] Samtec HLE, SMD and THT libraries (should be `_Vertical`)

poeschlr, 2019-06-26:
We are allowed to rename footprints. The reasoning is that they are embedded in designs and do not rely on the temperamental rescue feature. (Which was the reason given by @stambaughw for not changing symbol libs too much during a stable release.)

Also: if a wrong name can mean users get confused about which part it is then it would be classified as a bug and can even be changed for symbols. (A typo in the part number would be a typical example in the symbol side. the wrong cleartext naming of a footprint another. Even if the part number is included as well as users will not really parse that as easily.)

antoniovazquezblanco, 2019-07-09:
Added some changes to fix this to https://github.com/pointhi/kicad-footprint-generator/pull/392 I will now generate the corresponding footprints.

If this is too much I can revert the changes.

Thanks!

evanshultz, 2019-07-09:
This should add duplicate footprints (`_Horizontal` suffix for horizontal footprints that were incorrectly suffixed with `_Vertical` before). I understand we are allowed to change/remove footprints at any time since they're sucked into the board file.

I started a list above about which connector series have dual suffixes and which suffix is to be removed. Can you please add to the list?

antoniovazquezblanco, 2019-07-09:
Ohh! I though that this was to keep track for removal during v6 but was finally moved to v5.3. I've added the removal of the old DF63 footprints to my PR and checked all the Hirose connectors. That PR should tick all the `Connectors_Hirose` footprints when merged. But I do not have time to go all over all the connectors available.

evanshultz, 2019-07-09:
Yeah... well... I still feel nervous to delete footprints at will but I understand Rene is saying that's OK. I don't think waiting until v6 is a big deal, but if this can be done sooner with Rene and the dev team understanding and approving then so be it.

antoniovazquezblanco, 2019-07-10:
I am also nervous about it but footprints will not disappear from your board if no longer in the library and poorly named footprints can lead to confusion and errors when designing new boards.

Footprint renaming has been done in previous stable releases (e.g. v5.1.1) without any complaining from the devs.

poeschlr, 2019-07-12:
Footprints can be renamed without issue. I would still require good reason to do so as to keep the library from being too volatile. (Something like this is a clear case where the name change can be easily explained. Changing naming conventions however is something that is harder to explain and should be avoided even across major releases if there is no tangible benefit to the change.)

antoniovazquezblanco, 2019-07-16:
Fixed

evanshultz, 2019-07-16:
I'm not sure if there are others, but just clicking through the generic pin and manufacturer-specific connector libraries I found two other (related) libraries which appear to have vertical and horizontal confused.

Thread 1674 (2019-07-06):

SD_Connector: wrong footprint orientation

gmsotavio, 2019-07-06:
During my inspection, I've found which several footprints in SD_Connector library have a wrong orientation. KLC F4.2 states: "Footprints should be oriented such that Pin 1 is located in the upper left corner (IPC-7351)." (http://kicad-pcb.org/libraries/klc/F4.2/). Am I right?

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

evanshultz, 2019-07-08:
There are many footprints which are older and do not adhere to the latest KLC guidelines. I think these fall into that category. Thanks for pointing out these issues so they can be resolved.

If time permits, I understand Rene allows footprints to be changed at any time. However, it would certainly be nice to get this done for v6 so I've added that milestone.

antoniovazquezblanco, 2019-07-09:
@gmsotavio will you be willing to open a PR to fix the issue?

Thanks

gmsotavio, 2019-07-10:
@antoniovazquezblanco OK. Now that the issue has been confirmed, I will provide the fix. Thanks.

cpresser, 2019-09-06:
Related question: Should we apply KLC 4.2 for all connectors? There are quite a lot (non SD-Card connectors) that don't follow that rule.
For example, I just looked at https://github.com/KiCad/kicad-footprints/pull/1770.
Or "MMCX_Molex_73415-0961_Horizontal_1.0mm-PCB".
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

evanshultz, 2019-09-06:
Yes, we should. Pin 1 should normally be in the top left. It's on the left for 2-terminal footprints (not sure this applies to any connectors, but think about chip resistors). And in the top center if pin 1 isn't on a corner (like PLCC footprints).

Since this is such a minor change, I'd suggest making an issue, marking it for v6, and creating a list of connector [families] which need updating. This can be queued and then implemented closer to v6's release date. No need to make branch conflicts or change things for only a minor KLC fix right now.

poeschlr, 2019-09-07:
Most of our connector footprints are scripted and should full fill this rule already. So i guess it will be only a few that are problematic. I agree that the first step would be assessing what needs to be done and that this would be best in an issue. After we have this information we can then decide if it makes sense to fix it now or if it is best left for later.

Thread 1712 (2019-07-16):

Where to put connector mating information

calebreister, 2019-07-16:
I'm working on adding a large portion of the [Samtec Q Strip](https://www.samtec.com/connectors/high-speed-board-to-board/mezzanine/qstrip) connector family to the KiCad libraries, and have written a [wizard](https://github.com/calebreister/kicad-footprint-wizards/blob/CalebReister/QStrip_wizard.py) (a more automated version is in the works) capable of generating both terminals and sockets. Within this family. For any given connector in the family, there are likely two or three sockets that can mate with it. I have several questions:

- Should a list of compatible connectors be provided in the footprint metadata?
- If so, where should it be specified? Should a `mate` property (or something similar) be added?
- Should the list include all connectors that are *mechanically* compatible (not necessarily pin-compatible)? Example: single-ended terminals can fit in differential sockets, but some of the pins are unused.
- Should compatible connectors that are not in the library be included in the list?

evanshultz, 2019-07-17:
This is my opinion as just one of the librarians: I wouldn't list compatible connectors. It will rot in some fashion. If the documentation lists mating connectors or both genders are in the datasheet that should be relatively easy to find.

As these connectors are for a specific standard I expect folks who need this connector to be versed in it. If you mention the standard to which these connectors adhere I think we'll be good.

Also, the footprint generators the librarians use are at https://github.com/pointhi/kicad-footprint-generator. It appears at a glance that the repo you're working on is an old creation of the previous head librarian. (Yes, the repo locations make this confusing.) While we can accept the footprints with no problem, for maintainability it is much preferred to use the modern framework I linked above. Again you need not change anything you're doing this is just sharing information.

calebreister, 2019-07-17:
@evanshultz Ok, I'll leave that information out. I'm currently reworking my wizard code using the newer framework. Note that the vast majority of Q Strip family are general purpose high-speed connectors, of which the HSMC card connectors are a special case.

calebreister, 2019-07-23:
Update: here is the PR for the newer script.

https://github.com/pointhi/kicad-footprint-generator/pull/397

Closed 2020-09-06.

Thread 1738 (2019-07-24):

Courtyard placement question

gmsotavio, 2019-07-24:
I have a really dumb question about KLC F5.3 (http://kicad-pcb.org/libraries/klc/F5.3/)

What is it supposed to do when these two requirements cannot be simultaneously satisfied:
1. All courtyard line elements are placed on a 0.01mm grid
2. Unless otherwise specified, clearance is 0.25mm

Must the clearance be 0.25 mm or may be close to 0.25 mm? Must the courtyard line be placed on a 0.01mm grid or preferable be placed on a 0.01mm grid?

Shackmeister, 2019-07-24:
Round the 0.25mm to nearest 0.01 grid

gmsotavio, 2019-07-24:
> Round the 0.25mm to nearest 0.01 grid

Thanks!

Closed 2019-07-24.

Thread 1756 (2019-07-29):

Taiyo Yuden SMD inductor solder pads bigger than MF recommended

seppestas, 2019-07-29:
The L_Taiyo-Yuden_NR-xxxx footprints do not seem to follow the manufacturer recommended landing patterns. All pads seem to be 0.2mm longer (Y axis) than recommended.

E.g, the length of the pads of the L_Taiyo-Yuden_NR-40xx footprint is 3.9mm in [this libraries KiCad module](https://github.com/KiCad/kicad-footprints/blob/cf71819ab37168bfad298de859b1bbd00f5a93f6/Inductor_SMD.pretty/L_Taiyo-Yuden_NR-40xx.kicad_mod), but it is only [supposed to be 3.7m according to the datasheet](https://www.yuden.co.jp/productdata/catalog/wound04_e.pdf).

Is this a mistake, or was this done to improve solderability?

seppestas, 2019-07-29:
@SchrodingersGat it looks like [you generated these footprints "as per datasheet" in the original Inductors.pretty](https://github.com/KiCad/Inductors.pretty/commit/70424128869bbb13c27fcbccf8b3db344ec662a7).

Could you clarify if this is a mistake or intentional? If intentional, is there a rule for it?

evanshultz, 2019-07-29:
@seppestas
Thanks for bringing this up. That means it's an old footprint and subject to loose interpretation.

Making bigger pads could be helpful in some circumstances, but it should not be the expectation in this library if the footprint name or description don't indicate any deviation. We'll wait for @SchrodingersGat  to respond in case he can shed any light on this, but I'm of the mind the footprints should be updated to match the datasheet.

And note that the documentation linked in the original PR is not available. The parts do not match the _current_ datasheet, but that doesn't mean they weren't built correctly according to an older version of the datasheet.

Either way, I'm marking this as a bug.

SchrodingersGat, 2019-07-30:
Hi guys, this was a fair while ago so I cannot specifically remember why this deviation was made. Sounds like a PR should be made to fix this.

Closed 2020-10-01.

Thread 1764 (2019-08-03):

ST_VL53L1X wrong rotation?

michael-p, 2019-08-03:
Dear all,

I think the footprint OptoDevice/ST_VL53L1X is rotated incorrectly by 180 degrees. The part was added in #1623.
Looking at the [datasheet](https://www.st.com/resource/en/datasheet/vl53l1x.pdf), Figure 19, you can see that Pin 1 (which has this little "nose") should be in the bottom right corner, however, in the Kicad footprint it is in the upper left corner (see #1621 for an image). Note that Figure 18 and 19 in the datasheet are quite confusing because they switch between "looking from top", "looking from bottom", and "looking through top" views without clearly stating it!

Despite the rotation-issue the footprint seems to be fine, so it's generally useable but will cause problems with pick-and-place machines.

I did not yet check the other part that was added in the merge request (VL530X).

Best
Michael

cc @5N44P @poeschlr

5N44P, 2019-08-03:
Hi there,
The rotation is imposed by the Kicad Library Convention, see [KLC F4.2](http://kicad-pcb.org/libraries/klc/F4.2/), which states:

> Footprints should be oriented such that Pin 1 is located in the upper left corner (IPC-7351).

michael-p, 2019-08-03:
Thanks for the info, I was not aware of this convention! Do you have any advice on how to handle the rotation then? I was assuming that the footprint has to be drawn with exactly the same orientation as in the datasheet so that pick & place machines can use the correct orientation (relative to the tape). In fact I just got a board back from Macrofab where this part is off by 180 degrees :)

Kind regards
Michael

cpresser, 2019-08-05:
Hi Michael,

I feel your pain, I had a similar issue recently.
But I agree that the footprint is correct. The Pin1 Marker is correct in F.Fab and F.Slik layer.
The CAM-Operator is supposed to check the datasheet, it contains the info where Pin1 is. That can be checked against F.Fab.

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

One possible improvement of the footprint would be to add information about the protective liner. That could be added to the Cmts.User layer.

evanshultz, 2019-08-05:
IPC 7351 has always used pin 1 in the top left where it works (it does there, and there are other conventions for different part shapes) and so KLC adopted that industry-standard convention. (We can ignore later revisions to that document which support other, optional, component orientations.)

The datasheet is never to be understood as representing the component's orientation in the packaging. Many parts are available in various packaging and the datasheet need only show the package. Note package and packaging are different.

Indicating anything about the reel in the footprint is likely only adding pain later. What is other packaging becomes available? What if different reel sizes use different package orientation? What is the SMD machine only supports trays and so the parts are re-packaged. A general-purpose library like this one can't know all of those downstream details and would cause as many problems as they might potentially clarify.

In my experience at various assembly houses of various sizes in multiple continents, this is not required to be part of the footprint. So I'm dubious if it would really help anyone or just make contributions more difficult for no benefit. I don't know every situation, of course, but I can't see an upside.

Placing parts at the wrong orientation is always a huge frustration and pain so I do understand the desire to figure this out and get it right. Should the footprint have been wrong it would have been something nice to resolve and I appreciate your effort, Michael, to raise up a potential problem.

I'm closing this issue since it seems resolved and I'm not aware of any further action needed.

Closed 2019-08-05.

Thread 1777 (2019-08-11):

Where are the 3D models referred in the footprints?

DomoticX, 2019-08-11:
Hello, it seems some 3D shapes are missing?

for example in SOP-8_3.76x4.96mm_P1.27mm.kicad_mod

https://github.com/KiCad/kicad-footprints/blob/master/Package_SO.pretty/SOP-8_3.76x4.96mm_P1.27mm.kicad_mod

the link to shape is:
${KISYS3DMOD}/Package_SO.3dshapes/SOP-8_3.76x4.96mm_P1.27mm.wrl

https://github.com/KiCad/kicad-packages3D/tree/master/Package_SO.3dshapes

but does not exist....

SOP8 is common used.... there are only 4 and 16 pin in the libs??

am i missing something? or are the links automaticly genererated? (too add the 3d shape in the feature?)

gmsotavio, 2019-08-11:
Hello @DomoticX,

You are right, the 3dshape model seems missing. The reason for this is there are no available 3D models for all footprints in current KiCad library. Make a footprint is easier than make a 3d model. Moreover, not all contributors have 3D modeling ability or even time to make a 3D model. The link you have mentioned is not automatically generated. Actually it is purposely inserted in the footprint, avoiding the need to make changes in the footprint if someone add the 3D model later. The footprint 3D model requirements is described in KLC F9.3 (http://kicad-pcb.org/libraries/klc/F9.3/)

Regards.

DomoticX, 2019-08-11:
Alright thanks!, ps. may i have one suggestion?, i also see some referral link to external pdf in the footprints, these pdf links decay over time (404 error and so...) why not put all the PDF docs offline in a folder and/or install with kicad?, the extra 500MB is not much (since kicad is 5-6GB) and the documentation is then always available (also offline) i can help you with that if needed?, what do you think?

poeschlr, 2019-08-12:
Regarding docs: It is not because of memory but because of maintenance effort. If the link fails then the user is at least aware of the fact that the info is out of date. With a local pdf there is no chance to ever discover that. Meaning local pdfs would require regular checking which is simply not possible with our manpower.

And of course there is always the question of licensing and copyright.

poeschlr, 2019-08-12:
@gmsotavio you seem interested in helping out with our effort. Would you be prepared to join the team?

gmsotavio, 2019-08-16:
@poeschlr Sorry for the delayed reply. KiCad has been a very useful tool for me in the last years. Whenever I can, I use some of my spare time to contribute in some way. What I need to know before joining the team? Thank you for the invitation.
Regards

DomoticX, 2019-08-16:
@poechlr, The info in the PDF does not go out of date ...there could be some revisions, but that's more like fixing typo in the datasheets, however the chip could be obsolete within a decade, but doesn't mean it cannot be used then. 99% of every chipmaker provide the datasheet PDF's for free, how else would they sell chips without describing the functions of them? ;-), i sure can help here and there collecting data if needed...

chschlue, 2019-08-16:
> The info in the PDF does not go out of date ...there could be some revisions, but that's more like fixing typo in the datasheets,

There could be missing commas.
There could as well be wrong pinouts, wrong thermal characteristics, wrong (or out of date) packaging information, wrong whatever...

> 99% of every chipmaker provide the datasheet PDF's for free

99% of YouTube videos are provided for free. That does not necessarily mean you may redistribute them at will. And you may certainly not just stick a CC-BY-SA to them and distribute them with some random software package.

chschlue, 2019-08-16:
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

Pin functions, regulatory approvals, insulation characteristics, mechanical dimensions and other irrelevant nonsense.

gmsotavio, 2019-08-25:
As @poeschlr highlighted, there are licensing and copyright issues too. As an example, lets take a look in the datasheet of Keystone Test Point 5000 Series
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

The document states "THIS DOCUMENT IS THE PROPERTY OF KEYSTONE ELECTRONICS CORP. AND SHALL NOT BE REPRODUCED, **DISTRIBUTED** OR USED AS A BASIS FOR MANUFACTURE WITHOUT PRIOR WRITTEN PERMISSION FROM KEYSTONE ELECTRONICS CORP."

DomoticX, 2019-08-26:
Yes, some datasheets may have these writings but limited to a few, normally any chip datasheet isn't copyrighted (e.g. CD4066):

https://www.electroschematics.com/wp-content/uploads/2011/04/cd4066-datasheet.pdf

Ps. the cherrypicked datasheet with changelogs looks like taken from a cpu chip or PCB ;-) normally a "simple" chip doesn't have this large changelog...

jkriege2, 2019-08-26:
The situation is actually rather simple: all material on a manufacturers homepage belongs to that manufacturers (or any website owner for that matter) by default and unless stated otherwise! Also you don't need to explicitly state that a work is copyrighted. The author (or in our case often the employer) is automatically granted that right and with it the right to redistribute and relicense at will ( see e.g. https://en.m.wikipedia.org/wiki/Copyright). It is the same as with other content on e.g. a webpage: just because you're free to use it does not mean you're free to redistribute or reuse it or derive from it.
In addition: many manufacturers state somewhere in their site (often in an impression and a bit hidden) a license that covers all their materials and that - in many cases - is similar to the example above, I.e. you may download and use the provided documents for their intended purpose, but you may not redistribute and relicense (which are the rights we would both require to put these datasheets into a github repo)

Hope that clears this up.
Jan

jkriege2, 2019-08-26:
Just some examples:
- https://www.microchip.com/about-us/legal-information

"Website Usage & Limitation of Liability: Use of any materials, information, text, graphics or data provided on Microchip’s Internet website is governed by our Terms of Use. Click here to read further."

https://www.analog.com/en/about-adi/landing-pages/001/terms_of_use.html

"ADI grants you a revocable, non-transferable, non-exclusive license to view, print out or download a single copy of the ADI Information, solely for internal non-commercial or informational use provided that you do not remove any copyright, trademark or other proprietary notices. Other than the foregoing limited single copy license, no transfer of any other rights is made or intended with respect to the ADI Information and the ADI Site. ADI may terminate this single copy license at any time for any reason, including for any breach of these terms of use, or breach of any other ADI agreement or policy. Upon termination you will immediately destroy all ADI Information in your possession or control."

... and you will find similar licenses/terms for all manufacturers!

poeschlr, 2019-08-29:
@gmsotavio we do not really have pre requirements for joining the team other than your willingness to do so (Or rather: If we ask then you already fulfill what we look for.)

It is of course expected that you will need a bit of support by more experienced members at the beginning. I sent you an invite via github so if you are willing to dive in then just accept. (If you have any questions during a review then just ping us more experienced guys. You can also reach at least me and evan over at the forum.)

gmsotavio, 2019-08-30:
@poeschlr I accepted. It will be great to be part of the KiCad team. Since I started opening my pull requests here, I have learned a little about the workflow of librarians. But I think I'll still need some support in the beginning. Thank you for the invitation! ;)

poeschlr, 2019-08-30:
Just remember the golden rule "if in doubt ask" (and the second one "never merge something without testing it first" -> implies "never merge your own work") and you should be good to go.

chschlue, 2019-08-30:
> Ps. the cherrypicked datasheet with changelogs looks like taken from a cpu chip or PCB ;-) normally a "simple" chip doesn't have this large changelog...

These changelogs weren't exactly "cherry picked", I just happened to have them handy.
Also, they all belong to pretty simple ICs (20 pins max).

Either way, even if grave changes are not very common, they do happen often enough.

Closed 2019-08-12.

Thread 1836 (2019-09-09):

RFC: Adding IPC high density chip footprints

evanshultz, 2019-09-09:
See https://github.com/pointhi/kicad-footprint-generator/issues/421.

IPC 7351B land pattern naming shows one of three suffix letters are to be placed at the end of the footprint name (except for BGAs) to indicate the density. They are:
- M: Most Material Condition (Level A)
- N: Nominal Material Condition (Level B)
- L: Least Material Condition (Level C)

The library is currently built with Level B, medium density footprints, but this isn't indicated in the footprint name. In many applications, such as reducing inductance to vias in high frequency (high dV/dt) circuits, the high-density footprints are valuable. They can substantially improve Z/f when considering power distribution networks at high frequencies.

The footprint framework already supports making various densities, so my question here is about naming of footprints. My first thought is to keep the existing footprint names and add `_L` to the end. It may conform best to IPC is the existing footprints end in `_N`, but IMO that's unnecessary as the nominal density can be considered the default condition and users would normally select it and consider the one with a suffix as some variation. Users who knew about IPC density levels and wanted more dense footprint are probably capable, especially with the improved descriptions we would need for our footprints, to find these footprints and use them. I wouldn't be surprised if there's a better scheme but keeping some relationship to IPC's recommendation when building footprints to their standard seems prudent to me.

Thoughts? Rene suggested adding `_Density[M|N|L]` in the conversation linked above. What else can we consider and then boil it down to a good solution?

To hopefully having the conversation I want to initiate from being derailed again, please note that I am only talking about chip footprints. Capacitors. Resistors. Not DFNs. Not QFNs. Not other packages types. Only chip parts. Not other package types. And only the naming of the footprints to indicate density. And only adding the most dense footprints to chip packages. That's it. Nothing more is in scope of my initial question.

The doc mentioned above is widely available online, for example at http://ohm.bu.edu/~pbohn/__Engineering_Reference/pcb_layout/pcbmatrix/IPC-7x51%20&%20PCBM%20Land%20Pattern%20Naming%20Convention.pdf.

poeschlr, 2019-09-27:
My next project (after the current ones are done) will be to get the generators into a state where we can add this functionality in a nice way.

Thread 1843 (2019-09-11):

Pin 1 designator of some components is hard to spot

seppestas, 2019-09-11:
The pin 1 designator for some components is very minimal on some footprints. Especially on small-pitch IC packages and when using "lower quality" silkscreen (often as a result of ink jet systems common today) this results in a pin 1 indicator that is really hard, if at all possible to spot.

This could potentially cause issues during PCB assembly, especially when this is done by 3rd parties relying on the silkscreen.

As an example, the slightly longer silkscreen line to indicate pin 1 is only 0.3mm longer than the line on the other side for the [USON-10_2.5x1.0mm_P0.5mm footprint](https://github.com/KiCad/kicad-footprints/blob/29c6e48/Package_SON.pretty/USON-10_2.5x1.0mm_P0.5mm.kicad_mod). This looks fine when looking at a zoomed in picture on a high resolution screen, but on a real PCB this difference is really hard to spot.

I much favour the "dot style" pin 1 indicator since it's a lot easier to spot and it doesn't cause confusion like explained in #278.

IPC-7351C describes a couple of ways to mark pin 1, I assume the "slightly longer silkscreen" is based on it. However I have strong doubts it's applicable on this type of small footprint.

Since all these IPC rules are behind a paywall and thus hard to reference I think it would be interesting to clearly document proper pin 1 indication on the silkscreen in the KLC. [Right now the only things in there are](http://kicad-pcb.org/libraries/klc/F5.1/):
1. Pin-1 designator is provided on the F.SilkS layer
2. Pin-1 designator must be visible after board assembly

+ some pictures without explanation as examples. Having better, more clearly defined rules for this would make sure the pin designator is easy to spot and consistent across different types of components.

poeschlr, 2019-09-11:
Your favored dot style is in violation of IPC and will not be used by the official lib.

The footprint you show is however also in violation as the line should be removed near pin 1 instead of lengthened (as this is a no lead package, only gull wing style packages have silk elongated.)
I however doubt this will make it more visible in this case. There is simply a limit how small a part can be for silk to be a reliable helper. This is where the fab layer then comes in.

seppestas, 2019-09-11:
@pouschlr Note that the second image for KLC rule F5.1 also shows what I assume is an elongated edge near pin 1.

Keep in mind that not everyone has access to the IPC rules, and they tend to change. When they are used or enforced, IMO it's also important to mention what rule is used. I think the main problem is that the KLC does not clearly define how pin 1 should be indicated on the silk layer. Other parts of the KLC much more clearly define what should be done and what IPC rules are used.

Silkscreen is still often used as a reference, especially for low to mid-density PCBs. Having information on there that is not visible in real life makes no sense to me. Following the same argument, font sizes on the reference designator should also be tiny to the point where they are barely readable.

The "dot style" pin 1 designator can easily be removed for dense designs, just as the font size and thickness can be reduced for the reference designator or the reference designator could be removed.

poeschlr, 2019-09-11:
The general idea of the library is that we slowly move towards more and more IPC compliance. Using dot style would move in the opposite direction so it is not going to happen.

You are however correct that the rules can be documented a bit better. (It is on my list of things to do. But a day only has so many hours.)

Also re read my post! i said extended silk is used for gullwing style packages. The main screenshot clearly is of a gullwing style package (it is of a qfp.) The second part with extended silk is either a 5 pin sot gullwing package or a soic style gullwing with missing pin 5. I think it would be clearer to see if the fab layer would be shown in the screenshot.

Thread 1862 (2019-09-16):

What is the reason for Horizontal/Vertical and not Angled/Straight

evanshultz, 2019-09-16:
Blast from the past...

Does anyone recall or can find why this name change took place? It appears Rene suggested this at https://github.com/KiCad/kicad-library/issues/1622#issuecomment-334839536 (Oct 2017) and it was being enforced by https://github.com/KiCad/kicad-footprints/pull/7 (7 Nov 2017).

I seem to remember there was a discussion about which terminology worked best, and the key to the decision rested upon the word "angled" not being specific (could be 90 degrees, 45 degrees, etc.).

However, I can't find that conversation. Does anybody recall if I'm correct or can find it?

In hindsight, `Straight` and `RightAngle` might have worked and are the same number of letters as `Vertical` and `Horizontal`. I think the current paradigm is most salient and works well, but I just happen to notice that when I was searching.

poeschlr, 2019-09-17:
Angled/straight don't make sense for all things. They can also be confusing (especially if you then also get 45° parts into the mix. They are after all angled.)

Another alternative (for connectors) would have been side and top entry (better as neither would fit the 45° parts so no confusion here)

In the end it was something where multiple choices were available and we needed to take one of them. Horizontal/Vertical simply won out at the time and i would not change it to be honest. (Massive renamings always come at the cost of long term users whose own assets are now out of date. So there really must be a major benefit to it for it to make sense. I do not really see a reason to exchange the current orientation naming.)

evanshultz, 2019-09-17:
All I wanted to know was about the discussion on this. It seems we recall the same discussion and outcome. Thanks for confirming.

poeschlr, 2019-09-18:
The thing is: If we question all of our decisions every few months then we will go crazy within a very short amount of time. (Or one of us burns out. Likely me)

Closed 2019-09-17.

Thread 1868 (2019-09-20):

Should the fab pin 1 mark eat into the part extents?

evanshultz, 2019-09-20:
From seeing the screenshot at https://github.com/KiCad/kicad-footprints/pull/1623#issuecomment-533518508.

Often a corner of the fab lines is beveled to note pin 1. Here are a couple examples:
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

I wonder if this is the best way? Would it be better to not cut a corner of the fab lines which define the outer extents of the part? My thinking is that it may be best if the fab outline exactly represents the part body (with exceptions for simplifying weirdly-shaped part bodies). If we avoid clipping the corner, pin 1 can still be marked.

Here is an example of this in the current lib:
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

And here is an example of the above QFN footprint with a slightly modification:
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

I understand pages 18 and 29-30 of https://ocipcdc.org/archive/What_is_New_in_IPC-7351C_03_11_2015.pdf appear to shown a bevel corner on the fab lines. I'm not suggesting one way or the other is bad or good, just getting feedback to see if missing a corner creates any issues when there are ways to mark pin 1 on the fab layer while keeping the part body's integrity?

poeschlr, 2019-09-21:
I vote for IPC compliance. This consortium has a lot of experts that are paid to think this through. I am sure they have their reasons for suggesting this style (my guess: the minor downside of not seeing where the part is on one corner is outweight by the benefits this style brings.)

Thread 1869 (2019-09-22):

Diode_Bridge_Vishay_MBLS footprint wrong pin number and pad

AndreyFursov, 2019-09-22:
pin 2 and 4 is replased. Pad rotated

poeschlr, 2019-09-22:
What symbol are you using? This footprint is paired with for example MBL104S.

AndreyFursov, 2019-09-22:
I'm find it  then paired with Device:D_Bridge_+AA-. This pin order is equal [Vishay datasheet](https://www.mouser.com/ds/2/427/mbl104s-245342.pdf)

chschlue, 2019-09-22:
The footprint doesn't match Vishay's numbering (+AA-) but matches the MBL104S symbol (+-AA).

AndreyFursov, 2019-09-22:
If footprint named as "Vishay MBLS" it mast had pin order by Vishay datasheet and symbol too. For example, ONsemi bridges have a different number order of pins, but compatible pin position.

cpresser, 2019-11-01:
I agree with @AndreyFursov and made some patches to fix this.

DanSGiesbrecht, 2019-11-02:
While I dislike how Vishay has chosen to disregard the convention of "counterclockwise from pin#1", I agree that deviating from the datasheet adds additional confusion.

This is not a breaking change, as long as the symbol and footprint library PRs are merged at the same time. @poeschlr, if you agree, I'll go ahead and merge the two PRs, and close this issue.

Closed 2020-05-12.

Thread 1896 (2019-10-06):

BatteryHolder_Keystone_3034 does not make contact

5N44P, 2019-10-06:
I've manufactured some board with that footprint, but the contact with the battery fails, probably because of the soldermask thickness.

Should i make a PR with a larger pad, as i made in #1622?

chschlue, 2019-10-06:
With planar surface finishes, maybe even increasing it to match the cell's negative terminal diameter (and mask cut-out exceeding it) might be a good idea?

poeschlr, 2019-10-06:
What does the battery holder manufacturer suggest? After all we build footprints after the manufacturers suggestions not necessarily to fit the constrains of one particular pcb manufacturing process.

chschlue, 2019-10-06:
http://www.keyelco.com/product-pdf.cfm?p=798

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

Looks ridiculously tiny to me.

chschlue, 2019-10-06:
IEC 60086-3 cell dimensions:

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

5N44P, 2019-10-06:
I'm having the problem even with HASL, so it's definitely a big issue here. I think we should not stick with the minimum.

@chschlue i'm not very familiar with the IEC standards. For what i see, a cell with a 20mm that goes under the commercial de nomination of cr2032 has a negative contact diameter much bigger that 8mm. And if i recall correctly, the keystone 3034 is sold for those cells.

I think a pad as big as the inner negative contact would work for sure, with no significant risks of short circuits

chschlue, 2019-10-06:
I also think we should not stick with the minimum.
d4 in IEC 60086 is the minimum negative terminal diameter, the maximum depends on the cell's overall height:
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

All button cells I've ever seen appear to have a diameter close to the maximum and as it is (or should be) impossible to short it on the negative pad unless it is inserted in an angle over 45°, I don't see why the footprints shouldn't go with something in that neighborhood.

I can't publish the whole standard here but the screenshots should catch the essence.

chschlue, 2019-10-06:
On a different note: Shouldn't battery holders have courtyards large enough actually insert the battery, analogous to connectors having enough clearance for mating?

chschlue, 2019-10-06:
> I'm having the problem even with HASL, so it's definitely a big issue here.

Missed that before. So there seems to be no common manufacturing process left that could work reliably with the MF min recommendation.

5N44P, 2019-10-06:
> So there seems to be no common manufacturing process left that could work reliably with the MF min recommendation.

Maybe it's intended for a stencil that leaves paste also on the negative pad. But i didn't made any stencil, and at the moment i can't check if that pad is set for leaving the paste on the Paste layer

chschlue, 2019-10-06:
Keystone 3000 and 3034 as well as Linx HLD-012 have paste on pad 2, but I assume that's an oversight.
Linx recommends a much larger pad, BTW.
https://linxtechnologies.com/wp/wp-content/uploads/bat-hld-012-smt.pdf

5N44P, 2019-10-07:
Also for 20mm cells:
https://www.mouser.it/datasheet/2/238/bat-hld-001-1659379.pdf
This specific part looks like should be compatible with the keystone 3034 footprint, but with a 17.8mm pad

Closed 2019-10-19.

Thread 1904 (2019-10-09):

SOIC-4_4.55x3.7mm_P2.54mm is named wrong (is a soic-6 with missing pins)

poeschlr, 2019-10-09:
Discovered in the process of working on https://github.com/KiCad/kicad-footprints/pull/1821

evanshultz, 2019-10-09:
Ummm... I'm not sure about that.

A SOIC-4 with 2.54mm lead spacing is what we have here. I find this footprint and it's name perfectly valid.

But https://www.mouser.com/datasheet/2/408/TLP185_datasheet_en_20190617-708541.pdf shows a 6-pin part. If so, the footprint should specify 1.27mm lead spacing and exclude two pins.

So my take is that the footprint you mention is totally valid, but should be generated by a different definition. And to make a footprint that properly matches the datasheet for TLP185 we need a tweak to the existing definition.

poeschlr, 2019-10-10:
A SOIC-4 would have pin numbers 1-4 not 1-6

evanshultz, 2019-10-10:
What I am trying to communicate, and apparently not doing a good job of, is saying the pitch is also wrong. If it's six pins with two removed, pitch is 1.27mm. If it's really only four pins, pitch is 2.54mm.

Thread 1920 (2019-10-13):

Connectors_Card:MicroSd_Wurth_693072010801 footprint issue

IMMRMKW, 2019-10-13:
While adding a 3D model to this KICAD footprint, I found out some small layout errors. The distance between pad 4 and the lower right pad 9 should be 6.8, and is 6.9. The footprint works, as I have tested in real life already, but it is not according to the datasheet.

gmsotavio, 2019-10-13:
I'm verifying the reported issue.

gmsotavio, 2019-10-13:
I'm verifying the reported issue.

gmsotavio, 2019-10-13:
Despite the wrong courtyard clearance, I was unable to find any deviation from the datasheet.
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

IMMRMKW, 2019-10-14:
I could be wrong, but when I look in the datasheet, the distance between pin 4 and pin 9 is 6.8mm, and if I open the respective pins in the footprint Connectors_Card:MicroSd_Wurth_693072010801, I see X=-0.025mm and X=6.875mm, so that would add up to 6.9mm, right? Or am I missing something?

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

gmsotavio, 2019-10-14:
Hi, @IMMRMKW I believe you have been taking an incorrect reference. In my understanding, 6.8mm does not take into account the distance between the center of the pad 9 to the center of the pad 4, but the center of the pad 4 to the edge of the card connector.

IMMRMKW, 2019-10-14:
Ah! I am sorry, I think you are correct. I was also using this as a reference for my 3D model so that is probably why it was still misaligned.

gmsotavio, 2019-10-14:
At least it emerged from this discussion that the courtyard clearance is wrong. It can now be fixed. Thanks.

Thread 1955 (2019-11-06):

RJ45 connectors all have different styles

cp-aquila, 2019-11-06:
This came up while looking at: https://github.com/KiCad/kicad-footprints/pull/1954

Most of the connectors do not have a similar graphic style.
- [ ] Pin1 Silk-Marker is quite consistent, most have the triangle. Some however have a 'remove silk-line next to pin1' style. Some have a short duplicate silk-line.
- [ ] Pin1 Fab-Marker: there are two major styles. clipped-rectangle and arrow. I suggest to use arrows everywhere.
- [ ] Courtyard clearance. We have 0.25mm, 0.5mm and 2.5mm!! KLC is pretty clear here, they should all be 0.5mm

Pin-Numbering is also pretty wild:
- [ ] Some have LEDs with prefixed pin-numbers
- [ ] Shield handling is different.

Some do not have a proper description (Just a datasheet link)

gmsotavio, 2019-11-06:
> Pin1 Silk-Marker is quite consistent, most have the triangle. Some, however, have a 'remove silk-line next to pin1' style. Some have a short duplicate silk-line.

I noticed the same thing. But KLC says nothing about SIlk style. I imagine it would be interesting to propose a change in KLC to standardize the style.

> Pin1 Fab-Marker: there are two major styles. clipped-rectangle and arrow. I suggest to use arrows everywhere.

Usually, a bevel should be used when the pin-1 is near the edge of the footprint outline and a chevron when the pin-1is located among other pins or in the middle of the fab outline. But again, KLC says nothing.

> Courtyard clearance. We have 0.25mm, 0.5mm and 2.5mm!! KLC is pretty clear here, they should all be 0.5mm

In this regard, there is no reason to doubt, KLC is pretty clear.
-> 2.5mm. I believe you are talking about `RJ45_Plug_Metz_AJP92A8813`. Moreover, the datasheet link is missing.

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

> Some do not have a proper description (Just a datasheet link)

I noticed hundreds of footprints with a missing description in the current KiCad library, but usually in old footprints.

cp-aquila, 2019-11-06:
Up-To-Date Metz-Connect Datasheet: https://www.metz-connect.com/de/system/files/productfiles/Datenblatt_AJP92A8813.PDF
This connector is not a jack, but a board mounted plug. So having a big courtyard for the required mating connector is a good choice. As stated by rene in #878 its is unfortunate that no explicit counterpart is given, so it is not clear how big the courtyard should be.
We could improve it by adding some text on Cmt.User and/or more Fab lines.

I would like to discuss the styles for RJ?? connectors in this issue and find a consensus.
Then we can implement it, and perhaps write it down somewhere. I don't think we should add specialized info like this into KLC itself. Its already pretty big. Is a KLC appendix, one for each class of parts a good idea? This would also be a solution for some of the other 'unwritten rules'.

- I don't have access to IPC documents (my google-foo is failing), perhaps someone with insight can have a look if there is a recommended style.
- F.Fab I like the chevron for pin1. Reasoning: For most FPs the bevel is to far from the actual Pin1.
- F.Silk pin1: You are right, KLC does not have a distinct style. 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
  - I like the chevron/triangle because its is easily visible. But its large, so just having one additional line seems like a good choice

gmsotavio, 2019-11-06:
> I don't think we should add specialized info like this into KLC itself. Its already pretty big. Is a KLC appendix, one for each class of parts a good idea?

On second thought, you're right. Perhaps include an additional example in the image below suggesting a preferred style for silk in such connectors to avoid mixed styles.
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

cp-aquila, 2019-11-07:
This .pdf was shared in another issue, and it also seems usefull here: https://ocipcdc.org/archive/What_is_New_in_IPC-7351C_03_11_2015.pdf#page=18

Both screenshots do not explicitly apply to THT parts, but bottom-only seems to be close enough.

For Silkscreen:
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

Fab-Layer:
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

@evanshultz Afaik you have access to the whole IPC-Document. Can you shed some light on this?

chschlue, 2019-11-07:
#1953

Thread 1962 (2019-11-12):

DFN-10-1EP_3x3mm_P0.5mm_EP1.65x2.38mm silkscreen has wrong pin 1 indication

mansr, 2019-11-12:
The pin 1 indication on the silkscreen of DFN-10-1EP_3x3mm_P0.5mm_EP1.65x2.38mm is on the wrong side. See screenshot below:
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

Compare to the EP1.55x2.48mm variant:
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

JacobEFO, 2020-03-04:
Hi @mansr,
I have stumbled upon the exact same issue as you: https://github.com/pointhi/kicad-footprint-generator/issues/278

However for non-gullwing packages it is standard to have a missing line at the pin 1 designator, just as the upper footprint you illustrate. However, that would in turn mean, that your second footprint is not shown according to KLC.

However, because of the amount of work, fixing the non-gullwing package footprints is just on-going work and should eventually be fixed.

Disclaimer: Not a librarian, so if you prefer more elaboration. I'm confident the librarians will chime in.

poeschlr, 2020-03-04:
@JacobEFO is correct. The upper footprint is the one that complies with IPC which is what the KLC suggests to use. See screenshot in https://kicad-pcb.org/libraries/klc/F5.1/ (The bottom right one is of a DFN footprint)

mansr, 2020-03-04:
Well, that's not confusing at all. Shouldn't all DFN footprints at least use the same convention? Otherwise it all becomes rather pointless.

JacobEFO, 2020-03-04:
> Well, that's not confusing at all. Shouldn't all DFN footprints at least use the same convention? Otherwise it all becomes rather pointless.

You're absolutely right, they should.
But unfortunately such extensive work takes time, and as you may be able to see, maintaining such large repositories, that we all gladly utilize, takes quite a while.
I reckon, if this is not set for a specific milestone, that any help in this regard will be greatly appreciated.

chschlue, 2020-03-05:
BTW:
Both FPs shown above don't meet the current standard (one has a roundrect EP, the other has rectangular pads.)
The first has to be regenerated, the second added to the generator.

poeschlr, 2020-03-05:
@chschlue we have done this switch to rectangular center pad after the last release so only users who manually download the libs have them.

chschlue, 2020-03-05:
@poeschlr Ah, yes. My mistake.

DFN-10-1EP_3x3mm_P0.5mm_EP1.65x2.38mm is already fixed in master.
However, DFN-10-1EP_3x3mm_P0.5mm_EP1.55x2.48mm is hand drawn (in case anybody wants to add it to the generator size definitions at https://github.com/pointhi/kicad-footprint-generator/blob/master/scripts/Packages/Package_NoLead__DFN_QFN_LGA_SON/size_definitions/dfn.yaml)

poeschlr, 2020-03-05:
Nearly all DFNs are still not in the generator. I suspect it will take at least a man month (160 man-hours) of work to go through all of them (most of the time will be used to find datasheets and check if the symbols that use the current footprints are assigned the correct ones.)

Closed 2020-03-04.

Thread 1994 (2019-12-07):

button switch wrong endpoint (?)

aster94, 2019-12-07:
01:55:34: Processing courtyard of “Button_Switch_THT:SW_TH_Tactile_Omron_B3F-10xx”: Unable to find segment with an endpoint of (125.446 mm, 48.902 mm).

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

chschlue, 2019-12-07:
Fixed in https://github.com/KiCad/kicad-footprints/pull/1856

aster94, 2019-12-07:
Thanks!

Closed 2019-12-07.

Thread 2000 (2019-12-10):

R_2512 new footprint

jneiva08, 2019-12-10:
Hi,

I found another type of footprint for R_2512 ([datasheet](https://www.te.com/commerce/DocumentDelivery/DDEController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)), the issue is the pads are more wide than the standard.
What is the best way to resolve? PR for  footprint hand made or exists footprint script for the resistors?

How can name it? R_2512_6332Metric_TE_CGS

Best regards

evanshultz, 2019-12-12:
While any given vendor may come up with their own footprint, the library is currently using IPC standards to generate footprints from the package dimensions. The vendor footprint isn't considered.

The size definition for 2512 at https://github.com/pointhi/kicad-footprint-generator/blob/master/scripts/SMD_chip_package_rlc-etc/size_definitions/size_default_chip_devices.yaml includes the length and width, including the tolerance, of the datasheet you sent.

So I think you'll be fine using the existing footprints.

While there are reasons to add manufacturer-specific footprints, such as if this was a 4-pin 2512 sense resistor with Kelvin terminals, in this case I'd push back against it.

poeschlr, 2019-12-12:
I agree with evan here. This really is not something that we would include in the official distribution. I intent on transfering the scripts i wrote as a footprint wizard such that users can create their specialized footprints easily against their manufacturing tolerances and the tolerances of the part they have decided to use.

Closed 2019-12-12.

Thread 2013 (2019-12-19):

Best way to add more mounting holes?

cnieves1, 2019-12-19:
Hi,
I wanted to add some more mounting holes to the library, for M1.4 and M1.6mm.

I found there is a script to generate them, at:
https://github.com/pointhi/kicad-footprint-generator/tree/master/scripts/Mounting_Hardware

and also an example yaml file at:
https://github.com/pointhi/kicad-footprint-generator/blob/master/scripts/Mounting_Holes/mounting_hole_long.yaml

However, this is not the yaml file used to generate all the mounting holes in official Kicad library.

Could you tell me where is this yaml file or the script used to generate the official mounting holes?

Thanks,

myfreescalewebpage, 2019-12-19:
I'm also interested in this subject because I need more mounting holes too. probably we can generate mounting holes every 0.1mm from 1 to 10mm right now.

@poeschlr and @evanshultz can you help on the question of @cnieves1 ? How the mounting holes existing in the library have been generated ? Need to fix existing one with the generator ?

Thanks!

poeschlr, 2020-01-31:
I think that script was not used to generate any of the current mounting hole footprints. I do not know if it can generate footprints of the current style used for the included mounting holes. If it does then i see no reason why it should not be used to add future mounting holes and possibly even to replace the current footprints to ease maintainability.

If you add something to it then please base it on my cleanup branch as i moved the yaml file into the same directory as the script https://github.com/pointhi/kicad-footprint-generator/pull/487

myfreescalewebpage, 2020-09-03:
@cnieves1 have you work on some scripting method for the Mounting Holes ? I clearly need more footprints, particularly with some paste options (soldering of spacers like https://www.we-online.de/katalog/datasheet/9774060243R.pdf) so I'm thinking to doing this quickly

chschlue, 2020-09-04:
@myfreescalewebpage I believe what you're looking for is in `Mounting_Wuerth`

cnieves1, 2020-09-04:
@myfreescalewebpage I'm sorry but I have no update about this...

myfreescalewebpage, 2020-09-04:
@chschlue thanks to point this, really happy to found them!

Thread 2076 (2020-01-31):

wrong pin distance in Choke_Schaffner_RN202-04-8.8x18.2mm

HB9GKW, 2020-01-31:
According to datasheet of common mode choke Schaffner RN202 the distance of pin 1/2 to 3/4 should be 15.2 mm while current library footprint has a pin distance of 10 mm.

evanshultz, 2020-01-31:
Confirmed. The fab outline dimensions are correct and the pin X spacing is correct, but pin Y spacing is wrong as detailed above.

@HB9GKW
Sorry for this error and thanks for reporting it. Would you submit a PR to fix this footprint?

gkeeth, 2020-03-05:
Is this now fixed by #2079 ?

evanshultz, 2020-03-05:
Ah yes. I believe it is. Thanks for posting!

Closed 2020-03-05.

Thread 2082 (2020-02-07):

MSOP-8_3x3mm_P0.65mm has too narrow clearance

essele, 2020-02-07:
This MSOP-8 footprint seems to have a pin to pin clearance of approximately 5.8mil, which will cause it to fail DRC checks with a 6mil clearance set.

All of the other MSOP-8's (the EP variants) all have a clearance approaching 10mil which seems a lot more sensible.

(Pins are 0.5mm on this one, and 0.4mm on the EP variants -- most of the datasheets I've looked at suggest between 0.35 and 0.45 ... so 0.4 seems like a good choice.)

andrewteasdale, 2020-02-11:
I've just found the same thing on exactly this footprint and settled on 0.45mm pad width, which matches some of the 0.65mm pitch TSSOP parts. But generally there is not a lot of consistency across these footprints, with some having rounded corners per latest IPC and other not etc. I'd take on the challenge of harmonising this but some of the variation may be for a reason and settling on a defined standard for this will require a library manager to confirm an approved schema I suspect.

evanshultz, 2020-02-11:
We are going with nominal-density IPC land patterns, but not all gullwing packages have been moved to the generator, as mentioned above. Contributions are welcome if you'd like to help with that effort.

andrewteasdale, 2020-02-11:
Thanks @evanshultz, I've put adding some of the missing footprints to the generator onto my task list.

chschlue, 2020-02-11:
FYI:
This particular FP has recently been added to the generator but is generated without `force_small_pitch_ipc_definition` set, contrary to most other 0.65mm pitch MSOPs.
That's why it has 100µm wider leads.

andrewteasdale, 2020-02-12:
Thanks @chschlue - and apologies in advance for the long response!

To make this more complicated, my understanding is that `force_small_pitch_ipc_definition` should only be set for footprints <=0.625 mm, at which point the IPC-7351 side goal goes from 0.03 to -0.02 mm. If that assumption is true then a number of the existing 0.65 mm pitch script-generated parts are incorrect.

I suspect the thing that concerns people is that a 0.5 mm pad width with only 0.15 mm clearance feels and looks a bit tight. I stuck the JEDEC part spec into an IPC calculator and came up with a 0.48 mm pad width, which is indeed 0.5 mm when rounded to 0.05 mm, which is what IPC-7351B seems to recommend. Adjusting the placement tolerance brings the pad width down to the more reasonable 0.45 mm, but that's a bit of a fudge, and in reality more like 0.42 mm makes sense [but does not fit with the 0.05 mm rounding].

Incidentally, the pads generated using the default heel/toe for a nominal environment lead to a much larger footprint than the previous library version. This is on balance a good thing as the existing footprint wasn't ideal. However, there are flaws in the IPC-7351B approach [namely a one-size-fits-all pad size] which I understand is being resolved in IPC-7351C, with differing heel/toe dimensions for different lead pitchs as follows [source https://ocipcdc.org/archive/What_is_New_in_IPC-7351C_03_11_2015.pdf]:

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

A good source here is the PCB Library Expert approach, which is a hybrid of what's coming in IPC-7351C and common-sense extrapolations from the IPC-J-STD-001 solder joint goal acceptability guidelines. This makes use of differing heel/toe/side values for various pitch parts on a sliding scale, rather than the big/small approach used in the current IPC-7351B approach [and thus the generator scripts]:

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

Following some experimentation, in the absence of an agreed approach these are the values I'd probably implement in my own libraries as the footprints look both highly solder-able and sufficiently dense for a realistic nominal environment.

I'd be happy to get stuck in and update some of the remaining non-script-generated to 'new' IPC-style footprints as they need improving and standardising, but I suspect not everyone [myself included!] would be happy with the default 0.5 mm pad size, and hacking the scripts to generate 0.42 mm or 0.45 mm pad widths feels wrong.

Of course by far the simplest workable approach is for everyone to agree that [as an exception to the IPC spec] we move the 'small pitch' boundary from 0.625 mm to 0.65 mm and use `force_small_pitch_ipc_definition` for all 0.65 mm pitch parts. This would generate a perfectly reasonable [if narrower than IPC norms] 0.4 mm pad width and match the balance of 0.65 mm pitch parts already in the library. @evanshultz would you be happy with that [in which case I will get started]?

andrewteasdale, 2020-02-12:
UPDATE: I've just seen the excellent work @essele has done in #2090 with all the TSSOP variants based on the JEDEC standard, which is exactly what I was hoping to implement for some of the other SOP families [unless this work is already planned by someone else?].

This PR has worked out perfectly for 0.65 mm pitch variants because the lead width on TSSOP parts is narrower than for e.g. MSOP parts, and thus `force_small_pitch_ipc_definition` is not required to product an acceptable pad width. Fantastic job!

chschlue, 2020-02-14:
IMO, fine pitch goals are fine for MO-187 AA MSOPs,
Should this be set manually or should the script be changed to use these for all <=0.65mm pitch FPs?
MS-026 0.65mm TQFPs have equally wide leads, for example.

To answer your other question: AFAIK, #2090 is the only SOP rework at this time.

evanshultz, 2020-02-14:
A few things pop to mind...
- We currently have an IPC 7351B generator (with round rect pad shape from early 7351C info) but that standard is supported by external files so adding other standards should be possible without too much effort.
- 7351B is now a decade old and 7351C seems to be stuck in purgatory so it probably is worthwhile to consider if some tweaks are reasonable for this library to keep up-to-date with equipment capabilities and user desires of 2020.
- However, I believe it will be overwhelming for no real benefit if many more variants are offered which are all very similar. So I would prefer to limit things to just IPC 7351 footprints, with the full three density levels where helpful to users. Making small tweaks like the above is no problem for me as long as we don't add footprints which aren't useful for users or near-duplicates that add clutter.
The `force_small_pitch_ipc_definition` property isn't needed because the finer-pitch IPC rules are used if the lead pitch is <=0.625mm.
- Moving the break on gullwing parts from 0.625mm pitch up to 0.65mm pitch seems fine with me, but I'd rather do it using the property on the package entry so that we're conforming to the IPC rules as they are now and we also have a place to capture this intentional deviation.

My brain may not be working. What do y'all think?

poeschlr, 2020-02-15:
The `force_small_pitch_ipc_definition` is kind of a hack that allows to overwrite the automatic definition for pitches that are very close to the cut-off point. I simply noticed that 0.65mm footprints often result in way too little clearance and would be better off with the smaller definition.

Closed 2020-02-22.

Thread 2086 (2020-02-09):

Add new nucleo-144 footprint with arduino headers

fdila, 2020-02-09:
The current footprint only has holes for morpho connector.
To design a shield stackable over arduino shield the arduino connectors should be present.
Like this footprint: https://www.snapeda.com/parts/NUCLEO-F746ZG/STMicroelectronics/view-part/?ref=search&t=nucleo

chschlue, 2020-02-09:
Unfortunately, we're an understaffed team of volunteers and cannot take requests.
But it looks like you found what you're looking for at https://github.com/KiCad/kicad-footprints/pull/2045#issuecomment-583874715.
You're welcome to comment if you find mistakes in that PR.

Closing.

Closed 2020-02-09.

Thread 2096 (2020-02-19):

NMJ6HCD2 Listed as jack_3.5mm but is a 1/4 inch connector not 3.5mm

jimruxton, 2020-02-19:
It looks like the NMJ6HCD2 connector in [this library](https://github.com/KiCad/kicad-footprints/tree/master/Connector_Audio.pretty) is labeled as a 3.5 mm connector when it's actually a 1/4 inch connector.

evanshultz, 2020-02-24:
This issue will be fixed once https://github.com/KiCad/kicad-footprints/pull/1145 is merged.

Closed 2020-02-24.

Thread 2146 (2020-03-16):

ZH line missing from Connectors_JST library

Teslafly, 2020-03-16:
you have dome a great job with most of the connector libraries, but I find that a major omission is the ZH line (1.5mm through hole). Which is the through hole version of the ZE line.
I would make and commit these myself, but from what I've read so far, the generators and committing to this library has a relatively high learning curve.

evanshultz, 2020-03-17:
Thank you. I hope you are finding the libraries good otherwise.

If one knows Python, the scripts are simple. If one doesn't, it's a great exercise to learn. Should ZH be just like ZE except for the pins, it's likely a relatively simple change to the existing script.

We don't take requests since that would really overwhelm the librarians and contributors, so I'm going to close this. It will stay around if someone else finds it later and wants to develop the script. Or if you want to give it a try, the existing ZE scripts are at https://github.com/pointhi/kicad-footprint-generator/tree/master/scripts/Connector/Connector_JST.

Teslafly, 2020-03-23:
took a shot at modifying the generator now that i actually found it. based on the ph generator.
https://github.com/Teslafly/kicad-footprint-generator/blob/master/scripts/Connector/Connector_JST/conn_jst_zh_tht_top.py
the silkscreen is currently not fixed, but pins are ok.

How do you use kicad-footprint-generator to generate the whole kicad-footprints library?

also, where is the generator for the JST_ZE_SM14B-ZESS- series connectors? all I can find are the through hole variants?

Closed 2020-03-17.

Thread 2149 (2020-03-16):

Battery contacts - which library?

mibe, 2020-03-16:
Hey guys,

I have two new footprints ready, they are the 9 volt battery contacts Keystone [269](https://www.keyelco.com/product.cfm/product_id/1077) & [261](https://www.keyelco.com/product.cfm/product_id/1073). My question now is, which is the most fitting library for them?

Of course the ```Battery``` library with the ```BatteryHolder``` footprints first comes to mind. But on a second thought, these parts are _contacts_, not _holders_. They have (beside the actual contact) no mechanical support for holding a battery. You'd also need both to connect a battery to and you'd as a designer also need to get the distance of both parts on your PCB right.
My next idea was to maybe put them in the generic ```Connector``` library? They are mating contacts after all, so a designer could use them for whatever they like, as a fancy board-to-board interconnect for example.

What's you opinion on this?

evanshultz, 2020-03-17:
They're specifically for batteries, so put them in the `Battery` repo. Instead of `BatteryHolder_` as a prefix, which I still think might be reasonable, you could use `Contact_` or some other term you think might fit better.

mibe, 2020-03-21:
Alright, the ```Battery``` library it is. I'd prefer the prefix named ```BatteryContact_``` actually.

cp-aquila, 2020-04-09:
I assume the contacts always get used in pairs? I see some benefit in having them as seperate symbols+footprints as it makes the BOM creation easier.

**Question:** How does the designer know how much distance needs to be between the contacts?
**Related:** How does the designer know how big the battery will actually be? There is no keepout or courtyard associated with those contacts.

The first solution that comes to mind is to add some kind of marker in F.Fab for the 2nd contact into each footprint (maker example here https://github.com/KiCad/kicad-footprints/pull/1394). Perhaps also add the outline of the battery into each footprint. On the board they should perfectly overlap.
That leaves the courtyard. No clue on how to fix that :/

mibe, 2020-04-12:
> **Question:** How does the designer know how much distance needs to be between the contacts?

The designer would have to look up the distance in the specification / battery datasheet. It is half an inch. Maybe it'd good to have the distance in the footprint description?

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

Indeed that's a problem. How about having an X drawn on Fab or Cmts in both footprints, which have to overlap to match the correct distance?
The courtyard could be made half the battery, so that the lines of both footprints have to overlap to match, like in the screenshot below. But how does the DRC react to having a CrtYrt line on another?
On the other hand there's so much space between the contacts and in the Z direction to the battery itself, you could easily fit standard 1206 components between the contacts. My quick measurements yielded at least 3 mm clearance in Z. So, I dunno, is a clearance including the battery itself needed? Depends on the design of the PCB I guess...

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

Thread 2153 (2020-03-17):

Thermal via drills are needlessly small

karlp, 2020-03-17:
Thermal vias on "many" packages (especially in the qfn family) are 0.2mm drills.  This is not based on any manufacturer guideline, but appears to have been introduced, and then copied continually since:
https://github.com/pointhi/kicad-footprint-generator/commit/d0b9262db25480ec584b59e46744003d856ee49e  which came in via https://github.com/pointhi/kicad-footprint-generator/pull/125

These 0.2mm drills cause boards to require higher specs than is commonly available, where 0.3mm is the smallest standard drill.

Given that there's no actual _reason_ for 0.2, I suggest that _all_ the generic parts are rewritten to 0.3mm.  If a specific manufacturer part recommends 0.2mm, it can be kept and named appropriatly per KLC https://kicad-pcb.org/libraries/klc/F2.3/

Generic parts in question are (at least)  "QFN-*_EP*_ThermalVias" along with TDFN and TQFN and UQFN and VQFN and WQFN.

This also applies to TQFP, EQFP,

In the DFN family, some seem to have 0.3, some have 0.2, and it's not as clearly scripted as in the others. SON is similar, mixed, and not as clearly scripted and copied without thought.

JacobEFO, 2020-04-16:
Seems like there's a total of 204 '_ThermalVias' files with 0.2mm drills. It might be of interest to see, if there are others with drills generally below 0.3mm.

I wonder what might be the best way to change this. One could imagine a scenario, just headlessly changing the drill size could cause violations of clearance.

evanshultz, 2020-09-18:
The generator should place the vias relative to the thermal pad size, if possible, so changing the drill size should only slightly shift the via positions. Probably not a big deal.

IMO this could be done at any time, with a re-generation of the footprints in a PR and notification of any outstanding footprints generated by script. Perhaps when moving to GitLab there is a good opportunity to do this in a clean fashion?

chschlue, 2020-09-18:
How about teaching the generator to select drill size according to EP size and removing that parameter from size definitions by default (like it's supposed to be with paste coverage but sadly isn't)?

evanshultz, 2020-09-19:
That could be done. Is there some relationship you are thinking about for drill size and EP size?

If the min drill size is in KLC then it could be in the global KLC config file and I can use that value unless the size definition has another value (which we might want for manufacturer-specific footprints). So then the drill is removed from most of the YAML files and where it stays it will function as an overwrite.

I'm not sure what you mean by paste coverage. Can you elaborate? Paste coverage is defined as a constant on line 25 of the generator and overwritten by the YAML info on line 272, if present. I just did a quick test and commenting out the line in a YAML file generates the same footprint as specifying a 65% paste coverage in the footprint definition. Maybe I'm missing what you're talking about?

chschlue, 2020-09-19:
> That could be done. Is there some relationship you are thinking about for drill size and EP size?

I don't have any specific values right now, just that we probably shouldn't have 300µm holes in 350µm wide EPs.
OTOH, tiny EPs with thermal vias probably only make sense with filled vias-in-pad, which in turn requires support for actual vias instead of PTHs in FP files to enable proper CAM job generation.

Perhaps this is a stupid idea. At least requires further consideration.

> I'm not sure what you mean by paste coverage. Can you elaborate? Paste coverage is defined as a constant on line 25 of the generator and overwritten by the YAML info on line 272, if present. I just did a quick test and commenting out the line in a YAML file generates the same footprint as specifying a 65% paste coverage in the footprint definition. Maybe I'm missing what you're talking about?

Many definitions include explicit 65% paste coverage because that parameter got copied and, well, _pasted_ again and again although they should probably just use whatever our current default is.
What I'm saying is that neither `EP_paste_coverage` nor `drill_size` should be specified unless absolutely necessary.

Tangent: Does the generator currently have a command line parameter to specifiy paste coverage? If not, adding one would enable users to easy adjust coverage according to their particular needs (unusually thick or thin stencils, for example)

evanshultz, 2020-09-19:
I see. Yeah, I don't quite think KiCad supports that situation well. One standard size of thermal via drill in all EPs seems suitable for now, to me.

Gotcha. So just clean up the YAML files by removing that extraneous parameter. Makes sense. Paste coverage and drill size could be cleaned up at the same time. I can do that.

There isn't a parameter for paste coverage. It looks like things which are relatively static but not in KLC were placed as constants in the script. Things that are in KLC are either in a global YAML file for all scripts to share, or a local YAML file just for that script.

Thread 2192 (2020-04-02):

ST Morpho Connector mounting hole location error

jhalmen, 2020-04-02:
the locations of the mounting holes of the footprint
https://github.com/kicad/kicad-footprints/Module.pretty/ST_Morpho_Connector_144_STLink_MountingHoles.kicad_mod
are wrong.
as also reported in #2045 we used those locations to 3d print a mount, and the holes don't line up.
the [official mechanical drawing](https://www.st.com/content/ccc/resource/technical/document/user_manual/group0/26/49/90/2e/33/0d/4a/da/DM00244518/files/DM00244518.pdf/jcr:content/translations/en.DM0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) page 14 lacks a lot of information about the actual hole locations. does anybody have more info on these?

der-ule, 2020-07-20:
The manufacturing files for the Nucleo-144 boards are available here:

https://www.st.com/resource/en/board_manufacturing_specification/mb1312_manufacturing.zip

you should be able to extract the necessary information from them.

jhalmen, 2020-07-21:
awesome, thanks!

weirdly enough i have to say that the mounting holes of the footprint line up perfectly with the provided gerber files...
it must have been an error on my part then, even if i can't see what might have gone wrong back then with the print.

since the files agree with the footprint i'll close this. sorry for the noise

Closed 2020-07-21.

Thread 2277 (2020-05-11):

_ThermalVias packages don't connect the EP to a zone that has thermal-relief pad connections

BryanKadzban, 2020-05-11:
So the EP pad's thermal-relief style is "from parent footprint", and the footprint's style is "use zone setting".  When the zone is set to thermal-relief, the EP pad *should* have four connections out to the zone ... but the thermal vias are too close to where those connections would be, and the vias' own style disables them.

In particular, the three packages I see this on are all in Package_DFN_QFN:

QFN-56-1EP_7x7mm_P0.4mm_EP5.6x5.6mm_ThermalVias
QFN-48-1EP_7x7mm_P0.5mm_EP5.45x5.45mm_ThermalVias
Micrel_MLF-8-1EP_2x2mm_P0.5mm_EP0.8x1.3mm_ThermalVias

If I change the connection style of the four thermal vias near the middle of the edges of the EP pad (...or both vias for the MLF package) and change them all to "solid" connection style, then the zone connects to the pad and all vias, the way I would have expected.

Is there some way to make this work other than overriding the style on these four vias?  If not, should those four be set to "solid" in the footprint by default, instead of "from parent footprint"?

chschlue, 2020-05-11:
Zones really do interact strangely with thermal vias, but I think the underlying problem is that thermal vias are actually through-hole pads, not vias.

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

The upper zone in the screenshot above is set to solid while the lower one is set to "reliefs for PTH only".
Kicad connects those "vias" with reliefs, which isn't usually what you want (it defeats the purpose of the thermal vias, after all.

In case you _really_ want reliefs, actual vias instead of pads would solve that issue, too.

@KiCad/librarians can anybody confirm I'm not talking complete nonsense?

BryanKadzban, 2020-05-11:
They definitely are through-hole pads, yes.  (There's no other way to put a via into a footprint that I've seen.)  I suspect that having the reliefs present would be better from a soldering point of view, but that's pure speculation; this is the first time I've tried to make a board that needs the thermal dissipation so I don't know firsthand.  (I've done exposed pads before, but not with vias.)  In general, thermal reliefs don't affect current transmission, but they do help when trying to solder to the exposed copper.

OTOH, the setting doesn't matter for any of the through-hole pads -- except the ones on the outside -- because the single large EP surface-mount pad is always solid.  (On both top and bottom.)  It doesn't act like a zone at all.  So soldering will be harder regardless; this *probably* means that heat dissipation will be better.  (Assuming the ground plane gets connected.  :) )

I have no opinions about 3- or 4-layer boards, or the connection between the _ThermalVia pads and the internal layers; I've never used the third or fourth copper layer.

I can't exactly tell what's going on with the screenshot though; there seem to be at least four layers there, and I'm not familiar with the coloring.  :-/  Maybe these two screenshots make it more obvious what I mean.  Both are screenshots of a separated Edge.Cuts rectangle with a copy of a couple footprints and a zone on the B.Cu layer on the GND net.  All of the pad-49 pads of the QFN package are manually tied to GND, as well as pad 2 of the C54 footprint.  Pad 1 of C54 and pad 31 of the QFN package are tied to a +28V_A net that I'm using on the rest of the board.

On the first screenshot (from-parent-footprint.png), the style of all the through-hole pads is set to "from parent footprint".  You can see an airwire between C54 pad 2 and the QFN package's pad 49.

On the second screenshot (solid.png), I've changed the setting for the rightmost middle through-hole pad (which is selected) to be "solid".  You can see the thermal-relief connection to the big pad 49 on the B.Cu layer, and the airwire is gone.

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

Is that what you meant?

BryanKadzban, 2020-05-12:
*Ding*.  Oh.  Now I realize what the screenshot was getting at -- the bottom layer was **reliefs for PTH only**, not "thermal reliefs" (i.e. for all connections) which is what I assumed when trying to interpret it.  So that pad does have a full connection to the B.Cu zone, except where the through-hole pads cut it down to thermal-relief.

That's actually inverted from what I'm looking for: I'm looking for the through-hole pads to connect all the way around, while the large rectangular surface pad has thermal reliefs ... on the F.Cu layer.

But as I was writing that last sentence, I *also* just realized that the B.Cu layer really has no reason for reliefs, since nothing will be soldering to that side of the PCB at all.  So another way to solve this might be to set the big square pad (on the back layer) to "solid", instead of doing that to the mid-side PTH pads.

chschlue, 2020-05-12:
I think we're on the same page, but I'll still try to clarify:

1. Use case: Solid connection to thermal pad for maximum heat dissipation
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
(vias in pad, zone set to "solid")

2. Use case: Relief connection for better (hand) solderability
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
(vias in pad, zone set to either "relief" or "PTH-only relief")

I'm arguing that the _proper_ solution is to allow actual vias in addition to PTHs in footprints.

I haven't been able to find a wishlist item regarding such an FP format extension on https://gitlab.com/kicad/code/kicad/-/issues, which makes me wonder if my proposal is (for a reason I failed to take into account) so stupid that nobody else dared to bring it up yet.

evanshultz, 2020-05-12:
It is there. See item 3 at https://gitlab.com/kicad/code/kicad/-/issues/4067.

chschlue, 2020-05-12:
Sry, yes, I found that one. But it doesn't seem to explain why a thermal via has to be a pad instead of, well, a via.
There must be a compelling reason, but I still can't figure it out.

chschlue, 2020-05-12:
Oops, sry again. Item 3... must have missed it somehow.

BryanKadzban, 2020-05-13:
That sounds like a great way to improve the situation with more work on the footprint format and editor code, yes.

Is there a way to modify the footprints to work better in the meantime?  I assume the big rectangular pad on the bottom is supposed to be able to connect to zones in some way or another.  :)

...On the other hand, both a footprint library change and a code change will require a release before people can use them, so yeah, maybe either way works.

chschlue, 2020-05-13:
I just noticed that for pads set to "from parent FP", FP to "from zone" and zone to "solid" or "thermal reliefs" seems to be working the way it should in 5.99, just for zone set to "PTH-only reliefs" I get a cute pattern of spokes to the thermal vias.

Regarding your question:
It would be (relatively) easy to switch the script generated footprints to solid, but we also have a significant amount of hand-made FPs with thermal vias, I think.
Plus, it's yet to be determined if doing so has unintended side effects and if the payoff is big enough to justify the hassle (if @evanshultz's wish is fulfilled, it would have to be done all over again for v6)

BryanKadzban, 2020-05-15:
5.99 works better?  I'm still on 5.1.5, but I'm OK waiting for 6.x if that's what it'll take.  And I do agree that it would be multiple levels of hassle if future releases also get the ability to put real vias into a footprint, or get more flexibility around the zone-to-pad connection options.

So let's call this bug unnecessary.  :)  Thanks!

Closed 2020-05-15.

Thread 2311 (2020-06-06):

KBPC package

aris-kimi, 2020-06-06:
Hi everyone,

About existing "Diode_Bridge_28.6x28.6x7.3mm_P18.0mm_P11.6mm" package.
It is named with width, length, height and pitch, but according to it's datasheet: https://diotec.com/tl_files/diotec/files/pdf/datasheets/kbpc1500fw.pdf
i think it should be renamed.

My confusion is,
i am about to PR all KBPC symbols from this link:
https://www.diodemodule.com/bridge-rectifier/kbpc/
as two symbols with -T and -W with alliases,
but this datasheet:
https://www.diodemodule.com/bridge-rectifier/kbpc/kbpc50005t.pdf
suggests that footprint name should be KBPC_T and KBPC_W, how should i proceed?

I think that the first footprint "Diode_Bridge_28.6x28.6x7.3mm_P18.0mm_P11.6mm"

should be be renamed to something like "Diode_Bridge_KBPC_W_Unmount"
or "*_No_Mountpoint"
with description "Single phase, bridge rectifier, case KBPC_W(WP)"

And my additions should be named like "Diode_Bridge_KBPC_W_Mount"
or "*_Mountpoint"
with description "Single phase, bridge rectifier, case KBPC_W(WP)"

and "Diode_Bridge_KBPC_T_Mount"
or "*_Mountpoint"
with description "Single phase, bridge rectifier, case KBPC_T(FP)"

I think dimensions should be omitted.

Also, i couldn't find any symbol that uses the existing footprint "Diode_Bridge_28.6x28.6x7.3mm_P18.0mm_P11.6mm"..

Plus, with the same logic i can also add "Diode_Bridge_KBPC_T_Unmount"...

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

aris-kimi, 2020-06-27:
Hi all, i will upload 4 footprints:
 Diode_Bridge_GeneSiC_Semiconductor_KBPC_T_Mountpoint
 Diode_Bridge_GeneSiC_Semiconductor_KBPC_W_Mountpoint
 Diode_Bridge_GeneSiC_Semiconductor_KBPC_T_NO_Mountpoint
 Diode_Bridge_GeneSiC_Semiconductor_KBPC_W_NO_Mountpoint
one by one in different PRs. Ithink this will close this issue when all merged..

aris-kimi, 2020-09-29:
Removed manufacturer name from ft, closing this issue now, also two PRs from above..

Closed 2020-09-29.

Thread 2320 (2020-06-17):

QFN footprint names aren't specific enough

evanshultz, 2020-06-17:
I've mentioned this before, but I don't think I've ever created an issue and I just ran into it again...

Sometimes our QFN footprint names aren't specific enough. I'm talking specifically about scripted footprints. There are inputs to the script, which aren't captured in the footprint name, that can differ between footprints which would end up with the same footprint name. This means that we have powerful scripts to take in the full set of package dimensions and generate unique footprints, but the footprints names aren't unique.

It's sorta like a collision with a hash function. Sorta. We can have multiple, unique inputs that all result in the same output.

Let's look at a specific example. `QFN-48-1EP_7x7mm_P0.5mm_EP5.6x5.6mm` in our library was derived from the package drawing at https://www.st.com/resource/en/datasheet/stm32f042k6.pdf#page=94. Generating a footprint for the package at https://www.analog.com/media/en/technical-documentation/data-sheets/AD9542.pdf would result in the same footprint name. However, dimensions 'b' and 'L' are different for those packages. So while the footprint may have to shared between those parts in our library, it will only be ideal for one.

Does this matter? Perhaps not. They're awfully close and likely to work. But if we're claiming IPC 7351-compliant footprints thanks to our script, the footprints used for symbols in the library may not always have the fillets that one would expect when looking at the package drawing.

It's worth pointing out that the IPC 7351 naming convention doesn't capture lead length and width for QFNs (see http://ohm.bu.edu/~pbohn/__Engineering_Reference/pcb_layout/pcbmatrix/IPC-7x51%20&%20PCBM%20Land%20Pattern%20Naming%20Convention.pdf) so it's either an oversight or perhaps they decided it didn't matter enough and left it off as the name is already long enough. So while the fillets may not match IPC 7351, it seems the naming is still compliant. Or perhaps I just didn't catch where this is captured in the doc.

There may be other footprint types that suffer the same issue.

poeschlr, 2020-07-05:
Good point. Maybe something to include for version 6. Even if it pains me to do another massive rename. However as i generally would like to get away from manufacturer specific namings for QFN and other standardized packages this might actually be a good time to do it.

evanshultz, 2020-07-06:
Also see https://www.pcblibraries.com/forum/ipc7351b-land-pattern-naming-convention-flaws_topic2336.html. It covers this, to some extent, and other issues with IPC footprint naming.

Thread 2336 (2020-06-26):

All the footprint files in modules have the wrong name on Ubuntu ppa:js-reynaud/kicad-5.1

Dantali0n, 2020-06-26:
When installing kicad on Ubuntu 18.04 through the ppa:js-reynaud/kicad-5.1 ppa all the footprints files in `/usr/share/kicad/modules` won't match with the names listed in the footprint library browser. This results in no footprints being available.

Typical error messages are:
`
The current configuration does not include a library with the nickname "Package_TO_SOT_THT".
Use the footprint libraries configuration.
`

Reinstalling the packages even with `apt remove --purge` or `apt install --reinstall` does not solve the issue.

An example of the names listed in library browser:
```
TO_SOT_Packages_SMD
TO_SOT_Packages_THT
```

The list of .pretty files in modules:
```
Battery.pretty
Button_Switch_Keyboard.pretty
Button_Switch_SMD.pretty
Button_Switch_THT.pretty
Buzzer_Beeper.pretty
Calibration_Scale.pretty
Capacitor_SMD.pretty
Capacitor_Tantalum_SMD.pretty
Capacitor_THT.pretty
Connector_AMASS.pretty
Connector_Amphenol.pretty
Connector_Audio.pretty
Connector_BarrelJack.pretty
Connector_Card.pretty
Connector_Coaxial.pretty
Connector_DIN.pretty
Connector_Dsub.pretty
Connector_FFC-FPC.pretty
Connector_Harwin.pretty
Connector_HDMI.pretty
Connector_Hirose.pretty
Connector_IDC.pretty
Connector_JAE.pretty
Connector_JST.pretty
Connector_Molex.pretty
Connector_Multicomp.pretty
Connector_PCBEdge.pretty
Connector_Phoenix_GMSTB.pretty
Connector_Phoenix_MC_HighVoltage.pretty
Connector_Phoenix_MC.pretty
Connector_Phoenix_MSTB.pretty
Connector_PinHeader_1.00mm.pretty
Connector_PinHeader_1.27mm.pretty
Connector_PinHeader_2.00mm.pretty
Connector_PinHeader_2.54mm.pretty
Connector_Pin.pretty
Connector_PinSocket_1.00mm.pretty
Connector_PinSocket_1.27mm.pretty
Connector_PinSocket_2.00mm.pretty
Connector_PinSocket_2.54mm.pretty
Connector.pretty
Connector_RJ.pretty
Connector_Samtec_HLE_SMD.pretty
Connector_Samtec_HLE_THT.pretty
Connector_Samtec.pretty
Connector_SATA_SAS.pretty
Connector_Stocko.pretty
Connector_TE-Connectivity.pretty
Connector_USB.pretty
Connector_Wago.pretty
Connector_Wire.pretty
Connector_Wuerth.pretty
Converter_ACDC.pretty
Converter_DCDC.pretty
Crystal.pretty
Diode_SMD.pretty
Diode_THT.pretty
Display_7Segment.pretty
Display.pretty
Ferrite_THT.pretty
Fiducial.pretty
Filter.pretty
Fuse.pretty
Heatsink.pretty
Inductor_SMD.pretty
Inductor_THT.pretty
Jumper.pretty
LED_SMD.pretty
LED_THT.pretty
Module.pretty
MountingEquipment.pretty
MountingHole.pretty
Mounting_Wuerth.pretty
NetTie.pretty
OptoDevice.pretty
Oscillator.pretty
Package_BGA.pretty
Package_CSP.pretty
Package_DFN_QFN.pretty
Package_DIP.pretty
Package_DirectFET.pretty
Package_LCC.pretty
Package_LGA.pretty
Package_QFP.pretty
packages3d
Package_SIP.pretty
Package_SO_J-Lead.pretty
Package_SON.pretty
Package_SO.pretty
Package_TO_SOT_SMD.pretty
Package_TO_SOT_THT.pretty
Potentiometer_SMD.pretty
Potentiometer_THT.pretty
Relay_SMD.pretty
Relay_THT.pretty
Resistor_SMD.pretty
Resistor_THT.pretty
RF_Antenna.pretty
RF_Converter.pretty
RF_GPS.pretty
RF_GSM.pretty
RF_Mini-Circuits.pretty
RF_Module.pretty
RF.pretty
RF_Shielding.pretty
RF_WiFi.pretty
Rotary_Encoder.pretty
Sensor_Audio.pretty
Sensor_Current.pretty
Sensor_Distance.pretty
Sensor_Humidity.pretty
Sensor_Motion.pretty
Sensor_Pressure.pretty
Sensor.pretty
Sensor_Voltage.pretty
Socket.pretty
Symbol.pretty
TerminalBlock_4Ucon.pretty
TerminalBlock_Altech.pretty
TerminalBlock_Dinkle.pretty
TerminalBlock_MetzConnect.pretty
TerminalBlock_Philmore.pretty
TerminalBlock_Phoenix.pretty
TerminalBlock.pretty
TerminalBlock_RND.pretty
TerminalBlock_TE-Connectivity.pretty
TerminalBlock_WAGO.pretty
TestPoint.pretty
Transformer_SMD.pretty
Transformer_THT.pretty
Valve.pretty
Varistor.pretty
```

Dantali0n, 2020-06-26:
I deleted my user config and restarted kicad, everything is happy now.

Closed 2020-06-26.

Thread 2373 (2020-07-24):

Footprint for SMD 5730 YUJI LEDS seems inverted

zackles, 2020-07-24:
Hello,
I just use the footprint LED_SMD:LED_YUJI_5730 and it seems it is inverted for his association with its symbol.

Datasheet is here :
https://cdn.shopify.com/s/files/1/0344/6401/files/YJWJ005-1.1_YJ-VTC-5730-G01.pdf?7088009637272241372

Could someone verify with me if it is indeed an error?

zackles, 2020-07-24:
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
Here is a picture making the comparaison between kicad output and datasheet

aris-kimi, 2020-07-24:
Hi @zackles , from the top view from datasheet image, polarity seems ok to me.

zackles, 2020-07-24:
Hi @aris-kimi, Thank you for your quick review. I agree with your interpretation. Will you update the footprint?

aris-kimi, 2020-07-24:
I will create a PR later if you do not want to give it a try. :-) But later tonight, so if you change your mind in the meantime, feel free to propose a fix.

zackles, 2020-07-24:
I may try to edit the footprint (not so hard I think) but I need to refresh my github skill ;p I'm looking at that right now.

zackles, 2020-07-24:
I don't understand why this previous PR did'nt corrected the problem
https://github.com/KiCad/kicad-footprints/pull/1948

aris-kimi, 2020-07-24:
Well... It did.. In my footprint libraries this footprint is correct. So i guess your library files ore not up to date..
This mean this issue can now close.. :-) Thank you for notice that..

zackles, 2020-07-24:
My Bad!  I have the 5.1.5 version. I'm installing 5.1.6 that include the corrected footprint

zackles, 2020-07-24:
My Bad!  I have the 5.1.5 version. I'm installing 5.1.6 that include the corrected footprint

zackles, 2020-07-24:
Thank you aris-kimi for your help.
5.1.6 version works for YUJI_5730 LED.

Closed 2020-07-24.

Thread 2377 (2020-07-29):

SMD Cap 0402 pad size (width) increased in KiCAD 5

matianfu, 2020-07-29:
I just noticed that in KiCAD 5, pad size of 0402 cap is changed. In KiCAD 4.x, it is 0.6mm by 0.5mm, while in KiCAD 5, it is 0.59mm by 0.64mm. The increased width from 0.5mm to 0.64mm is a disaster for design with compactly arranged capacitors. For example, on the bottom side of a DDR chip or arm processor.

I don't think 0.5mm width 0402 pad is anything dangerous for assemply. It is widely used in mass production. 0.64mm may be better for thermal concern.

So could you please provide a compact or narrow version of SMD caps and resistors. They are important for many consumer electronics design since the board space is usually constrained and that is exactly why 0402 packages are chosen.

evanshultz, 2020-07-29:
I could search the history to see why the old chip component footprint pads were the way they were, but I'm not going to... since what's important is the lib now.

The current footprints are created from a script at https://github.com/pointhi/kicad-footprint-generator/tree/master/scripts/SMD_chip_package_rlc-etc. They are to IPC 7351B fillet goals, but with 7351C draft pad shape (rounded rectangle). IPC 7351 is an industry standard and is well-regarded and thus we paid no attention to the current footprints. So we can consider that the pads were undersized before.

However, they're only undersized when compared with the IPC 7351 _nominal_ fillet goals. The script currently only generates nominal footprints, and not most (maximum) or least (minimum) footprints. Smaller pads are useful for a number of uses, such as with various solder pastes and to improve power supply impedance at high frequencies. And bigger pads are helpful when wave soldering chip parts, as one example. Therefore, I have already updated the script to do this and submitted the changes at https://github.com/pointhi/kicad-footprint-generator/pull/439.

But before that is done, the body sizes of chip components need to be corrected. There was an error in the script. I've corrected the script at https://github.com/pointhi/kicad-footprint-generator/pull/438 and pushed updated footprints at https://github.com/KiCad/kicad-footprints/pull/2280. This is blocking the submission of footprints with smaller (and bigger) pads than the library currently contains.

I hope this answers your question and explains things. I believe everything you've written is understood and considered, and the limitation is in manpower to review and merged the updates.

Closed 2020-09-13.

Thread 2380 (2020-07-31):

Layout guidelines for right-angle PCB edge connectors

calebreister, 2020-07-31:
I've been working on a script to generate Samtec right-angle Q Strip and Q Pairs connectors, and run into a questions regarding what the "correct" way to represent the PCB edge in a footprint:
1. Where should the courtyard end? Should it extend beyond the edge of the PCB?
2. What layer should the PCB edge be on? I've seen it on both `Edge.Cuts` and `Dwgs.User`.
3. If the edge is not in `Edge.Cuts`, should there be a label for the PCB edge? If yes, what layer should I use for the label? Should the label be placed on the inside or outside the edge?
4. How wide should the PCB edge line be in comparison to the connector? Should it extend all the way to the edge of the courtyard?
5. According to [F5.2 in the KLC](https://kicad-pcb.org/libraries/klc/F5.2/), the footprint name should be placed below the footprint. Does this rule still apply if the name would have to be placed outside of the PCB?
6. Where should the footprint origin be? Should it be aligned to the PCB edge?

Here's an example of one of the footprints I've generated using my script.
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

Related pull requests:
- #1304
- pointhi/kicad-footprint-generator#397

evanshultz, 2020-08-12:
There are other librarians and many parts I'm not familiar with, but here's my suggestions:
1. Extending around the entire component body, including the part of the component off the board, is what I see in the library now.
2. `Edge.Cuts`. This is a limitation in the tool now, but I understand KiCad v6 will properly support cutouts in footprints. For now, I believe it will be supported by the script generator but you can't edit things later in the footprint editor.
3. `Dwgs.User` will work. Many USB connectors have text on this layer.
4. 0.1mm is what I see in existing footprints. I would say it should just be the width of the connector body. It will be up to the user to connect this to (or overlap it with) their board outline. That being said, I don't see any guidelines about this.
5. Yes. It will appear in the fab drawing which is fine.
6. The footprint origin should be where it always should be: pin 1 for THT parts and the body center for SMD parts (unless pick-n-place or another reason overrides this).

calebreister, 2020-08-19:
Thanks for the info. I'm currently reworking some of the code in my scripts.

Thread 2381 (2020-08-06):

SOT-143 footprint

matianfu, 2020-08-06:
I have check several documents for this package, including:

+ onsemi: https://www.onsemi.com/pub/Collateral/318A.PDF
+ diodes: https://www.diodes.com/assets/Package-Files/SOT143.pdf
+ nxp/nexperia: https://assets.nexperia.com/documents/package-information/SOT143B.pdf

Apparently, the sot-143 footprint in current KiCAD library is way too large. It is for wave soldering, not for reflow. Furthermore, Pad for pin 1 is misplaced. The edge is not well aligned. There is no reason to do so.

chschlue, 2020-08-06:
Are you willing to submit a fix?

matianfu, 2020-08-06:
I don't know if there is a standard? Including:

1. the line width of silkscreen, fab, and courtyard.
2. the fab and courtyard enlargement compared with the physical size and occupied area provided by the manufacturer.

Is there any agreement on those value? If so, I am happy to try it. :)

Also, the 3D model seems no appropriate for this package. All three documents listed in the first post agrees that the maximum distance between pin edges are no more than 2.5mm. But the SOT-143.wrl model seems to be at least 2.8mm width. I think this should be fixed either.

chschlue, 2020-08-06:
Short answer: you can use the line widths of the existing FP, they're fine; fab should be the nominal body outline while courtyard should be 0.25mm from fab and copper.
Long answer: https://kicad-pcb.org/libraries/klc/

If anything is unclear, feel free to ask.

perigoso, 2020-08-19:
I was working on this because i needed this package, i added a suffix to the originals `_WaveSolder` but it seems it's not done anywhere else, should we keep the old footprints? under what name? maybe specify the pad sizes

chschlue, 2020-08-19:
If there is demand (is SMT wave soldering still a thing?), I guess it would be fine to add `_WaveSolder` footprints.

perigoso, 2020-08-19:
I don't think it's relevant anymore, we don't have wave solder footprints for anything else, I'll submit the PR without them.

Thread 2391 (2020-08-14):

Through-hole mount hole pad is on all layers instead of top/bottom (in multi-layer board)

StefanHamminga, 2020-08-14:
Through-hole fastener pads appear on all layers instead of top/bottom when using mount hole footprints in a multi-layer board. I'm not sure if this is by design or not, but it's wasting a fair amount of space. An 'offending' footprint is for example this one:

https://github.com/KiCad/kicad-footprints/blob/2742356730f9289f82ff5d895f67e9af5495141d/MountingHole.pretty/MountingHole_2.2mm_M2_DIN965_Pad.kicad_mod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

If it's agreed this should be top + bottom only I can probably make up some Linux shell-fu to bulk convert any line like above into two lines for the top and bottom copper layers. Would this be preferred or a pull request?

chschlue, 2020-08-14:
I don't think there can be a real solution until KiCad gains support for pad stacks.

IMO, pads on all layers is the best option we currently have. You may want to connect the pad to an inner ground layer, for example.
Besides, it's still a plated hole. How you close are you going to route inner tracks alongside it?

StefanHamminga, 2020-08-14:
I'd agree if it was just the plated hole and through hole pad, but for the "pad" type of mounting holes it's the whole screw head pad on every single layer.

I'd rather have my power plane beefed up locally than a random bit of ground plane on every layer.

My own library has another solution, using a regular size through hole annular ring and an extra pad on one side for the fastener head: https://github.com/StefanHamminga/kicad-footprints/blob/master/MountingHole.pretty/MOUNT_HOLE_M2.kicad_mod

That leaves a lot more space for routing and only places the large pad where you'd expect one to be. It would be great if the official libs have a similar (imho more elegant) solution so I can drop the custom holes.

chschlue, 2020-08-14:
Your second proposal seems reasonable to me. Still, I suggest adding them to the current ones instead of replacing.
Perhaps with a `_TopOnly` suffix or something.

Closed 2020-08-16.

Thread 2416 (2020-08-25):

Keyboard footprint merge discussion

perigoso, 2020-08-25:
I'm creating this issue to have a centralized place for discussion regarding the massive keyboard footprints merge that i now split into multiple PRs.

This way we have somewhere to discuss things that affect all the fp's and we can better coordinate things.

The original PR #2394

perigoso, 2020-08-25:
The original `Button_Switch_Keyboard.pretty` Includes a README.md, is this required? What's it's purpose? It seems most footprint libs don't include this file.

diegoherranz, 2020-08-26:
> The original `Button_Switch_Keyboard.pretty` Includes a `README.md`, is this required? What's it's purpose? It seems most footprint libs don't include this file.

No. In fact, I would remove it. It may come from the old repo structure in which every .pretty was a separate repo.

perigoso, 2020-08-26:
In that case maybe we'd remove it from all libs that include one? can I submit a PR with that or Just for the `Button_Switch_Keyboard.pretty` lib, since it would be the last file in that folder after the keyboard switch PRs move things around.

perigoso, 2020-08-26:
So I had `_NoSilk` variants of footprints, because some people, including me, don't include silkscreen on the switch footprints for aesthetic reasons, but i was unaware that it was possible to hide it in bulk in `pcbnew`, so after some digging around and trying things out i came to this:

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

This is a good versatile solution, and i feel the `_NoSilk` variants don't make sense given this option, maybe it might not be immediately clear to people but still, any input?

evanshultz, 2020-08-27:
We require assets to comply with http://kicad-pcb.org/libraries/klc/, unless there's a specific reason not to or that doc needs an update. In this case, it's not. So yes, please only keep versions with silk as those do comply with the library guidelines.

perigoso, 2020-08-27:
I am familiar with [KLC](http://kicad-pcb.org/libraries/klc/), I see no reason the `_NoSilk` versions of the footprints do not comply, hence why i was ok with including them in the first place.

chschlue, 2020-08-27:
[Thou shalt not leave out silk](https://kicad-pcb.org/libraries/klc/F5.1/)

perigoso, 2020-08-27:
The reference was still included, they just didn't have the square outline

chschlue, 2020-08-27:
Yes, if you want to be really, really finnicky about the wording, you could argue that outline silk is not explicitly required.

But a silk pin 1 designator sure is. Please also add outline silk while your at it ;)

perigoso, 2020-08-27:
I was not trying to word things my way, i was genuinely under the impression it was not required TIL i guess. I knew about the pin 1 marker but these footprints are not polarized, and they can only be mounted one way anyway.

I believe the hybrid footprints don't have a silkscreen outline, so I'll add it to those too.

chschlue, 2020-08-27:
Sry, got you wrong there.

But as you said, users can always disable it if they don't like it.

perigoso, 2020-08-27:
> In that case maybe we'd remove it from all libs that include one? can I submit a PR with that or Just for the `Button_Switch_Keyboard.pretty` lib, since it would be the last file in that folder after the keyboard switch PRs move things around.

What about this? the question got buried.

chschlue, 2020-08-27:
Please stick to the switches for now.
Some amount of restructuring for v6 is coming and I would like some structure in "housekeeping" PRs like that if possible.

perigoso, 2020-08-27:
Thinking these footprints are a good candidate for a script with [kicad-footprint-generator](https://github.com/pointhi/kicad-footprint-generator), should've come to this realization before having done all this manual work

perigoso, 2020-09-04:
Created Scripts for the creation of these footprints

perigoso, 2020-09-04:
Created a PR pointhi/kicad-footprint-generator#605 with the scripts to generate keyboard switch footprints, the PRs have been updated with the generated footprints, for reference here are the footprints:

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

perigoso, 2020-09-04:
Of note, I removed the stabilizer mounting holes from these footprints, i intend to add them in separate footprints.

perigoso, 2020-09-04:
There are some issues on the scripts that need to be fixed, namely 3D model settings, and reference designation.

perigoso, 2020-09-13:
Some issues on the script have been fixed and the footprints re-generated.

Thread 2465 (2020-09-13):

Incorrect pin numbering on Molex Pico-Lock 504050 series connectors

justyn, 2020-09-13:
The pin numbering of the 1.5mm pitch versions of the Molex Pico-Lock 504050 connectors is backwards.

The files are in this repository at `Connector_Molex.pretty/Molex_Pico-Lock_504050-**91_1x0*-1MP_P1.50mm_Horizontal.kicad_mod`.

The connector family page is [here](https://www.molex.com/molex/search/deepSearch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), the datasheet [here](https://www.molex.com/pdm_docs/sd/5040500291_sd.pdf).

As well as the numbering being specified in the datasheet, circuit 1 is also marked with a physical indicator on the connectors.

These footprints are generated using [kicad-footprint-generator](https://github.com/pointhi/kicad-footprint-generator), using [smd_single_row_plus_mounting_pad.py](https://github.com/pointhi/kicad-footprint-generator/blob/master/scripts/Connector/Connector_SMD_single_row_plus_mounting_pad/smd_single_row_plus_mounting_pad.py) with values from [conn_molex.yaml](https://github.com/pointhi/kicad-footprint-generator/blob/master/scripts/Connector/Connector_SMD_single_row_plus_mounting_pad/conn_molex.yaml).

The fix is really simple, the value [here](https://github.com/pointhi/kicad-footprint-generator/blob/491dfee3abab24f1449327aae393530a9c6d4fa2/scripts/Connector/Connector_SMD_single_row_plus_mounting_pad/conn_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) for `pad1_position` must be changed from `bottom_left` to `top_left`.

I'd be happy open a PR with the fixed footprints but I'm not sure what the process is given that changing the pin numbering would break any existing designs.

This issue came up because I am trying to add the 2mm pitch version of this family ([PR here](https://github.com/pointhi/kicad-footprint-generator/pull/625)).

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

chschlue, 2020-09-13:
> I'd be happy open a PR with the fixed footprints but I'm not sure what the process is given that changing the pin numbering would break any existing designs.

This is a severe bug and footprints are also embedded in board files, so existing design won't get broken.
A fix is very welcome.
Note to self: Cherry-pick to v5.

Closed 2020-09-13.

Thread 2473 (2020-09-18):

SMD Feedthrough Capacitors

jamesrlucas, 2020-09-18:
I am looking to use some feedthrough capacitors in some design I am working on, however there are currently no footprints in the libraries. Before I start creating & submitting footprints, I'd like to ask for opinions on how to go about it.

Example devices

[Murata 0603](http://www.farnell.com/datasheets/90767.pdf)
[TDK 0603 & 0805](http://www.farnell.com/datasheets/2942825.pdf)
[Murata 0805](http://www.farnell.com/datasheets/608981.pdf)
[AVX 0805 & 1206](http://www.farnell.com/datasheets/2097719.pdf)
[Knowles 0805, 1206, 1806 & 1812](https://www.knowlescapacitors.com/getattachment/982649d9-f72f-4bee-a557-e7285e5005bc/E01-300mA.aspx)
[Murata 1206](http://www.farnell.com/datasheets/1902092.pdf)

All have slightly different recommendations on land patterns (if any!)

Questions:

1: Does anyone have access to the IPC recommendations? (if any!) - I have no idea if feedthrough caps are included or not.
2: Are these footprints we could script?
3. Would a single generic footprint be OK, or should we use manufacturer-specific footprints?
4. What library to put them in - Capacitor_SMD or Filter?

Thanks,

James

cpresser, 2020-09-19:
> Questions:
>
> 1: Does anyone have access to the IPC recommendations? (if any!) - I have no idea if feedthrough caps are included or not.

See https://github.com/pointhi/kicad-footprint-generator/pull/438, at least one outdated `IPC-SM-782` document is linked there.
That generator is also partially related, it does RLC footprints.

> 2: Are these footprints we could script?

Yes but .... AFAIK there is no script that can handle it. It needs to be created. Those parts a rather special, so it is not mandatory to script them.

> 3. Would a single generic footprint be OK, or should we use manufacturer-specific footprints?

Depends. I would start comparing them and see if there can be a consensus footprint.

> 4. What library to put them in - Capacitor_SMD or Filter?

Everything is a filter if you are brave enough!
`Capacitor_SMD` sounds better to me, but I have no arguments.

cpresser, 2020-09-19:
From the Murata 1206 Datasheet. Quite interesting, since there is more paste than copper area:
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

Thread 2476 (2020-09-20):

DO-27 Pad Hole Size Too Small

fatalelieberi, 2020-09-20:
Hi, I just want to report that the standard hole size for DO-27 diodes is too small. It should be, at minimum 1.3mm, or ideally 1.4mm, instead of 1.2mm in the standard Kicad library. Many manufacturers specify the lead diameter to be 1.3mm at maximum.

Manufacturer data sheet
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

Kicad Library
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

chschlue, 2020-09-20:
JEDEC DO-201AA (formerly DO-27) has 0.91mm max lead diameter.
What you're looking at is probably in fact a DO-201AD package (1.42mm max.)

fatalelieberi, 2020-09-20:
Well, that's weird. It seems that some manufacturers use DO-27 package name for some types even though they have dimensions as specified by DO-201AD, such as MBR5200, SK306, SR520-SR5100 diodes.

chschlue, 2020-09-20:
Yes, we are frequently faced with naming issues like that.
But simply increasing the actual DO-27 FP to 1.5mm hole diameter (max lead + 0.2mm) isn't a sensible solution.

Closed 2020-09-20.

Thread 2484 (2020-09-22):

_Handsolder footprints in v6

cpresser, 2020-09-22:
In https://github.com/KiCad/kicad-footprints/pull/2280#issuecomment-696971187 the question came up how to handle the `_Handsolder` footprints.

The problem is that they are sprinkled all over the lib. And they don't have clear rules on how to build them. Thus, they vastly differ.

I think we should keep them. KiCad is used a lot by hobbyists and beginners - most of those people are afraid of any SMD/SMT stuff. With dedicated footprints they have an easier start into the SMT world.
But I think we should devise some kind of ruleset for them. Perhaps increased courtyard, and a explicit rule for pad elongation.

chschlue, 2020-09-22:
Picking up your 0805 example:
If I'm not mistaken, a level A variant has an even longer pad than the current 1.15mm HandSolder one.
Why not go with the rule set we already have? (And perhaps add HandSolder to the tags or something.)

evanshultz, 2020-09-22:
That sounds like a great proposal to me. Level A doesn't say it's used for hand solder, but it does mention wave soldering and it might make sense to put that into the keywords as well.
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

calebreister, 2020-09-23:
Personally, I've never had trouble hand-soldering the regular footprints down to 0603. I did handsolder/rework 0402 once, but I wouldn't wish that upon anyone.

Thread 2499 (2020-09-28):

Please fix smaller kicad logos

codemonkeyrawks, 2020-09-28:
It is suggested that kicad has the following logos for design:

3mm Logo
4mm Logo

Closed 2020-09-28.
