KiCad/kicad-footprints/(commit log)

2017-09-17 Added all active footprint repositores as submodules
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2017-11-03 New script generated SMD resistor packages for review
2017-11-03 Rotate fab reference for wide devices if this allows for an increased font size.
2017-11-04 Added footprints for capacitors
2017-11-04 Added Inductor and Diode footprints. Deleted some handsolder versions
2017-11-05 Added 2.54mm pin headers
2017-11-05 Added 2.00mm pin headers
2017-11-05 Added 1.27mm pin headers
2017-11-05 Added 1.00mm pin headers
2017-11-05 Added 1.27mm pin sockets
2017-11-05 Added 2.00mm pin sockets
2017-11-05 Added 2.54mm socket strips
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2017-11-05 Adding tantal and led footprints.
2017-11-05 Adding remaining capacitor footprints from original repo. (unmodified)
2017-11-05 Changed 3d path to singular for old footprints
2017-11-05 Add special diode sizes (2114 and 3220)
2017-11-05 Add remaining unmodified footprints from old diodes_smd repo.
2017-11-05 Add unmodified LEDs from old repo
2017-11-05 Split LEDs in SMD and THT. Change 3d model path to singular.
2017-11-05 Add unmodified footprints from old resistors_smd repo
2017-11-06 Add requested 4020 resistor
2017-11-06 Special paste pad for smaller 0402 footprints.
2017-11-06 Handsolder and normal versions of LED and Diode footprints can share their 3d models.
2017-11-07 Adding script generated phoenix contact connector footprints.
2017-11-07 Copied relay fooprints
    - Relay_SMD
    - Relay_THT
    - No attempt to fix KLC
2017-11-07 added (remade) script-generated footprints
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2017-11-07 Allegro PFF/PSF: Pin 1 trap -> rect
2017-11-08 Fixed 3D path
    Relays_xxx -> Relay_xxx
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2017-11-08 Added LEM sensors to Sensor_Current library
2017-11-08 Adding corrected versions of the JST GH connector series
2017-11-08 Adding mm after pitch field
2017-11-09 Renamed connector jst ph footprints.
2017-11-09 Adding new SHL series footprints
2017-11-09 Add new Allegro current sensor footprints
2017-11-10 Copy the pin headers' description & tag format for IDC headers
2017-11-10 added 2 series of 3.5mm 4Ucon terminal blocks
2017-11-10 added Philmore terminal blocks (actually there are only 2- and 3-pin-variantsm althogh we had up to 16-pin before)
2017-11-10 Add molex smd connector footprints. (PicoBlade, Pico-Clasp, Pico-EZmate and Panelmate)
2017-11-11 Adding information that these are script generated to the footprint description fields.
2017-11-11 Change Pitch -> P, Angled/Straight -> Horizontal/Vertical
2017-11-11 Panelmate 53780 is a horizontal connector
2017-11-11 Correct mpn for pico clasp vertical
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2017-11-11 Fix pico lock measurements. (mount pad and body position, front cutout measurments)
2017-11-11 Adding newly created smd versions for jst connectors.
2017-11-11 added reworked WAGO-footprints
2017-11-11 Fix pad size for SFH connector
2017-11-12 added 45Degree connector series
2017-11-12 fixed pin-size of RND_205-00045...
2017-11-12 fixed height of RND205-00287... from 10.16mm to 10.6mm
2017-11-12 fixed drill size to 1.5mm (should be good with 1.0mm pins, same as recommended for RND 205-00056...)
2017-11-12 - reworked pad sizes derived from pin (- 1mm pin --> 1.3mm hole, 0.7x0.5mm pin --> 1.1mm hole) - removed two that do not exist and overlap with other numbers (205-00241/242 with 5.08mm pitch does not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
2017-11-12 minor changes to keep footprints synchronized with changed scripts (no really visible changes!)
2017-11-12 added single screw terminals from MetzConnect
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2017-11-12 added pre-existing footprints from https://github.com/KiCad/Connectors_Phoenix.pretty
2017-11-13 Fix for inside text positions and pico blade outline graphics.
2017-11-15 Updated and new pin sockets
    Added single row SMD for 2.00 and 2.54mm. Removed 3D model offsets and
    rotation so many legacy models can no longer be used.
    SMD dimeninsions are from legacy footprints, there are many variants
    available and some does not match the legacy land pattern. Perhaps at
    least two different land patterns should be made for each?
    Scripted 3D models for all variants has been made and a PR or these will
    be made when this PR is eveentually merged.
2017-11-15 Update TODO.md
    Mark relay libs as complete
2017-11-15 Update TODO.md
    Marked Housings_xxx as complete
2017-11-15 Decrease size of PLCC THT pads
    Drill size and pad width is decreased to enable the placement
    of two signal lines between them. Width of signal lines is
    8 mil or 0.2032 mm.
    drill 0.95 --> drill 0.8
    size 1.75 1.75 --> size 1.4224 1.4224
2017-11-16 Add following packages, used by Altera: 1. LQFP-144-1EP_20x20mm_P0.5mm_EP4x4mm 2. LQFP-144-1EP_20x20mm_P0.5mm_EP5x5mm 3. LQFP-144-1EP_20x20mm_P0.5mm_EP6.61x6.61mm 4. LQFP-144-1EP_20x20mm_P0.5mm_EP7.2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
2017-11-16 For BGA case with 0.5mm balls ~0.4mm pads should be used instead of 0.5mm pads.
    "Well a good place to start for questions like these would be the IPC spec PC-7351B not free but it has all the information you'd need about land patterns for most any part."
    https://electronics.stackexchange.com/questions/165232/how-to-determine-bga-land-pad-diameter-for-given-ball-diameter
    Actual footprint refer to xilinx package documentation. Same (~0.4mm) suggestion is given at Xilinx footprint recomendations:
    https://www.xilinx.com/support/documentation/user_guides/ug1099-bga-device-design-rules.pdf
2017-11-16 1. Update name according to new KiCAD KLC. 2. Add recommended design rules documentation reference.
2017-11-16 Footprint file name should correspond to footprint name.
2017-11-16 Update 3d shape name to LQFP-144_20x20mm_Pitch0.5mm.wrl.
2017-11-17 Add newly created JST THT connector footprints.
2017-11-17 Corrected names for VH and ZE connectors.
2017-11-17 Better pin 1 marker for jst eh side entry
2017-11-17 Better pin 1 marker for J2100 series
2017-11-17 Changed inside silk details such that they do not interfere with mount hole pads for J2100 top entry
2017-11-17 Removed NV connectors > 4 pins. (They do not exist. Copy paste error in new generator.)
2017-11-17 Moved Fab pin 1 markter to the inside for PUD footprints
2017-11-17 Corrected pad to silk clearance for VH stabalized side entry footprints
2017-11-17 XH better pin 1 marker and adding boss version
2017-11-17 Pin 1 shape to rect
2017-11-17 Update TODO.md
    LEM hall-effect sensors are also done
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2017-11-17 Update TODO.md
    Marked "sockets" as complete - it's an older library that can probably be deprecated anyway.
2017-11-17 Fixed pluralization
    MountingHoles -> MountingHole
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2017-11-18 Increased pad sizes for ZE footprints.
2017-11-18 adding Molex KK-254 series connector footprints
2017-11-18 Fix description (datasheet link) and pin 1 marker on fab
2017-11-18 Update TODO.md
    JST connectors
2017-11-19 Ok pin 1 is in the top row.
2017-11-19 added TO-92-variants + a special japan molded package
2017-11-19 Adding MicroClasp connector footprints
2017-11-19 Better silk pin 1 marker for micro clasp
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2017-11-21 THT Capacitors
    Copied caps from old repo
2017-11-21 Update TODO.md
    Marked power-integrations as done
    (Not really "done" but it is an old lib that should probably not be copied)
2017-11-21 Update TODO.md
    * Cap THT done
    * Enclosures repo is actually empty
2017-11-21 Updated 3d footprint name
2017-11-21 Fixed KLC violations, added some 1.00 and 1.27mm footprints
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2017-11-22 Now the real top entry footprints are added.
2017-11-22 Added 1.27mm 2 rows horizontal sockets, corrected remaining KLC violations?
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2017-11-23 Added existing L-Tek footprints
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2017-11-23 Better pin 1 marker for nano fit footprints
2017-11-24 Picoflex smd version and regenerated tht version. (just to make sure i have the correct footprints)
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2017-11-24 Add all script generated molex slimstack footprints
2017-11-24 new diode footprints (cathode marked with a K, which is better visible than the old marks)
2017-11-24 Adding newly script generated footprints for Molex SPOX tht vertical
2017-11-25 fixed footprints as requested (placement of A,K,%R)
2017-11-25 Switched to yaml parameter file, added datatsheet reference
    For legacy footprints datasheet reference is back to KiCad 4.0.7. Some
    adjustments for new footprints for compliance with datasheet dimensions.
    Yaml parameter file is shared with 3D generator, will PR models and
    script when new licence text is ready. PR for updated foortprint script
    is already made.
2017-11-25 added fixed, pre-existing footprints
2017-11-26 added old BNC/SMA/SMB connectors
2017-11-26 added/reworked pre-existing USB-connectors
2017-11-26 added/fixed pre-existing batteries and battery holders
2017-11-26 added/fixed pre-existing edge-mount connectors (PCI/ISA/PCIe-bus)
2017-11-26 added/fixed pre-existing RJ12/RJ45 connectors
2017-11-26 added/fixed pre-existing SAS-mini connector
2017-11-26 added/fixed some pre-existing connectors
2017-11-26 added/fixed/renamed pre-existing solder bridge jumpers
2017-11-26 moved/fixed/renamed pre-existing optoDevice-footprints
2017-11-26 added/fixed pre-existing footprints, that were not added when moving
2017-11-26 Adds footprint for 3M 40-pin ZIF socket
2017-11-27 Pads to ovals, silkscreen outside of fab, pin 1 marker, dimensions based on mm instead of inches
2017-11-27 Adding amphenol sma connector from old Connectors_Amphenol repo
2017-11-27 Adding hirose connectors generated with the new generic generator script
2017-11-27 Add THT hirose connectors
2017-11-27 Package_DFN_QFN: rename all variants of TI S-PVQFN-N40
    TI uses the same package ID for devices with different footprints,
    therefore the size of the exposed pad needs to be added to the name.
2017-11-27 renamed SOlderJumper.pretty -> Jumper.pretty
2017-11-27 renamed TRAFO->Tranformer (for RJ connectors)
2017-11-27 Add fuse footprints (newly generated smd plus renamed footprints from old repo)
2017-11-27 Fix pad type for NPTH mounting hole
2017-11-28 Upload final 2-pin net ties
2017-11-28 2- and 3-pin net ties
2017-11-28 Moves socket to new library Socket.pretty
2017-11-28 Renamed Conn_ to Connector_
2017-11-28 Update TODO.md
    Fuses are done
2017-11-28 Adding remaining non scripted Molex connectors to new repo
2017-11-28 Add remaining FFC connectors
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2017-11-28 Add second reference for sma connector
2017-11-28 Moved from Conn_* to Connector_*
2017-11-28 Fixed 3D model for Connector_xxx libraries
2017-11-28 Add 4-pin net ties
2017-11-28 Add keepout area to DF13C connector footprints
2017-11-28 add reverse mount 1206 SMD LED
    footprint from kingbright datasheet, except hole is circular instead of rectangular.
    http://www.kingbright.com/attachments/file/psearch/000/00/00/KPTR-3216SYCK(Ver.15B).pdf
2017-11-28 de-rotated text (bug in old footprints)
2017-11-28 Package_DFN_QFN: update all variants of TI S-PVQFN-N40
    - use pad shape which is identical to TI's footprint recommendation
    - link to datasheet instead of package specification
    - add Texas_S-PVQFN-N40_EP4.15x4.15mm_ThermalVias
    - add Texas_S-PVQFN-N40_EP2.9x2.9mm
    - add Texas_S-PVQFN-N40_EP2.9x2.9mm_ThermalVias
2017-11-29 Made naming of tantal caps easier to understand (Move letter code towards the back to avoid impression that these are manufacturer specific footprints)
2017-11-29 Adding samtec edge connector footprints (MECF)
2017-11-29 Samtec edge connect sockets
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2017-11-29 Adding TE Connectivity FFC/FPC connectors
2017-11-29 Adding newly scripted Wago 734 connector footprints
2017-11-30 add fp lib table entry for FFC/FPC footprints
2017-11-30 Fix first two heatsink footprints
2017-11-30 renamed footprints (removed _Narrow)
2017-11-30 All heatsink footprints are reworked now.
2017-11-30 Rename Some connectors to be more consistent
2017-11-30 Samtec MECF: Add pitch to footprint names
2017-11-30 Removed duplicate SD card footprints
    - Three copies of same footprint
    - Removed two
2017-11-30 Workaround, remove heatsink entry from lib table
2017-11-30 Add heatsink entry again.
2017-11-30 Converter_DCDC_ACDC: Rename footprints to comply with KLC
2017-11-30 Converter_DCDC_ACDC: Rename footprints, not only files
2017-11-30 Move Molex FFC connectors. Fix 502250 pin layout (plus a few graphical changes)
2017-11-30 move hirose ffc connectors
2017-11-30 added flat TO-92 as used for hall switches
2017-11-30 Use pin pitch instead of cable pitch in footprint name
2017-11-30 Add unchainged footprints from TerminalBlocks.pretty
2017-12-01 Adding JAE FFC/FPC connector (Series FF08)
2017-12-01 Add horizontal JAE LY20 connector footprints
2017-12-01 Converter_DCDC_ACDC: Delete unused Vigortronix footprint
2017-12-01 Converter_DCDC: Add a hiphen between properties of the same group in Cincon EC6Cxx footprint
2017-12-01 Add old Measurement Scale footprints unmodified
2017-12-02 New Relay Footprint
    Relay_DPDT_AXICOM_IMSeries_JLeg
2017-12-02 Changed silkscreen width
    Changed silkscreen width from .12 to .15 mm
2017-12-03 add SMT battery holder for cr1216/cr1220/cr1225 from Linx
2017-12-03 Add generic USB B vertical connector footprint.
2017-12-04 Regenerated from updated script
    Script was updated to fix the following:
    (1) Fab text location
    (2) 3d references
    (3) 3d scaling
    These footprints have been regenerated from the script.
2017-12-04 Update power rating description
    Decimals are more appropriate: maximum of 3, but as few as possibe (to make it easier to search).
2017-12-04 Add Tensility 54-00023: mini USB type B vertical connector footprints: 1. With oval holes. 2. With circular holes.
2017-12-04 Radial and shunt resistor errors
    Found by Travis
    (1) Shunt had comma in the tags
    (2) Radial was FUBAR due to some integer division. Thank Python!
2017-12-04 A few more integer division problems
    These footprints also had issues with integer division.
    I think I'm running the wrong Python but otherwise working ok. :)
2017-12-04 Oops fix: correct F.Fab first pin marking.
2017-12-04 Update footprint names to meet KLC F3.6 'Connectors for Specific Functions'.
2017-12-05 Transfer of Modules.pretty footprints over to the new repo
2017-12-05 Fix footprint placement
2017-12-05 Add original footprints (plus virtual flag)
2017-12-05 Fix KLC errors in the one footprint that has been missed previosly
2017-12-06 Change pin number for shielding pads to "SH"
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2017-12-06 enlarged drills to match actual pin-diameter (typical drill 0.75mm, as wires are typically 0.55x0.45mm²)
2017-12-06 fixed description (drill size)
2017-12-06 added 2-pin hor. variants
2017-12-06 added reversed-pin-2-variants
2017-12-07 Add TE MATE-N-LOC series connectors. (Formally known as Mini-Universal)
2017-12-07 added footprint for ESP-WROOM-02
2017-12-07 Add Lock versions for IDC headers from old Connectors.pretty repo. Rotated to move pin 1 to the top left, added pin 1 markers and second reference.
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2017-12-07 Fix naming for Tag Connect (include pitch and orientation)
2017-12-08 Run fixmore for Grove connector
2017-12-08 Run --fix for JWT connector
2017-12-08 moved ESP-WROOM-02 footprint to RF_Module library
2017-12-08 FIX: UQFN-10_1.4x1.8mm_P0.4mm has wrong pin numbering.
2017-12-08 added Pin 1 identifier in F.Fab layer
2017-12-08 added keep out zone for antenna
2017-12-11 add nordic AQFN73 footprint
2017-12-12 add Bosch LGA-8 2x2.5mm Pitch 0.65mm footprint (#176)
    This adds the manufacturer specific footprint Bosch LGA-8 2x2.5 with inverted pin layout
2017-12-12 Add SMD pot footprints
2017-12-13 Add SMD and THT footprint entries
2017-12-13 3D model params, descriptions, footprint names
2017-12-16 Fix mpn in footprint name for molex micro latch.
2017-12-17 change pin positions of Schrack RT2 DPDT relays
    position was based of a 2.54mm grid instead of the dimensions given in the
    datasheet. The old layout was compatible, but not entirely correct.
    Also use oval pads to increase clearance between pads for 250V.
2017-12-17 delete duplicate Relay_DPDT_Schrack-RT2_RM5mm
    same as Relay_DPDT_Schrack-RT2-FormC_RM5mm
2017-12-18 Remove ThermalPad suffix and add -1EP descriptor to htssop footprints
2017-12-20 add footprints Mini-Ciruits CDxxx for RF transformers
2017-12-21 add Traco Power TCK-141 inductor footprint
2017-12-21 Add Samtec HLE connectors
2017-12-21 Update script and SMD pot footprints
2017-12-22 Add remaining SMD pot footprints
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2017-12-22 Add F.Fab ref des
2017-12-22 Add F.Fab ref des, add F.Paste to SMD pads
2017-12-22 Bourns PRS11S: Fix F.Fab ref des
2017-12-22 Re-center SMD footprints except for PRS11S
2017-12-24 reworked jumper library (removed old, added series of new solder jumpers)
2017-12-26 added all required PowerIntegrations packages
2017-12-26 added missing TO-220-7C footprint
2017-12-28 Fix naming for HTQFP-64-1EP footprint, added version without thermal vias and reduced mask
2017-12-29 Corrected the footprint outlines
2017-12-30 fix layers for large copper pad of 32-1EP pin version
2017-12-30 PG-DSO-20-30 footprint for TLE8104E smart low side switch
2017-12-31 Add Kingbright KRC011 Reflective Opto Sensor
2018-01-01 added missing footprint
2018-01-01 made all ThermalVia-parts KLC-compliant (added bottom pad, removed mask/paste on bottom, renamed two footprints not in sync with KLC naming conventions ...)
2018-01-01 Updated silkscreen outline as suggested
2018-01-01 Changed Pin-1 marker to 90-degree style
2018-01-02 added several more reflex couplers
2018-01-03 added more reflective couplers
2018-01-03 increased PCB-cutout (should work with e.g. 0.8mm tool-diameter for cuter)
2018-01-03 Added MAPBGA-64_5.0x5.0mm_Layout8x8_P0.5mm.kicad_mod for MCU_NXP_Kinetis symbols
2018-01-04 reworked all DIP-switch footprints (naming, style, some new, ...)
2018-01-04 Xilinx FB BGA 484
    FB-484 devices require smaller ball diameter
2018-01-04 Update exposed pad design to meet recent KLC. See https://github.com/KiCad/kicad-footprints/issues/209.
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2018-01-05 Remove circle next to first pin.
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2018-01-05 Updated pin 1 designator
2018-01-05 added/renamed/moved several packages for diode bridges
2018-01-05 added 19x10x3.5mm diode bridge
2018-01-06 added some DIP-Switches from KingTek
2018-01-06 added several more diode bridge packages
2018-01-07 fixed polarity sign and some silkscreen, crt yard etc.
2018-01-08 fix several footprints to support pre-existing 3D models
2018-01-08 removed outdated footprint, which now has better replacements
2018-01-08 Rename HTSSOP-32 to include mask size. Add HTSSOP version with reduced mask size for LED driver
2018-01-08 Remove pin number from HTSSOP Paste pads
2018-01-09 Fix metric code for standard 1020 resistor
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2018-01-09 Added BLM 19650 Battery Holder
2018-01-09 add FTR5 SMD footprint
2018-01-09 add pin1-marker on F.Fab and removed silkscreen below component
2018-01-09 moved origin to pin 1
2018-01-10 Add pad number to via pads in monting hole footprints.
2018-01-10 Added footprint for the Ai-Thinker Ra-01 LoRa Module
2018-01-11 Corrected surface mount setting
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2018-01-12 LFCSP-32-1EP Pitch0.5mm with 3.1x3.1mm EP
    As per
    http://cds.linear.com/docs/en/packaging/QFN_32_05-08-1693.pdf
    but with smaller thermal pad
    http://www.analog.com/media/en/package-pcb-resources/package/pkg_pdf/lfcspcp/cp-32/CP_32_27.pdf
2018-01-14 added several more Omron relays
2018-01-14 rworked Finder 40.31/51/52 relay footprints (pin pitch, outline, ...)
2018-01-15 Add Cree RGB LED PLCC6 6x5mm SMD
2018-01-15 added Bourns SRN1060 footprint
    datasheet: https://www.mouser.com/ds/2/54/RN1060-778131.pdf
2018-01-15 the actual footprint
    forgot to save the changes
2018-01-15 added Coilcraft LPS4018 Inductor footprint
2018-01-16 added Texas_S-PWSON-N6 footprint
    Datasheet: http://www.ti.com/lit/ds/symlink/tps717.pdf
2018-01-16 updated DFN-8-1EP_2x2mm_P0.5mm footprint according to newer KLC
    datasheet:
    http://www.onsemi.com/pub/Collateral/506CN.PDF
2018-01-16 added Qorvo_DFN-8-1EP_2x2mm_P0.5mm
    Datasheet: http://www.qorvo.com/products/d/da000896
2018-01-16 modified QFN-16-1EP_4x4mm_P0.65mm according to new footprint style
    datasheet: http://ww1.microchip.com/downloads/en/PackagingSpec/00000049BQ.pdf
2018-01-16 modified LQFP-48_7x7mm_P0.5mm according to new Footprint style
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2018-01-17 Add Molex CLIK-Mate 1.5 and 2.0mm variants
    Created using kicad-footprint-generator, changes to config are in
    https://github.com/pointhi/kicad-footprint-generator/pull/108/
2018-01-17 Illegal characters in footprint name, 3D model reference
2018-01-18 fixed Epad size and added a Thermal Via footprint
2018-01-18 Renaming the footprint name (removal of CCW suffix)
2018-01-19 Rename to specify body size and pitch
2018-01-19 Widen silkscreen and courtyard clearance
2018-01-19 Add Texas_S-PVQFN-N20_EP2.7x2.7mm
    matching footprint(s) for DRV8662 package
2018-01-19 Calculate courtyard from body and pads, not silkscreen
2018-01-19 moving courtyard line up and down to fit 0.25mm rule aroud the package
2018-01-19 increasing pad size to take PINS + Pitch tolerance into account
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2018-01-20 Add RGB Led footprint for ASMB-MTB0-0A3A2
2018-01-20 Fix KLC error: lines on 0.01mm grid
2018-01-20 added missing footprints for Finder 40.xx series
2018-01-20 reworked footprints for Finder 34.xx series
2018-01-20 reworked footprints for Schrack RYII-series
2018-01-20 added finder 30.22 footprint
2018-01-20 added/reworked Schrack RT1/RT2 footprints
2018-01-20 added Finder 34.81 footprint
2018-01-21 Moved silkscreen tighter to fab.
2018-01-21 Add matching 3D footprint filename
2018-01-21 added solder jumper footprints with triangle/arrow shapes
2018-01-21 Add size of exposed pad to DFN footprints. Correct paste definition for DFN footprints.
2018-01-22 Moved to the suggested library and keep the silkscreen
2018-01-22 Fixed fuse name
2018-01-22 LFCSP-20
    ADF4002 footprint
    (LFCSP 20-6)
    http://www.analog.com/media/en/technical-documentation/data-sheets/ADF4002.pdf
2018-01-22 fix up ep stuff for remaining generic qfn footprints
2018-01-22 EP stuff for UQFN,WQFN and VDFN footprints
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2018-01-23 Two footprints had paste pads on the back side. (I seem to have missclicked.)
2018-01-23 Added APV21_SSOP footprint for photodiode output optocoupler
2018-01-23 Fixed issue regarding F.CrtYd rounding to 0.01mm
2018-01-23 Removed extraneous footprint and changed 3D model reference
2018-01-24 QFN-56-1EP_8x8mm_P0.5mm
    Footprint for CY7C68013A
    http://www.cypress.com/file/138911/download
2018-01-24 Add new footprint for Atmel EEPROM AT24CS01 etc
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2018-01-26 Add MLF8 2x2mm footprint for Micrel devices
2018-01-26 Added RefDes to footprint
2018-01-26 Changed pin 1 to rectangular
2018-01-26 TO-277A center footprint anchor
2018-01-26 TO-277B changed
    Remove copper, mask and pad number from paste pads.
    Remove pins from fab outline.
    Change fab pin marker to chamfer.
    Change fab outline to nominal body size.
2018-01-26 TO-277A
    Changed pin marker to chamfer.
    Changed fab outline to nominal dimension.
2018-01-27 added LED footprints for special opto-components (photodiodes/transistors, IR-LEDs)
2018-01-27 renamed several existing OptoDevice footprints to better match KLC-naming conventions and fixed some KLC-issues (added pin1-marker, non-rect pin1 ...)
2018-01-27 added a few non-existent LDR-footprints
2018-01-27 update SFH205 footprint (had wrong size)
2018-01-28 added datasheet-links to several footprints
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2018-01-28 Paste coverage on exposed pad changed to 60%. Add 0.05mm paste tolerance.
2018-01-28 Paste pads 0,05 mm tolerance.
2018-01-29 Added pin 1 marker
2018-01-29 Add sensor audio to the fp-lib-table
2018-01-29 fixed Relay_DPDT_Finder_30.22 according to datasheet
2018-01-29 Add LFCSP-24 footprint based on Analog Devices dimensions
2018-01-30 Fix linefeed for sd card footprint to fix issue #317.
2018-01-30 renamed XFL4020 to XxL since XAL, XEL etc all shares the same footprint
    added 4030, 4040 which are the same footprint but different height
2018-01-30 updated QFN footprint to newest KLC
2018-01-30 removed solder mask margin
2018-01-30 Remove pin numbers from paste pads
2018-01-30 Multiple changes
    Name changed to LFPAK33
    Refdes smaller
    Move silkscreen outline
    Solder mask oversize 0.05mm
    Paste mask changed
    Smaller pin 1 marker
2018-01-30 Remove pin number and copper from paste pins
2018-01-30 Add alternative package name, move silkscreen closer to part body
2018-01-30 Remove pin number from paste pad
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2018-01-31 Set pin number for thermal vias
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2018-01-31 Put courtyard on 0.01mm grid
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2018-02-02 Rename lowercase parameters to uppercase parameters inside footprints.
2018-02-02 Added new connector for RJ45 PCB mount plug
2018-02-02 Move SSOP-8_3.95x5.21x3.27mm_P1.27mm to the new Package_SO folder
2018-02-02 Add a "1" near pin 1
2018-02-02 Move silkscreen and courtyard to correct position, adjusted 0.01 mm
2018-02-02 Rename lowercase pin to Pin. Commit 1/2, temporary name.
    Changed references to 3D models from pin to Pin.
    Renaming filenames from pin to Pin.
2018-02-02 Rename lowercase pin to Pin. Commit 2/2, final name.
2018-02-02 fixed KBPC1 footprint to correct size 16.2x16.2mm on F.Fab
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2018-02-04 Shrink courtyard and silkscreen to match pad size & position
2018-02-06 Added Connector Amphenol 54601
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2018-02-06 Change footprint to match BXL file
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2018-02-06 Fix multiple problems Change Fab drawing (corners) Change fp name and 3D model name Change line width Add back EP solder paste openings Change silk screen drawings Improved description field Fix pad 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
2018-02-07 Set courtyard clearance to 1mm
2018-02-07 Fix footprint name and silkscreen offset Footprint name had size dimensions switched (x/y) The same for 3D model name (there is no actual model, so no problems with that) Silkscreen offset from expos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
2018-02-09 Added DIP-4 and DIP-8 with 8mm clearence, 2.54 pitch
2018-02-09 Use the -1SH footprint name syntax for shielded connectors
2018-02-10 New 8 mm clearence model
2018-02-11 Centered the foot print anchor
2018-02-11 Add units to pitch
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2018-02-14 Brand spanking new SMD Radial Capacitors
2018-02-16 Reduce pad size to 1x0.85mm
2018-02-16 Set origo at pin 1
2018-02-16 Fix pin numbering
2018-02-17 5-pin SAW filter 1.4x1.1mm
    https://www.mouser.com/ds/2/40/AVX_140127%20Connectivity-1158389.pdf
2018-02-17 Increase pad width to 1.6mm again
2018-02-17 Add SK6812 with correct pin numbering
2018-02-17 Forgot to unshrink the courtyard and silkscreen
2018-02-17 S-PWSON-N10 with 4EPFingers footprints added
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2018-02-18 Updated the foot print
2018-02-18 moved pin 1 marker
2018-02-19 added Wuerth_61400826021USB connector and fixed minor issues
    changed all "manf-mpn" to "manf_mpn"
    removed all generic footprints
2018-02-19 Package_SO: fix ssop-8.3.95x5.21x3.27mm_P1.27mm
    There are 2 pads with number '1'.
    One of that pair should be named as '8'.
2018-02-20 Add NCP4308 DFN footprints
2018-02-20 Added LED_Rectangular_W7.62mm_H4.55mm_P5.08mm_R3 Datasheet can be found at https://www.gme.cz/data/attachments/dsh.511-795.1.pdf
2018-02-20 Updated link to 3D model (according to KiCad 5 libraries)
2018-02-21 Added Footprint DFN-14 4.5x3mm Pitch 0.65mm with thermal vias.
2018-02-23 Fix pad position of DFN footprint
2018-02-23 Updated mark for pin #1 at silk layer
2018-02-25 SAW: add pin 1 mark to phab layer, rename
    Rename symbols to Filter_XXXX
2018-03-01 Changed landing pad size, larger keepout area
2018-03-02 Add missing footprints from I2C fix
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2018-03-04 LFCSP 3x3mm P0.5mm EP1.5x1.85mm
    Footprint required by
    http://www.analog.com/media/en/technical-documentation/data-sheets/ADL5542.pdf
2018-03-05 Change mtg hole pin names to "SH"
2018-03-05 Update and rename HDMI_A_Plug_Contact_Technology_HDMI-19APL2_Horizontal.kicad_mod to HDMI_A_Contact_Technology_HDMI-19APL2_Horizontal.kicad_mod
2018-03-05 Use circular pads for varistor footprints
    Commit 2e41670373493a62d1f8f3876b11526354db669e mistakenly changed the
    varistor symbols to use square pads for pin 1. This commit reverts that
    change, as varistors are non-polarized devices.
    Fixes #377.
2018-03-07 Rename MLP14D->WQFN-14, add a WQFN-16
    ON Semiconductor renamed Fairchild's MLP14D package to WQFN-14, and
    that's totally okay of them. This commit updates the name and
    documentation, and fixes up the footprint for modern KLC.
    This also adds the WQFN-16 footprint, needed for the FUSB307B.
2018-03-08 Fixes to new WQFN footprints
    Increase silkscreen clearance to 0.12 mm.
    Reverse refdes and footprint name.
    Remove mention of old footprint name from keywords.
    Fix extension of 3D model.
2018-03-10 Added WQFN 24 pin pacakge
2018-03-10 Switched model to wrl
2018-03-10 KiCad logo on copper and on solder mask. Height 5mm.
2018-03-11 added mounting to Micro-fit
2018-03-11 added MountingPins to CLIK-Mate
2018-03-11 added Mounting Pads to Panelmate
2018-03-11 added Mounting Pads to Picoblade
2018-03-11 added Mounting Pads to Pico-clasp
2018-03-11 added Mounting Pads to EZmate
2018-03-11 added Mounting Pads to Picolock
2018-03-11 added Mounting Pads to JST GH
2018-03-11 added Mounting Pads to JST AUH/ACH
2018-03-11 added Mounting Pads to JST LEA
2018-03-11 added Mounting Pads to JST PH
2018-03-11 added Mounting Pads to JST_SH
2018-03-11 added Mounting Pads to JST SUR
2018-03-11 added Mounting Pads to JST ZE
2018-03-11 added Mounting Pads to Hirose DF52
2018-03-11 added Mounting Pads to Hirose DF13C
2018-03-11 Shrink and centre F.Fab refdes for all neopixel footprints
2018-03-11 Update SMA_Amphenol_132289_EdgeMount.kicad_mod
    Add Missing Bottom Courtyard (issue #189)
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2018-03-13 Connector_Harwing: Generate M20-89 connectors
2018-03-13 Moved battery holder footprints from old repo
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2018-03-16 Add Atmel MCU QFN footprints
2018-03-19 Add Atmel MCU BGA footprints
2018-03-19 Update and rename TI_X2SON-4_1x1mm_P0.65mm.kicad_mod to Texas_X2SON-4_1x1mm_P0.65mm.kicad_mod
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2018-03-20 Varistor: Fix RV_Disc_D21.5mm_W6.1mm_P7.5mm
    Move RefDes on F.Fab to the center (KLC 3.0.11 F5.2).
2018-03-21 Changed pad length to 1.9mm
2018-03-22 Add Bourns MF-SM series fuses
2018-03-22 Fix silkscreen edges
2018-03-22 Fix footprint models
2018-03-22 Fix according to new footprint from ADI
2018-03-25 Increase courtyard distance to 1mm, add P0.4mm version
2018-03-26 Update and rename DIN41612_3B_2x10_Horizontal.kicad_mod to DIN41612_B3_2x10_Horizontal.kicad_mod
2018-03-26 Add F.Fab pin 1 mark to LFCSP-16
    I merged #367, then immediately noticed that the footprint had no pin 1
    mark on the F.Fab layer. D'oh! This fixes the problem by adding the
    pin 1 mark.
2018-03-27 Correct fab and silkscreen line widths
2018-03-27 Correct silkscreen clearance
2018-03-27 Fix WLP-4 pitch to be 0.4mm
2018-03-27 Add ALPS SKRK series button footprint
2018-03-27 Improved SKQG footprints
    Since there are two different types of ALPS SKQG switch (with and
    without stem) that require different 3D models, we need to have two
    different footprints. This commit makes that split.
    The outline has been cleaned up as well, after measuring the 3D model
    from ALPS for dimensions missing in the drawing. The keep-out zones
    have been added, and the courtyard has been made a bit tighter.
2018-03-27 Change silkscreen-fab clearance to 0.12mm
2018-03-28 Fix Bourns MF-SM fuses
2018-03-28 Copper width sized to 1.87. Moved copper pads to +/- 6.27mm
2018-03-28 Adjust silkscreen to 0.12mm clearance from fab
2018-03-28 Adds footprint for E18-MS1-PCB Zigbee module
2018-03-28 Adds footprint for TL3305 tactile switch.
    I have also created the 3D model for this switch. Will clean up and submit to `KiCad/kicad-packages3D` soon.
    Datasheet: https://www.e-switch.com/system/asset/product_line/data_sheet/213/TL3305.pdf
2018-03-28 Addresses SW_SPST_TL3305 footprint review comments
2018-03-29 Adds keep-out zone on the E18-MS1-PCB footprint
2018-03-30 Line up edge of pin 1 marker with pad clearance
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2018-03-31 Shorten DFN silk X to +-1.5mm
2018-03-31 Add diode symbol on fab layer
2018-04-01 Set clearance on vertical silk lines to 0.12mm
2018-04-02 Fix size to 0.83 and 0.86mm
2018-04-02 3M Textool 16-pin zero insertion force socket
    Datasheet: http://multimedia.3m.com/mws/media/494546O/3mtm-dip-sockets-100-2-54-mm-ts0365.pdf
    Based on existing footprint 3M_Textool_240-1288-00-0602J_2x20_P2.54mm
2018-04-04 Added more stuff to footprint description
2018-04-04 Added keywords for footprint
2018-04-04 Removed description from fab layer. Renamed file to TSOP-I-28_11.8x8mm_P0.55mm.
2018-04-04 Fixed pin 1 mark and courtyard clearance.
2018-04-04 Add Footprint for 10/100BASE-T magnetics by Pulse.
    Devices: H1100NL, H1101NL, H1102NL, H1121NL, H1183NL, H1199NL, HX1188NL, HX1198NL and H1302NL.
2018-04-04 Footprints for 2xAA battery holders from MPD.
    BC12AAPC:
    http://www.memoryprotectiondevices.com/datasheets/BC12AAPC-datasheet.pdf
    BC2AAPC:
    https://media.digikey.com/pdf/Data%20Sheets/Memory%20Protection%20PDFs/BC2AAPC.pdf
2018-04-05 Fix pad sizes for two terminal smd devices (issue #466)
    The wrong IPC tables have been used for devices >=0603_1605Metric
    For devices where the dimension S instead of T was given,
    Smax was used instead fo Smax(RMS).
2018-04-05 fixed Lumberg USB footprint
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2018-04-05 CW Industries GPTS203211B SPST Off-On Pushbutton
    http://switches-connectors-custom.cwind.com/Asset/GPTS203211BR2.pdf
2018-04-05 Fixed footprint filename and metadata
2018-04-06 fixes after review (added TO-220-4, TO-220F-4/11/15, several renames, removed old unused, ensured pin-number is part of standard-names, ...)
2018-04-06 removed horizontal TO-220F (found no ref to them), added a TO-220F-5 variant with different pin bending
2018-04-06 first footprint by footprint generator
2018-04-06 Incorporate feedback for SW_CW_GPTS203211B.
    * Decrease courtyard to 0.25 mm.
    * Add datasheet URL.
    * Move text closer to body.
2018-04-06 MPD 2xAA battery holders: Add datasheet URL to description.
2018-04-06 3M Textool ZIF socket: Add datasheet URL to description.
2018-04-07 several modifications after discussion (no more mentioning alternative names - like IPAK/I2PAK/SOT93... - in filename, added TO-3PD/TO-3P/TO-247 as separate footprints, removed one old version (TO-22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
2018-04-07 Add Omron A6S SMD DIP switches
    Datasheet: http://omronfs.omron.com/en_US/ecb/products/pdf/en-a6s.pdf
    Generator script PR: https://github.com/pointhi/kicad-footprint-generator/pull/121
2018-04-08 Add Molex 54132-5033 1x50 FFC/FPC connector
    Datasheet: https://www.molex.com/pdm_docs/sd/541325033_sd.pdf
2018-04-11 Reduced width of silkscreen lines.
2018-04-11 [E18-MS1-PCB] Addresses review comments
2018-04-12 Set both footprints to "Surface Mount".
    Also added datasheet and description.
2018-04-12 [E18-MS1-PCB] Fixes keepout text order and re-centers the part body
2018-04-12 [E18-MS1-PCB] Centers reference label on F.Fab
2018-04-13 removed Panasonic capacitors from PR
2018-04-14 Modified MSOP footprint to match datasheet more closely.
    Also added new DFN footprint.
2018-04-14 Fix naming of "Hopref" footprints.
    The RFM9XW modules are made by the same company that makes the RFM69HW
    modules. However, currently their footprints start with different
    manufacturer prefixes:
    1. First off, the name of the company is "hoperf", not "hopref".
    2. Secondly, the capitalization should be harmonized. The company's
    web site puts the name in all caps, so "HOPERF" seems like the way
    to go.
    3. Finally, the HOPERF-RFM69HW footprint uses a dash between the
    manufacturer name and part number, while Hopref_RFM9XW_SMD and
    Hopref_RFM9XW_THT use an underscore between the manufacturer name
    and part number. I can't find anything in the KLC about which to
    use, and existi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
2018-04-14 3-pin varient of 5MM horz LED
    Note: I am not able to create 3D images, so for this submission have
    left the 3D field blank.
2018-04-15 Tightened courtyards
2018-04-15 Add pin1 marker to silkscreen of RJHSE538X and RJHSE5380
2018-04-15 Fix pin numbering of RJHSE5380 and RJHSE538X
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2018-04-15 Revert "DTF13-12Px connector"
    This reverts commit 7f9e72b034e17c067be9420b72cc45a73dc6c136.
2018-04-16 Fix height of 16-pin Textool ZIF socket.
    Height should be 35.3 mm, not 33.0 mm.
2018-04-17 Packge_LGA: update LGA-16 footprint
2018-04-17 Connector_Harwin: Updated naming and keywords
2018-04-17 Connector_Harwin: Multiple fixes in M20 connector
2018-04-17 Connector_Harwin: Fill pin #1
2018-04-17 Corrected pin 9
2018-04-17 Revised package outline
    Closer matching to CAD drawings
2018-04-20 Use NPTH for Adafruit_HUZZAH_ESP8266_breakout_WithMountingHoles.
    I originally created this footprint with plated mounting holes.
    However, this confuses CvPCB, and it thinks the footprint has a
    different number of pins than the library symbol, so it doesn't show
    up unless you uncheck the "#" button in CvPCB.
2018-04-23 Add QFN-48-1EP_7x7mm_P0.5mm_EP5.6x5.6mm
    Needed for QFN48 STM32 microcontrollers.
2018-04-23 Add QFN-36-1EP_6x6mm_P0.5mm_EP4.1x4.1mm
    Needed for QFN36 STM32 microcontrollers.
2018-04-23 Add QFN-28_4x4mm_P0.5mm
    Needed for QFN28 STM32 microcontrollers.
2018-04-24 TSOP-5 should have pin numbers 1...5 as in the datasheet.
2018-04-24 The courtyard clearance was made 1.0mm of the BGA-672 and BGA-676 to meet the IPC-7351C requirements.
2018-04-24 Changed the lines width on layer F.Fab from 0.15mm to 0.1mm.
2018-04-24 Remove connector that is in different pull request
2018-04-24 1. Fix position of pins, 2,4 & 6 2. Increase courtyard clearance to 0.5 mm 3. Increase silkscreen line width to 0.12 mm
2018-04-24 1. footprint flipped 90deg CW so pin 1 is in the top left corner. 2. FAB layer the pin 1 indicator changed to a small triangle. 3. Courtyard changed to 13.5 x 16.5mm to show typical mating connector 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
2018-04-24 changed pin 1 indication fo F.Fab moved F.CrtYd to give correct clearance
2018-04-24 Adding script generated VQFP footprints withe measurements by microsemi
2018-04-24 Script generated PQFP footprints (landing pattern IPC, sizes microsemi)
2018-04-24 Fp naming to fit other footprint in this lib plus added 3d model settings
2018-04-24 Newly scripted TQFP footprints (landing pattern IPC, dimension microsemi)
2018-04-24 Add newly scripted PLCC footprints. (landing pattern IPC, dimension microsemi)
2018-04-24 Re added TEN20 footprint without pin 4 as suggested by @ratfink
2018-04-24 Added STM32 BGA packages
    Generated by the script at
    https://github.com/pointhi/kicad-footprint-generator/pull/126
    Datasheets can be found in
    https://github.com/KiCad/kicad-footprints/issues/374
2018-04-25 reduce pad size for 80 pin version plus remove some whitespaces from description and tag fields
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2018-04-25 Added STM32 WLCSP footprints
    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
2018-04-26 Updates to CSP footprints
2018-04-26 Added F.Fab pin 1 mark
2018-04-26 Add layout specifier to footprint name
2018-04-26 Fixes for Rene's comments
    * Adjusted the position of the RF shield outline
    * Added tiny keep-out zones for the RF sheild mounting holes (with the
    very brief text "No bare Cu" to keep the text as large as possible)
2018-04-26 Add script generated diode footprints for temp sensor (DO-34_SOD68)
2018-04-26 Add Sod-70 (Thinner but longer TO-92) for temp sensor
    [sod-70.fcstd]
2018-04-27 Vishay PowerPAK SC70-6L footprints
    - Single version - http://www.vishay.com/docs/70486/70486.pdf
    - Dual version - http://www.vishay.com/docs/70487/70487.pdf
    e.g. https://www.digikey.com/product-detail/en/vishay-siliconix/SIA453EDJ-T1-GE3/SIA453EDJ-T1-GE3CT-ND/4385553
2018-04-27 Change origin position of Y14 Relay
2018-04-27 Change reference setting of F.Fab for Y14 Relay
2018-04-27 Add line to F.CrtYd and F.Fab for Y14 Relay
2018-04-27 Change width and grid of lines on F.CrtYd of Y14 Relay
2018-04-27 Change first hole type as rectangle for Y14 Relay
2018-04-27 Assign 3d object to Y14 Relay
2018-04-27 Change position of text for Y14 Relay
2018-04-27 Add 5.08mm pitch version. Rename SOD-70 to include pitch
    [sod-70.fcstd, sod-70_P5.08mm.fcstd]
2018-04-27 Remove silkscreen overlapping pads for 5.08mm pitch version
    [sod-70_P5.08mm.fcstd]
2018-04-27 Update lines for Y14 Relay
2018-04-27 Set text position closer to line for Y14 Relay
2018-04-27 Fix hole diameter to align it with KLC
2018-04-28 Fit outline to F.Fab for Y14 Relay
2018-04-28 Add coil image on F.Silks for Y14 Relay
2018-04-28 Update CrtYd as 0.1mm grid for Y14 Relay
2018-04-28 Remove step file from 3D model reference for Y14 Relay
2018-04-28 Rename file for Relay_SPDT_HsinDa_Y14
2018-04-28 Update F.Silks line position for Y14 Relay
2018-04-28 Footprints now scripted, removed toe fillet, new naming convention
    New naming convention includes "Border" to distinguash it better from
    "Grid" LGA components.
    LGA components in contrast to DFN/QFN do not form a toe fillet.
    This means the pads where previosly too long.
2018-04-28 Cut corner of edge pads for small pitch version to increase clearance
2018-04-28 Add missing footprint for Bosch BME680
2018-04-28 Fix footprint names in Sensor_Current lib (Pitch -> P)
2018-04-28 Update for new ipc values, fix wrong footprint
2018-04-29 Fix courtyard clearance for Diodes THT footprints
2018-04-29 Fix courtyard for scripted capacitor tht footprints
2018-04-29 Fix courtyard for scripted resistor footprints
2018-04-29 Fix courtyard clearance for inductor (chocke) footprints
2018-04-29 Fix pin pitch for vishay_IHA-xxx. Fix 3d scaling
2018-04-29 Fixes for single
    - Increased courtyard to 0.25mm
    - Removed numbering from PASTE pads
    - Renamed 3D model
2018-05-01 Silkscreen fixes
2018-05-01 Final silkscreen fixes
2018-05-01 Correct silkscreen position. Increase paste coverage for MLF. Remove DFN references from MLF.
2018-05-01 Remove library name from footprint
2018-05-02 Added Bourns SDR1806 series footprint
2018-05-02 Offset silkscreen slightly, added metadata
2018-05-03 Split samtec lib to reduce number of footprints in the lib.
    Split away the HLE series connectors into two new libs
    split up with respect to mounting technology (THT vs SMD)
2018-05-03 Split GMSTB series connectors from normal MSTB series.
2018-05-03 Fix 3d path for freshly separated GMSTB footprints
2018-05-03 Split away the high voltage MC connectors (5.08mm pitch) versions.
2018-05-03 Fix 3d path for separated high voltage MC connectors
2018-05-03 Update readme files for phoenix connector libs. (reflect new lib organization)
2018-05-04 Footprint addition to support DRV887x devices
    Modification of Package_SO:HTSOP-8-1EP_3.9x4.9mm_P1.27mm, this package
    adjusted the thermal pad and pins to match the TI specifications
2018-05-04 Added footprint Infineon PG-TSDSO-14-22 for the BTS7004-1EPP Profet
2018-05-04 [BC2003] Adds footprint for BC2003 1xCR2032 battery holder
2018-05-04 Add Polymer Protected Zener Diode from Littelfuse. LS series
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2018-05-04 Add FCC connector 68611214422 from Wurth Elektronik
2018-05-04 Center the footprint. Delete ',' in metadata
2018-05-05 Add script generated dfn-6-1ep footprint (#539)
    Another footprint for KiCad/kicad-symbols#520, needed for Si7020-A20 in
    Sensor_Humidity.lib (KiCad/kicad-symbols#558). Scripted based on IPC
    guidelines.
    Script PR: pointhi/kicad-footprint-generator#125
2018-05-05 Fixed pin numbering in Connector_Wire and made pin 1 rectangular per KLC
2018-05-05 Rename footprint. Name mounting pads as MP
2018-05-05 Changed Connector_Wire naming to match pin headers
2018-05-05 Add pin number to mounting pads for Hirose FH12 series FFC connectors
2018-05-05 Add pin number to mounting pads for Molex 502250 series FFC connectors
2018-05-05 Add pin number to mounting pads for TE 84952-84953 series FFC connectors
2018-05-05 Add pin number to mounting pads for non scripted FFC connectors
2018-05-06 Moved pin 1 to origin, fixed pitch naming and consistency
2018-05-06 Better wording for the description of samtec hle connector libs
2018-05-06 Updated courtyard to 0.25mm spacing, fixed body length
2018-05-06 Improve quality of X2SON-4 package (#521)
    The Texas_X2SON-4_1x1mm_P0.65mm footprint was drawn with KiCad 4 pads,
    and not precisely following the datasheet. This updates it to use KiCad
    5 custom pads and to exactly match the datasheet's drawing, using KiCad
    StepUp to create the new footprint.
    [X2SON-4_1x1mm_P0.65mm.fcstd]
2018-05-06 [CSM3X] Adds footprint for ECS CSM-3X crystal
2018-05-06 Hirose conn BM24 series. 40 pin. Receptacle and header (#556)
2018-05-07 [CNCTech_1001-011-01101] Adds USB connector footprint
2018-05-07 Test point footprints had NPTH pads instead of normal THT (plated) pads. See #569
2018-05-07 Added new shunt footprint: WSK2512 for 0.005 to 0.2 Ohms
2018-05-07 Update all staggered to-sot footprint names to new naming convention
2018-05-07 On-Shore Technology USB-B1HSxx receptacle
    http://www.on-shore.com/wp-content/uploads/2015/09/usb-b1hsxx.pdf
    This footprint is meant to be used with the existing `USB_B` symbol.
2018-05-07 Add NKK GW12LJP footprint (#534)
    Add footprint for NKK GW12LJPxx SPDT illuminated rocker switch
    Datasheet: http://www.nkkswitches.com/pdf/gwillum.pdf
2018-05-07 Add E-Switch FS5700DP footprint (#564)
    Add footprint for E-Switch FS5700DP DPDT pushbutton foot switch.
    Datasheet:
    https://www.e-switch.com/system/asset/product_line/data_sheet/226/FS5700.pdf
2018-05-08 Added new staggered TO-220-11 footprint (#571)
    Modified staggered TO-220-11 Tab down footprint with y pitch 5.08mm
    (Example part that uses this footprint: LMD18200)
2018-05-08 added Alps EC11 and EC12 rotary encoder footprints (#288)
2018-05-08 Minor footprint fixes (3D models and footprint name) (#430)
    * Add 3D model reference
    * Rename HTSOP-8-1EP_3.9x4.9mm_P1.27mm* to reflect the fact that they are manufacturer specific
    * Change them to comply to the currently suggested pad stackup for exposed pads and the manufacturer suggestions.
2018-05-08 Added Dinkle scripted footprints for DT-55 Terminal Block (#395)
2018-05-09 Add 0ZRE series fuse from Bel Fuse
2018-05-10 Bourns MF-RG series PTC fuses
    http://www.bourns.com/docs/Product-Datasheets/mfrg.pdf
2018-05-13 Bourns MF-RHT series PTC fuses
    http://www.bourns.com/docs/product-datasheets/mfrht.pdf
2018-05-14 Add Cypress-specific QFN-56 footprint.
    For CY7C68013A/14A.
2018-05-14 Fix shrunken paste on Cypress QFN footprint.
2018-05-15 Add footprint of SIMCom900
2018-05-15 new footprint Würth 7499010121A ethrenet magjack
2018-05-16 Add chamfer to edge pads fo LGA 14 2.5x3mm
    This allows for a larger pad to pad clearance between the corner
    pads. But with the downside that this fp is now incompatible
    with kicad 4.
2018-05-16 Add Coilcraft CST/CST2010 footprints
2018-05-16 Manualy removed 'Package_SO:' prefix
    I have not fogured out what is causing the lib prefix to be added to my
    footprint submissions.
    Am manualy editing them out.
2018-05-17 USB-B1HSxx: Incorporate feedback from PR.
    * Move ref and value labels outside courtyard.
    * Move silk outline out by 0.01mm.
    * Change style of pin 1 indicator on silk.
2018-05-18 [E73-2G4M04S-52832] Adds footprint for E73-2G4M04S-52832 BLE5 module
2018-05-18 [E73-2G4M04S] Removes -52832 from footprint name
2018-05-21 Thermal via version of previosly added qfn footprints
    - This adds the thermal via version of some already added qfn footprints
    - These are script generated and use custom pads (chamfered rectangles)
    for increased paste coverage while still avoiding paste over vias.
    (At least where texas did not suggest something else)
2018-05-21 PJ-063AH: Rename mounting pin from "3" to "MP".
    This reflects the changes in the schematic symbol discussed here:
    https://github.com/KiCad/kicad-symbols/pull/591#issuecomment-390749465
2018-05-22 Change pin 1 marker to conform with IPC
2018-05-22 Further fixes
    - Removed explicit solder margin
    - Added extra description
2018-05-22 Modified footprint as requested
2018-05-22 CUI PJ-063AH: Incorporate feedback from PR.
    * Add voltage to description.
    * Update diameter in description.
    * Update datasheet link.
    * Move silk outline outward by 0.01mm.
2018-05-22 Connector_Harwin: Change from "top entry" to "horizontal" in keywords
2018-05-22 Connector_Harwin: Fix back pin lenght
2018-05-23 Connector_Harwin: Fix silkscreen offset, refdes positioning, courtyard and vertical positioning
2018-05-23 Renaming footprint to R_Vishay_WKS2512_6332Metric_T2.66mm Changed Pin order in to 1-2 for the standard non-kelvin connections, pin 3-4 for the Kelvin pins.
2018-05-23 Added new footprint: Choke_EPCOS_B82722A2302N001-22.7x22.3x13.3mm Mapped onto symbol: EMI_Filter_CMode
2018-05-23 SD_TE_2041021: Use non-numeric pin numbers for CD, WP, and SH.
    This is necessary because of the change being made to the symbol:
    https://github.com/KiCad/kicad-symbols/pull/592
2018-05-24 Update PTS810 to current KLC
    * Increased the silkscreen-to-copper clearance to the silkscreen line
    width.
    * Increased thickness of F.Fab RefDes to 15% of text size.
2018-05-24 Moved courtyard lines to 0.01mm grid
2018-05-24 Connector_Harwin: Pin 1 is now marked with a pad in SilkS layer, fix courtyard and center the component
2018-05-24 Added new Footprint LEM-LTSR-NP. Can be used with symbol LEM_NTSR6-NP, LEM_NTSR15-NP and LEM_NTSR25-NP
2018-05-24 Add footprint for ublox SAM-M8Q. One is for oven soldering and another for hand solder.
2018-05-25 Add TE 282834 terminal blocks
    Generated using the scripts at
    https://github.com/pointhi/kicad-footprint-generator/pull/131
    Based on the datasheet
    http://www.te.com/commerce/DocumentDelivery/DDEController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
2018-05-25 Add C&K KXT3 series SMD switch (#601)
    Datasheet: https://www.ckswitches.com/media/1465/kxt3.pdf
2018-05-25 PJ-063AH: Change outer diameter to 5.5mm
2018-05-25 Increase SOT-563 row pitch to 1.5 mm.
2018-05-25 Add TI GAN FET footprints (#447)
    Add Texas Instruments MOF0009A and RWH0032A footprints.
    Datasheets:
    * http://www.ti.com/lit/ds/symlink/lmg5200.pdf (MOF...)
    * http://www.ti.com/lit/ds/snosd10c/snosd10c.pdf (RWH...)
2018-05-26 Avoid paste over vias for Texas 64 pin qfn
2018-05-26 Add Texas_S-PWQFN-N20 footprint (#604)
    Added the Texas_S-PWQFN-N20 to Package_DFN_QFN.pretty
    Datasheet: http://www.ti.com/lit/ds/symlink/tps22993.pdf
2018-05-26 Add ESP-07 footprint
    802.11 b/g/n Wi-Fi Module, similar to ESP-12E.
    http://wiki.ai-thinker.com/_media/esp8266/docs/a007ps01a2_esp-07_product_specification_v1.2.pdf
    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
2018-05-26 Update PowerDI3333-8 for current KLC
    * Recreated pad 5 as a single custom pad
    * Increased pad 5 paste coverage to 72%
    * Reduced size of pin-1 bevel to 25% of body length and width
    * Improved silkscreen outline
    * Moved text fields closer to body
2018-05-27 Add On Semi Case 511AT-01
2018-05-28 RJ45 7499010121A: integrate evanshultz feedback
    - moved Silk screen closer to housing, broke lines where necessary.
    - renamed to follow KLC guidelines
    - moved keywords to description
    - fixed courtyard (still excluding mounting holes)
2018-05-28 Updated footprint according to Travis CI build
2018-05-28 Add footprint of SIMCom800C
2018-05-29 Add footprint SM-22 for MACOM Transformer (#585)
    Datasheet: https://cdn.macom.com/datasheets/ETC1-1-13.pdf
2018-05-30 Added LQFP-48-1EP_7x7mm_EP3.7x3.7mm (#614)
    See http://www.analog.com/media/en/technical-documentation/data-sheets/LTC7810.pdf
    Modified version of the original LQFP-48_7x7mm footprint
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2018-05-31 Fix paste pad to have no pin number
2018-06-02 Rename SOT669 to LFPAK56 (#482)
    Following the naming decided on for these in #313, this footprint should
    be called LFPAK56. This commit makes that name change.
2018-06-04 Shrink mask opening to 6.2mm, other cleanup.
2018-06-04 Expand mask from 6.2 to 6.22mm.
2018-06-04 Add footprint for microSIM card from JAE
2018-06-04 Connector_Harwin: Fix footprint centering
2018-06-04 Fix pin numbering on a QFN-32
    I mistakenly merged #518 with the pin numbering of
    QFN-32-1EP_5x5mm_P0.5mm_EP3.6x3.6mm badly broken. This fixes it.
2018-06-04 Add (reanimate) Amphenol 54602-x08 (#623)
    @thomasonw mentioned at #379 that some generic footprint was for a
    specific component. Indeed, it appears RJ45_8 was rather similar to the
    mentioned part (which could use a wildcard for plating type), but the
    footprint was a bit old and had some non-orthogonal lines. This commit
    fixes it up and adds it back.
2018-06-05 Add 18-pin variant of SSOP used by Toshiba.
    This is a slight modification of the existing SSOP-20 footprint, with
    only two pins removed and symmetry restored.
    Reference is the TBD62083A datasheet at
    https://toshiba.semicon-storage.com/info/docget.jsp?did=29893
    The linked part is mostly equivalent and pin-compatible to an ULN2804A
    darlington array, so its schematic symbol can be used.
2018-06-06 Changed the footprint back to match the default shunt symbol (and also the new US shunt symbol).
2018-06-06 - [X] Is there a better datasheet for this footprint? It seems that many pages at https://en.tdk.eu/inf/30/db/ind_2008/b82722a_j.pdf with tables or bullet lists are missing info. --> Yes, in some way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
    - [X] How did you draw this? The datasheet doesn't exactly show the curves so I'm wondering how close it actually matches the real part. --> I've drawn the symbol online in 3D at onshape.com(I do have FreeCad now so next time I will use that and try also to create KiCad 3D shape).
    The curves are pragmatically determined as they have to intersect at the corners.
    The horizon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
2018-06-06 Renamed footprint to LEM_LTSR-NP see https://github.com/KiCad/kicad-symbols/pull/615 Updated footprint due to fit-test on PCB test board. Enlarged holes and set them all to circular shape. Re-test fo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
2018-06-08 Add Pulse PA200xNL footprints
2018-06-10 The modifications made is: - Silk lines is 0.12mm, - Pin 1 is now on the top left, - Removed Silk under parts, - Moved inner square to F.Fab layer, - Added stencil design only in ublox_SAM-M8Q, - %R 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
2018-06-10 Add more silkscreen lines where possible
    There's enough space between the pads on this footprint that it seems
    reasonable to put silkscreen lines between them to have a more complete
    body outline. This commit does that.
2018-06-11 SO-4 footprints - silk too close to pads
    * SO-4_4.4x2.3mm_P1.27mm
    * SO-4_4.4x3.6mm_P2.54mm
    * SO-4_7.6x3.6mm_P2.54mm
    * SO-5_4.4x3.6mm_P1.27mm
    In the SO-4 footprints, the silkscreen was within 0.05 mm of the
    pads. KLC guidelines are 0.2mm or more.
    This means that the silk might be removed by the board manufacturer, and
    if this happens, it will remove the entire pin-1 marker line from the
    physical PCB.
    This moves the silk in these footprints to be 0.2mm or more from pads.
2018-06-11 Updated Footprint contact holes after fit test on test PCB.
2018-06-11 Updated hole sizes after 3D checking.A 3D model is added to the 3D lib.
2018-06-11 Add new qfn-1ep footprints
    Previosly existing footprints did not fit the symbols who used them.
    They had the wrong size for the exposed pads and also a
    questionable pad layout.
2018-06-11 Rename lib to TerminalBlock_TE-Connectivity
    Matching the naming for our TE connector lib.
2018-06-11 Reduce pad size to 2.1 mm
2018-06-11 Increase silkscreen offset
    Now it's 0.12 mm instead of 0.06 mm, which we generally prefer.
2018-06-12 Fix SSOP-18 description and remove PSOP-18 in favour of SOIC-18W_7.5x11.6mm_P1.27mm
2018-06-13 Small devices can have smaller silk clearance
2018-06-13 Closer fitting silkscreen for polarized parts
    Plarized parts with wider body than pads have now a closer fitting
    silkscreen.
2018-06-19 Scripted terminal blocks used size 0 for NPTH pads
    - NPTH pads need to have the pad size set equal to the drill size.
    - Removed pin number from npth pads
    - Includes other inprovments of the footprint-generator-script made
    since the last export (Example corrected rounding of angle fields)
2018-06-19 PLCC has pin 1 in the middle of the top row not at the corner
2018-06-20 Fix PLCC 32 (original had wrong pin layout)
2018-06-21 Fix my mistake with ep sizes with regards to texas mcu footprints
2018-06-21 Set proper solder mask margin to 1nm
2018-06-21 - [X] The dimensions are close enough for me, then. Thanks for clarifying. It's awfully annoying that they don't give all necessary dimensions, but the tolerances of ISO 2768-C would indicate at leas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
    --> I increased the width and height by 2 times 0.5mm.
    -->The holes are increased to 1.3mm and the pads to 2.6mm.
    - [X] Courtyard cannot be curved because of issues with unclosed shapes.
    - [X ] Fab lines are actual size and silk lines are outside the part body.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
2018-06-21 Updated courtyard to be at least 0.25mm away from copper. Enlarged silkscreen to be 0.11mm larger than the F.Fab.
2018-06-22 Added footprint for Bourns SRR1210A
2018-06-23 Fix footprints of RECOM DC/DC converters, where the 'bulge' was toward the back while it should have been to the front.
2018-06-24 Added manufacturer name prefix to TWE-L-WX
    * Added prefix MonoWireless_
    * Added Pin-1 designator line
    * Changed thickness of silkscreen lines
    * Changed length of bevel next to pin-1 in fabrication layers
2018-06-24 Fixup some SMA footprints (#625)
    Replaces the old generic SMA connector footprints with specific ones.
2018-06-24 2 terminal smd chip: Pad equations where outdated
    - New industry standards have updated not only the fillet sizes but also
    the way how tolerances are respected.
    - For devices that directly give the lead to lead spacing no complicated
    calculations are necessary. (was wrong previously)
2018-06-24 Replace PR #453: add Texas_S-PVQFN-N20_EP2.4x2.4mm
    - This footprint is script generated
2018-06-25 added one more missing footprint
2018-06-25 Add 121-ball 0.8mm pitch BGA footprint.
    Based on Lattice csBGA package.
2018-06-25 Add pin 1 mark on fab and silk layers
2018-06-25 Using IPC Level B, our 0.7mm square pins are 0.99mm diagonal. We need drill holes 0.2mm bigger or 1.2mm. And the pads are then 1.75mm. Your slightly larger drill holes will allow the part to slide ar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
    The part is now 1mm taller than the max in the datasheet, but the width is ab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
2018-06-25 Remake the connector now is: * Connector is centered * F.CrtYd have 1.2mm from F.Fab (0.5 + 0.7 of note 1)
2018-06-25 Scripted version of #630 (QFN-64-1EP_9x9mm_EP7.5x7.5mm)
2018-06-26 Add Panasonic GaN FET and Driver footprints (#652)
2018-06-26 Add/update LEM footprints (#620)
    - LEM HO has high/low current versions (8..25A vs 40..150A) The original footprints seemed to suggest that there is only one version. (Adds new footprint for high current and SMT version)
    - Fix dimensions for LEM-HTFS
    - LEM-HX* rename to fit the style of all other LEM footprints. Fix dimensions.
    - LEM_LA25-P naming to allow for others in the series. Fix dimensions
    - LEM_LV25-P fix dimensions
2018-06-27 Replace some QFN (12, 16 and 20 pin) with scripted ones
    - This replaces the qfn-12, qfn-16 and qfn-20 footprints that had an
    easily findable datasheet attached with script generated footprints.
    - It adds thermal via versions of these footprints.
2018-06-28 Fix some further mistakes for two terminal smd
    - Fuse 2920: terminal length was entered as terminal spacing (Resulted
    in too little pad to pad spacing)
    - Resitor 1218: body width max was 1mm too large
    - 2816: Increased tolerance range for terminal length to fit more
    devices.
    - Tantal 3528: wrong tolerance range for terminal length
    - Tantal 3216 and 6032-28 had wrong tolerance ranges but their effect is
    hidden by rounding (meaning no change in the footprint)
2018-06-29 Better fitting dimensions for 0805
    Fix for #711 (reported by @stambaughw
    Originally the dimensions for 0805 where taken from IPC-SM-782. These
    measurements seem to no longer fit the range of parts available right
    now. An arbitrary selection of 15 different parts was used to determina
    a better fitting footprint.
    The research can be found under https://docs.google.com/spreadsheets/d/1BsfQQcO9C6DZCsRaXUlFlo91Tg2WpOkGARC1WS5S8t0/edit?usp=sharing
2018-07-02 Add WLCSP-20_2.434x1.934mm_Layout5x4_P0.4mm footprint (#715)
    Add a footprint for Atmel/Microchip SAMD WLCSP-20 package.
    Used BGA/CSP script from pointhi/kicad-footprint-generator to generate
    footprint.
2018-07-02 Hello Evan,
    - [X] While the part is electrically fine using the EMI_Filter_CommonMode symbol (windings from pins 1-2 and 3-4), can you adjust your pin number locations to match the datasheet? Putting pin 1 at lower left will make this a bit more clear and avoid any questions later.
    - [X] Place the silk ref des outside the part body. You can move the fab value inside the part body, if you like, since this part is big enough to hold it inside.
    - [X] The horizontal courtyard lines need just a small tweak. The horizontal (top and bottom) fab lines have X locations of -1.5mm and 14mm. The courtyard should therefore be -1.75mm and 14.25mm, but yours are just a bit small. Can you push those out jus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
2018-07-03 Added MMCX_Molex_73415-1471_Vertical footprint
    corrected Silkscreen to comply with clearance
2018-07-05 Create Sensor_Voltage for LEM LV 25-P (#714)
    Move the footprint for LEM LV25-P to a new library Sensor_Voltage, as
    decided in #694.
    Fixed a typo and improved Sensor_Current description in fp-lib-table.
2018-07-05 Use custom pads for jumper footprints (#716)
    In KiCad 4 there were no polygon pads which resulted in some overlapping
    pad constructs. This is no longer required, as well as the old system
    causes some nasty problems like duplication of pin numbers and
    unconnected warnings. This PR solves the issue for the jumpers by
    converting the pads to custom shaped pads as appropriate.
2018-07-05 RF_Module: Added a footprint for RF modules IQRF TR-x2DA (#452)
    Added a footprint for IQRF TR-x2DA in the connector IQRF KON-SIM-01.
2018-07-05 Add missing MSP430 footprints (#718)
2018-07-06 Add wuerth electronics barrel jack connector footprint (#636)
2018-07-06 Made silk consistent 0.12mm, moved refdes and value.
2018-07-06 - [X] Silk needs to be offset from fab lines by 0.11mm as I mentioned at #597 (comment). That will make the silk be outside the part body.
    I see the problem, I only added 1 time the 0.11mm....
    Updated the drawing, this is the original (F.FAB):
    ![image](https://user-images.githubusercontent.com/15064336/42368428-4af9c222-8107-11e8-8433-832a05224c2d.png)
    And 0.11mm larger for F.SilkS:
    ![image](https://user-images.githubusercontent.com/15064336/42368461-624e2dfa-8107-11e8-96d8-b2d9ec42f095.png)
    resulting in:
    ![image](https://user-images.githubusercontent.com/15064336/42369139-536ec9d2-8109-11e8-8496-f231a6d339c2.png)
    - [X] All symbols in Device.lib are generic so the pinout can vary or t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
2018-07-06 Fixed mounting hole size in Arduino Uno footprints
    Issue #590 pointed out that it was wrong before. I looked at the actual
    Eagle source (from https://store.arduino.cc/arduino-uno-rev3), and found
    that the correct diameter is 3.2 mm. This fixes the hole sizes.
2018-07-08 updated silkscreen to match pad size
2018-07-09 moved silkscreen to not interfere with Solder Mask Clearance
2018-07-10 Fix Cypress QFN-56 footprint module name syntax.
2018-07-11 Add 1206 reverse mount LED
2018-07-14 Revert "Add 18-pin variant of SSOP used by Toshiba (fixes #631)" (#739)
2018-07-15 Diode and LED handsolder where missing pad size increase
    This was discovered in https://github.com/KiCad/kicad-footprints/pull/743#issuecomment-405089576
2018-07-16 Widen the NPTH a little, so it fits square lenses too
2018-07-16 Add hole dimensions to footprint name
2018-07-16 Update of ST HLGA-10 footprint with new calculation
    The original scripts did not support the way ST dimensions its package.
    This was mentioned in #732. The new script now supports it and gives
    better results.
2018-07-16 Add Inolux IN-PI554FCH footprint
    Started from LED_WS2812B_PLCC4_5.0x5.0mm_P3.2mm
    but mark indicates pin 1 in this case whereas it
    indicates pin 3 on the WS2812B.
2018-07-16 Scripted versions for QFN 20 and QFN 24 footprints
2018-07-17 QFN-28-1EP_4x5mm had the wrong ep size.
    The symbols who used this single footprint did require a different EP
    size.
2018-07-17 Scripted version of qfn-28 footprints
2018-07-17 Corrected footprint for Atmega-48-MHN and Atiny-48-MHN
    The original footprint had the wrong EP size. (Was taken from an
    unrelated application note)
2018-07-17 Fixed stuff found by @jcyrax
    - Wrong pitch for QFN-20-1EP_4x4mm_P0.65mm_EP2.5x2.5mm (should be 0.5mm
    pitch)
    - Wrong documentation link in QFN-20-1EP_4x5mm_P0.5mm_EP2.65x3.65mm
2018-07-17 qfn 32 pin footprint for microchip (atmel) mcus
2018-07-17 Fixes as proposed by @jcyrax
    - QFN-20-1EP_4x4mm_P0.5mm_EP2.5x2.5mm corrected lead width range
    - QFN-20-1EP_5x5mm_P0.65mm_EP3.35x3.35mm corrected datasheet link
    - QFN-24-1EP_3x3mm_P0.4mm_EP1.75x1.6mm corrected datasheet link
    - QFN-24-1EP_3x4mm_P0.4mm_EP1.65x2.65mm corrected datasheet link
    - QFN-24-1EP_4x4mm_P0.5mm_EP2.7x2.7mm corrected lead width range
2018-07-17 QFN-32-1EP for NXP LCP111x (correct ep size)
    original ep size was 5.46mm. Correct size is 4.7mm nominal (or at most
    4.85mm)
2018-07-19 Button_Switch_THT: Add EG1271 switch from E-Switch
2018-07-21 Improve Inolux IN-PI554FCH LED footprint
    - Pin 1 mark on F.Fab corrected. This symbol was derived from WS2812B and
    that LED has a mark on pin 3 for who knows what reason! Now correctly
    indicating pin 1.
    - Text "1" near pin 1 on silkscreen removed. Since this Inolux LED has a
    "sane" marking (that is, pin 1 marked), it is not necessary to reiterate
    which pin is pin 1.
2018-07-22 Inolux IN-PI554FCH: improve silkscreen
    It had too much clearance
2018-07-22 Removing orphaned QFN-44 with 5.4x5.4mm EP
    This footprint is orphaned. The Atmel MCU symbols that referenced it
    had the same dimensioned package drawing as other similar parts that
    had a different footprint assigned.
    Two referenced one with EP set to maximum "slug" dimension whereas
    the vast majority used nominal "slug" dimensions.
    (The removed footprint is the one for maximum dimensions)
2018-07-23 Add 3.81mm lead spacing tht diode footprints (#766)
2018-07-23 Inolux IN-PI554FCH: improve F.Fab
    Cut corner as suggested by @Misca1234
2018-07-23 Add scripted WDFN-12-1ep, 3x3mm footprint (replace #643)
2018-07-24 Update script generated QFP
    - Use new formulas from current standard (correct min/max RMS
    calculation)
    - Use rounded rectangle pads
2018-07-24 Scripted version of LQFP-48-1EP_7x7mm (3.6x3.6mm ep size)
2018-07-24 Add scripted footprints for TMC2100 (replace #666)
2018-07-24 Fix manufacturer part number for Samtec HLE Connectors
    The part number includes the number of pins per row. Not the overall
    number of pins. This fixes #776
2018-07-24 Adding FBGA-78_7.5x11mm_Layout2x3x13_P0.8mm (#760)
    Used by for example H5AN8G8NAFR-UHC
2018-07-24 Converter_ACDC: Fix IRM-02 SMD footprint (#750)
    * Fix footprint dimensions
2018-07-24 TerminalBlock: Fix pin 1 marking in Wuerth 691311400102
2018-07-25 Add Relay_DPDT_Finder_96.12 (#773)
    Replacement for #210
2018-07-25 TerminalBlock: Rename 691311400102 footprint to use U-umlaut in Wüerth
2018-07-26 Adding missing 50 pins per row HLE connectors
2018-07-27 Move InvenSense QFN footprints to Sensor_Motion
    - These are highly specialized footprints for motion sensors
    - Include top copper keepout as suggested in their app note
    - Second version with removed solder mask to ensure even more clearance
2018-07-27 Esp32 wroom 02 and 32 (#767)
2018-07-28 RF_Module: Added a footprint for RF modules IQRF TR-x2D and IQRF TR-x2DC (#733)
    Added a footprint for IQRF TR-x2D and IQRF TR-x2DC in the connector IQRF KON-SIM-01.
2018-07-28 created footprint for connector GB042-34S-H10 (#708)
2018-07-30 Ublox gps (#727)
    Added footprint for ublox max, neo, leo, gps module
    Each footprint is compatible 6/7/8 generation
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2018-08-01 add scripted WLCSP-56_3.170x3.444mm_Layout7x8_P0.4mm (#648)
2018-08-02 added 256-ball caBGA footprint for iCE40-HX8K-CT256
    according to Lattice PCB Layout Recommendations for BGA Packages (March
    2017; Technical Note TN1074) page 4 and Package Diagrams (November 2017)
    page 82
2018-08-02 added TE AMPSEAL 1-776087-x 3Rows 23 P0.4mm Horizontal
2018-08-05 Fix pin numbers of DIN connectors to fit symbols
    fixes issue #802
2018-08-07 added variant for HandSolder (using ThermalVias to solder EP through board - tested works!)
2018-08-11 Add QingPu WQP-PJ398SM aka Thonkiconn (#807)
    QingPu 3.5 mm vertical audio jacks. Commonly used for Eurorack synth modules. Popularly referred to as Thonkiconn (https://www.thonk.co.uk/shop/thonkiconn/).
    For symbol Connector:AudioJack2_Ground_Switch
2018-08-12 Top tented version of qfn-56 footprint for cypress
    Cypress suggests the use of top tented vias in the exposed pad.
    Hand modified the current generic footprint such that it uses this
    tenting as an example of how it can be achieved.
2018-08-14 Texas VQFN RHL 20 pin with thermal vias (#701)
2018-08-15 Fixing RECOM footprints, round 2.
    These files were regenerated with these changes to the generator:
    https://github.com/pointhi/kicad-footprint-generator/pull/141.
2018-08-15 Remove footprint that was a duplicate of RECOM_R-78HB-0.5.
2018-08-15 Added Adafruit SSD1306 display with and without mounting holes (#388)
2018-08-15 move Mini-Circuits CDxxx footprints to Package_SO (#594)
    they are not only used for transformers, but are a rather generic
    footprint used by the manufacturer
2018-08-16 Remove ESP32-WROOM-32D (#795)
    Its footprint is identical to ESP32-WROOM-32 so there is
    no point in maintaining two footprints.
    Also, this way, ESP32-WROOM-32D can be an alias of
    ESP32-WROOM-32 in the schematic symbols.
2018-08-17 Rework 5mm THT RGB LED footprint (#762)
    * Add versions with larger pad sizes for easier soldering
    * Add RGB suffix to fit other similar footpirnts
    * Add RGB to the tag field
2018-08-18 JST connectors: Use roundrect for pin 1 + small fixes
    - Pad 1 is now a rounded rectangle for JST connectors (except ZE
    vertical which uses a chamfered pad to reach the required clearance)
    - Angle field in arcs is does not unecessarly include zeros after the
    decimal point
    - Use circular instead of oval pads where the x and y size are equal.
2018-08-18 QFN-28_4x4 use rounded chamfered pad
    The script is now capable of creating rounded chamfered pads (special
    case of polygon pads that can be easily converted to have rounded
    corners)
2018-08-18 Hirose connectors: Use roundrect for pin 1
    Pad 1 is now a rounded rectangle for THT Hirose connectors
2018-08-18 Connector JAE (LY20): differentiate pin 1 (round rect)
    The old jae generators did not create a different pad shape for pad 1.
    This pull request changes pad 1 to be rounded rectangle.
    It also changes the silk outline such that it has the correct clearance
    to pad 1.
2018-08-18 Connector Molex THT: Pad 1 rounded rectangle + fixes
    - Pad 1 is now a rounded rectangle instead of rectangle
    - Molex nano fit now uses a chamfered pad for <= 3 pins per row to
    inctrease clearance to the NPTH
    - Some minor fixes to silk screens (fixes to mirror operator took affect
    after reexporting)
2018-08-18 Connector Phoenix: Use roundrect for pin 1
    For some reason the silk screen of the connectors also changed (As far
    as i can tell the silk to fab clearance seems to have changed or
    rounding is different. I can not remember changing that in the scripts.)
2018-08-18 Connector TE: Convert to roundrect for pin 1
2018-08-18 Connector Wago: Convert to rounded rectangle for pad 1
2018-08-18 Added TQFP-52 with exposed pad footprint for AD6645
2018-08-19 Connector Molex THT: Pad 1 rounded rectangle + fixes
    This includes the series that got forgotten in the previous commit.
2018-08-19 Connector Molex THT: Pad 1 rounded rectangle + fixes
    Include horizontal variant of micro fit 3.0
    The single row version now has larger pads in y direction for better
    solderability. This also required changes to the silk outline to reach
    the required silk to pad clearances.
2018-08-19 Rounded rect JST smd single row + mounting pad conn
    This converts all JST footprints generated with the "SMD single row plus
    mounting pad" generator script over to using rounded rectangle pads.
2018-08-19 Rounded rect Molex smd single row + mounting pad conn
    This converts all Molex footprints generated with the "SMD single row plus
    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
2018-08-19 Rounded rect Hirose smd single row + mounting pad conn
    This converts all Hirose footprints generated with the "SMD single row plus
    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
2018-08-19 Replace H(T)SOP-8 with scripted version(s)
    -Replace existing HTSOP-8 footprint with scripted and correctly named
    version.
    - Add missing footprint for L5973D
2018-08-20 Add Kingbright AAA3528ESGCT footprint (#738)
    * Add Kingbright AAA3528ESGCT footprint
    * Renamed footprint
2018-08-20 Create SOT-227 footprint for power devices (#697)
    This footprint is intended to be used to connect a SOT-227 to a pcb. The connection is made via screws. No solder connection is made.
2018-08-22 Footprint for TXC 7A Crystal (#855)
2018-08-22 Footprint for Qantek QC5CB series crystal (#854)
2018-08-25 Add scripted DFN-8 3x3mm 1.7x2.05mm EP for IX4426-27-28
    This replaces #831
2018-08-26 Added 2 footprints
    Added 2 footprints from VISHAY
    See http://www.vishay.com/docs/28770/acasat.pdf
2018-08-26 Fixing footprint offset according to 3D model (#868)
2018-08-26 Footprint for Abracon ABM7 (#856)
2018-08-26 Stelvio-Kontek PTF78 5x20mm fuse (#687)
    * Stelvio-Kontek PTF78 5x20mm fuse
    * Courtyard adjusted after review.
2018-08-26 Remove Normandled WS2813 footprint (#848)
    This footprint is no longer used anywhere as it is effectively a duplicate of the WS2812 footprint.
2018-08-27 rename with review suggestions plus use roundrect
    - footprint name now includes more details. (Manufacturer name, parts
    that fit it, pin count, body size and pitch)
    - used rounded rectangle pads as suggested by IPC
2018-08-27 add lvk12 4 contacts resistor (#872)
2018-08-27 Finish #600: Fix orientation, silk, fab and crtyd
    - Fix courtyard outline clearance and made it more closely follow the
    part
    - Fix silk outline to no longer overlap pads plus fix silk arcs to have
    the same center as the fab arcs.
    - Fix linewidth of fab and silk outlines
    - Rotate footprint to get pad 1 nearer to top right corner
    - Pad 1 is now a roundrect to distinguish it from the rest
2018-08-28 Fixup remaining points from review
    - Rotate part to get pin 1 nearer to top left corner
    - Include NPTH pads in courtyard area
    - Ensure silk clearance around pads
2018-08-28 Fixup WSK2512 problems plus add missing variants
    - Added variants for terminal lenght 1.19mm and 2.21mm
    - Fixed courtyard clearance
    - Fixed silk outline (no longer overlaps pads)
    - Corrected pad sizes (The existing version was the one compatible with
    terminal lenght = 1.19mm not 2.66mm)
    - More info in description
    - Rounded rectangle pads as suggested by IPC
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2018-08-28 width 0.1mm for F.Fab and 0.12 mm for F.Silk
2018-08-28 Further fixes to LEM-LTSR
    - pad orientation, pad size and drill sizes fixed
    - shorter description
    - put lines back on grid
    - removed silk below part
2018-08-28 -all holes slightly bigger as pins to fit easier
2018-08-28 Fix KLC issues with non scripted inductor footprints
2018-08-28 Fix silk layer of vertical script generated footprints
2018-08-29 Use kicad to save the footprint (remove space)x
2018-08-29 Fixup button MEC 5GTH9 (fixes #796)
    - Fix pad placement (both x and y pitch was wrong)
    - Change pad numbers such that they fit our symbols
    - courtyard clearance
    - Fix body outline (was too small) on silk and fab layers
2018-08-29 Add a new footprint for ethernet conectors
2018-08-29 Finish #348: Magjack J1B1211CCD by Cetus
    - Corrected minor mistakes with the NPTH pads
    - Added fab, silk and courtyard outlines
    - Corrected footprint name
    - Better description and keywords
2018-08-29 Next round of fixes
    - SMD devices now use rounded rectangle pads
    - Fixed some further devices with wrong crtyd clearance
    - And some other minor fixes
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2018-08-30 Add footprint for Mini Circuits FG873
2018-08-30 shrunk courtyard down, to not include USB cable
2018-08-30 adds diodes so 8 ep
2018-08-31 Further fixes to pad shape and size and pin 1 markers
2018-08-31 Add Ohmite_LVK20 shunt resistor (#880)
2018-09-02 add R_Shunt_Ohmite_LVK25 4 contacts smd resistor (#906)
2018-09-02 Add R_Shunt_Otmite_LVK24 4 contacts smd resistor (#905)
2018-09-04 Bourns MF-RG fuses: add y offset between pins.
2018-09-04 Bourns MF-RHT fuses: add y offset between pins.
2018-09-06 Fixed Courtyard lines were not on 0.01mm grid
    - Fixed Violating F5.3
    - Courtyard clearance changed to 0.255mm
2018-09-06 Some more fixes
    - Put courtyard on grid
    - Silk pad clearance
    - Better pin 1 markers on fab and silk
2018-09-07 Bourns PTA slide pots: incorporate feedback from PR.
    * Add datasheet to description.
    * Use triangle as pin 1 indicator instead of line.
    * Decrease annular ring for pins 1, 2, and 3.
    * Indicate travel on silkscreen, and screw holes on fab.
2018-09-08 added Virtual footprint for CR1225
2018-09-08 CT3151 horizontal banana jack.
    http://www.caltestelectronics.com/images/attachments/P315100rH_drawing.pdf
2018-09-09 Add ADI LFCSP-72 footprints (#852)
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2018-09-09 added 3 variations of MMCX 73415-0961
    removed soldermask clearance
    fixed KLC errors
    line fixes and center placement
    centerplacement
2018-09-09 4UCON 10156 right-angle through-hole card-edge socket.
    http://www.4uconnector.com/online/object/4udrawing/10156.pdf
    This is the connector used for the BBC micro:bit, although it is used
    for other things, too.
    https://tech.microbit.org/hardware/edgeconnector/
    This footprint is based on a footprint by SukkoPera:
    https://github.com/SukkoPera/OpenAmiga600RamExpansion/blob/master/OpenAmiga600RamExpansion.pretty/4UCON_10156_90deg.kicad_mod
    which is based on a footprint for the "straight" (vertical) version of
    the connector by anthonykirby:
    https://github.com/anthonykirby/kicad_microbit_connector/blob/master/Connectors_4UCON.pretty/4UCON_17909_02x401.27mm_Vertical.kicad_mod
    Both of them have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
2018-09-11 fixing very minor silkscreen clerance issue
2018-09-11 Add more Pulse gate drive transformer footprints
2018-09-11 Add pin 1 marks
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2018-09-16 Added TSOP-I-32_11.8x8mm_P0.5mm and TSOP-II-44_10.16x18.41mm_P0.8mm
2018-09-17 Add WLCSP-8 1.58x1.63mm package
2018-09-17 Sharp_GP2D120XJ00F added. Datasheet : http://www.sharp-world.com/products/device/lineup/data/pdf/datasheet/gp2y0a41sk_e.pdf
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2018-09-18 Add 36 49 and 81 ucBGA pachake, generated from script. PR https://github.com/pointhi/kicad-footprint-generator/pull/181
2018-09-18 correct pad size and solder mask opening on ucBGA. Correct also the package size for 81 version
2018-09-20 Add pSemi CSP-16 footprints
2018-09-20 Keywords added on OKI-78SR_horizontal and made TH device type.
2018-09-20 F.CYard positions set to grid 0.05mm
2018-09-20 1mm THT added. User must change it to 2,5 or 3,2mm. Info added for user.
2018-09-23 Correct internal footprint name
2018-09-23 Moved VSON footprint to Package_SON
2018-09-23 Fixed footprint as per advice and KLC
2018-09-23 Fixed pin incorrect location
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2018-09-25 Increase Silk offset from Fab layer to 0.15mm
2018-09-25 Set courtyard clearance to 0.25mm
2018-09-25 Resize drill diameter and pad size
2018-09-25 Remove '+' and '-' symbols. Remove pin 1 marker
2018-09-26 Add AS1115 TQFN-24 footprints (#853)
    * Add AS1115 TQFN-24 footprints (TQFN package with pull back leads)
2018-09-26 Rename SMLVN6 with recommended solder pattern
2018-09-27 Footprints for CUI SJ1-3533NG audio jack.
    https://www.cui.com/product/resource/digikeypdf/sj1-353xng.pdf
    I am submitting two footprints: one as specified in the datasheet, and
    one with circular holes.
    These footprints are meant to be used with the symbol
    AudioJack3_Ground, which has pin numbers T, R, and S. Since there is
    no pin 1, I have not included a pin 1 indicator.
2018-09-28 Added Relay Fujitsu FTR-F1
2018-09-28 F.Fab dimensions and %R
    ...OKI-78SR_horizontal: F.Fab top line to 1,27mm on
    ...OKI-78SR_horizontal: %R in F.Fab layer set to center of device
2018-09-28 Add Keystone 2462 2xAA battery holder
2018-09-28 added script generated HTSSOP-20-1EP_4.4x6.5mm_P0.65mm_EP3.4x6.5mm_Mask2.75x3.43mm* (Texas_PWP_R-PDSO-G20) https://github.com/pointhi/kicad-footprint-generator/pull/189
2018-09-30 Rotated to put pin-1 top-left. Added pin-1 marker on SilkS.
2018-10-02 Button_Switch_THT: Fix courtyard layer in EG1271
2018-10-03 Fix Keystone 2462 battery holder footprint line positioning
2018-10-03 Add footprint for XP Power JTE series dual output DC to DC converter. (#992)
2018-10-05 Add 2x2mm DFN-8 with 0.9x1.5mm EP
2018-10-05 Add TI PWP footprints for TPS703xx
2018-10-06 Use script generated footprint
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2018-10-08 Add pin-1 marker to the TDK buzzer
2018-10-08 Added footprint for Diodes SIP-3 Ammo-Pack
2018-10-09 Add footprint for 8045 Crystal
2018-10-09 Implement suggestions
    - Courtyard grid
    - Round rect for pin 1
    - Silk outline now orthogonal
2018-10-09 Add new Microchip xFN footprints
2018-10-10 remove adhesive dot, rounded pads, silkscreen and crtyrd changes
2018-10-11 rename and non-polarized silkscreen
2018-10-11 Rename footprint from Texas_WSON-6_DQK to Texas_DQK Switch REF** with footprint name Reduce length of some F.SilkS line
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2018-10-16 Add ON Semiconductor VCT28 footprint to Package_DFN_QFN
2018-10-17 Add LT/ADI BGA/LGA-133 uModule footprints
2018-10-19 added FP for 9V battery holder 12BH611-GR
2018-10-19 added footprints for Texas RTQ EP5.6 QFN-56-1EP_8x8mm_P0.5mm_EP5.6x5.6mm Texas RTQ (S-PVQFN-N56)
2018-10-22 Mounting holes for a PCB to DIN rail adapter
    Step file is in https://www.phoenixcontact.com/online/portal/us/pxc/product_detail_page/!ut/p/z1/3Vdtj5pAEP4r9oMf193lTWjSDyjm1HrUU-wJX8gCi9mWtwPUq7--i2DOXlNNY0xayCTs7sw8O_OwQ2ahA9fQ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
2018-10-22 New LED footprint 5381 series
    https://vcclite.com/wp-content/uploads/wpallimport/files/files/5381Series.pdf
2018-10-23 Update and rename LED_5381.kicad_mod to LED_VCCLite_5381_6.35x6.35mm.kicad_mod
2018-10-23 Add Vishay PowerPak 1212-8 (#998)
    * Initial version for Vishay PowerPAK 1212-8 (SiS415DNT)
    * modify pins numbers to be compatible with kicad-symbols/Transistor_FET
    * Change 5 pad's to 1 custom pad
    * Rename footprint
    * Remake pad 5, with less points
    switch value with ref**
    * Changed F.Fab to package size, without leads
    Adapt F.SilkS to new size of F.Fab
2018-10-24 Update and rename LED_VCCLite_5381_6.35x6.35mm.kicad_mod to LED_VCCLite_5381H1_6.35x6.35mm.kicad_mod
2018-10-24 Add 44- and 64-pin dual row QFN (#990)
    * Add 44- and 64-pin dual row QFN
    * Use Microchip land patterns as reference for pad sizes
    * Forgot to change footprint name
    * Add ThermalVias variants
    * Don't use rotated pads
    * Increase thermal pad radius to ~0.25mm
    * Add DualRow before EP size
    * Rename to DRQFN
    * Use oval pads for maximum compatibility
    * Add manufacturer prefix
2018-10-26 Fix Molex PicoBlade 5304x part numbers (#1046)
    The Molex PicoBlade 53047 and 53048 footprints used incorrect part
    numbers in there names. This fixes the filename, module name,
    description and 3D model name.
    This also fixes the incorrect datasheet URL for the 53048 footprints.
2018-10-26 Added Fairchild Power33 package (#975)
    * Added Fairchild Power33 package
    * Added 'dual' to name
    * Remove 'trenchfet' keyword
    * Assorted changes
    * Pad changes as requested
2018-10-26 Update and rename PhoenixContact_1201578.kicad_mod to DINRailAdapter_PhoenixContact_1201578.kicad_mod
2018-10-27 add missing mask to holes
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2018-10-29 Solder pad ring is too small for hand soldering (#1039)
    * Solder pad ring is too small for hand soldering
    Increase from 1.26 to 1.75
    * Create Potentiometer_Bourns_3339P_Vertical_HandSoldering.kicad_mod
    * revert original file, for machine soldering
    * restore original content
    * remove newline
    * Update Potentiometer_Bourns_3339P_Vertical_HandSoldering.kicad_mod
2018-10-29 Change to 3.2 mm hole size instead of 3.4mm
    In order to match same clearance as the M3 Mounting Hole footprint already available in the library.
2018-10-30 Add Vishay PowerPak 1212-8 Dual (#1051)
    * Add footprint for Vishay PowerPAK 1212-8 Dual
    * Mark pin 1 on F.Fab
    Fix F.CrtYd in height
    Added on the corners
2018-10-31 Fix Vishay PowerPak 1212-8 Single (#1057)
    - Added mark of pin 1 in F.Fab
    - Fix F.CrtYd in height
    - Added corners in F.SilkS
2018-11-05 Power integrations e dip 12 b (#1068)
    * Change the data sheet link to the manufacture specifc
    * Changed width of F.fAb to 0.1 and removed the 3D model cordinate offset
2018-11-06 Fix pad numbering
    From https://github.com/KiCad/kicad-footprints/issues/1067.
    No image since it's well-documented in that issue and this is a simple change. Also updated the datasheet.
2018-11-09 Fix Kingbright APFA3010 pad numbering (#1075)
    * Fix Kingbright APFA3010 pad numbering
    Flip pins 4 and 3 as per the datasheet for
    APFA3010LSEEZGKQBKC.
    * Re-center footprint
    * Re-re-center footprint
    * Revert Re-centering of footprint
    This reverts commits cb57dbaf71a5512641fbe43b66b4db73dd6d60df.
    and 977e5ebdf47b05f5a1d427ee0b53018a5d15b092.
2018-11-13 Add XP Power ISU02 series DC to DC converter SMT footprint. (#1065)
    * Add XP Power ISU02 series DC to DC converter SMT footprint.
    * Fix XP Power ISU02 series footprint per pull request comments.
    Add description before datasheet url.
    Fix pad length.
    Adjust silkscreen outline so it doesn't overlap fabrication layer drawing.
    Add pin 1 indicator to fabrication layer.
    Remove superfluous 180 degree rotation from fabrication layer reference
    text.
    Update 3D model.
    * Update XP Power ISU02 DC to DC converter description an silkscreen.
    * Fix XP Power ISU02 series DC to DC converter SMT footprint issues.
    Add dimensions to and remove extra space from description.
    Change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
2018-11-19 Add Artesyn ATA Series SMT DC to DC converter footprint. (#1090)
    * Add Artesyn ATA Series SMT DC to DC converter footprint.
    * Fix KLC error in Artesyn ATA Series SMT DC to DC converter footprint.
    Add reference to F.Fab layer.
    * Fix more errors in Artesyn ATA Series SMT DC to DC converter footprint.
    Rename footprint per pull request comments.
    Fix dimensions and add technical reference url to description.
    * Fix even more errors in Artesyn ATA Series SMT DC to DC converter footprint.
    Make the value name match the file name.
    Make the vertical silkscreen endpoints consistent.
    * Fix renaming typo in Artesyn ATA Series SMT DC to DC converter footprint.
    * Fix name error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
2018-11-21 fix datasheet link in SOIC-8 3.9mmx4.9mm (#1101)
    Alternative datasheets could be:
    www.ti.com.cn/cn/lit/ds/symlink/tl7705a.pdf p.22
    http://www.ti.com/lit/ml/msoi002j/msoi002j.pdf
2018-11-22 Adding Runtron RM065/063 device (#1050)
    * Added Triwood RM065 potentiometer from old archive
    * Removed 3dshape as it was not found anywhere
    * Renamed file and removed bugs from travis
    * Chaned name in silk layer and avoided collision silk layer with pad
    * Removed typo in 3d model name
    * Rotated footprint and removed clutter in the center
    * Moved footprint such that pin 1 is in origin
    * Renamed FP to Runtron and made minor modifications
    - Changed order of pin numbers to be consistent with symbol library
    - Positioned all pins in metric space
    - Added clearance of silkscreen on all pins according to http://kicad-pcb.org/libraries/klc/F5.1/ sentence 2
    * Added vertical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
2018-11-25 Add footprint for Harwin M20-781
2018-11-25 Add almost all XT30 connectors from AMASS
2018-11-26 Added Toshiba isolator SOIC footprints
2018-11-27 Fix 12BH611-GR pad numbering (#1114)
    * Fix 12BH611-GR pad numbering
    Fixes #1113
    * Additional improvements to ensure compilance
    - Pad 1 set to rectangular
    - Pad 1 specified as footprint anchor
    * Further improvements to ensure compilance
    - Unrotate pin 1
    - Silkscreen layer requirements reviewed
    - Fabrication layer requirements reviewed
    * Reposition labels
2018-11-28 Rename connectors to remove M20 series
2018-11-28 Removed duplicate Courtyard line on DFN-8-1EP_3x3mm_P0.65mm_EP1.55x2.4mm (#1118)
2018-11-28 Add SMA-J-P-X-ST-EM1 footprint (#942)
    * Add SMA-J-P-X-ST-EM1 footprint
    http://suddendocs.samtec.com/prints/sma-j-p-x-st-em1-mkt.pdf
    * Fix SMA_Samtec_SMA-J-P-H-ST-EM1_EdgeMount
    * fix pad position
    * add PCB Edge marking
2018-11-28 Revert "SD_TE_2041021: Use non-numeric pin numbers for CD, WP, and SH."
2018-11-29 Updated fiducials to Surface Mount (#1104)
    * Updated fiducials to Surface Mount
    - Made all Surface Mount type
    - Removed old syntax ("~" for pins without number, "(at 0 0)")
    - Simplified keywords
    - Removed duplicated German from description
    - Removed excessive precision
    - Set line widths as specified in KLC
    - Converted double Cu circles to a single one
    * Add fab layer ref des
    * Add courtyard
2018-12-03 Audio jack fix (#1014)
    Aligns the audio connector footprints to the pin numbering scheme used in the symbols.
2018-12-03 Fix XT30UPB-M/F pins drill to 1.8
2018-12-04 Fix XT30PW-M/F and MR30PW-M/F pins drill to 1.9
2018-12-04 name mounting pads of PTSM SMD connectors with `MP` (#1125)
2018-12-04 add footprint for Bel S558-5999-T7-F (#1100)
2018-12-05 Add Microchip QFN footprints (#1097)
2018-12-05 coaxial connector sma molex 73251-2200 horziontal (#1116)
2018-12-05 Add 2 mm and 2.1 mm mounting holes (#922)
    Modified from other existing mounting holes.
2018-12-05 Package_QFP: add LQFP-52_14x14mm_P1mm (#1123)
    Generated using kicad-footprint-generator. See relevant PR:
    https://github.com/pointhi/kicad-footprint-generator/pull/230
2018-12-06 Add TI DSBGA (YZR) footprint (#1146)
2018-12-07 add Mini-Circuits land pattern PL-012
2018-12-12 Add Ublox SARA G3/U2 footprint (#1099)
2018-12-13 Fixes to some battery holders (#1162)
    * Renewed data sheet for BX0036,
    * removed npth holes for Keystone_500
    * add npth holes for MPD_BH-18650
2018-12-13 Add WLP-4 0.73x0.73mm 0.35mm pitch (#1129)
2018-12-13 MountingHole: fix 2 mm and 2.1 mm line endings
    They were CRLF (Windows) and it was causing problems.
2018-12-14 PSTM -1MP in SMD package names (#1142)
    The mounting pads have gotten a pin number in accordance with KLC.
    This change must also be reflected in the footprint names.
2018-12-14 Add connector BNC Amphenol Horizontal [B6252HB-NPP3G-50] (#1144)
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2018-12-16 Mini-Circuits case CD542 land-pattern PL-094 (#1148)
2018-12-16 Transformers: Add footprint for Excelitas ZS1052 AC ignition coil
2018-12-17 Add Mini-Circuits land-pattern PL-225 (#1150)
2018-12-17 Mini-Circuits YY161 land-pattern PL-049 (#1137)
2018-12-17 Finish #589: Mini-Circuits Filter Mounts FV1206 and variants (#882)
    * add Mini-Circuits FV1206
    https://ww2.minicircuits.com/case_style/FV1206.pdf
    * add Mini-Circuits FV1206-4 filter mount
    https://ww2.minicircuits.com/case_style/FV1206-4.pdf
    * add Mini-Circuits FV1206-7 SMD filter package
    https://ww2.minicircuits.com/case_style/FV1206-7.pdf
    * add Mini-Circuits FV1206-1 SMD filter
    https://ww2.minicircuits.com/case_style/FV1206-1.pdf
    * add Mini-Circuits FV1206-6 SMD filter package
    https://ww2.minicircuits.com/case_style/FV1206-6.pdf
    * add Mini-Circuits FV1206-5 SMD filter package
    https://ww2.minicircuits.com/case_style/FV1206-5.pdf
    * FV1206: Silk outline offs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
2018-12-19 Replace existiong LQFP 32 and 36 with scripted variants (#1176)
    * Replace existiong LQFP 32 and 36 with scripted variants
    This replaces the 32 and 36 pin versions of the LQFP footprints with
    scripted ones.
    LQFP-32-1EP_5x5mm_P0.5mm_EP3.45x3.45mm is deleted as that one
    is kind of a frankenstein created from another qfp footprint with the
    thermal pad definition of a qfn footprint. (Not used by any symbol in
    the current lib.)
    * lqfp 36 7x7 with small pitch ipc definition
    Changed this 0.65mm pitch device to use the <=0.625mm pitch ipc rules
    to get enough clearance between the pads.
2018-12-19 New MQFP 44 footprint for ad7722 (#1178)
    AD7722 is wrongly connected to a LQFP footprint right now. That
    footprint is desinged for quite different tolerance ranges in the
    package dimensions.
    This new footprint is specifically designed for this package.
    Script PR: pointhi/kicad-footprint-generator#245
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2018-12-19 Scripted versions of EQFP-144-1EP (Previosly LQFP) (#1190)
    * Scripted versions of EQFP-144-1EP (Previosly LQFP)
    These are scripted versions for the old LQFP-144-1EP footprints.
    The manufacturer calls these EQFP that is the reason for the prefix
    change.
    All but the two smallest EP size versions had the wrong EP sizes (they
    do not have the same size in x and y direction.)
    This also adds thermal via versions.
    Script PR: https://github.com/pointhi/kicad-footprint-generator/pull/245
    * fix datasheet link for 6.61c5.615mm ep pad version
2018-12-19 added DSBGA-28_3.0x1.9mm_Layout4x7_P0.4mm for bq51050b
2018-12-19 New scripted versions for LQFP-52 footprints (#1184)
    * New scripted versions for LQFP-52 footprints
    This adds scripted versions of the LQFP 52 footprints
    script PR: https://github.com/pointhi/kicad-footprint-generator/pull/245
    The 0.65mm pitch version uses ipc definition for small pin pitch
    (0.625mm) to allow for enough pad to pad clearance.
    * Use small pin pitch ipc definition for EP version as well
    For consistency use the same ipc definition for both the ep and non ep
    version of the footprint
2018-12-19 Scripted versions of LQFP-64 footprints (#1185)
    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
2018-12-19 Newly scripted footprints for LQFP 44 and 48 (#1177)
    This replaces the 44 and 48 pin versions of the LQFP footprints with
    scripted ones. Script PR: pointhi/kicad-footprint-generator#245
2018-12-19 Scripted versions for LQFP-80 and LQFP-100 (#1188)
    0.65mm pin pitch version uses <=0.625mm pitch ipc rules to achieve
    sensible pad to pad clearances.
    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
2018-12-19 Scripted version of LQFP-128 footprints (#1189)
    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
2018-12-19 Scripted version of LQFP-208 and LQFP-216 (#1192)
    * Scripted version of LQFP-208 and LQFP-216
    * Fix datasheet link
    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
2018-12-19 Scripted version for LQFP-144, 160 and 176 (#1191)
    * Scripted version for LQFP-144, 160 and 176
    * better way to communicate datasheet page
    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
2018-12-20 converter_acdc: HiLink: add HLK-PMxx (#1092)
    These are cheap, readily available board mount ac/dc modules.
    See: http://www.hlktech.net/product_detail.php?ProId=54
2018-12-20 Fix F.SilkS layer Add footprint with thermalvias
2018-12-21 specify number of screws
2018-12-21 Converter_ACDC: mirror RAC05 series footprint
2018-12-21 Fix 3D names Arrange position of REF**, %R, footprint name Added missing + , - on F.SilkS
2018-12-21 Connector_USB: Add Molex 105133-0031 (#1157)
2018-12-22 Add 6x6mm UQFN-48 required for ATmega3209/4809 (#1205)
    Sadly there is no dimensioned drawing for the package in the datasheet. A picture of an old datasheet was found and uploaded to github. This is linked in the footprint description.
2018-12-23 Scripted replacement for qfn-20 (ATTiny MCUs) (#1209)
    The EP of the current footprint is wrong. So the old one is deleted and
    a new one with the correct dimensions added.
2018-12-24 Re export the qfn-2x footprints (#1208)
    This updates the qfn-2x footprints with the fixes added to the qfn
    generator since they where last updated.
    (Mainly fixes to chamfered pads. Automated pad to ep clearance.)
2018-12-24 Removing impossible qfn footprint (#1203)
    3x3mm body size with 2.7x2.7mm ep size would not really be possible.
    This footprint is simply named wrong as it has a 1.8x1.8mm ep. (such a
    footprint is already scripted in the lib)
2018-12-24 Scripted replacements for qfn-20-1ep 3x3 ep1.8x1.8 (#1199)
    * Footprint for OPA2695xRGT
    This part had a footpirnt with the wrong EP size assigned.
    * New scripted footprint for MAX5139
    * footprint for LT3755xUD
    * footprint for STSPIN220 replacing old wrong footprint.
    * Adding correct footprints required for nxp mcus
    * new correct footprint for TLV62095RGTx
    * add heel reduction to get 0.2mm of ep to pad clearance
    * Remove old qfn-16-1ep (1.8x1.8mm ep size)
    This footprint did not come with a datasheet. The symbols designed to it
    needed quite different footprints. This footprint is therefore replaced
    by the following footprints (plus their thermal via versions):
    - QF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
2018-12-24 Update scripted VQFN footprints (#1198)
    * Update scripted VQFN footprints
    run the same size definition file with the updated scripts
    - Main changes are to the paste pad generation which now uses corrected
    calculations for rounded chamfered pads
    - One of the bottom pads was too large for some reason (the vias where
    too far out)
    - Better datasheet links where a page is referenced
    * Increase chamfer size to get back previous clearance
2018-12-27 Add scripted TI S-PWSON-N8 (replaces #541) (#1175)
    * Add scripted TI S-PWSON-N8 (replaces #541)
    This adds a footprint for TI S-PWSON-N8. The footprint uses normal qfn
    ipc settings (nearest result to suggested footprint). The suggested
    footprint is not reached as it seems to be quite old (TI suggests the
    long obsolete IPC-SM-782. telling me that datasheet is quite old or at
    least the suggested footprint is.)
    The EP size is inclded as we did for similar footprints in the QFN
    library. (same custom format string as ti qfn footprints)
    There is one more thermal via as the script does not support the
    generation of the exact pattern suggested by TI. (The drill size is a
    bit reduced s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
2018-12-27 Adding fp for AMS-AS5055A
    The fp used currently has the wrong ep size and wrong lead type (ams
    uses pull back leads for this.)
2018-12-27 Delete original unscripted qfn-16-1ep 4x4 with 2.5x2.5 ep
    This footprint is not used by any symbol in the library. (It got
    replaced by corrected footprints for every symbol that did use it.)
    The documentation linked in it does not fit the footpritn present.
2018-12-29 Add Ak300 terminal block series (#1155)
    Script pull request: https://github.com/pointhi/kicad-footprint-generator/pull/236
2018-12-30 Rerun script for qfn-4x footprints (#1227)
    This updates the qfn-4x footpritns to the current state of the script.
    Main changes are to chamfered pads (paste layer of exposed pads with
    thermal vias)
    But also to the way we address pages of datasheets and the new ep to
    pad clearance calculation.
2018-12-30 Reexport scripted qfn 56 and 68 footprints (#1232)
    Rerun the scripts on the qfn-other definition file. Main changes are to
    the paste layers.
2018-12-30 scripted version of existing qfn 24 5x5 (3.2x3.2 ep) (#1224)
    This adds a scripted replacement for the existing footprint plus a new
    one that fits its symbol better (correct ep size)
2018-12-30 Scripted version of qfn-76 9x9 (3.8x3.8 EP) (#1237)
    * Scripted version of qfn-76 9x9 (3.8x3.8 EP)
    This footprint is not used by any symbol. Still included as the
    datasheet is valid.
    * add page number to datasheet link
2018-12-30 Scripted replacement for qfn-56 7x7 (5.7x5.7 EP) (#1235)
    * Scripted replacement for qfn-56 7x7 (5.7x5.7 EP)
    This footprint is used for cypress MCUs. EP size is at max as this was
    like it was in the past.
    * Set EP size to nominal
2018-12-30 Move GPS's Modules footprints from RF_Module to RF_GPS
2018-12-31 Delete unneeded qfn-44 8x8 (6.6x6.6 ep) (#1228)
    This one footprint is not needed for any symbol after
    https://github.com/KiCad/kicad-symbols/pull/1345 is merged.
    I could not find a datasheet that contains a package with the dimensions
    of this footprint. (The assigned datasheet was from another package)
2018-12-31 Fix footprint as per review
    - Fixed fab outline
    - Corrected courtyard
    - Fixed placement of fields
    - Added 3d model
    - Filename as per new switch naming convention see
    https://github.com/KiCad/kicad-symbols/issues/580
2019-01-01 add scripted VSSOP-10 0.5mm pin pitch (#873)
    Script PR: https://github.com/pointhi/kicad-footprint-generator/pull/209
2019-01-01 Fix QingPu WQP for consistency with other footprints (#1069)
2019-01-01 Xbga 121 10x10mm (#1170)
    * Added XBGA-121_10x10mm_Layout11x11_P0.8mm
    * Changed the paste_margin to 0.0001 for XBGA-121_10x10mm_Layout11x11_P0.8mm
2019-01-01 ECS-2520MV oscillator footprint (#1035)
2019-01-01 Fujitsu wlp 8 3.09x2.28mm pitch0.4mm (#976)
2019-01-01 Mini-Circuits land-pattern PL-052 (#1127)
2019-01-01 Add Mini-Circuits land pattern PL-035 (#1130)
2019-01-01 Add vertical RJ-45 connector On-Shore PJ012-8P8CX (#824)
2019-01-01 add Mini-Circuits land-pattern PL-176 (#1136)
2019-01-01 add Mini-Circuits land-pattern PL-230 (#1134)
2019-01-02 add Mini-Circuits land-pattern PL-236 (#1135)
2019-01-02 Add Mini-Circuits PL-258 land-pattern (#1128)
2019-01-02 MountingEquipment: moving DIN Rail adapter (#1252)
2019-01-03 DE122-XX-XX: Change Y-size of pin 1 to 1.524 mm
2019-01-04 Alias of the GP731 footprint, follwing discussion at https://github.com/KiCad/kicad-symbols/pull/1373
2019-01-05 Mini-Circuits PL-005 land-pattern (#1126)
2019-01-05 add Oscillator_SMD_Abracon_ASCO-4Pin_1.6x1.2mm (#909)
2019-01-06 Scripted R-PDSO-G8 (HSOIC-8) for the LMR14030
    Replacement for #662
    EP (copper) size = 2.95x4.9mm, Mask size = 2.4x3.1mm (Solder mask
    defined exposed pad)
2019-01-06 Vishay WSR2/3 footprint (#888)
2019-01-08 Added LFCSP-WQ-24-7EP_4x4mm_P0.5mm_EP2.6416x2.6416mm (#1269)
    * Added LFCSP-WQ-24-7EP_4x4mm_P0.5mm_EP2.6416x2.6416mm
    * Renamed footprint to match library convention.
    * Recreated footprint using script.
    * Removed old footprint.
2019-01-15 Auto-generated Lattice caBGA-381 footprint. (#925)
2019-01-16 Add generic Ethernet-Transformer
    This footprint should fit the following device
    - Bourns PT61017
    - Halo TH110*
    - Pulse H2260
    - Epcos/TDK B7847
    - Abracom ALAN 101T
    - BEL S558-5xxx
2019-01-16 Finish #703: TE Miniature PCB Relay PCH_A (#884)
    * added Footprint for TE Miniature PCB Relay PCH_A
    http://www.te.com/commerce/DocumentDelivery/DDEController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
    * Fix remaining points of #703
    - Fix silk outline offset
    - Add pin 1 markers and change pad 1 to roundrect
    - fix drill sizes and correct annular ring size
    - fix courtyard offset
    - Correct footprint name
    - Add description and keyword
    - Add 3d settings
    * Fix KLC errors
    - fab line width
    - courtyard grid
    * fix description
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2019-01-17 Add Mini-Circuits land-pattern PL-079 (#1133)
2019-01-17 Murata BNX025 EMI-filter (#1106)
2019-01-17 Add Mini-Circuits land pattern PL-247 (#1132)
2019-01-17 Add Lodestone VTM inductor mount footprints (#1023)
2019-01-18 KiCad Logos: Master Update to Build (#1287)
2019-01-18 KiCad Logos: New naming convention (#1312)
2019-01-18 Fix courtyard and silkscreen
2019-01-19 RF_Module: Fix and improves HOPERF_RFM9XW_SMD footprint (#1213)
2019-01-19 Add JST PHD series of connector footprints (#915)
    Script pull request: https://github.com/pointhi/kicad-footprint-generator/pull/170
2019-01-19 Added Kyocera 6 pin tcxo.
2019-01-19 Changed courtyard clearance to 0.25mm.
2019-01-20 More 3M Textool ZIF sockets, generated with script. (#495)
2019-01-20 RJ45: Add a new Amphenol RJHSE5380-08 footprint (#1300)
2019-01-20 Crystal: Add Abracon ABS25 4Pin 8.0x3.8mm (#1270)
2019-01-22 Mini-Circuits PL-258: fix typo "__" -> "_"
2019-01-22 Add SHT1x - temperature/humidity sensor (#1297)
2019-01-22 Add footprint for Maxim Integrated TSOC-6 (#1248)
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2019-01-22 Mini-Circuits BK377 plain footprint (#1314)
    * BK377 plain footprint: remove GND-vias, GND-zones, clearance-values, all pad-connections to "form parent footprint", new 0.25mm courtyard.
    partial work for #1308
    * description, keywords.
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2019-01-22 Add Mini-Circuits QQQ130 plain footprint (#1323)
2019-01-22 plain version of Mini-Circuits MMM168 (#1318)
2019-01-22 Plain version of Mini-Circuits HF1139 (#1317)
2019-01-22 Mini-Circuits GP731/GP1212 plain footprint (#1315)
    * plain version of GP731.
    - remove GND-pads
    - all pad-connections to "from parent footprint"
    - all clearances to zero
    * add plain version of GP1212
2019-01-22 Update 16-pin Textool socket to match all the others. (#1319)
    I originally submitted the 16-pin Textool socket in PR #465 as a test
    case of my script. Once it was accepted, I submitted the rest of the
    Textool sockets in PR #495. However, a bunch of additional
    requirements were places on the second PR, so the new sockets ended up
    with a different naming convention, and some different dimensions,
    than the 16-pin socket.
    This PR brings the 16-pin socket in line with all the others.
2019-01-22 add Bourns SRF0905 line filter (#1220)
2019-01-23 Sensor_Temperature: Rename to "Sensor" (#1332)
2019-01-23 Mini-Circuits HZ1198 (#1330)
    * Mini-Circuits HZ1198
    * move down 8 mils, to make travis happy
    * new 0.25mm courtyard
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2019-01-23 Removed Vishay_PowerPAK_SO-8, which duplicates PowerPAK_SO-8_Single (#1037)
2019-01-24 Mini-Circuits TTT167 (#1329)
    * Mini-Circuits TTT167
    * rotate TTT167 by 180 degrees
    * rotate PL-079 by 180 degrees.
2019-01-24 TO-SOT SMD: Add footprint for On Semiconductor ECH8 package
2019-01-24 Added the foot print for sensor DHT11
2019-01-24 add QFN-12-1EP variant from Mini-Circuits DQ1225 (#1334)
2019-01-24 add SOP-8 variant by Mini-Circuits XX211 (#1335)
2019-01-25 Changed pin 1 into a rectangle
2019-01-26 New QFN 24 for 2.8x2.8mm EP. (#1283)
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2019-01-26 Add DFN-8 with 0.8x1.2mm EP. (#1286)
2019-01-26 Corrected Holes sizes on Ethernet connector after measureing the real thing. Looks like the datasheet dimesions are for the PCB hole sizes, not the size of the pins themselves (Conncetor pins measure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
2019-01-27 Corrected Footprint to match datasheet as close as possible
2019-01-28 Button_Switch_SMD: Rename KMR2 footprint to include manufacturer (#754)
2019-01-28 Renamed SA15-11 footprint to SA15-11xxx
2019-01-29 Added Beagleboard pocket beagle foot print
2019-01-29 Moving mini circuits footprints out of Package_SO lib (#1339)
    * Moving mini circuits footprints out of Package_SO lib
    The mini circuits footprints in the Package_SO lib have been placed there by mistake.
    (Non of them are gullwing parts.)
    This is a partial fix for #1249
    * fix 3d model path settings
2019-01-31 Footprint for SO-8_3.9x4.9mm_P1.27mm (#1333)
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2019-02-01 NKK GW12LxH SPDT right-angle rocker switch (#1279)
    http://www.nkkswitches.com/pdf/GW.pdf
    The datasheet specifies the pins as 4, 5, and 6, but I numbered them
    1, 2, and 3, to allow the footprint to be used with the existing
    library symbol for an SPDT switch. The alternative would be to create
    a new library symbol where the pins are numbered 4, 5, and 6.
    I left the mounting pins unnumbered. The alternative would be to
    number them MP. This would then require a new library symbol, too,
    since there does not seem to be a symbol for a switch with a mounting
    pin.
2019-02-02 Added new foot print MPL115A1 (#1342)
    * Added new foot print MPL115A1
    * Modified the pads a little in size
    * Updated the foot rpint after changing to new format for paramters in the foot print generaor script
2019-02-03 Fix wrong pin pitch in VQFN-28-1EP_4x4mm_P0.45mm_EP2.4x2.4mm (#1370)
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2019-02-04 Remove duplicate TI WSON-6 (#1361)
    Texas_S-PWSON-N6 is a duplicate of WSON-6-1EP_2x2mm_P0.65mm_EP1x1.6mm
    The current version of the datasheet assigned to S-PWSON-N6 does not
    list this name. http://www.ti.com/lit/ds/symlink/tps717.pdf#page=40
2019-02-04 Remove dublicate TI VQFN-RGR-20 (#1362)
    This footprint is called S-PVQFN-N20 in the datasheet assigned to it.
    The assigned datasheet does not specify the EP size as it is the general
    datasheet for all packages with this name.
    http://www.ti.com/lit/ml/mpqf239/mpqf239.pdf
    The 2x2mm ep size of the footprint seems to be wrongly derived.
    This footprint is not used by any symbol right now so no change is
    needed on the footprint side of things.
    We have two S-PVQFN-N20 footprints in the lib (2.4x2.4mm ep and
    2.7x2.7mm ep)
2019-02-04 Replace TI VQFN-RGW-20 with scripted version (#1363)
    http://www.ti.com/lit/ml/mpqf122b/mpqf122b.pdf
    But the footprint is used in the library for TPS7A7200RGW
    Its datasheet is http://www.ti.com/lit/ds/symlink/tps7a7200.pdf
    The new footprint assigns the correct name to it.
    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
2019-02-04 Scripted SOIC-8-1EP footprint for HIP2100 (#1366)
    * Scripted SOIC-8-1EP footprint for HIP2100
    * fix ep size
2019-02-04 Remove old SOIC-8 ep footprint (#1369)
    This footprint did not fit any of the symbols that currently use it. New
    scripted footprints have been added in other commits to replace it for
    the symbols.
    The datasheet assigned to the footprint does not really contain any
    drawing that would fit this footprint.
2019-02-04 Add MSOP-8 EP (mask defined) for MIC5355-S4YMME (#1375)
    * Add MSOP-8 EP (mask defined) for MIC5355-S4YMME
    Note in datasheet states "as much copper as possible". Therefore very
    large copper pad with mask at same size as nominal EP.
    * Removed now unused MSOP-1EP package (new one is soldermask defined)
2019-02-05 Add Coilcraft LPS5030 (plus freecad source) (#1340)
    [L_Coilcraft_LPS5030.FCStd]
2019-02-06 Fixed nonsenses in the 7seg footprint
2019-02-06 Add D52M (#1117)
    * Add D52M Module
    * Update manufacturer info
    * Remove old file
    * Add description, keywords
    * Update footprint
    - Added 3D file path (file does not yet exist)
    - Fixed description
    - Fixed keepout name
    - Renamed footprint/file
    - Fixed SMD pads
    * Fix link
    * Rename file
    * Fix name, change soldermask expansion
    * Fix 3d filename
    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
2019-02-07 Rename SIP-3 Packages in Sensor_Current (#1072)
    * Rename footprints:
    * Allegro_SIP-3 to Allegro_SIP-3_4.09x1.52_P1.27mm
    * Diodes_SIP-3_AmmoPack to Diodes_SIP-3_4.1x1.5mm_P2.65mm
    * Rename Allegro_SIP-4 to Allegro_SIP-4_5.21x1mm_P1.27mm
    * Update the name of 3d models
    * Undo the change of Allegro SIP-3/4
    * Add Diodes SIP-3 1.27mm (Bulk Pack)
    * Reduced size of %R to 0.7
    Moved package body in y
    Updated F.SilkS to new place of body
    * Fixed KLC F5.1
    * update footprint to have y offset and right size of pads
    * Move back F.SilkS line from 0.85 to 0.96
    * update F.SilkS it's a bit further away from pad's
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2019-02-12 Button_Switch_THT: Add CK OS102011MS2QN1 footprint (#761)
    * Button_Switch_THT: Add CK OS102011MS2QN1 footprint
    * Button_Switch_THT: Rename OS1020 device
    * Button_Switch_THT: Fix pad alignment in OS1020 device
    * Button_Switch_THT: Fix silks offset in OS1020 device
    * Button_Switch_THT: Fix pin 1 marker in OS1020 device
2019-02-12 Add Molex 200528 series (scripted via kicad-footprint-generator) (#1383)
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2019-02-12 Added footprint for RECOM RPM-series of DC/DC converters (1A, 2A, 3A and 6A). (#1382)
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2019-02-12 New scripted version of TI footprints (#1360)
    * New scripted version of TI RUM0016A
    This footprint is not used by any symbol right now.
    The original was extremely bad as it got missed by the first round of
    exposed pad reworks.
    Naming updated to include ep size.
    Thermal vias version added.
    * Scripted version of TI S-PVQFN-N20 2.7x2.7mm ep size
    * New scripted version of TI S-PVQFN-N36
    Currently not used by any symbol
    Name now includes EP size
    * Newly scripted version of TI S-PVQFN-N40_EP2.9x2.9mm
    * Scripted version of TI S-PVQFN-N40_EP3.52x2.62mm
    * Scripted version of TI S-PVQFN-N40_EP4.15x4.15mm
    * Scripted version of TI S-PVQFN-N40_EP4.6x4.6mm
    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
2019-02-12 Scripted TI S-PWQFN-N16 EP2.1 for motor drivers (#1401)
    * Scripted TI S-PWQFN-N16 EP2.1 for motor drivers
    * Remove old wqfn footprint replaced by one with ti naming scheme
2019-02-12 Add Raspberry Pi Zero footprint using Through-hole pin socket (#1066)
    * Add Raspberry Pi Zero footprint using Through-hole pin socket
    Notes about dimensions:
    - Official Mechanical drawing:
    https://www.raspberrypi.org/documentation/hardware/raspberrypi/mechanical/rpi_MECH_Zero_1p2.pdf
    - Dimensions of the PCB are pretty well defined on the drawing, not a problem.
    - Connectors:
    - 1x 40-pin header: well defined in the drawing, not a problem.
    - 2x micro USB, 1x mini HDMI: location around the outline is defined, but not their size nor how much they stick out
    which I have measured on a real unit.
    - 1x camera FFC: not in the drawing so measured on a real unit.
    - Pleas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
2019-02-12 Connector_Audio: Add Jack_3.5mm_CUI_SJ-3523-SMT_Horizontal/Jack_3.5mm_CUI_SJ-3524-SMT_Horizontal (#1173)
    * Connector_Audio: Add Jack_3.5mm_CUI_SJ-3523-SMT_Horizontal
    * Connector_Audio: Add Jack_3.5mm_CUI_SJ-3524-SMT_Horizontal
    * Fixed NPTHs rotation
2019-02-13 OptoDevice: Add APDS-9306-065 (#1196)
    * OptoDevice: Add APDS-9306-065
    * OptoDevice: Fix APDS-9306-065 3D path, description and ref in fab
    * OptoDevice: Script APDS footprint
    * OptoDevice: Script APDS footprint
    * OptoDevice: Regenerate APDS fp with updated script
    * OptoDevice: Add footprint for APDS-9306
    * OptoDevice: Fix LGA APDS-9306 footprint
2019-02-13 Button_Switch_SMD: Add KSC7 button from CK switches (#755)
    * Button_Switch_SMD: Add KSC7 button from CK switches
    * Button_Switch_SMD: Add KSC6 from CK switches
    * Button_Switch_SMD: Rename KSC6 and KSC7 buttons
    * Button_Switch_SMD: Fix pad sie in KSC6 and KSC7 buttons
    * Button_Switch_SMD: Fix circle size in KSC6 button
    * Button_Switch_SMD: Fix silkscreen offset in KSC6 and KSC7
    * Button_Switch_SMD: Fix courtyard in KSC6 and KSC7
    * Button_Switch_SMD: Fix KSC button naming
    * Button_Switch_SMD: Fix pad possitioning and courtyard in KSC devices
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2019-02-13 Added data sheet links to a number of fuse foot prints and renamed one fuse foot print (#1295)
    * Added datasheet links and renamed Fuseholder_Cylinder-5x20mm_Schurter_0031-8002_Horizontal_Open into Fuseholder_Cylinder-6.3x32mm_Schurter_0031-8002_Horizontal_Open
    * Added datasheet links and renamed Fuseholder_Cylinder-5x20mm_Schurter_0031-8002_Horizontal_Open into Fuseholder_Cylinder-6.3x32mm_Schurter_0031-8002_Horizontal_Open
    * changed the size of the courtyard and the NPTH hole, rotated the pads
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2019-02-13 Scripted UQFN-20 ep1.85 plus correciton for symbol (#1397)
    The only symbol that uses the UQFN footprint would require a normal qfn
    footpritn with 1.65x1.65 ep size.
2019-02-13 Scripted version of wqfn footprints (#1399)
    * Scripted version of wqfn footprints
    * Body tolerance added
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2019-02-13 Scripted version of SOP-4 footprint for isolators (#1385)
    * Scripted version of SOP-4 footprint for isolators
    * Scripted version of SOP-16 for TLP290-4
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2019-02-14 Scripted version of MSOP-16 footprints (#1380)
    * Scripted version of MSOP-16 footprints
    * fix datasheet link
2019-02-21 Add 9 mm Alpha vertical pots (#1388)
    Add 9 mm Alpha single and dual vertical pots (RD901F-40-00D and RD902F-40-00D).
    Including versions with round holes too.
2019-02-21 Add reverse mount 18.4x8mm TSOP-I-32 (#1421)
    * Add reverse mount 18.4x8mm TSOP-I-32
    * Rotate to conform to F4.2
    * Remove rotation amounts
2019-02-25 add Analog CP-16-22 LFCSP-16-1EP footprint (#1353)
    * add Analog CP-16-22 LFCSP-16-1EP footprint
    * LFCSP-16-1EP: updated generator output to review
2019-02-26 Fix courtyard dimensions (were 0.3mm offset)
2019-02-27 Add Myrra EF20 footprint (#1436)
    * Add Myrra EF20 footprint
    Used for 74087, 74088, 74089 flyback transformers.
    * Review mods:
    * Rotate to put pin 1 at top left
    * Keep pins at 0 rotation
    * Pad size to 2.5mm
    * Myrra Datasheet is a bottom view (but it's not on that datasheet)
    * Rename: add _7408x
2019-02-27 Package_SO: Add a new HTSSOP-20-1EP_4.4x6.5mm_P0.65mm_EP3.4x6.5mm_Mas… (#1441)
    * Package_SO: Add a new HTSSOP-20-1EP_4.4x6.5mm_P0.65mm_EP3.4x6.5mm_Mask2.4x3.7mm
    * Package_SO: Fix HTSSOP-20 3D path to not include mask information.
2019-03-04 Fix up footprint for TUSB730
2019-03-14 fix incorrect hole size (#1479)
2019-03-14 Footpritns for Panasonic Batteries Vertical with Circular Holes (#1239)
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2019-03-17 Changed pad size and F.CrtYd in all footprints
2019-03-21 add scripted LFCSP-64-1EP_9x9mm_P0.5mm_EP5.21x5.21mm (#1492)
    * add LFCSP-64-1EP_9x9mm_P0.5mm_EP5.21x5.21mm
    * add 3x3 thermalvias version of footprint
    * 4x4 thermalvias
2019-03-21 Fix IRM-03 THT footprint (#1439)
2019-03-21 Added Molex 105057 USB A vertical connector (#1122)
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2019-03-24 Add QFN-16 3x3mm P0.5mm EP1.75x1.75mm for NCN4555 (#1458)
2019-03-25 Scripted version of non EP SOIC footprints (#1371)
    * Scripted version of non EP SOIC footprints
    * fix datasheet links and lead width
    * Updated with JEDEC definitions
    - added JEDEC spec to description
    - Used JEDEC spec for body width, overall width and lead width
    - Checked body lenght tolerances against JEDEC spec (no change
    necessary)
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2019-03-25 DFN_QFN: Add 10-pin DNF, 3x3mm with 1.7x2.5mm EP (#1498)
    This is very similar to `DFN-10-1EP_3x3mm_P0.5mm_EP1.55x2.48mm` except for a
    slightly different middle pad and smaller side pads.
    This package is used by MPS components such as this one:
    https://www.monolithicpower.com/pub/media/document/MPQ2483_r1.05.pdf
2019-03-25 Fix #1497 mounting hole positions in Keystone 2468 (#1501)
2019-03-31 TLP3123 (#1424)
    * Package SO: Creation SO-4 4.4*3.9mm for TLP3123
    * Package SO: SO-4_4.4x3.9mm_P2.54mm, scripted version
    * Package SO: SO-4 3.9*4.4, update tedit only
2019-03-31 Fix footprint for SOT-353_SC-70-5_Handsoldering (#1513)
2019-03-31 Adding BGA footprint for Analog/LT 28pin BGA (#1494)
    * Adding BGA footprint for Analog/LT 28pin BGA
    * Updated footprint for BGA-28
    filename and footprint name aligned
    Anchor middle of the package
    Keyword and description added
    * Footprint updated as per Travis checks
    Courtyard added
    Footprint and filename aligned
    origin in centre of part
    * Origin set, courtyard set, Ref to Fab
    * Fab outline added
    * re-gridding
    * add pin1 marker, including reference for future 3D wrl
    * Pin1 marker on fab layer, 0.15 width for marker
    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
2019-03-31 Add RAYEX ELECTRONICS L90 Series 30A Relay (#1084)
2019-04-01 Oscillator: Add Abracon ASDMB (#1435)
    * Oscillator: Add Abracon ASDMB
    * Oscillator: Abracon ASDMB fix 3D path
    * Oscillator: Fix Abracon ASDMB description, pin 1 marker and adhesive
    * Oscillator: Fix Abracon ASDMB description, pin 1 marker, refdes and fab layers
2019-04-02 Correct NPTH to 1.27mm (#1520)
    Also fixed the orientation keyword
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2019-04-03 Added the HVSON8 footprint for the NXP PCF8523 (#1524)
    This footprint was auto generated with the kicad-footprint-generator
    https://github.com/pointhi/kicad-footprint-generator/pull/335
2019-04-05 Changed pitch in the name of footprint MR30PW
2019-04-09 Oscillator: Add Oscillator_SMD_DiodesPericom_FN-4Pin_7.0x5.0mm (#1538)
    * Oscillator: Add Oscillator_SMD_DiodesPericom_FN-4Pin_7.0x5.0mm
    * fixed courtyard clearance (0.5mm -> 0.25mm)
    * fix F.Silk clearance
    * added a pin-1 mark at F.Fab layer
    * renamed footprint (dropped the Pericom brand from footprint name)
2019-04-09 Add footprint for RTC RV-1805-C3 (#1505)
    * Add footprint for RTC RV-1805-C3
    * Added RTC.pretty in fp-lib-table
    Changed F.CrtYd and F.SilkS hight
    Updated description and keywords
    * Fix 3D file name
    * Changed F.SilkS to indicate pin 1
    * moved back the slop
    * Inprove identification of pin 1
    * Removed alteration of fp-lib-table
    Moved footprint to Package_SON
    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
2019-04-11 Add RF_WiFi folder and footprint support of USR-C322 3MBps WiFi module
    USR-C322 USR-C322 is a 3Mbps, 2.4GHz IEEE802.11 b/g/n WiFi Module.
2019-04-11 Add Texas RGE0024C footprint (#1395)
    * Add Texas RGE0024C footprint
    * Update RGE0024C EP coverage and datasheet page
2019-04-15 Added USB_A SS-52100-001 connector (#1468)
    * Added USB_A SS-52100-001 connector
    * Moved pin1 to origin
    * Implemented requested changes
2019-04-22 RF_Module: Fix issues of HOPERF_RFM9XW_THT (#1346) (#1347)
    * RF_Module: Fix issues of HOPERF_RFM9XW_THT (#1346)
    * Fix description
    * Removed pin-1 indicator from F.Silk layer
    * added pin-1 mark at F.Silk
    * fixed pin-1 F.Silk thickness
    * performed changes at F.Fab layer
2019-04-23 Add 3.5x3.5mm QFN-20 with 2mm pad. (#1543)
    Also known as TI's S-PVQFN-N20
    Generated by kicad-footprint-generator.
    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
2019-04-29 [RFC] adds BGA packages for Xilinx 7 Artix FPGAs (#1557)
    * adds BGA packages fr xilinx 7 artix fpgas
    * updates the footprints according to the footprint generator feedback
    * updated footprints after generator feedback 2
2019-04-29 Add TI TO-PMOD-11 / NDY0011A (#1532)
    * Add TI TO-PMOD-11 / NDY0011A
    * Add datasheet link
    * Add keywords and link to 3D model
    * Rename footprint to Texas_NDY0011A
    * Move footprint to Package_TO_SOT_SMD
    * fix courtyard to device distance
    * fix 3D model path
    * center footprint
    * add pin 1 marker on silkscreen and fab layer
    * add description
    * fix courtyard offset
    * flip pin 1 mark on fab layer
    * reduce pin 1 mark size
    Pin 1 mark now fits inside part boundary
2019-04-29 fix pin numbering for Omron G6S-2, -2F, and -2G DPDT relays (#1563)
2019-04-30 adds all BGA footprints for Xilinx Spartan-7 FPGAs (#1568)
    * adds all BGA footprints for Xilinx Spartan-7 FPGAs
    * updates Spartan-7 BGA footprints with corrected script
2019-05-01 Add Murata 1200RS inductor footprint (#1472)
    * Add Murata 1200RS inductor footprint
    * Fix Murata 1200RS pads
    * Use correct case in Murata 1200RS name
    * Modify pitch as [pitch_x]x[pitch_y] for Murata 1200RS inductors
2019-05-01 Remove mpn and add height from footprint name
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2019-05-07 Added UDFN-9 package (#1572)
    * Added UDFN-9 package
    See https://media.digikey.com/pdf/Data%20Sheets/Semtech%20PDFs/RCLAMP3328P.pdf
    * Footprint changes
    * Adjusted courtyard
    * Silkscreen adjustments
2019-05-08 adds BGA footprints for Xilinx Virtex-7 FPGAs (#1569)
    * adds BGA footprints for Xilinx Virtex-7 FPGAs
    * rework names of virtex-7 bga footprints according to script pr
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2019-05-09 Fix hole to recommendation (#1587)
    * Fix hole to recommendation
    Second the manufacture datasheet https://omronfs.omron.com/en_US/ecb/products/pdf/en-g5q.pdf the recommend hoel are 1.3mm D and not 1/0.76mm D (with difference between coil and power pins).
    * oversize to 1mm PAD
2019-05-09 Fix hole recommendation (#1588)
    * Fix hole recommendation
    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
2019-05-11 Button_Switch_SMD: improve slide switches descriptions
    Adding missing descriptions or datasheets
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2019-05-19 Add 196-pin Thin Fine Pitch Ball Grid Array, 11 x 11 mm square body, 14 x 14 pins, 0.75 mm pitch, 0.32 mm nominal ball diameter, 0.35 mm land, solder mask defined.
    This footprint is for a Microchip ATSAMA5D21 MPU.
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2019-05-27 Replace manually drawn footprint with footprint generated from kicad-footprint-generator
    Need clarification on parameter 'mask_margin'
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2019-05-28 use maximum radius of 0.1mm for paste pads
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2019-05-30 Create footprint for C&K switch PTS125SM43SMTR2-LFS (#1495)
    * Create footprint for C&K switch PTS125SM43SMTR2-LFS
    This is a footprint for PTS125 series SMT switches from C&K. For example, this footprint is good for PTS125SM43SMTR2-LFS particular switch.
    * Trying to solve travis indicated issues
    * Adding tags
    * Fix Fabrication Layer related errors on travis
    Fabrication layer requirements
    No drawings found on fabrication layer
    Second Reference Designator missing
    - Add RefDes to F.Fab layer with '%R'
    * Fixing Travis error
    Violating F5.2
    Fabrication layer requirements
    No drawings found on fabrication layer
    * Fixing Travis error
    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
2019-06-01 SJ1-3535NG stereo 3.5mm audio jack with switch (#1262)
    These footprints are meant to be used with the AudioJack3_SwitchTR
    library symbol.
    This jack is identical to the SJ1-3533NG jack already in the footprint
    library, except that the SJ1-3535NG contains two switches (and thus
    has 5 pins instead of 3).
    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
2019-06-01 add AD cp-32-2 footprint for LFCSP-32 package (#1426)
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2019-06-02 add footprint for E-Switch TL1250 (#1438)
    push button with included LED. The pin numbering is changed from the
    datasheet to match the generic SW_Push_LED symbol.
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2019-06-06 Fix courtyard clearances for scripted no lead footprints with pull back pins (#1630)
    * Fix courtyard clearances for scripted LGA footprints
    * Fix courtyard clearances for scripted no-lead pull back
2019-06-07 Add Linear Technology (Analog devices) MSOP-16 footprints (#1349)
2019-06-10 Fix pad orientation of SW_Push_1P1T_NO_CK_KMR2 (#1593)
    The pads of this footprint are wrongly rotated by 90°. This means the pad size is off by 0.1 mm in each axis. This probably doesn't matter in practice, but still...
2019-06-13 fixing partnumber of Slimstack 52991 connectors (#1642)
2019-06-15 Rename footprint: remove trailing decimals from package size
2019-06-15 Replace with latest generated footprint from https://github.com/pointhi/kicad-footprint-generator/pull/381/commits/7fe396ad92bcb4d2de6f01179273fd628acd5ab6
2019-06-18 Package_DFN_QFN: Add Texas R-PVQFN-N24 (#1460)
    * Package_DFN_QFN: Add Texas R-PVQFN-N24
    * Package_DFN_QFN: Fix pad sizes and silkscreen in R-PVQFN-N24
    * Package_DFN_QFN: Redo Texas RGY package
    * Package_DFN_QFN: Rename Texas RGY to include more information
    * Package_DFN_QFN: Fix Texas RGY issues
    * Package_DFN_QFN: Fix Texas RGY Mask on B.Cu
2019-06-20 add LFCSP-20-1EP_4x4mm_P0.5mm_EP2.6x2.6mm (#1653)
    * add LFCSP-20-1EP_4x4mm_P0.5mm_EP2.6x2.6mm
    generated using the footprint-generator
    matching PR: https://github.com/pointhi/kicad-footprint-generator/pull/385
    * update footprints based on generator review
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2019-06-20 added FFC molex series 502231 (#1636)
    * added FFC molex series 502231
    * move footprint on Y axis
    * fixed SH pad corner radius
    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
2019-06-21 added Texas_S-PVQFN-N16_EP2.1x2.1mm footprint (#1641)
    * added Texas_S-PVQFN-N16_EP2.1x2.1mm footprint
    * renamed Texas_S-PVQFN-N16_EP2.1x2.1mm.kicad_mod to Texas_RGV.kicad_mod
    * renamed Texas_S-PVQFN-N16_EP2.1x2.1mm_ThermalVias.kicad_mod to Texas_RGV_ThermalVias.kicad_mod
    * removed Texas_S-PVQFN-N16_EP2.1x2.1mm.kicad_mod and Texas_S-PVQFN-N16_EP2.1x2.1mm_ThermalVias.kicad_mod
    * fixed footprint name in file for Texas_RGV.kicad_mod and Texas_RGV_ThermalVias.kicad_mod
    * renamed footprints
    * renamed footprint to Texas_RGV_S-PVQFN-N16_EP2.1x2.1mm.kicad_mod and Texas_RGV_S-PVQFN-N16_EP2.1x2.1mm_ThermalVias.kicad_mod
    * updated footprint
2019-06-25 update Hirose DF63 connector series (#1649)
    * fix hirose df63-1p footprint
    * add complete hirose df63 series
    * update footprints
2019-06-30 Increase hole size to 1.3mm (#1667)
    * Increase hole size to 1.1mm
    * update to 1.3mm as per @ evanshultz
2019-07-03 Infineon qfn64 (#1666)
    * Add Infineon Merus footprint
2019-07-09 New Footprint Converter_DCDC_Murata_MGJ2DxxxxxxSC_THT for MGJ2DxxxxxxSC (#1658)
    * NEW: MGJ2DxxxxxxSC
    * rename to Converter_DCDC_Murata_MGJ2DxxxxxxSC_THT
    * rename to MGJ2DxxxxxxSC_THT and update of the 3d model reference
    * Update Converter_DCDC_Murata_MGJ2DxxxxxxSC_THT.kicad_mod
    Fix description and chamfer on the fab layer
    still TODO: silk, Courtyard and holes
    * not ready for review (some updates)
    Update Vertex and Courtyard
    * Finish Footprint
    - extra description
    - hole: size 1mm, pad: 1.7 mm round
    - fixed chamfer on the fab layer
    - courtyard offset
    - text position (now centered)
    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
2019-07-12 Close courtyard (#1688)
    * Close courtyard
    * Simplify bottom part of courtyard
    Added solder paste layer to Pin 2
2019-07-15 Connector_Hirose: Add DF11 series (#1670)
    * Connector_Hirose: Add DF11 series
    * Connector_Hirose: Fix DF11 naming
    * Connector_Hirose: Fix DF11 descriptions and hole sizes
    * Connector_Hirose: Update all footprints to the latest generated version
    * Connector_Hirose: Delete wrongly named old footprints
    * Connector_Hirose: Fix duplicated silks in DF13 tht horizontal fps
    * Connector_Hirose: Fix silks overlap in DF13 tht top
2019-07-23 Fix courtyard HJR-4102 Relay (#1734)
    * Fix courtyard HJR-4102 Relay
    * changed HJR-4102 courtyard to accomplish with offset rule
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2019-07-25 LED-APA102-2020: Move F.Fab marker (#1742)
    This Package has no Pin1 marker, but a white dot at Pin3 which leads
    to confusion during assembly.
    Similar to the LED_SK6805_PLCC4 Footprint the Silkscreen and Fab layer
    marking have been moved to Pin3, and a Pin1 text was added on F.SilkS.
2019-07-25 Add QFN-20-1EP_5x5mm_P0.65mm_EP3.1x3.1mm (#1745)
    * Add QFN-20-1EP_5x5mm_P0.65mm_EP3.1x3.1mm
    * Rename to TQFN
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2019-07-26 Added HRO TYPE-C-31-M-12 (#1631)
    * Added HRO TYPE-C-31-M-12
    * Fix fab attribute and 3D model
    * Fixed various issues with HRO TYPE-C-31-M-12
    * Fixed small courtyard and fab issue
    * Small fixes
    * Fix connector courtyard to exactly 0.5mm
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2019-07-28 HRO_TYPE-C-31-M-12: remove USB symbol on Fab layer (#1751)
    USB type-C symbol removed from Fab layer which would go against
    F5.2.1.b of KLC at http://kicad-pcb.org/libraries/klc/F5.2/
    Pointed out on https://github.com/KiCad/kicad-footprints/pull/1631#issuecomment-515557184
    by @evanshultz
    Also, "%R" moved to exactly 0,0 for simplicity. It was close but not quite.
2019-07-29 Add Finder 36.11 10A SPDT relay footprint (#1728)
    * Add Finder 36.11 10A SPDT relay footprint
    * Fix KLC violations
    * Fix A1 hole size
    * Fix description, text, pad orientation, courtyard
2019-07-31 add QFN-28-1EP_4x4mm_P0.4mm_EP2.6x2.6mm
    generated with the footprint generator:
    https://github.com/pointhi/kicad-footprint-generator/pull/406
2019-08-07 LED_Osram_LxP47F reverse mount LED (#1767)
    * created LED_Osram_LxP47F reverse mount LED
    * Renamed orientation after the dimension
    moved pads 1&2
    change REF** thickness on F.Fab
    changed silkscreen
    removed overlapping copper
    * removed number from solder mask only pads
    * matched arcs.
    * made all F.Fab lines intersect
    * fixed intersect strange numbers
    * fixed silkscreen arcs
    * fixed 3d model name
    * renamed
    * added more to description field
    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
2019-08-08 add SMA connector Molex 73251-2120
    used the existing 73251-1153 as a reference. Chose the board egde as
    reference for the origin. This makes it easier to align the component
    with the board edge, and there is no clear center of the component.
    violations due to missing layers on the back pins which are on purpose.
2019-08-08 add fuse Schurter UMT250 (#1769)
    * add fuse Schurter UMT250
    * UMT-250: improve description & fix roundrect radius
2019-08-08 add Mini-Circuits DB1627 (#1762)
    * add Mini-Circuits DB1627
    generated using the footprint generator
    * DB1627: manually adjust pad shapes to Mini-Circuits values
    * DB1627: cleanup description & fix courtyard
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2019-09-01 Footprint for TDFN-6 2.5x2.5mm Pitch 0.65mm Pad 2.0x1.3mm (#1647)
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2019-09-02 Add footprints for XT60 male and female connectors. (#1794)
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2019-09-06 add footprint for Schaffner FN406 EMI filter (#1783)
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2019-09-10 Fix DirectFET S1 Fab and Courtyard
    Followup to https://github.com/KiCad/kicad-footprints/pull/1825
    Further information should not be required
2019-09-10 Fix DirectFET S2 Fab and Courtyard
    Followup to https://github.com/KiCad/kicad-footprints/pull/1826
2019-09-10 Fix DirectFET SH Fab and Courtyard
    Followup to https://github.com/KiCad/kicad-footprints/pull/1824
2019-09-10 Fix DirectFET SJ Fab and Courtyard
    Followup to https://github.com/KiCad/kicad-footprints/pull/1823
2019-09-10 Fix DirectFET SQ Fab and Courtyard
    Followup to https://github.com/KiCad/kicad-footprints/pull/1822
2019-09-10 Fix DirectFET ST Fab and Courtyard
    Followup to https://github.com/KiCad/kicad-footprints/pull/1820
2019-09-11 Fix DirectFET L8 silk and courtyard
    Followup to https://github.com/KiCad/kicad-footprints/pull/1832
2019-09-11 Fix DirectFET MN fab and silk
    https://github.com/KiCad/kicad-footprints/pull/1830
2019-09-11 Fix DirectFET MP fab and silk
    https://github.com/KiCad/kicad-footprints/pull/1829
2019-09-11 Fix DirectFET MT fab and silk
    https://github.com/KiCad/kicad-footprints/pull/1827
2019-09-11 Fix DirectFET MX fab and silk
    https://github.com/KiCad/kicad-footprints/pull/1828
2019-09-11 Fix DirectFET MZ fab and silk
    https://github.com/KiCad/kicad-footprints/pull/1831
2019-09-15 Close courtyard of Omron B3F-10xx tactile switch. (#1856)
    * Properly close courtyard of `SW_TH_Tactile_Omron_B3F-10xx`.
    * Change `SW_TH_Tactile_Omron_B3F-10xx` pin number to match SPST form.
    * Fix courtyard clearance of `SW_TH_Tactile_Omron_B3F-10xx` to be 0.25mm.
2019-09-17 Add Dialight 591 series (#1779)
    * Add Dialight 591 series
    * Add missing %R
    * Rotate footprint 180º
    Fix some dimentions
    * Fix F.CrtYd
2019-09-17 Fix MicroMELF footprints (#1835)
    * Correct MicroMELF pads to match datasheet
    - Update to current datasheet
    - Specify the footprint is for the reflow soldering drawing
    - Also update both MicroMELF footprints to have 0.1mm fab line width and adequate 0.12mm silk-to-pad clearance
    * Update MicroMELF handsoldering body size
    * Fix spelling of "hand"
2019-09-20 Fix SW_TH_Tactile_Omron_B3F-10xx pin numbering (#1867)
    Restore pin numbers from pre #1856
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2019-09-22 Rename footprint because of Microchip peculiarities, per https://github.com/KiCad/kicad-footprints/pull/1604#issuecomment-503187926
2019-09-22 Use datasheet recommended by https://github.com/KiCad/kicad-footprints/pull/1604#issuecomment-503187926
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2019-09-22 Package_SO: Add TSOP-6_1.5x2.9mm_P0.95mm (#1511)
    This package is used by NXP as described here:
    https://www.nxp.com/packages/SOT457
2019-09-22 Revert "Package_SO: Add TSOP-6_1.5x2.9mm_P0.95mm (#1511)"
    This reverts commit aa6587bd6b904a238f2d672397c6de793c734fc3.
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2019-09-28 Add Wago 236 series "2-pin per potential" terminal blocks (#1752)
2019-09-28 Fix Wago 236 series 1-pin terminal blocks (#1753)
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2019-09-29 Inductor_SMD: Add Sumida CDMC6D28 SMD Power Inductor Series (#1721)
2019-09-29 Inductor_SMD: Add Bourns SRP7028A Shielded Power Inductors Series (#1731)
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2019-10-04 Remove pad size from footprint name per https://github.com/KiCad/kicad-footprints/pull/1604#issuecomment-536716957
2019-10-05 Add FC source files for footprints with complex pad shapes (#972)
    [Infineon_PG-LLGA-5-1.FCStd, L_Wuerth_WE-TPC-3816.FCStd]
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2019-10-06 Jst b2p3-vh (#1662)
    3 pin housing with pin 2 missing
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2019-10-06 new Tantalum packages from AVX F72 und F75 series (#1892)
2019-10-07 Add MQ-6 Gas Sensor (#1883)
    * Add MQ-6 Gas Sensor
    * Add Sensor_Gas functionality to table
    * Revert "Add Sensor_Gas functionality to table"
    This reverts commit a4a7235e0696d2e8dd0838ff741d3262f42986c3.
    * Revert "Add MQ-6 Gas Sensor"
    This reverts commit a0b45cbb0d2d9be77e519bd9caa68f0903ca3281.
    * Add MQ6 to generic sensor lib
    * changed 3d model path
    * changed courtyard clearance
2019-10-08 Replace MSOP-8_3x3mm_P0.65mm with scripted version
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2019-10-10 Fix EP round radius for LFCSP footprints
2019-10-10 Fix EP radius and resync of LGA footprints
2019-10-10 Fix EP round radius for QFN footprints
2019-10-10 Fix EP round radius of DFN footprints
2019-10-10 Fix EP round radius for xQFN footprints
2019-10-10 Also add xDFNs and MLF footprints to this pull request
2019-10-11 add L_Bourns-SRU1028 (#1916)
    * add Bourns 1028
    * renamed part and fixed dimension
    * added RefDef on F.Fab
    * radius and datasheet
    * edge 3.4mm
    * fixed vertical 3.4mm
    * horizontal CrtYd and pads without offset
    * RefDes was mislocated
2019-10-11 Inductor_SMD: Add Murata LQH2MCN_02 Chip coil (Chip Inductors) Series (#1774)
    * Inductor_SMD: Add Murata LQH2MCN_02 Chip coil (Chip Inductors) Series
    * Change description
    * rename footprint appending body dimensions
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2019-10-15 Adds EC15 (1.5x1.5mm) Footprint for SK6812 LED (#1921)
    * initial SK6812_EC1515
    * fix silkscreen label and 3d model name
    * fix 3d model path
    * rename from ec1515 to ec15
    * remove _P0.9mm from name
    * add pin4 marker to fab layer
    * add arrow pointing towards pin2
    * silkscreen pin1 marker, smaller REF** on F.Fab
    * adds "1" as pin 1 marker, move marker to pin 4, fix F.Fab layer
    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
2019-10-19 Fixed coin cell holder negative contact size, removed from paste layer (#1898)
    * Fixed coin cell holder negative contact size, removed from paste layer
    * Fixed silkscreen-pad conflict for 3034
    * Fixed silkscreen-pad conflict for all footprints
    * Fixed silkscreen thickness
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2019-10-24 Add Taiyo-Yuden NR 10050 inductor footprint with handsoldering variant. (#1927)
    * Add Taiyo-Yuden NR 10050 inductor footprint with handsoldering variant.
    * Reduce courtyard line width to 0.05mm and add paths to a theoretical 3D model.
    * Increase courtyard size.
    * Add inductor size to name and fix typo in description fields.
    * Remove four older footprints with incorrect naming.
    Rotate simplified outline on F.Fab.
    Change X coord of Ref Des on silk to 0.
    Add datasheet link in description.
    Fix 3d file names.
    Change names of footprints to better match convention (WxL vs LxW).
    * Adjust F.Fab outline to be nominal size rather than max.
    * Make F.Fab courtyard a bit smaller and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
2019-10-26 Add LFCSP-WD, 10 Pin (#1931)
    * Add LFCSP-WD, 10 Pin
    * update changes made in script
2019-10-27 Adding TE 1734839 script generated FPC connectors (#1939)
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2019-10-27 Merge overlapping pads (#1709)
    * Change overlapping pads to single custom pad
    * Remove weird LFPAK56 footprints
    These have vias outside the package body and this should be implemented as a design-specific thing either in a custom library or as part of a specific board instead of in these unique footprints.
2019-10-28 Connector_Coaxial: Fix and enhance SMA_Samtec_SMA-J-P-H-ST-EM1_EdgeMount (#1928)
    * change footprint orientation
    * fix courtyard clearance
    * add silk
    * add the missing description and update tags
    * add board thickness on Cmts.User
    * elongated pcb edge line
    * reduced the size of pin 1 mark on fab layer
    * rename footprint (SMA_Samtec_SMA-J-P-H-ST-EM1_EdgeMount -> SMA_Samtec_SMA-J-P-X-ST-EM1_EdgeMount)
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2019-11-03 Adding IDT oscillator JS6 package footprint (#1919)
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2019-11-03 Added AA battery holder - Keystone 2460 (#1565)
2019-11-05 Connector Abracon RJ45 ARJP11A-MA (#1940)
    * Filter
    Added Johanson Balun 1.6 x 0.8 mm filter footprint.
    * Filter
    Changes according to Travis recommendations: second reference designator, courtyard lines grid matching, footprint anchor.
    * Filter
    Footprint anchor correction.
    * Filter
    Footprint anchor correction again.
    * Filter
    Footprint anchor correction again...
    * RF_Converter
    Changed library of footprint being added from Filter to RF_Converter.
    * RF_Converter
    Changed courtyard size to provide 0.25 mm clearance from every side. Changed pin 1 indication, changed old indication to Fab layer.
    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
2019-11-05 Create RJ25_Wayconn_MJEA-660X1_Horizontal.kicad_mod (#1936)
    * Create RJ12_A.kicad_mod
    * RJ12_A.kicad_mod: changed grid origin and added square pad for pin 1
    * improved RJ12_A footprint
    fixed fab and silkscreen reference placement, added fab outline, description, search words
    * improved RJ12_A footprint
    fixed footprint location with respect to origin, exact pin spacing
    * fixed RJ12_A courtyard
    * Update and rename RJ12_A.kicad_mod to RJ12_YT2038Y_Horizontal.kicad_mod
    also updated descripton of RJ12_YT2038Y_Horizontal
    * fixed RJ12_YT2018Y_Horizontal footprint issues
    moved silkscreen outline to not overlap with fab outline;
    changed connection pad diameter to 0.9mm;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
2019-11-07 Adding IDT oscillator JU6 package footprint (#1918)
2019-11-09 Added Johanson Balun 1.6 x 0.8 mm filter footprint (#1539)
2019-11-14 Added generic buzzer 14D, 7mm height, P10mm (#1864)
    * Added generic buzzer 14D, 7mm height, RM10mm
    * changed name compliant with name convention
    * Changed 3D model name
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2019-12-27 Added SOD-923 footprint (#1999)
    * Added SOD-923 footprint
    Datasheet: https://www.onsemi.com/pub/Collateral/ESD9B-D.PDF
    * Fixed front courtyard and datasheet link.
    * Coutyard should take pads into account, and silkscreen clearance at least line width.
    * Fix courtyard in 0.01mm grid
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2020-01-03 add Alps SKRTLAE010 horizontal push button (#1889)
    * add Alps SKRTLAE010 horizontal push button
    * SKRT: add -MP to name
    * SKRTLAE010: integrate review feedback
2020-01-05 Add missing non thermal vias footprint for LMZM23601
2020-01-05 Add DFN-4 for Sensirion SHTC3 humidity sensor (#1946)
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2020-01-05 Battery: Add the 6.8mm Keystone 2998 coin cell holder (#1469)
    The datasheet is avaliable here: www.keyelco.com/product-pdf.cfm?p=763
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2020-01-16 Add Murata MEE isolated DC/DC SIP footprints (#1696)
2020-01-18 Add Diodes U-DFN2510-10 footprint (#1978)
    * Create Diodes UDFN-10 footprint
    * Add reference to 3d shape (currently not present)
    * Add doc to description
    * Fix courtyard
    * Reverse 3d model dimensions
2020-01-22 Added SOT-523 footprint, modified from SOT-553 (#2027)
    * Added SOT-523 footprint, modified from SOT-553
    * Requested changes from chschlue completed
    * Moved courtyard in to 0.25mm
2020-01-24 Fix TC2050-IDC-NL courtyard and added front silkscreen.
2020-01-24 Added TC2050-IDC-NL with bottom courtyard for TC2050-NL clip board.
2020-01-28 Added WSON-10-1EP_2.5x2.5mm_P0.5mm_EP1.2x2mm. (#2012)
    * Added WSON-10-1EP_2.5x2.5mm_P0.5mm_EP1.2x2mm.
    Datasheet: http://www.ti.com/lit/gpn/tps63030
    Generated by script, using PR https://github.com/pointhi/kicad-footprint-generator/pull/453
    * Regenerated footprint after script change, using PR:
    https://github.com/pointhi/kicad-footprint-generator/pull/422
2020-01-29 Added footprint for DFN-8-1EP_2x2mm_P0.5mm_EP0.7x1.3mm. (#2004)
    * Added footprint for DFN-8-1EP_2x2mm_P0.5mm_EP0.7x1.3mm.
    Datasheet: https://www.onsemi.com/pub/Collateral/NUF4401MN-D.PDF
    * Regenerated footprint after script change:
    * Regenerated footprint after data change:
    https://github.com/pointhi/kicad-footprint-generator/pull/452/commits/99f5befc15ded297d39f994aed9910012b561679
    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
2020-02-04 Added QFN-32-1EP_5x5mm_P0.5mm_EP3.3x3.3mm. (#2011)
    * Added QFN-32-1EP_5x5mm_P0.5mm_EP3.3x3.3mm.
    Generated by script, using PR: https://github.com/pointhi/kicad-footprint-generator/pull/458
    Datasheet: http://ww1.microchip.com/downloads/en/DeviceDoc/00002164B.pdf
    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
2020-02-04 Added Johanson 2450AT18x100 and 2450AT43F0100. (#2067)
    These footprints were generated using:
    https://github.com/pointhi/kicad-footprint-generator/pull/492
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2020-02-06 Added 9V battery holder BA9VPC made by MPD (#1659)
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2020-02-07 Add more Maxim 5x5mm TQFN footprints #470 (#2008)
    * Add thermal vias to all TQFN packages
    * Add missing Maxim Txx55 5x5mm TQFN scripted footprints
    This adds all footprints from the Maxim 21-0140 datasheet that were not
    already added.
    * Regenerate TQFN footprints with updated size_sources
    One url was fixed, the others have package outline numbers added to the
    url.
    Script PR: https://github.com/pointhi/kicad-footprint-generator/pull/470
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2020-02-09 Hvqfn 24 (#2077)
    * Add HVQFN-24 4x4mm P0.5mm EP2.6x2.6mm
    * Regenerate footprint
    Moved the the right folder
2020-02-13 Addition of footprint for JTD series of DC-DC Converters from XP Power (#2084)
    * Addition of footprint for JTD series of DC-DC COnverter from XP Power (JTD15 & JTD20)
    * Rotated Part, Moved Fab Text & reduced hole sizes
    * Fixed footprint origin (accidentally moved on rotate)
2020-02-14 Fix JTD DC-DC COnverter Footprint (continuation from PR #2084) (#2092)
    * - rotation of all pads are now 0 degrees
    - Pin 1 changed to roundrect
    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
2020-02-14 Addition of XP Power RPA60-FW Series of DC-DC Converters (#2085)
    * Addition of Recom RAP60-FW Series of 60W DC-DC Converters
    * remove files from another branch as I forgot to start from the master branch
    * Rotated footprint so pin1 is in top left & moved fab text to bottom of (rotated) footprint
    * - all pads now have rotation of 0 degrees
    - Pin 1 changed to roundrect style
    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
2020-02-15 Added TSSOP variants as specified in JEDEC MO-153. (#2090)
    * Added TSSOP variants as specified in JEDEC MO-153.
    All are generated using the ipc-gullwing-generator.
    * Corrected JEDEC TSSOP 8mm body width overall package width.
    * TSSOP JEDEC MO-153: Regenerated after correcting overall package width tolerance.
2020-02-15 Addition of Texas Instruments DC-DC Converter Modules PTN78000 (1.5A)… (#2083)
    * Addition of Texas Instruments DC-DC COnverter Modules PTN78000 (1.5A), PTN78020 (6A) & PTN78060 (3A)
    * Fixed errors as per travis Output (incorrect line widths, comma in tags & a contruction ine I forgot to delete
    * Fixed some minor dimension errors
    * Moved footprint name down to bottom of footprint
2020-02-18 Added footprint for ST VL53L1x distance sensor (#1995)
2020-02-21 Add TQFN-48 7x7mm (#1988)
    * Add footprint TQFN-48
    * updated with lastest version of script
    * update footprint with fixed script
2020-02-21 Add WQFN-42-1EP_3.5x9mm_P0.5mm_EP2.05x7.55mm (#2101)
    DS: http://www.ti.com/lit/ds/symlink/ts3l501e.pdf#page=23
    Sym: https://github.com/KiCad/kicad-symbols/pull/2505
    Script: TBD
2020-02-22 Generate MSOP-8_3x3mm_P0.65mm using fine pitch definitions (#2102)
    Fixes #2082
2020-02-22 Generate P0.65mm gullwing packages using fine pitch defs (#2103)
    See https://github.com/KiCad/kicad-footprints/issues/2082
    * Fix PQFP
2020-02-23 Add footprints for Cyntec DC/DC modules MUN12AD0x-SH (#2100)
2020-02-25 Lightpipe_LPF-C012303S is not virtual (#2105)
    The device will be placed onto the board. Most likely manually, but it will be
    assembled and thus should not be virtual (KLC F8.1)
2020-02-27 Fixed wrong pin spacing in Choke_Schaffner_RN202 and missing pins in Converter_DCDC_XP_POWER-ITxxxxxS_THT (#2079)
    * Fixed wrong Y pin spacing of Choke_Schaffner_RN202
    Y pin spacing before was 10mm and has been fixed to 15.2mm.
    * Fixed missing pads required for XP Power ITQ series
    Current footprint Converter_DCDC_XP_POWER-ITxxxxxS_THT is incompatible for linked XP Power ITQXXXXS(A) series as pins 5 and 8 are missing. For ITQXXXSA (single output) series these pins are not used but physically there while for ITQXXXXS (dual output) series pin 8 is required for negative output voltage.
    Changes:
    1. Added missing pads for pin 5 and 8
    2. Updated the link of both ITX and ITQ series data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
2020-02-27 Renaming of Texas PTN Series footprints to generic module names (#2108)
    * Renamed Texas PTN series of DC-DC converter modules to the generic TI module names (PTN78000 is now EUS, PTN78020 is now EUK & PTN78060 is now EUW
    All footprints have been moved to the Modules library as they may not necessarily be used for DC-DC Converters
    * Added modules
    * Added some keywords
    * Rem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
2020-03-06 Add scripted footprints for castellated two terminal fuses (#2128)
    Same general rule as for diodes and LEDs.
2020-03-06 Added footprint for lightpipe Mentor Components 1275-x00x. (#1964)
    Datasheet: https://www.mentor-bauelemente.de/produktpdf/?katalog=ll&pdf=ll14-41.pdf&id=37
2020-03-06 Correct polarity of Yuji 5730 led (#1948)
2020-03-06 Filter: Add 1FPxx - EMI filter (#1966)
2020-03-11 Relay: Add Panasonic AD11 Form A (#1638)
    * Relay: Add Panasonic AD11 Form A
    * Relay: Fix AD11 3D paths
    * Relay: Re-fix AD11 3D path
    * Relay_THT: Rotate footprint of AD11
    * Relay_THT: Unrotate ADW11 pad
    * Relay_THT: Rename ADW11 fp to conform to naming standards
    * Update 3D model path
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2020-03-12 Create Converter_DCDC_TRACO_THD_15-xxxxWIN_THT.kicad_mod (#2124)
    * Create Converter_DCDC_TRACO_THD_15-xxxxWIN_THT.kicad_mod
    * Fix F4.2 by rotating part
    * Fix dimension of outlines
    * Rotate REF** labels and place all labels as requested
2020-03-14 Converter_DCDC_TRACO_TDN_5-xxxxWISM_SMD adjusted pad sizes to IPC-7351 standard using library expert pro, changed pads to have no rotation
    Adjusted F.Silk to have 0.2mm margins from pads and to be outside of F.Fab
    Added fab pin 1 indication via bevel
    Adjusted courtyard to be 0.25mm from pads and fab lines
2020-03-15 Add USB Micro-B connector Amphenol 10104110 (#2110)
    * Add USB Micro-B connector Amphenol 10104110
    * Fixed footprint name and F6.2 violation.
    * More fixes
2020-03-16 Added relay Omron G2RL (#2145)
    * Added relay Omron G2RL
    * Fix courtyard corner
2020-03-17 Added HTSSOP-14-1EP_4.4x5.0mm_P0.65mm_EP3.4x5.0mm_Mask3.0x3.1mm (#2144)
    Generated using: https://github.com/pointhi/kicad-footprint-generator/pull/510
    Datasheet: http://www.ti.com/lit/ds/symlink/lm5161.pdf#page=34
    Package drawing: http://www.ti.com/lit/ml/mpds370/mpds370.pdf
    Custom TI name: R-PDSO-G14 (PWP)
2020-03-17 Fix SiliconLabs_QFN-20-1EP_3x3mm_P0.5mm naming (#2139)
    see #1989
    depends on https://github.com/KiCad/kicad-symbols/pull/2545
2020-03-17 Add switch C&K JS202011JCQN (#2127)
    * Add SMD DPDT switch C&K JS202011JCQN.
    * Swapped the pad numbers. This makes pin 1 the top left pad.
2020-03-17 Added Bourns SRP5030T SMD inductor. (#2143)
    * Added Bourns SRP5030T SMD inductor.
    Datasheet: https://www.bourns.com/data/global/pdfs/SRP5030T.pdf
    Generated using: https://github.com/pointhi/kicad-footprint-generator/pull/509
    * Removed manually the empty string in silkscreen.
2020-03-17 Added Omron B3FS tactile switch series. (#2052)
    * Added Omron B3FS tactile switch series.
    Datasheet: https://omronfs.omron.com/en_US/ecb/products/pdf/en-b3fs.pdf
    * Added datasheet link to description field
    * Added pin 1 location mark in silkscreen.
    * Fixed courtyard to be 0.25mm away from the body
    * Fixed silkscreen line thickness
2020-03-19 added ESP32-S2 SoC Module (#2141)
    * added ESP32-S2 SoC Module
    * fixed errors from check script
    * Pads 40/41 in wrong order
    * REF got changed to U1 (editing from pcbnew?)
    * add reference to not existing as of yet 3d model
    * fix EPAD size
    * moved silk completely clear of Fab
    * fix pad orientation along bottom edge
    * fixed fab line length
    * fixed courtyard spacing
    * include url in description
    * Adjust bottom silk alignment for consistency, move 0.2mm away from pads per KLC, add pin 1 indicator to silk and fab, add 5 pin silk markings to aid in debugging
2020-03-19 Added footprint for CUI CMT-8504-100-SMT (#2134)
    * Added footprint for CUI CMT-8504-100-SMT
    * Added footprint for CUI CMT-8504-100-SMT.
    Datasheet: CUI_CMT-8504-100-SMT
    * Adjust courtyard and change 3D model from stp to wrl
    * Fixed courtyard and 3D model name
    * Added footprint for CUI CMT-8504-100-SMT
    * Added footprint for CUI CMT-8504-100-SMT.
    Datasheet: CUI_CMT-8504-100-SMT
    * Adjust courtyard and change 3D model from stp to wrl
    * Fixed courtyard and 3D model name
    * Added polarity mark in silkscreen and datasheet link to description field
    * Added footprint for CUI CMT-8504-100-SMT
    * Added footprint for CUI CMT-8504-100-SMT.
    Datasheet: CUI_CMT-8504-100-SMT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
2020-03-19 Added Maxim WLP-9 footprint (#2142)
    * Added Maxim WLP-9 footprint
    * Changed value and 3D model name
2020-03-19 Create Molex_Pico-SPOX_87437-1443_1x14-P1.5mm_Vertical.kicad_mod (#2122)
    * Create Molex_Pico-SPOX_87437-1443_1x14-P1.5mm_Vertical.kicad_mod
    * Fix datasheet URL
    * Fix SilkScreen position
    * Fix pad spacing and fab line
    * Add pin 1 indicator
    * Extended fab lines through part for better visibility of part outline
    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
2020-03-19 Connector_BarrelJack: Add CLIFF FC681465S DC socket (#2112)
    * Connector_BarrelJack: Add CLIFF FC681465S DC socket
    * Connector_BarrelJack: Correct FC681465S pin numbering
    * Connector_BarrelJack: Replace datasheet URL with a correct one
    * Add pin 1 indicator to silk
2020-03-19 Add USB-B connector Lumberg 2411 02 (#2097)
    * Added USB connector Lumberg 2411 02
    * Fixed CrtYd line.
    * Rotated 90° CCW to have pin 1 at the top left corner (F4.2).
2020-03-20 Add Würth 7499010001A RJ45 connector (#2113)
    * Add Würth 7499010001A RJ45 connector
    * Add LEDs to description of RJ45_Wuerth_7499010121A_Horizontal
2020-03-20 ASMB-KTF0-0A306 Again (#2155)
    * ASMB-KTF0-0A306 Again
    * Corrections
    * Correction to ',' tag
    * Add datasheet to part description
    * Shift silk screen to be 0.2mm away from pads. Fix pad locations to match datasheet.
2020-03-20 Add RJ45-Molex vertical connector footprint (#2157)
    * Add RJ45-Molex vertical connector footprint
    The Molex 85513 series is a surface-mount only (no mechanical via/holes)
    RJ45 unshielded vertical plug. Product webpage at
    https://www.molex.com/molex/products/part-detail/modular_jacks_plug/0855135013.
    * fix build errors
    Fix errors for https://travis-ci.org/github/KiCad/kicad-footprints/builds/664247247:
    - change Ref** to REF**
    - change line width in F.Fab
    - move footprint by (-.3,0)mm
    - add wrl model path
    * decrease courtyard size to 0.5, increase silk distance
    - the distance of the courtyard was previously calculated from the silk
    layer, not the actual connector
    - inc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
2020-03-21 Adds Connector RJ11 Connfly DS1133-S4 (#2126)
    * Adds Connector RJ11 Connfly DS1133-S4
    * change pad size
    * travis findings
    * Review changes
    * moves silk
    * better gap silk fab
    * Increase mounting hole size from 2.2 to 2.3mm to match recommended datasheet footprint. Move silk slightly away from mounting holes.
    * Fix courtyard to go around the mounting holes.
    * Change courtyard to arch around mounting holes
    * Add Pin1 marker on fab layer
    * Review fixes
    rename to RJ14
    add orientation to designator
    move pin1 marker closer to silk
    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
2020-03-22 Add Murata 78250JC (#2154)
    * Add Murata 78250JC footprint
    * Fixed Murata 78250JC footprint
    * Fixed Murata 78250JC footprint again
    * Add future 3D model path to Murata 78250JC footprint
    * 3D model path in Murata 78250JC footprint is now wrl
    * Addressed https://github.com/KiCad/kicad-footprints/pull/2154#pullrequestreview-378004542
    * Addressed https://github.com/KiCad/kicad-footprints/pull/2154#issuecomment-601687105
    * Move silk inside of courtyard and outside of fab to avoid potential uneven parts on the pcb
2020-03-22 Small fixes on some USB connectors (#2161)
    USB3_A_Plug_Wuerth_692112030100_Horizontal
    USB_A_CNCTech_1001-011-01101_Horizontal
2020-03-22 Create RJ45_Wuerth_7499111446_Horizontal.kicad_mod (#2118)
    * Create RJ45_Wuerth_7499111446_Horizontal.kicad_mod
    * Fix F7.2 and F9.3
    * Fix F5.3
    * Rotate part
    * Fix silkscreen and courtyard
    * Expand pad size of holes to match other jacks
    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
2020-03-22 Amphenol m8 s 03 pmmr sf8001 (#2116)
    * Create Amphenol_M8S-03PMMR-SF8001.kicad_mod
    * Update Amphenol_M8S-03PMMR-SF8001.kicad_mod
    * Fix F9.3 rotation and offset values
    * Update fp-lib-table
    * Fix courtyard and silkscreen
    * Fix pin 1 offset
    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
2020-03-22 Added Wuerth 614004134726 USB-A socket (#2160)
    * Added Wuerth 614004143726 USB-A socket
    * Added properties
    * Fix position and line width
    * Moved courtyard to correct grid
    * Changes requested
    * Shift pin 1 silk to be 0.2mm away from nearest pad
2020-03-22 Added TDFN-8-1EP_2x2mm_P0.5mm_EP0.8x1.38mm package for MAX17620 DC/DC regulator. (#2159)
2020-03-22 Create TE_5767171-1 (#2119)
    * Create TE_5767171-1_2x19_P0.635mm_Vertical.kicad_mod
    * Update TE_5767171-1_2x19_P0.635mm_Vertical.kicad_mod
    * Fix F5.1 and F5.2
    * Fix F6.2
    * Add datasheet url
    * Move silkscreen out of fab line
    * Fix courtyard to be same distance on both sides
    Remove pin 1 marker on fab layer
    * Center part as this is an smt component and the center is used for the plastic clip that the pick and place grabs on these kinds of connectors
    Shift part dimensions to match drawings. A few things were off by a handful of mm
    Shift courtyard to be 0.5mm from nearest features. It was too far away on the sides by a few tenths of a mm.
    Co-aut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
2020-03-22 Restore PLCC-32 THT socket footprint (#2104)
    * Restore PLCC-32 THT socket footprint
    This footprint was removed in https://github.com/KiCad/kicad-footprints/pull/675 along with some incorrect footprints. This footprint seems to be correct.
    * Fix courtyard size
    * Fix courtyard again
    * Add datasheet link to footprint description
2020-03-23 Revert "Added TDFN-8-1EP_2x2mm_P0.5mm_EP0.8x1.38mm package for MAX17620 DC/DC regulator. (#2159)" (#2165)
    This reverts commit c9c4aebdf0848993fb9e89a4c1c8a1e31fe89f42.
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2020-03-24 fixed THT -> SMD and NXE2 -> NXEx (#2068)
    * fixed THT -> SMD and NXE2 -> NXEx
    * adjusteded Keepout-Area, Origin, Pads orientation and Silkscreen
    * fixed pnp origin and silk to pad clearance
    * horiz. centered component
2020-03-28 Removed pad numbers from paste only pads in LED_SMD library (#2180)
    * Removed pad numbers from paste only pads
    * removed duplicate pads
2020-03-30 Connector PCB Edge: create Mini PCIe sockets (#1124)
    * Connector PCB Edge: create Mini PCIe cards and sockets
    * Connector PCB Edge: Mini PCIe socket only
    * Connector PCB Edge: Rename MiniPCIe to PCI Express Mini
    * Connector PCB Edge: update bus mini pcie, remove cards from the pull request
    * Connector PCB Edge: Fix mini pcie names
    * Connector PCB Edge: Update BUS PCI Express sockets
    * Connector PCB Edge: Update BUS PCI Express doc link
    * Connector PCB Edge: BUS PCI Express Update position of lines
    * Connector PCB Edge: BUS PCI Express, fix url and keep out zones
    * Connector PCB Edge: BUS PCI Express, fix CrtYd
    * Connector PCB Edge: BUS PCI Express, renamed
    *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
2020-04-07 Fix hole sizes in 2.54 mm headers. (#2178)
    * Fix hole sizes in 2.54 mm headers.
    The holes were previously 0.8 mm diameter, which is too small to
    accommodate a standard header. Normal header posts are 0.025" square
    (0.635 mm), and so the diagonal (approx. 0.898 mm) will not fit into
    a 0.8 mm hole. 1.0 mm is an appropriate size.
    * Fix hole sizes in 2.54 mm headers (for Arduino Nano footprints).
    The same modification made in the parent commit:
    The holes were previously 0.8 mm diameter, which is too small to
    accommodate a standard header. Normal header posts are 0.025" square
    (0.635 mm), and so the diagonal (approx. 0.898 mm) will not fit into
    a 0.8 mm hole.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
2020-04-21 Added footprint for CUI CMR-12062S-67 speaker Datasheet: https://www.cuidevices.com/product/resource/cmr-12062s-67.pdf 3D: https://github.com/KiCad/kicad-packages3D/pull/681
2020-04-21 Added modified HTSSOP footprint for EP size for MAX482x ICs (#2227)
    * Updated file with that generated by Python script
    * Swapped x and y dims on footprint (mistake on my part)
    * Updated following corrections to YAML
2020-04-21 Fix relays (#2166)
    * Fix a couple relay footprints
    - Correct one 30.22 fab line to horizontal
    - Make 30.22 fab layer bevel exactly 1mm
    - All fab lines now 0.1mm wide
    - 30.22 silk lines now 0.11mm from fab lines and pin 1 silk mark 0.25mm from other silk lines
    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
2020-04-21 Fix ublox_NEO footprint missing paste on VCC pad 23 (#2205)
    * Fix ublox_NEO footprint missing paste on VCC pad 23
    Resolves #2204
    * Modify silkscreen outline
    The existing silkscreen outlines for ublox NEO, LEA and MAX parts had variable clearances of, in some cases, just 0.01mm to copper pads - modified to give 0.2mm clearance as per KLC guidelines.
    Because [particularly on the MAX part] this makes pin 1 less clear, I have reduced the silkscreen around pin 1 to make it more readily identifiable. If there is a preferred approach e.g. additional silkscreen as per SOIC parts, I would be happy to modify accordingly.
    * Update ublox NEO, MAX and LEA to IPC-7351C style roundrect pads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
2020-04-24 add Fuseholder for Littelfuse Nano2 series 157x (#2238)
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2020-04-26 Add Texas NS/PS packages (#2245)
    https://www.ti.com/lit/ml/msop001a/msop001a.pdf
    https://www.ti.com/lit/ml/msop002a/msop002a.pdf
    Replaces existing `SO-8_5.3x6.2mm_P1.27mm` with scripted version and
    adds other variants of this (rather uncommon) package series.
2020-04-26 Fix Pin 1 Markers to fit with KLC (IPC suggestion) (#2244)
    Fixes https://github.com/pointhi/kicad-footprint-generator/issues/278 for DFN footprints
2020-04-26 Fix hole size for Molex KK-254 (#2246)
    This fixes https://github.com/pointhi/kicad-footprint-generator/issues/465
    We discovered that the hole size was wrongly rounded. This now uses the
    suggested size as given in the datasheet
2020-05-01 Added TDFN 10 Package with Exposed pad (#2248)
    * Added TDFN 10 Package with Exposed pad
    * Fixed 3D model name
    * Added files from footprint generator
    * Updated to match changes requested in Footprint Script PR
2020-05-01 Added WQFN-16-1EP_3x3mm_P0.5mm_EP1.6x1.6mm Datasheet: https://www.ti.com/lit/ds/symlink/tpa6132a2.pdf Generated using script: https://github.com/pointhi/kicad-footprint-generator/pull/526
2020-05-01 Mini-Circuits footprint HQ1157 (#2196)
    * initial version of HQ1157
    * rotate pi/2 CW
2020-05-01 Add Analog LFCSP-WD-8 (#2253)
    * Add footprint for analog LFCSP-WD-8
    * update footprint with new configuration
2020-05-02 Add Kemet Ex2 Series Mechanical Relays (#2230)
    * Begin THT double coil latching
    * Add EC2 series footprints
    * Add EE2 remaining footprints
    * god damnit
2020-05-02 Common mode choke Wuerth WE-SL5 (#2261)
    * Common mode choke Wuerth WE-SL5
    * Common mode choke Coilcraft 1812CAN: FIx silkscreen clearance
2020-05-03 Added bevel to corner of package on FAB layer. Bevel is 1mm. (1.414mm in diagonal length)
    Without this the orientation of the package is not apparent using only the FAB layer.
2020-05-03 Re-submit TDFN-8-1EP_2x2mm_P0.5mm_EP0.8x1.2mm package for MAX17620 (#2167)
    * Added TDFN-8-1EP_2x2mm_P0.5mm_EP0.8x1.38mm package for MAX17620 DC/DC regulator.
    * Recreated TDFN-8-1EP_2x2mm_P0.5mm_EP0.8x1.38mm package as requested by @chschlue in https://github.com/pointhi/kicad-footprint-generator/pull/514#pullrequestreview-379122835. Hereby changed package name to TDFN-8-1EP_2x2mm_P0.5mm_EP0.8x1.2mm as this is the true size the package drawing dictates.
    * Changed footprint according to request of @chschlue in https://github.com/pointhi/kicad-footprint-generator/pull/514#issuecomment-602768634 .
2020-05-03 Add 6.35mm and speakON Neutrik connectors (#1145)
    * Add 6.35mm and speakON connectors
    * Add Neutrik XLR connectors
    * Add NJx 6.35mm jacks
    * Push the last two XLR connectors
    Confirmed with Neutrik their dimensions/style
    * Fix copy/paste error on NC4FBV
    * Correct width of M series back end
    * Initial review fixes
    - NMJ4HCD2: link and description fixed
    - NRJ6HM-1-AU like NRJ6HM-1
    - Move NSJ12* pins S2 and SN2 to correct location
    - NSJ8*/NSJ12* nose diameter to 8.95mm
    * Change G pins on NSJ8/NSJ12 to 2.9mm pad
    * NRJ6HM-1: "SN" pin to "S"
    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
2020-05-05 Added WDFN-8-1EP_4x3mm_P0.65mm_EP2.4x1.8mm (script generated) (#2254)
    * Added WDFN-8-1EP_4x3mm_P0.65mm_EP2.4x1.8mm (script generated)
    Datasheet: https://www.onsemi.com/pub/Collateral/LC709203F-D.PDF
    3D: https://github.com/KiCad/kicad-packages3D/pull/688
    * Rerun script after parameters change (datasheet link and EP maximum)
2020-05-05 extend selection of DIN41612 connectors (#1076)
    * extend selection of DIN41612 connectors
    This selection was generated by an updated script using the
    kicad-footprint-generator. This current selection was built by checking
    the catalogs of ept, ERNI and Harting and collect the most standard
    series.
    Added in this commit were: B (was already present), C, D, E, F, Q, R
    Still missing standard series are:
    - H11, H15 (vertical and horizontal are different from each other and
    require an updated script, only H11 horizontal is present)
    - M (has a lot of variations which needs to be tracked).
    There are also many manufacturer specific variants which might follow
    (some are very easy t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
2020-05-08 Add DFN-6-1EP_2x2mm_P0.5mm_EP0.6x1.37mm (#2273)
    * Add DFN-6-1EP_2x2mm_P0.5mm_EP0.6x1.37mm
    * Regenerate DFN-6-1EP_2x2mm_P0.5mm_EP0.6x1.37mm
2020-05-08 Add HVQFN-24-1EP_4x4mm_P0.5mm_EP2.5x2.5mm (#2060)
    * Add VQFN-24-1EP_4x4mm_P0.5mm_EP2.5x2.5mm
    * Regenerate VQFN-24-1EP_4x4mm_P0.5mm_EP2.5x2.5mm footprints
    * Remove VQFN-24-1EP_4x4mm_p0.5mm_EP2.5x2.5mm footprints
    * Add regenerated HVQFN-24-1EP_4x4mm_P0.5mm_EP2.5x2.5mm
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2020-05-09 SD kyocera 145638109* fixed (#1933)
    * pin names mached with symbol: 12, 13
    * SD Kyocera 145638* footprints fixed:
    - rotated 180°
    - RefDes moved to visible area
    * SD_Kyocera_145638* CrtYd CI errors fixed.
    * clearances fixed.
    * SD_Kyocera_145638* SD card dimensions transfered to Dwgs.User layer.
    * fix Travis-CI error: CrtYd grid
    * SD_Kyocera_145638* anchor fit to pick&place point, pad orientation set to 0.
2020-05-09 Keystone 2479 Fix (#2057)
    * Fixed Keystone 2479
    This footprint was generated using:
    https://github.com/pointhi/kicad-footprint-generator/pull/490
    Notice that footprint in master didn't match with this generator...
2020-05-09 Add LFCSP-16 1.3x1.3mm EP (#2263)
    * Add LFCSP-16 1.3x1.3mm EP
    * update according to kicad-footprint-generator change
2020-05-09 Replace tht solder wire with scripted and add relieve version (#2062)
    * Replace tht solder wire with scripted and add relieve version
    * Fix spelling, fp name format and description
    - The correct spelling is strain relief
    - Remove trailing zeros
    - Use mm² in the description as it is quite safe and easier to read
    * Increase Drill Diameter for Large Wires
2020-05-09 Round Drills and Remove Pitch Singles for Solderwires (#2274)
2020-05-10 Connector JAE: Add Nano SIM Card SF72S006 (#2211)
    * Connector JAE: Add Nano SIM Card SF72S006
    * SF71S006: Fix positions of some pads
    * JAE SF72S006: Moved anchor
    * JAE SF72: Remove unwanted footprints
    * JAE SF72: Rework
    * JAE SF72: Fix CrtYd and Silkscren
2020-05-12 Fix Vishay-MBLS pin order (#1951)
    * Fix Vishay-MBLS pin order
    * Move reference to 0,0
2020-05-13 Added QFN-56 5.9x5.9EP (#2208)
    * Added QFN-56 5.9x5.9EP
    * Corrected footprint properties
    * Update PR2208 with ThermalVia and link to kicad-footprint-generator PR530
    * Added ThermalVias version of QFN56 5.9EP
    * Updated kicad-footprint-generator definition with nominal values.
2020-05-24 ESP32-S2-WROVER: Added keepout on DWGS layer for espressif recommende… (#2158)
    * ESP32-S2-WROVER: Added keepout on DWGS layer for espressif recommended clearance of 15mm. Removed tick lines. Move courtyard around clearance area.
    Figure 13 in https://www.espressif.com/sites/default/files/documentation/esp32_hardware_design_guidelines_en.pdf shows clearance drawing
    * Switch silk pin 1 indicator to look like the other ESP32 modules. Remove some of the 5 pin ticks that were left in. Shift fab pin 1 indicator under pin 1. Expand keepout to go under the antenna as that area is absolutely a keep out.
    * Make ESP32-S2-WROVER look more similar to other parts on fab and silk
2020-05-25 Increase courtyard clearance to 0.5mm
2020-06-02 Add Harwin S1941-46R spring contact (#2268)
    * Add Harwin S1941-46R spring contact
    * Fix line width on F.CrtYd
    * Fix fabrication layout
    * Fix courtyard clearance
    * Update description
    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
2020-06-21 Fix reversed pin numbering
    pointed out by @Ripae in #2157, with the fix suggested by @cp-aqulla.
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2020-08-02 Wuerth WP-THRBU REDCUBE THR connectors (#2287)
    * Connector: Add Wuerth WP-THRBU REDCUBE THR connectors
    * Rename and duplicate footprints for entire Wuerth WP-THRBU and WP-THRSH series
    * Move Wuerth REDCUBE THR footprints to TerminalBlock_Wuerth/
    * Add TerminalBlock_Wuerth to library table
    * Add TerminalBlock_Wuerth.pretty README
2020-08-03 Added footprint for OLED 128x64 (#1789)
    * Added footprint for OLED 128x64
    * Updated anchor position
    * Updated circle diameter and width
2020-08-04 Added D_DO-247-2_Vertical (#2355)
    * Fix travis
    * Delete Diode_Bridge_GeneSiC_Semiconductor_KBPC_T_Mountpoint.kicad_mod
    * Added D_DO-247-2_Vertical
    * Add silk mark, and horizontal packages
    * Delete D_DO-247-2_Vertical.kicad_mod
2020-08-05 Added IXYS GUFP footprint (#2328)
    * Added IXYS GUFP footprint
    * Added IXYS GUFP
    * Fixed line width
    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
2020-08-07 Fix HVSON-8-1EP_3x3mm_P0.65mm_EP1.6x2.4mm datasheet URL (#2384)
2020-08-16 Add mounting holes with a fastener pad on the top layer only (#2393)
    * Add mounting holes with a fastener pad on the top layer and a minimal annular ring on other layers
    * Fix F9.3 match part name to file name
    * Fix incorrect pad type
    * Add TopBottom variant with exposed copper pad on outer layers, but not inner
2020-08-18 TO-92: move F.Fab ref des under part body (#2396)
2020-08-20 Fix F.Fab line thickness of TSSOP-10_3x3mm_P0.5mm (#2400)
    It should be 0.1mm. It was 0.15mm.
2020-08-22 Oscillator_SMD_Kyocera_KC2520Z-4Pin_2.5x2.0mm (#2357)
2020-08-23 Oscillator_SMD_Kyocera_KC2520Z-4Pin_2.5x2.0mm fix silk layer (#2406)
    silk layer fix
2020-08-23 Oscillator_SMD_EuroQuartz_XO32-4Pin_3.2x2.5mm Silkscreen addition (#2405)
    * Silkscreen addition
    * Fix silk layer clearance
    * Rotation applied
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2020-08-23 Add quite longer SIP9 package (based on existing SIP-9_21.54x3mm_P2.54mm) (#2175)
2020-08-24 Create SOIC-14-16_3.9x9.9mm_P1.27mm.kicad_mod (#2298)
    * Create SOIC-14-16_3.9x9.9mm_P1.27mm.kicad_mod
    Added SOIC-14-16_3.9x9.9mm_P1.27mm.kicad_mod using the ipc_gullwing_generator script from the kicad-footprint-generator library.
    * Update SOIC-14-16_3.9x9.9mm_P1.27mm.kicad_mod
    Corrected component value to be SOIC-14-16_3.9x9.9mm_P1.27mm
    * Update SOIC-14-16_3.9x9.9mm_P1.27mm.kicad_mod
    Updated the description of the SOIC-14-16 footprint in properties
2020-08-25 Fix LED_D5.0mm-4_RGB_Staggered_Pins datasheet link (#2413)
    * LED_D5.0mm-4_RGB_Staggered_Pins
    fix datasheet and description
    * fix travis crtyrd
2020-08-25 Add DFN-8-1EP_2x2mm_P0.5mm_EP0.6x1.2mm used for the SGL0622Z (#2367)
    * Add DFN-8-1EP_2x2mm_P0.5mm_EP0.6x1.2mm used for the SGL0622Z
    * DFN-8-1EP_2x2mm_P0.5mm_EP0.6x1.2mm updates after generator script changes
2020-08-27 Bugfix: (#2425)
    wrong path for 3D model in file of "MagneticBuzzer_Kobitone_254-EMB84Q-RO"
    ${KISYS3DMOD} was used twice in path name
    On branch mountyrox_BugfixMagneticBuzzer
    Changes to be committed:
    modified: Buzzer_Beeper.pretty/MagneticBuzzer_Kobitone_254-EMB84Q-RO.kicad_mod
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2020-08-29 Added footprint for ADE7953 (#2382)
    * Added footprint for ADE7953
    * Fix file
    * Fix errors
    * Clean-up file
    * Fix widths
    * Generate footprint with right generator
    * Fix solder paste layer
    * Fix Paste
    * Last attempt at fixing Paste layer
    * Update footprint from generator
    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
2020-08-29 Create Diode_Bridge_Vishay_KBPM.kicad_mod (#2213)
    * Create Diode_Bridge_Vishay_KBPM.kicad_mod
    * Fab lines to 0.1mm width and courtyard on grid
2020-08-30 Add LEM_CKSR Series Current Transducer (#1958)
    * Create LEM_CKSR
2020-08-31 Add DFN-8 for Linear LTC2451 (#2312)
    * Add DFN-8 for Linear LTC2451 from https://github.com/pointhi/kicad-footprint-generator/pull/569
    * Update from kicad-footprint-generator at https://github.com/pointhi/kicad-footprint-generator/pull/569/commits/248113bbf4d2df123c0412ef3b5d76d55f4baeb1
2020-08-31 Add TSSOP-4_4.4x5.0mm_P4.0mm for Onsemi MDBxxS Bridge Rectifier (#2318)
2020-08-31 Added CUI CUI_CMC-4013-SMT SMD microphone (#2201)
    * Added CUI CUI_CMC-4013-SMT SMD microphone
    Datasheet: https://www.cuidevices.com/product/resource/cmc-4013-smt-tr.pdf
    * Removed paste from outer pad. It seems the microphone already has it.
    * Added description, tags and 3D path.
    * Added paste on pin 1
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2020-08-31 Bugfix: position of lower mounting hole must be shifted by 0.75 mm to the left. Did not correspond to the technical drawing of the device. (#2443)
    On branch mountyrox_BhEagle
    modified: Battery.pretty/BatteryHolder_Eagle_12BH611-GR.kicad_mod
    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
2020-08-31 added VFBGA-86 footprint for DA14691 and DA14695 MCU (#2188)
    * added VFBGA-86 footprint for DA14691 and DA14695 MCU
2020-09-01 Adds HSOP-8 package in 2.3x2.3mm EP variety (#2233)
    * Adds HSOP-8 package in 2.3x2.3mm EP variety
    * update footprints for update script
2020-09-08 added footprint Texas_B3QFN-14-1EP_5x5.5mm_P0.65mm (#2434)
    * added footprint Texas_B3QFN-14-1EP_5x5.5mm_P0.65mm
    Two types of footprint with and without thermal vias
    * Adjusted datasheet
2020-09-08 Add Senseair S8 CO2 sensor (#2308)
    Add Senseair S8 CO2 sensor
    * Upward facing mount
    * Downward facing mount
2020-09-09 Wrong links to datasheets corrected for Panasonic lithium batteries (#2453)
    * Wrong datasheet for Panasonic lithium batteries.
    Following files had wrong links to datasheet. Link was corrected.
    modified: Battery.pretty/Battery_Panasonic_CR1632-V1AN_Vertical_CircularHoles.kicad_mod
    modified: Battery.pretty/Battery_Panasonic_CR2032-VS1N_Vertical_CircularHoles.kicad_mod
    modified: Battery.pretty/Battery_Panasonic_CR2354-VCN_Vertical_CircularHoles.kicad_mod
    modified: Battery.pretty/Battery_Panasonic_CR2450-VAN_Vertical_CircularHoles.kicad_mod
    modified: Battery.pretty/Battery_Panasonic_CR2477-VCN_Vertical_CircularHoles.kicad_mod
    modified: Battery.pretty/Battery_Panasoni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
2020-09-09 WLCSP-16_1.409x1.409mm_P0.35mm (#2365)
    * Update WLCSP-16_1.409x1.409mm_P0.35mm with latest generated footprint
2020-09-09 Fix BGA-132 naming (#2448)
    changed pitch in filename
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2020-09-13 Added LQFN-48 package with 16 centered ground pins and thermal vias (#2350)
    * Added LQFN-48 package with 16 centered ground pins and thermal vias for NXP MKW41Z part to Package_DFN_QFN.
    * Incorporated suggested changes to package name. Also created a version with and one without thermal vias according to the design suggestions by NXP.
    * Renamed Package_DFN_QFN.pretty/NXP_VQFN-48-1EP_7x7mm_P0.5mm_EP3.5x3.5mm_16xMask0.45x0.45 package to Package_DFN_QFN.pretty/NXP_LQFN-48-1EP_7x7mm_P0.5mm_EP3.5x3.5mm_16xMask0.45x0.45 as it is referenced by LQFN name in symbols.
    * Removed 3D Model of NXP_LQFN-48 footprint.
    * Added path to 3D model for NXP_LQFN-48 footprints to allow adding 3D models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
2020-09-13 Fix pin numbering in 1.5mm pitch Pico-Lock connectors (504050 series) (#2466)
    The existing footprints have reversed pin ordering, so that pad 1 does
    not match that on the datasheet or indicated by the pin 1 indicator on
    the connector itself.
    The footprints are created with kicad-footprint-generator with
    ```
    smd_single_row_plus_mounting_pad.py conn_molex.yaml
    ```
    Footprints generated by this script must always have pin 1 on the
    left-most side, so in order to fix the numbering the connectors are
    rotated by 180 degrees.
    This update also fixes incorrect tags that specified "top entry" instead
    of "horizontal".
2020-09-13 Add WDFN-8-1EP_2x2mm_P0.5mm_EP0.8x1.2mm (#2457)
    * Add WDFN-8 from https://github.com/pointhi/kicad-footprint-generator/pull/612
2020-09-13 Add Buzzer_Beeper/Indicator_PUI_AI-1440-TWT-24V-2-R (#2264)
    * Add Buzzer_Beeper/Indicator_PUI_AI-1440-TWT-24V-2-R
    https://www.shoppui.com/documents/AI-1440-TWT-24V-2-R.pdf
    * Fix annular rings, rrect radius, doc
2020-09-14 QFN-24-1EP_4x4mm_P0.5mm_EP2.15x2.15mm (#2451)
    * add TSSOP-24-1EP
    * add QFN-24-1EP
    * add requested changes
    * Remove unnecessary params
    * remove conflicting file
2020-09-15 Added OnSemi custom WDFN6 footprint (#2447)
    * Added OnSemi custom WDFN6 footprint
2020-09-16 Create SSOP-48_5.3x12.8mm_P0.5mm.kicad_mod (#2462)
    Created and added SSOP-48_5.3x12.8mm_P0.5mm using kicad-footprint-generator
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2020-09-16 Added BGA-200 pitch 0.80x0.65 mm for LPDDR4/4X SDRAM. (#2437)
    * Added BGA-200 pitch 0.80x0.65 mm for LPDDR4/4X SDRAM.
    * Corrected the file name.
    Replaced by the footprint generated by kicad-footprint-generator. Chamfer is only corrected because F.SilkS partially overwrapped a BGA pad.
    * Removed the chamfer modification.
    * Replaced with the script-generated footprint. Nothing are changed.
2020-09-17 Package_DFN_QFN: Add UFQFPN-32 packages (#2458)
    Add UFQFPN-32 via https://github.com/pointhi/kicad-footprint-generator/pull/621
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2020-09-18 add RAK Wireless RAK4200 LoRa module footprint (#2356)
    * RAK4200 footprint add
    * rounded bevel line to nearest decimal, and centered footprint in y
    * silks closer to ffab, crtyrd upper and lower closer to ffab
2020-09-18 Sensor_Audio: Add LGA footprint for Knowles SPH0641LU4H-1 (#2438)
2020-09-18 Add HVSSOP-10 (#2460)
    * add HVSSOP-10,
    * generated from scripts, https://github.com/pointhi/kicad-footprint-generator/pull/614
2020-09-19 Add RAK Wireless RAK811 LoRa module footprint (#2323)
    * RAK Wireless RAK811 LoRa module footprint
    * silkscreen modified to KLC F5.1
    * fab layer clarified mountin 1 pin
    * datasheet link added to description
    * changed bevel line width
    * rounded bevel line to nearest fraction digit
    * silks closer to ffab (0.12 mm)
    * bevel line corrected to 45 degree
2020-09-19 Regenerate missed FPs / #422 (#2072)
    * Regenerate SO-20-1EP
    * Regenerate LFCSP
    * Regenerate OnSemi_VCT
    * Regenerate QFN-56, VQFN-46, VQFN-48
    * Revert "Regenerate SO-20-1EP"
    This reverts commit 0a803f7a9a0c12304b743942ee19f6d0a6a7a852.
    * Regenerate LFCSP-8-1EP_3x3mm_P0.5mm_EP1.74x1.45mm
2020-09-19 Replace TQFP-48_7x7mm_P0.5mm with scripted version (#2300)
2020-09-19 Change sot563 pad y dimension to 0.34mm to make sure the pad to pad clearance (#2475)
2020-09-21 Added VQFN-48-1EP_7x7mm_P0.5mm_EP4.1x4.1mm (#2189)
    Datasheet: http://www.ti.com/lit/ds/symlink/cc430f5137.pdf#page=128
    Generated by script, using: https://github.com/pointhi/kicad-footprint-generator/pull/519
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2020-09-22 add LFCSP-8-1EP_3x3mm_P0.5mm_EP1.6x2.34mm (#1876)
    * add LFCSP-8-1EP_3x3mm_P0.5mm_EP1.6x2.34mm
    * regenerate LFCSP-8-1EP_3x3mm_P0.5mm_EP1.6x2.34mm
2020-09-22 Quectel BC95 (#1943)
    * initial commit
    * Ending footprint
    * Fix pin 1 indication
    * Fix missing proper F.Paste
2020-09-22 add Heatsink Fischer FK24413DPAK (#1763)
    * add Heatsink_Fischer_FK24413DPAK_23x13mm
    a slightly compressed version of the already existing
    Heatsink_Fischer_FK24413D2PAK_26x13mm
    * FK24413DPAK: fix courtyard & silk + 3d name
2020-09-22 Add Fuseholder for littelfuse nano2 (#1926)
    * Add Fuseholder for nano2
    Fix space between pads
    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
2020-09-22 Te ms5525 dso (#1743)
    * Add TE_MS5525DSO-DBxxxyS Pressure Sensor
    * TE_MS5525DSO: Update document link
    * MS5525DSO: review 1st round
    Fix silk overlap
    Redo courtyard
    Move Port? designators to Cmts.User
    * MS5525DSO more courtyard fixes
    * TE_MS5525DSO-DBxxxyS: Add more description
    * MS5525DSO fix description
2020-09-22 Add BM78SPPS5XC2 bluetooth module footprint (#2378)
    * Add BM78SPPS5MC2NC2 bluetooth module footprint
    * bm78spps5xc2: Rename
    * bm78spps5xc2: add datasheet
    * bm78spps5xc2: fix pins location
    * bm78spps5xc2: fix F.Silk
    * bm78spps5xc2: fix F.CrtYd
    * bm78spps5xc2: fix top of F.CrtYd
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2020-09-23 Added TO-46-4 + ThermalShield for LM399 (#2481)
    * Changed LM399 3d model path and scaling
    * Updated description of the TO-46-4 thermally shielded package
    * Fixed missing fabrication layer reference designator
    * Renamed TO-46-4_ThermalShield.kicad_mod to Analog_TO-46-4_ThermalShield.kicad_mod
    Fixed missing circle on fabrication layer
    * Fixed incorrect footprint name
    * Updated 3d model filename
    * Updated footprint description with a link to its datasheet
2020-09-23 Add OnSemi QRE1113 and Everlight ITR1201SR10AR (#2482)
    * Add OnSemi CASE 100AQ, for the QRE1113 sensor
    This is the Through Hole footprint for the QRE1113
    Miniature Reflective Object Sensor, a reflective optocouple
    Reference:
    https://www.onsemi.com/pub/Collateral/QRE1113-D.PDF
    This footprint is required to fix issue 2623 on kicad-symbols
    https://github.com/KiCad/kicad-symbols/issues/2623
    * Add footprint for Everlight ITR1201SR10AR sensor
    This is the SMD footprint for the Everlight ITR1201SR10AR
    Miniature Reflective Object Sensor, a reflective optocouple
    Reference:
    https://www.everlight.com/file/ProductFile/ITR1201SR10AR-TR.pdf
    This footprint is required to fix issue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
2020-09-24 Add Oscillator_SMD_Fox_FT5H_5.0x3.2mm (#2293)
    * Add Oscillator_SMD_Fox_FT5H_5.0x3.2mm
    Datasheet: https://www.mouser.com/datasheet/2/160/T5HN_T5HV-1662393.pdf
    * Remove HandSoldering variant
    * Rotate to place pin 1 at upper-left
2020-09-24 Sumida c75 (#1772)
    * Add footprint for Inductor Sumida CR75
    * Fix orientation
    Fix REF position
    * Fix pad orientation
    Fix courtyard
    Add better description
    Zero X coordinates of REFs
    * Fix pad radius
    * Set F.SilkS offset to 0.11mm
    * Fix silkscreen spacing
2020-09-24 Add AC/DC converters Recom RAC20-xxSK and RAC20-xxDK (#2265)
    * Added the Recom RAC20-XXSK series footprint
    * Change text position and add path to 3D model
    * Fix KLC violation F5.1 and F5.2
    * Update footprints
    * Reduce description and update pads + drill
2020-09-24 EA DOGM128 and DOGL128 displays added (#2444)
    * EA DOGM128 and DOGL128 displays added
    * Updated displays as requested
    * Updated clearance between silkscreen and ffab
    * Added missing rectangle
2020-09-24 Rgb THT led URL fixes (#2422)
    * Fixed DS URLs
    * Update LED_D5.0mm-4_RGB.kicad_mod
    * Update LED_D5.0mm-4_RGB_Wide_Pins.kicad_mod
    * Change datasheet URL
    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
2020-09-25 Create Texas_RUK_S-PWQFN-N20_EP_3x3_Pitch0.4mm.kicad_mod (#2111)
    * Create Texas_RUK_S-PWQFN-N20_EP_3x3_Pitch0.4mm.kicad_mod
    * Update Texas_RUK_S-PWQFN-N20_EP_3x3_Pitch0.4mm.kicad_mod
    * Fix F5.2
    * Fix F7.5
    * Fix F9.1
    * Fix F9.3
    * Add footprints from footprint generator
    * Delete Texas_RUK_S-PWQFN-N20_EP_3x3_Pitch0.4mm.kicad_mod
2020-09-25 Added footprint for BelFuse SI-60062-F. (#1954)
    * Added footprint for BelFuse SI-60062-F.
    Datasheet: https://belfuse.com/resources/drawings/magneticsolutions/dr-mag-si-60062-f.pdf
    * Changed L3 to L4 and L4 to L2, so pin numbering is consistent, from left to right.
    * Changed R* pin names to T* pin names as requested in symbol's PR: https://github.com/KiCad/kicad-symbols/pull/2288
    * Make requested changes
2020-09-25 Added OnSemi_SIP-38-6EP-9x7mm_P0.65mm_EP0.95x0.95mm (#2186)
    * Added OnSemi_SIP-38-6EP-9x7mm_P0.65mm_EP0.95x0.95mm
    Datasheet: https://www.onsemi.com/pub/Collateral/AX-SIP-SFEU-D.PDF#page=19
    * Changed footprint type to SMD
    * Changed footprint type to SMD
    * Changed value to F.Fab
    * Renamed because EP in footprint is 1.2x1.2mm
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2020-09-25 Add WSON-8 Package with 1.45 x 2.4mm Pad (#2223)
    Added files for Texas WSON package with 1.45 x 2.4mm thermal pad
2020-09-26 Add Reverb Belton BTDR-1H/V (#1372)
    * Add Belton BTDR-1 footrpints
    Add Belton Reverb BTDR-1H and BTDR-1V footprints.
    http://www.belton.co.kr/inc/downfile.php?seq=17&file=pdf
    * remove
    * Add Reverb Belton BTDR-1
    Add Reverb Belton BTDR-1H and Belton BTDR-1V
    http://www.belton.co.kr/inc/downfile.php?seq=17&file=pdf
    * modification after error report
    mod error after Travis report
    * Update Reverb_BTDR-1H.kicad_mod
    * update keywords
    Update keywords
    * Add new Audio_Module library
    Add new Audio_Module library for Belton Reverb Module
    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
2020-09-26 Reverb_BTDR-1H/V: minor silkscreen improvement (#2493)
    Move Ref Des outside of body
2020-09-26 Add RB1-125B8G1A RJ45 jack (#1884)
    * Add RB1-125B8G1A
    * Add indication arrow for pin R1 on fab layer
    * Change silk->fab clearance to 0.2mm
    * Adjust courtyard around mounting holes
    * Move line from courtyard to fab
2020-09-26 Replace SOT-23 variants with scripted (#2410)
    * Added SOT-23-6 scripted
    * Added variations mo-178c
    * Manual changes SOT-23-5
    * Added SOT-23-5/6/8 with deleted pins scripted
    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
2020-09-26 Replace TSOT-23-5/6/8 with scripted (#2412)
    * Added TSOT-23-5/6/8
    * Added TSOT-23-5/6/8 with deleted pins scripted
    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
2020-09-28 Update murata naming to Murata (#1681)
    * Update murata naming to Murata
    fix
    - Converter_DCDC
    - Crystal
    - Inductor_THT
    * Update file names to 'Murata'.
    Initial commit did not include renaming
    of the file names directly. This is now fixed
    * Include changes suggested in PR at https://github.com/KiCad/kicad-footprints/pull/1681#issuecomment-694798043
    * Fix Resonator_SMD_Murata_SFECV-3Pin_6.9x2.9mm_HandSoldering
    * Fix Resonator_SMD_Murata_SFSKA-3Pin_7.9x3.8mm_HandSoldering
    * Fix Resonator_SMD_Murata_TPSKA-3Pin_7.9x3.8mm_HandSoldering
2020-09-28 Add QFN-12 footprint with 8 thermal vias (#1692)
    * Add QFN-12 footprint with 8 thermal vias
    From https://gitlab.com/librespacefoundation/lsf-kicad-lib
    * Add scripted footprint
    * Update scripted footprint
2020-09-28 Added UQFN-20_3x3mm_P0.4mm without exposed pad (#2185)
    * Added UQFN-20_3x3mm_P0.4mm without exposed pad
    Generated by script at: https://github.com/pointhi/kicad-footprint-generator/pull/518
    Datasheet: https://resurgentsemi.com/wp-content/uploads/2018/09/MPR121_rev5-Resurgent.pdf?d453f8&d453f8
    Similar package at: http://ww1.microchip.com/downloads/en/PackagingSpec/00000049BQ.pdf#page=561
    * Updated footprint after changes in source parameters.
    * Updated footprint after changing parameters in script.
2020-09-28 Add Panasonic AQ-H series solid state relays, SSO-8-N7 (#2212)
    * Add Panasonic AQ-H series solid state relays, SSO-8-N7
    Symbol here: https://github.com/KiCad/kicad-symbols/pull/2602
    Footprint generator script here: https://github.com/pointhi/kicad-footprint-generator/pull/527
    The generator script did not save the Nx naming convention for denoting
    specific missing pins, so I have manually renamed this file as generated
    from kicad-footprint-generator script.
    * Change fabrication layer name and packages-3d name
    * Modify dimension style per https://github.com/KiCad/kicad-footprints/pull/2212#issuecomment-693511642
    * Rename file per my comment in https://github.com/KiCad/kicad-f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
2020-09-28 CUI PD-30S connector. (#592)
    * CUI PD-30S connector.
    https://www.cui.com/product/resource/digikeypdf/pd-30s.pdf
    This is a shielded version of the PD-30 connector which is already in
    the library. The PD-30S can use the same schematic symbol as the
    PD-30.
    I've provided the PD-30S in versions with and without circular holes.
    * PD-30S: Update description and add line on fab layer.
    As discussed in the PR:
    * Added "DIN" to the description.
    * Added a line to the fab layer to distinguish the round part from the
    square part.
    * CUI_PD-30S: rename new shield pins to SH, as discussed in #592.
    * CUI_PD-30S: Surprise! The datasheet has changed.
    This PR was originally sub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
2020-09-28 Add Raytac MDBT50Q Module (#2390)
    * ADD Raytac MDBT50Q
    * [Raytac_MDBT50Q] Move anchor 1.75mm above
    * [Raytac_MDBT50Q] Indicate pin-1
    Add short line to F.SilkS layer to indicate pin-1.
    Add triangle sign to F.Fab layer to indicate pin-1.
2020-09-28 Add Adafruit_Feather footprints (#1657)
    * Add Adafruit_Feather footprints
    One version with mounting holes, one version without.
    * Rotate footprint
    This puts the USB connector up, as a sort of pin 1 marker and updates
    the pin numbering accordingly. This commit also makes some layout
    changes, I suspect I have used the nightly build for the original
    footprint, which I suspect uses more quotes.
    * Update documention URL
    I found a better source with more detailed info.
    * Add pin 1 marking
    * Fix silkscreen clearance
    * Fix silkscreen line width
    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
2020-09-29 Replace WSON-8_4x4mm_P0.8mm with generated one (#2500)
    Naming of the legacy footprint was wrong (missing the exposed pad).
    Also, it was not generated.
2020-09-29 Murata SFECF (#1523)
    * Adding Murata SFECF 10.7MHz filters
    * Updating based on travis output
    * Adjusting courtyard
    * Moving lines to fab layer
    * Adjusting fab layer line widths
    * Updating based on review, library reqs
    * Adjusting line widths
    * More changes from review
    * Fixing the gap between silk and pads
    * Trying to do what the code review says
    * Changing pin 1 marker, bringing refdes in
    * Doing the same for handsoldering version
    * switches, coaxial, package_so
    * rename Murata SFECF, adj silk (code review)
    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
2020-09-29 Package_SO: Rename SOIJ-8_5.3x5.3mm_P1.27mm to SOIC-8W_5.3x5.3mm_P1.27mm (#1446)
    The SOIJ-8 package name is only used by the package specification
    documents by Microchip. Other manufacturers usually just call it a
    variant of SOIC/SOP with 208mil (5.28mm) body. This package is currently
    modern among 25 SPI Flash chips from many manufacturers, including
    Winbond, GigaDevice, Micron, ST, etc.
    As the SOIJ-8 name is vendor specific, and will mislead people with the
    "J" as J lead, rename it to SOIC-8W, meaning a wider version of SOIC-8.
2020-09-29 Add footprint for Quectel L80 GPS module (#2228)
    * add footprint for Quectel L80 GPS module
    * Updates to Quectel L80 footprint based on review
2020-09-29 Added Diode_Bridge_Comchip_SCVB-L (#2383)
    * Added Diode_Bridge_Comchip_SCVB-L
    * Added Diode_Bridge_Comchip_SCVB-L
    fix travis violations
    * Added Diode_Bridge_Comchip_SCVB-L
    Add 45 deg fab and silk line
    * Delete Diode_Bridge_Comchip_SCVB-L.kicad_mod
    mistake correction
    * Added Diode_Bridge_Comchip_SCVB-L
    Add 45 deg fab and silk line
    * Added Diode_Bridge_Comchip_SCVB-L
    Fix countryard
    * Added Diode_Bridge_Comchip_SCVB-L
    Review fixes
    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
2020-09-30 Add Cromatek 0.56in 7-segment display footprint (#1758)
    * Add Cromatek 0.56in 7-segment display footprint
    * Add 3D model and fix description and tags for D168K
    * Fix issues brought by footprint review
    * Fix F5.3 and F7.2 rule violation
    * Fix footprint reference anchor
    * Fix alignment between pads and F.Fab layer
    * Fix offset from F.Fab to F.SilkS
    * Fix footprint size
    * Fix internal F.SilkS drawing
    * Rotate footprint by 90° relative to pin 1
2020-09-30 OnSemi_XDFN4-1EP_1.0x1.0mm_EP0.52x0.52mm.kicad_mod (#2363)
    * OnSemi_XDFN4-1EP_1.0x1.0mm_EP0.52x0.52mm.kicad_mod
    * OnSemi_XDFN4-1EP_1.0x1.0mm_EP0.52x0.52mm - Adjust silk screen and courtyard spacing from footprint review
2020-09-30 8devices Carambola2 footprint added (#1739)
    * 8devices Carambola2 footprint added
    * 8devices Carambola2 Completed
    * Carambola2 clearance update
    * Carambola2 Fab+Silk width update
    * Carambola2 Silk width update
    * outline update
    * outline update
    * Silk border update
    * Pad: F
    * Pad: F
    * Pad: F
    * Pad: G
    * Special paste pads: Done
    * delete numbers from the paste pads
    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
2020-09-30 WDFN-8-1EP_6x5mm_P1.27_EP4x3.4mm added. (#2018)
    * WDFN-8-1EP_6x5mm_P1.27_EP4x3.4mm added. See http://ww1.microchip.com/downloads/en/DeviceDoc/8L_WDFN_5x6mm_MF_C04210B.pdf
    * WDFN-8-1EP_5x6mm added with script
    * WDFN-8-1EP_5x6mm fixed in script
    * WDFN-8-1EP_5x6mm_P1.27mm: x-y -> y-x
    * WDFN-8-1EP_6x5mm_P1.27mm_EP3.4x4mm.kicad_mod fixed in script.
    WDFN-8-1EP_6x5mm_P1.27mm_EP3.4x4mm:
    device_type: 'WDFN'
    \#manufacturer: 'man'
    \#part_number: 'mpn'
    size_source: 'http://ww1.microchip.com/downloads/en/DeviceDoc/8L_TDFN_2x3_MNY_C04-0129E-MNY.pdf'
    ipc_class: 'qfn' # 'qfn_pull_back'
    \#ipc_density: 'least' #overwrite global value for this device.
    body_size_x:
    nomin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
2020-09-30 Added footprint for ERM19264 192x64 display module (#1781)
    * Added footprint for ERM19264 192x64 display module
    * Fixed mechanical hole properties
    * Rotated the footprint and increased the holes
    * Hole size fix
    * Update ERM19264.kicad_mod
2020-09-30 WLCSP-4-X1-WLB0909-4_0.890x0.890_P0.500mm (#2364)
    * WLCSP-4-X1-WLB0909-4_0.890x0.890_P0.500mm
    * WLCSP-4-X1-WLB0909-4_0.89x0.89mm_P0.5mm - Rename from old name and update from latest footprint generator
2020-09-30 LED SMD: Create Wurth 150141M173100 (#2488)
    * LED SMD: Create Wurth 150141M173100
    * LED 150141M173100: Fix pin position
    * LED 150141M173100: Fix silkscreen marker for pin 1
    * LED Wurth: Fix orientation
    * LED RGB: Rotate back
    * LED Wuerth: Rename
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2020-09-30 Connector_JST: add XA (horizontal + vertical) (#2169)
    Generated from scripts "conn_jst_XA_vertical.py" and
    "conn_jst_XA_horizontal.py".
2020-09-30 Fuseholder Keystone 3555-2 (#2491)
    * Add Fuseholder_Keystone_3555-2
    * Fix Courtyard clearance (sides)
2020-09-30 More feathers (#2507)
    * Fix mounting holes on Adafruit_Feather
    Turns out that the upper mounting holes are 2.5mm, not 2.54mm on all
    Feather boards. The bottom mounting holes are usually 2.54mm, but
    without copper, so use that. Some Feathers have copper on the botom
    mounting holes, or slightly smaller (2.2mm) holes, but that should
    probably still be ok.
    * Update documentation url for Adafruit_Feather_WithMountingHoles
    This was already updated for the version without mounting holes, but
    forgotten here.
    * Add variants of the Adafruit_Feather footprint
    This adds footprints for all Feather modules that use a slightly
    different footprint (extra pins or longer board).
    * Renu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
2020-09-30 Added Kionix_LGA-12_2x2mm_P0.5mm_LayoutBorder2x4y. (#2478)
    * Added Kionix_LGA-12_2x2mm_P0.5mm_LayoutBorder2x4y.
    Footprint for KXTJ3-1057 3-Axis Accelerometer.
    Symbol added here: https://github.com/KiCad/kicad-symbols/pull/621.
    Specifications:
    http://kionixfs.kionix.com/en/datasheet/KXTJ3-1057-Specifications-Rev-5.0.pdf
    http://kionixfs.kionix.com/en/document/TN008-PCB-Design-Guidelines-for-2x2-LGA-Sensors.pdf
    Generated with https://github.com/pointhi/kicad-footprint-generator.
    Source:
    Kionix_LGA-12_2x2x0.9mm_P0.35x0.375mm:⏎
    device_type: 'LGA'⏎
    size_source: 'http://kionixfs.kionix.com/en/document/TN008-PCB-Design-Guidelines-for-2x2-LGA-Sensors.pdf#page=4'⏎ librar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
2020-10-01 MP2303 Footprint, Generated by: IPC gullwing generator (#2502)
    * MP2303 Footprint, Generated by: IPC gullwing generator
    * MP2303 footprint updated
    * MP2303 old footprint removed
    * MP2303 footprint size update
2020-10-01 Added Sipeed M1 (#1590)
    * Added Sipeed M1
    * Rotated Sipeed_M1 footptints CCW
    * Updated Sipeed footprints and description
    * Fixed some pin position issues
    * Updated Sipeed_M1 name to Sipeed-M1
    * Updated name
    * Added spec sheet url to descr
    * Updated values
    * Updated fsilk
    * Added f.fab p1 indicator
    * Updated pin positions
    * updated corner
    * added F.Paste pads
    * Updated F.CrtYd spacing to 0.25mm
2020-10-01 Fix pad sizes of Taiyo Yuden NR series SMD inductors (#1792)
    Fixes https://github.com/KiCad/kicad-footprints/issues/1756 and
    simplifies the outline on the F.Fab layer.
2020-10-01 Add Buzzer_Murata_PKLCS1212Exxxx-R1 series (#1965)
    * Add Buzzer_Murata_PKLCS1212E series (#1965)
    Generic + footprint information (Page 4-5):
    https://www.murata.com/~/media/webrenewal/support/library/catalog/products/sound/p37e.ashx
    Product specific specs:
    http://www.murata.com/en-us/api/pdfdownloadapi?cate=&partno=PKLCS1212E4001-R1
    * Rename Buzzer_Murata_PKMCS0909E4000 to Buzzer_Murata_PKMCS0909E (#1965)
    Rename component series so that the name is more compliant with the KLC.
2020-10-01 Inductor_SMD: Add Vishay IFSC-1515AH Low Profile, High Current Inductors (#1749)
    * Inductor_SMD: Add IFSC-1515AH Low Profile, High Current Inductors
    * Enhance Fab layer
    * Fix Fab. thickness
    * Remove overlapping elements from Fab
    * Move the position of the value at Fab.
    * Apend body dimensions to footprint name
    * Change 3D model name
    * Move Silk
    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
2020-10-01 Chip molded footprint cleanup (#2495)
    * Remove 2816 footprints for L, D, Fuse, LED
    * Update L_1806 footprints
    * Remove castellated footprints. This was a script error and they should never have been created
